NathanHor22/Quipus/output/pcb/Quipus-A1/controller-design.md

# Quipus Rev A — controller, controls, timekeeping, storage and display

Revision A1, 29 September 2026. Engineering review draft, not a fabrication release. The accompanying `controller-circuit.json` is a pin-to-net design specification; it is not an EasyEDA project or a routed PCB. No firmware is changed by this work.

## Decisions

- U1 is **ESP32-S3-WROOM-1-N16R8**, with 16 MB quad flash and 8 MB octal PSRAM. Use this exact ordering code; substitutes need a fresh pin and voltage review.
- Two onboard PDM microphones use I2S0; external PDM input has a separate data line. I2S1 drives the speaker amplifier. Audio front end is defined separately.
- A **Waveshare SKU 15867 1.3inch LCD Module**, 240 × 240 ST7789, is mounted above the controller board and connected through a keyed cable. This is a 45 × 31 mm display-module PCB, not a bare display bonded onto the custom PCB. It is non-touch; LVGL handles the UI in firmware.
- Native 1-bit SDMMC and a Hirose DM3AT-SF-PEJM5 socket provide recording storage. The display uses **SPI2_HOST**; SPI1 is reserved for flash/cache and must not be assigned to the screen.
- Start/Enter connects directly to RTC-capable GPIO7 for standby wake. Stop/Back, Up and Down use a PCA9536 I2C expander. Power, BOOT and RESET remain independent hardware functions.
- RV-3028-C7 keeps calendar time while main system power is off, as long as the protected LiPo remains attached and usable. A separate backup cell is not included.

## Verified ESP32 module pin allocation

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

| Function / net | GPIO | Module pad | Direction / reset consideration |
| --- | ---: | ---: | --- |
| PDM_CLK | 4 | 4 | Clock output; audio sheet owns source damping |
| PDM_DIN0 | 5 | 5 | Two onboard microphones, complementary PDM clock edges |
| PDM_DIN1 | 6 | 6 | External short-wire PDM daughterboard input |
| I2S1_BCLK | 14 | 22 | Speaker bit clock |
| I2S1_WS | 15 | 8 | Speaker frame clock |
| I2S1_DOUT | 16 | 9 | Speaker audio output |
| AMP_ENABLE | 17 | 10 | Audio sheet must hold amplifier disabled at reset |
| LCD_CS_N | 10 | 18 | 10 kΩ pull-up; deselect display during boot |
| LCD_MOSI_MCU | 11 | 19 | Through 33 Ω to LCD_MOSI |
| LCD_SCLK_MCU | 12 | 20 | Through 33 Ω to LCD_SCLK |
| LCD_BL | 13 | 21 | Backlight control only; module has its own transistor |
| LCD_DC | 43 | 37 | Also ROM UART0 TX; safe only because CS is pulled high |
| LCD_RST_N | 44 | 36 | 10 kΩ pull-up; firmware performs reset pulse |
| SD_CLK_MCU | 38 | 31 | Through 22 Ω to card CLK |
| SD_CMD | 39 | 32 | Bidirectional, 10 kΩ pull-up |
| SD_D0 | 40 | 33 | Bidirectional, 10 kΩ pull-up |
| SD_CD_N | 41 | 34 | Detect switch to ground; 100 kΩ pull-up |
| I2C_SDA | 8 | 12 | Fuel gauge, RTC and button expander; pull-ups on power sheet |
| I2C_SCL | 9 | 17 | Start at 100 kHz; validate bus rise time |
| PWR_INT_N | 18 | 11 | LTC2951 shutdown request input |
| POWER_HOLD | 21 | 23 | Open-drain; LOW only after file flush; pull-up on power sheet |
| CHARGING_N | 47 | 24 | Charger open-drain status; pull-up on power sheet |
| USB_PGOOD_N | 48 | 25 | Charger input-valid status; not itself charging current |
| USB_ENUM_500 | 1 | 39 | Active-high authorization after USB enumeration; default low |
| USB_SUSPEND | 2 | 38 | Active-high suspend signal; default low, per power design |
| ESP_USB_DM | 19 | 13 | Native USB D− after isolation and series resistor |
| ESP_USB_DP | 20 | 14 | Native USB D+ after isolation and series resistor |
| BOOT_N | 0 | 27 | 10 kΩ pull-up, service switch to ground |
| ESP_EN | EN | 3 | 10 kΩ / 1 µF RC, service RESET switch to ground |
| BTN_START_N | 7 | 7 | Direct active-low Start/Enter and RTC-domain wake input |
| Spare, unconnected | 42 | 35 | Reserved for prototype changes |

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

Budget: 36 exposed GPIO − 3 PSRAM-reserved − 4 straps − 2 native USB = 27 available general GPIO. This design uses 26 and retains GPIO42. UART0 pads are occupied by the display; use native USB Serial/JTAG for ordinary service. Optional UART probing on LCD_DC is read-only, and the screen must remain deselected. Do not claim a separate unrestricted UART header.

## USB and reset

USB connector D+/D− nets enter a TPD2EUSB30DRTR clamp array immediately beside the connector, then TS3USB221ARSER, then 22 Ω series resistors close to the ESP32. Keep the pair short over continuous ground with differential impedance designed using the fabricator's stackup. DNP shunt-capacitor pads are for measured tuning only.

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

## Display connector: a reversal that matters

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

## SD socket

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

## Offline timekeeping

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

## Buttons and shared I2C

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

The bus addresses are distinct: RTC 0x52, expander 0x41, fuel gauge 0x55. The power sheet owns one pair of 10 kΩ bus pull-ups to 3V3 plus off-state discharge resistors; do not populate a duplicate set here. Begin at 100 kHz and measure SCL/SDA rise time with the actual total capacitance. Do not enable 400 kHz simply because all chips list it as a maximum.

## Outstanding before fabrication

1. Cross-check every symbol and footprint against the exact package drawing, particularly module pad 41, USB switch RSE, microSD detector A/B and display J2 orientation.
2. Complete whole-board electrical rules and power-domain review, including powered-off I2C/USB behavior and discharge timing.
3. Reconcile the display's measured current, real SD write peaks and Wi-Fi current with the regulator's peak and thermal margins.
4. Confirm mechanical button heights, screen connector cable bend, SD ejection path, microphone acoustic openings and ESP antenna keepout.
5. Run a first-article test: native USB boot, all buttons, RTC continuity through power-off, microSD recoverability, full audio capture, Wi-Fi upload, charging and safe shutdown.

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

## Primary references

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
