NathanHor22/Quipus/output/pcb/Quipus-A1-EasyEDA/native-review/pcb-bottom-final.png

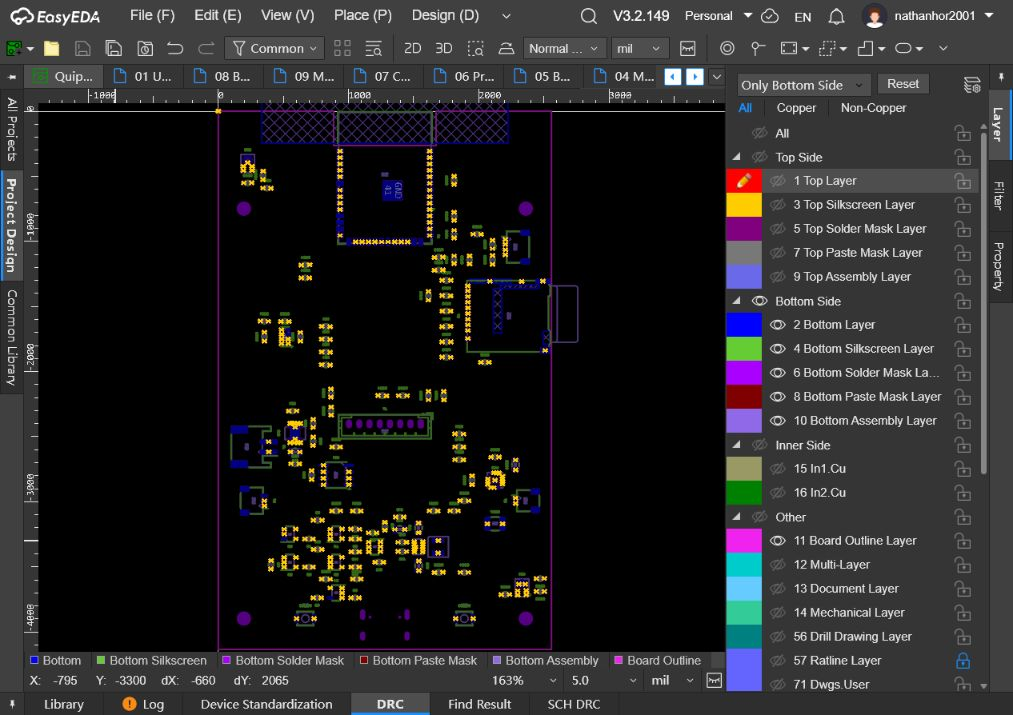
output/pcb/Quipus-A1-EasyEDA/native-review/pcb-bottom-final.png
