NathanHor22/Quipus/output/pcb/Quipus-A1-EasyEDA/placement-preview.png

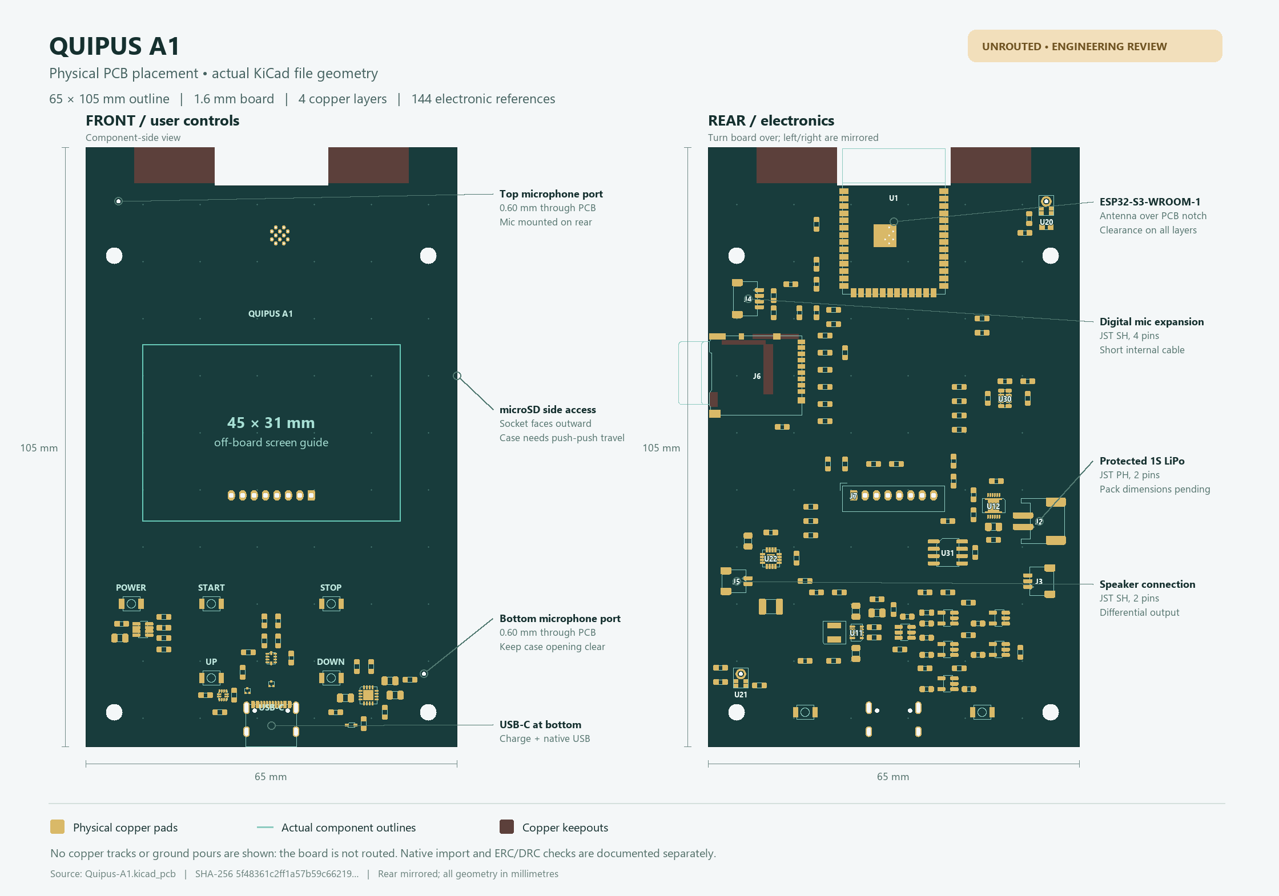
output/pcb/Quipus-A1-EasyEDA/placement-preview.png
