NathanHor22/Quipus/output/pcb/Quipus-A1/contact-sheet.png

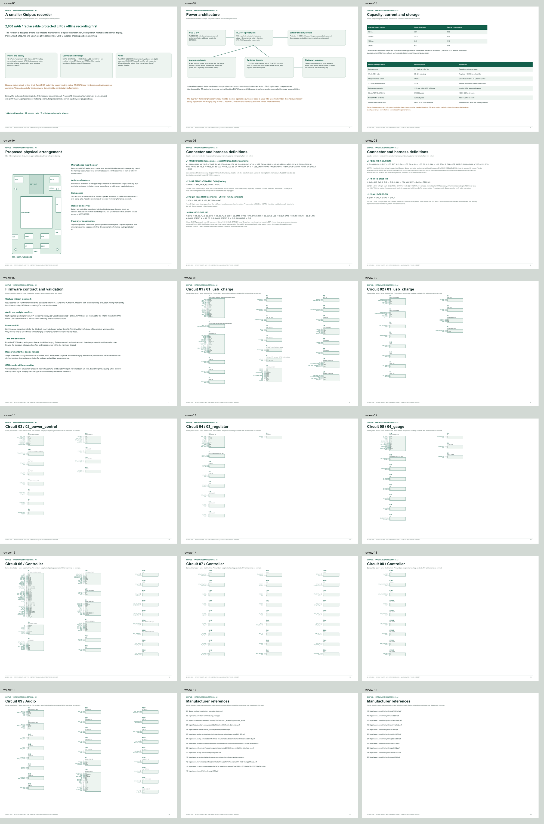
output/pcb/Quipus-A1/contact-sheet.png
