NathanHor22/Quipus/output/pcb/Quipus-A1/review-01.png

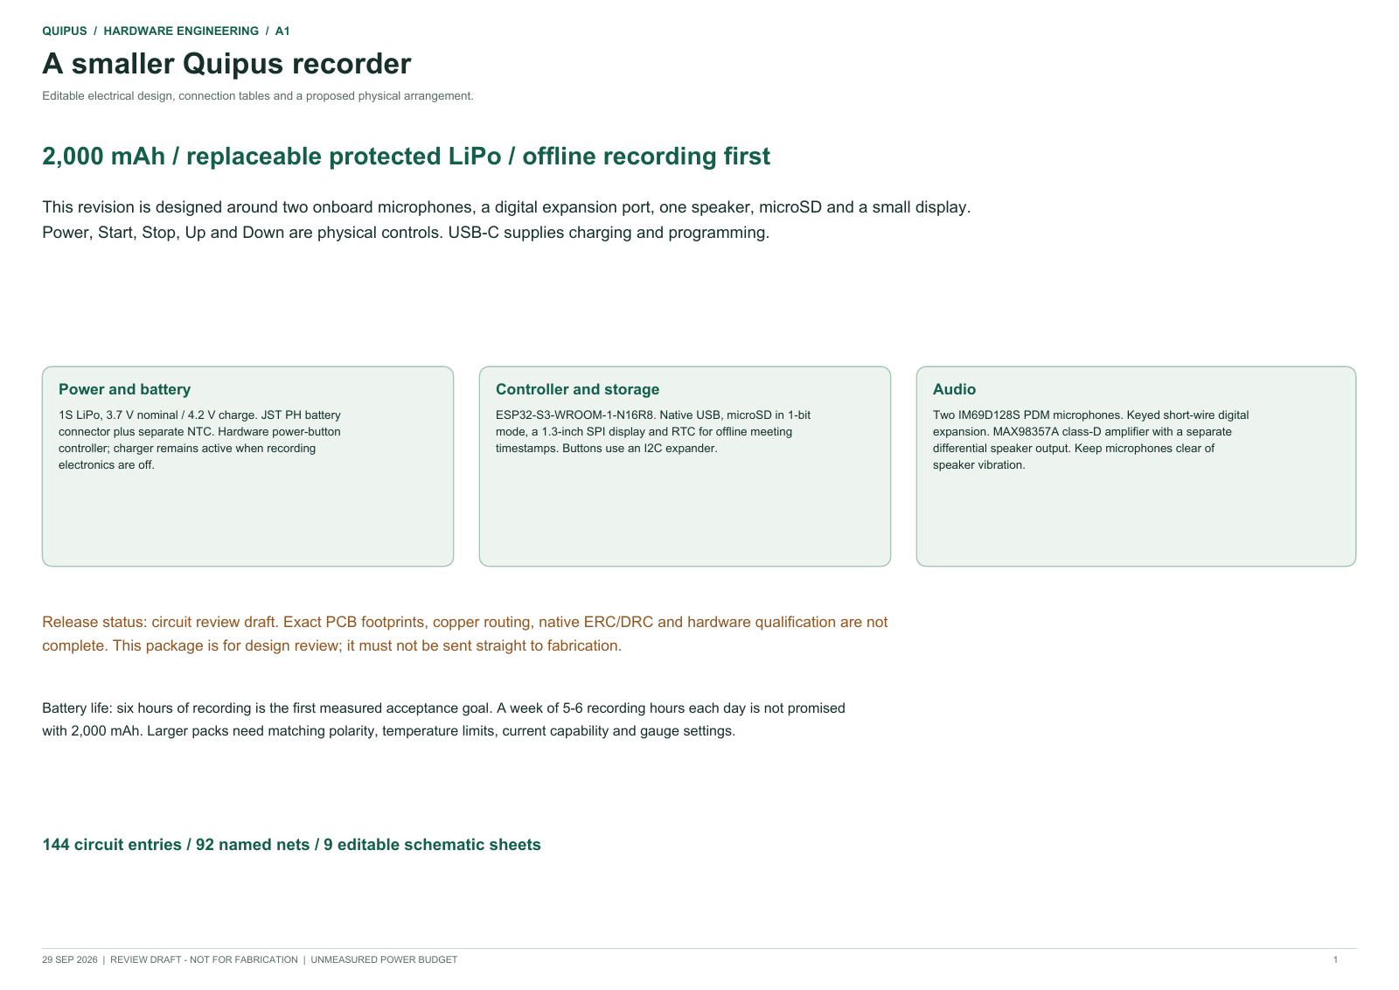
output/pcb/Quipus-A1/review-01.png
