NathanHor22/Quipus/output/pcb/Quipus-A1/review-02.png

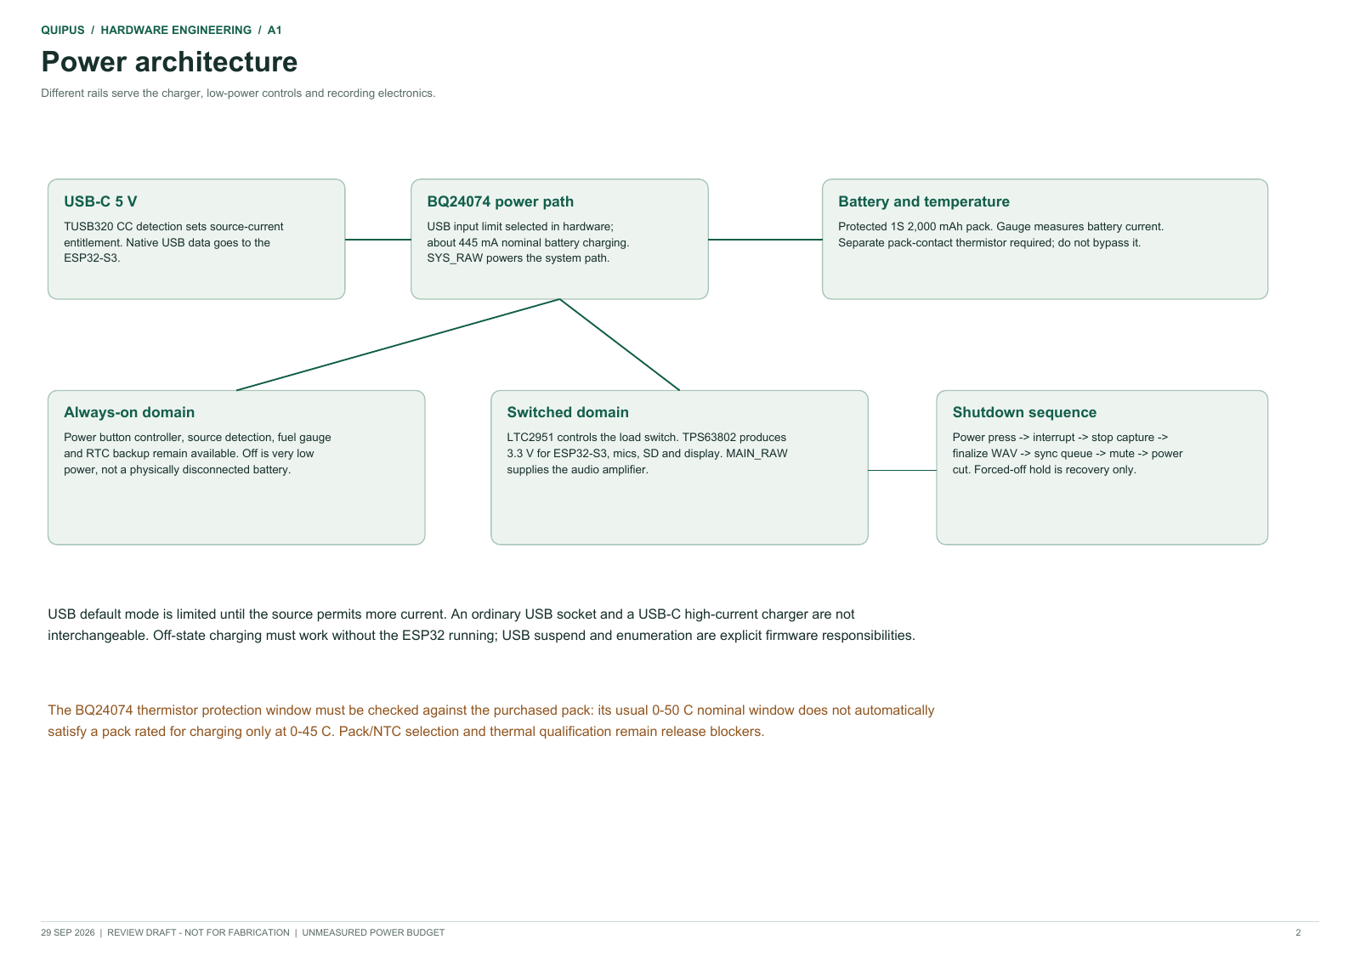
output/pcb/Quipus-A1/review-02.png
