NathanHor22/Quipus/output/pcb/Quipus-A1/review-03.png

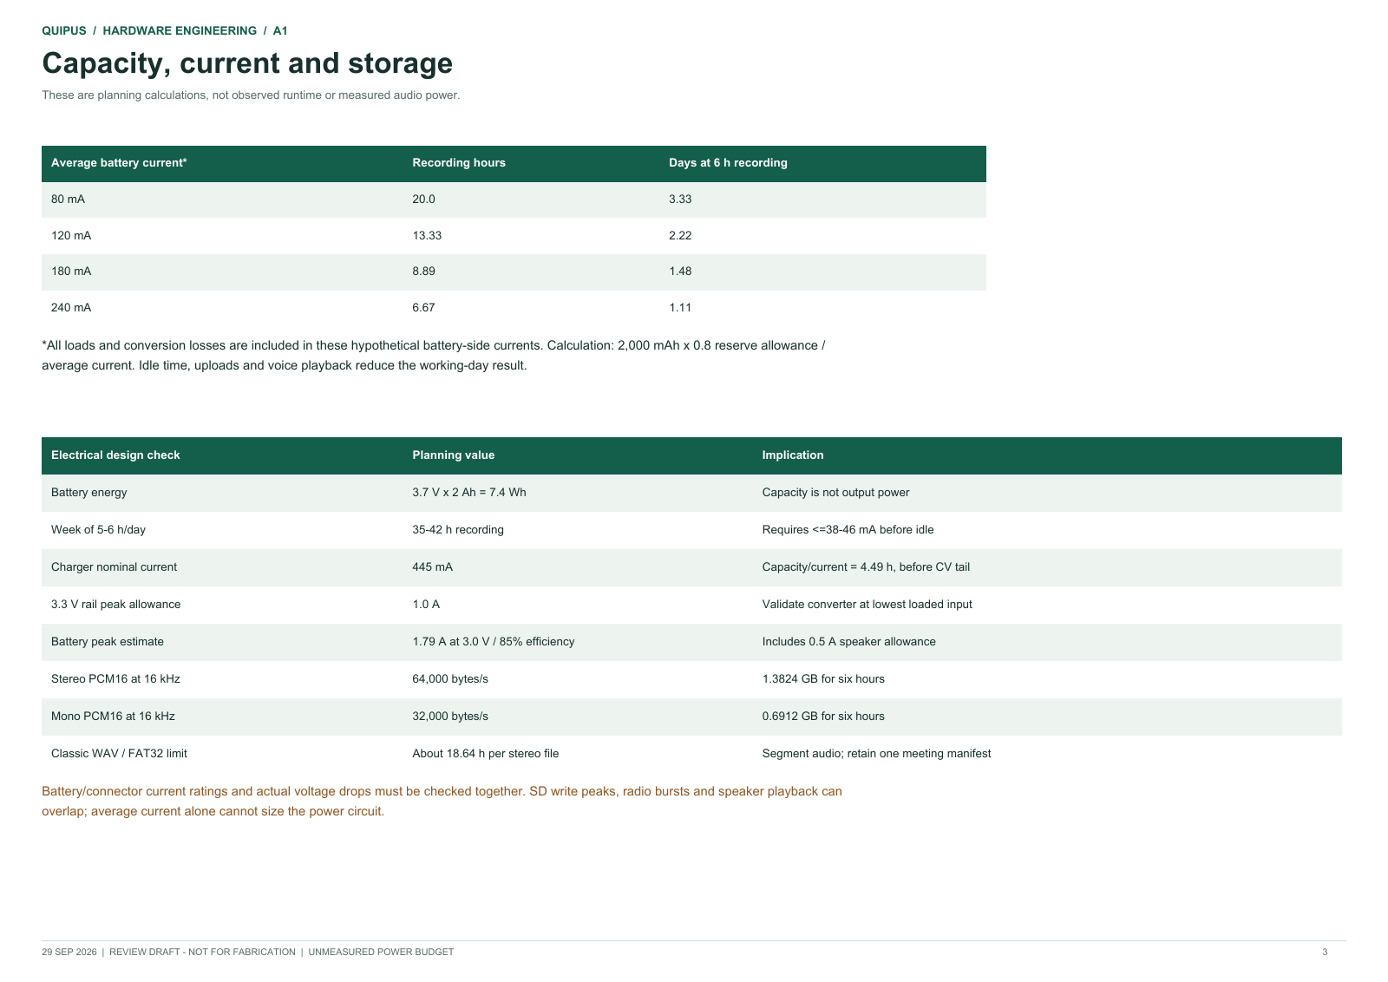
output/pcb/Quipus-A1/review-03.png
