NathanHor22/Quipus/output/pcb/Quipus-A1/review-04.png

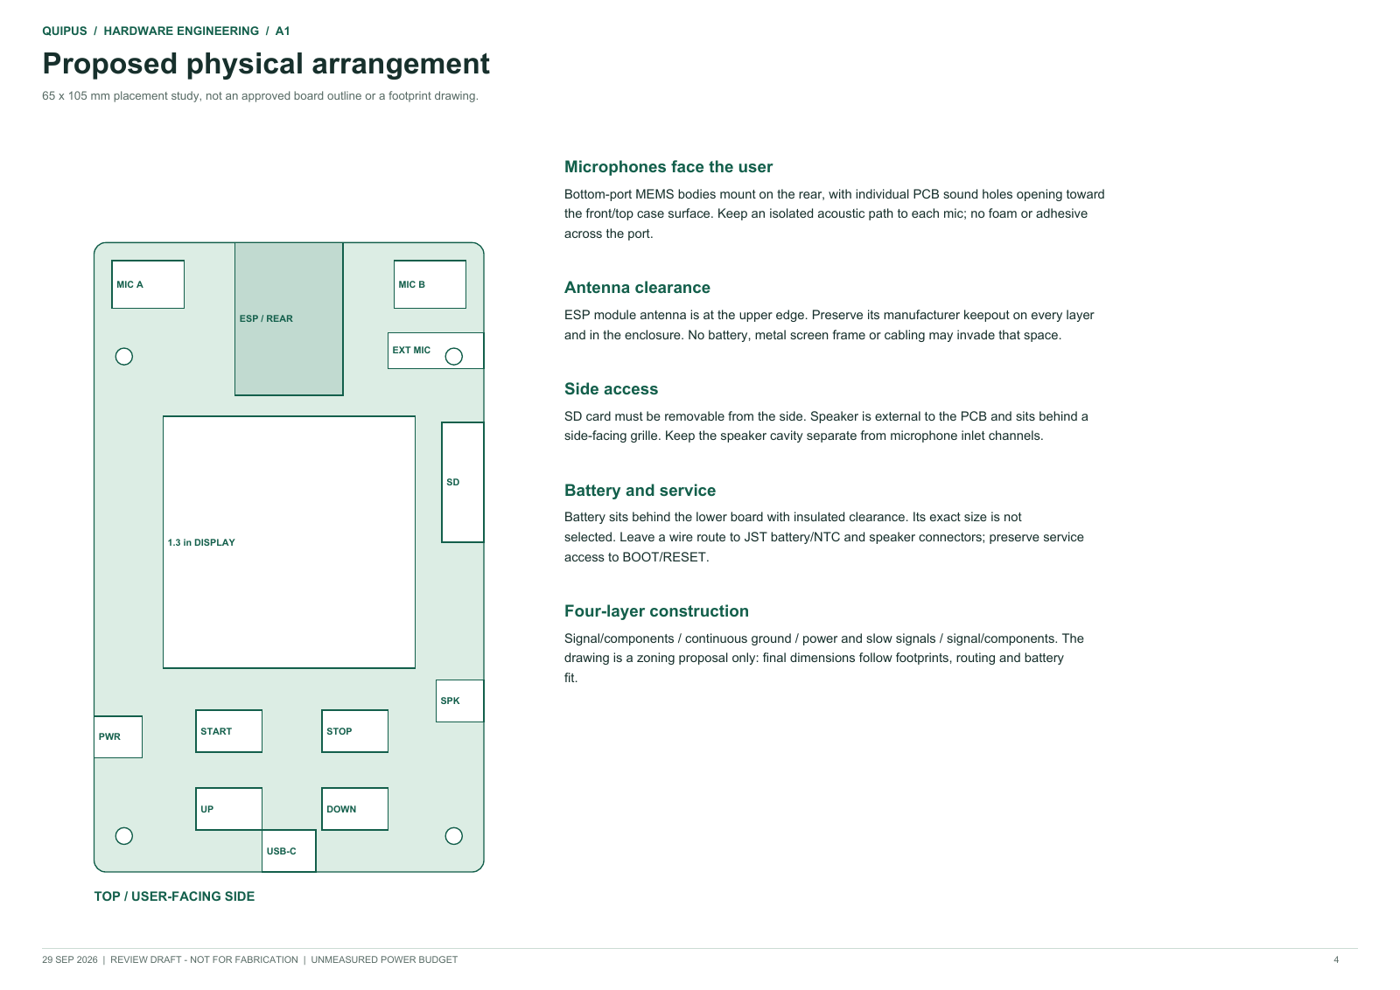
output/pcb/Quipus-A1/review-04.png
