NathanHor22/Quipus/output/pcb/Quipus-A1/review-05.png

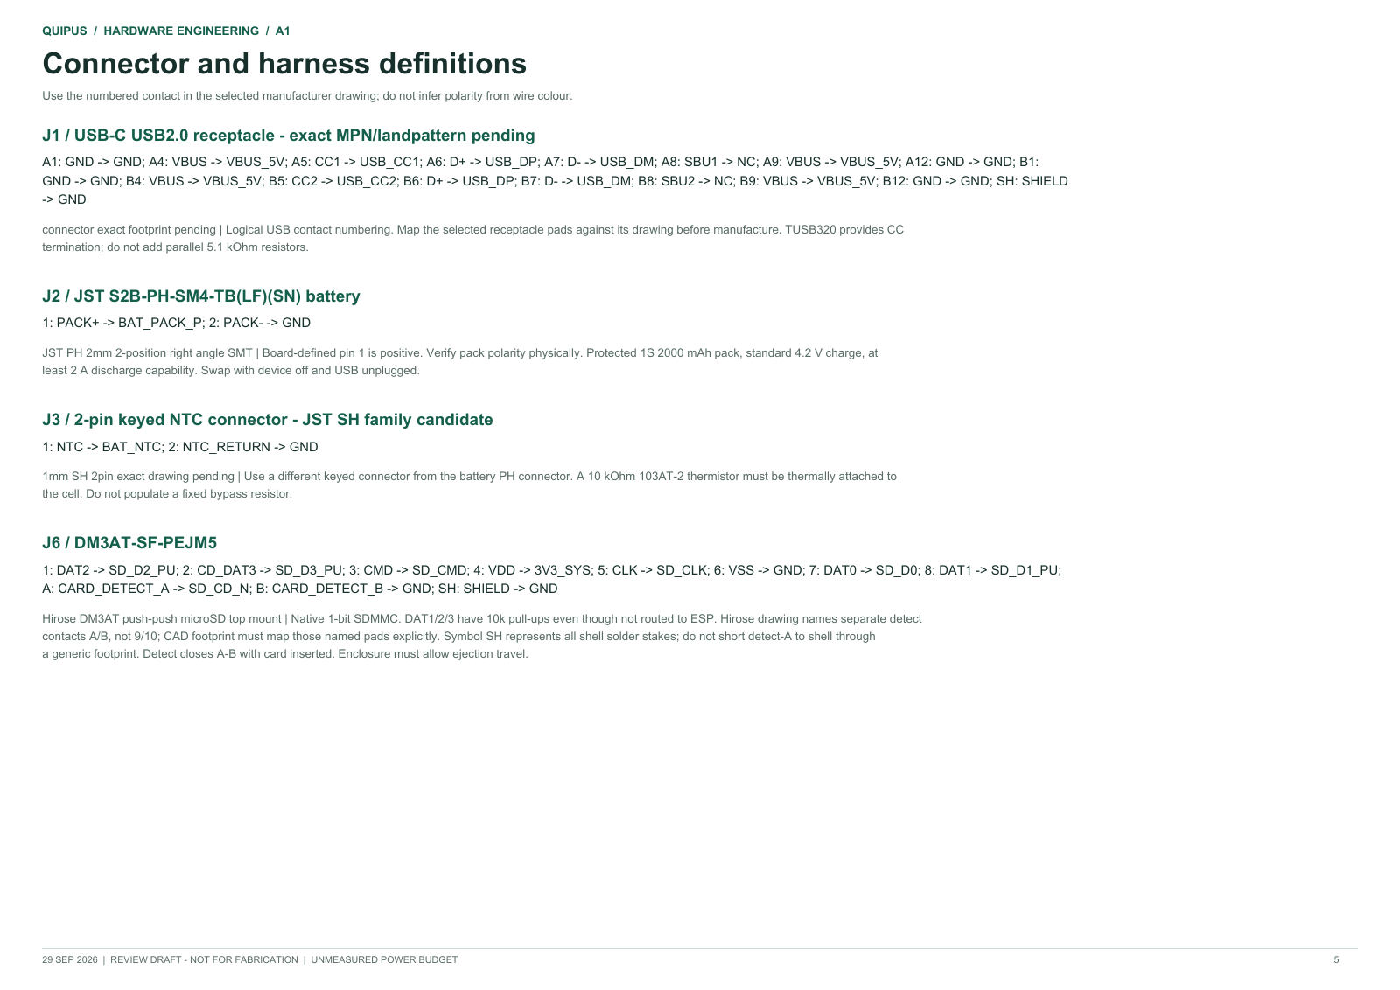
output/pcb/Quipus-A1/review-05.png
