NathanHor22/Quipus/output/pcb/Quipus-A1/review-06.png

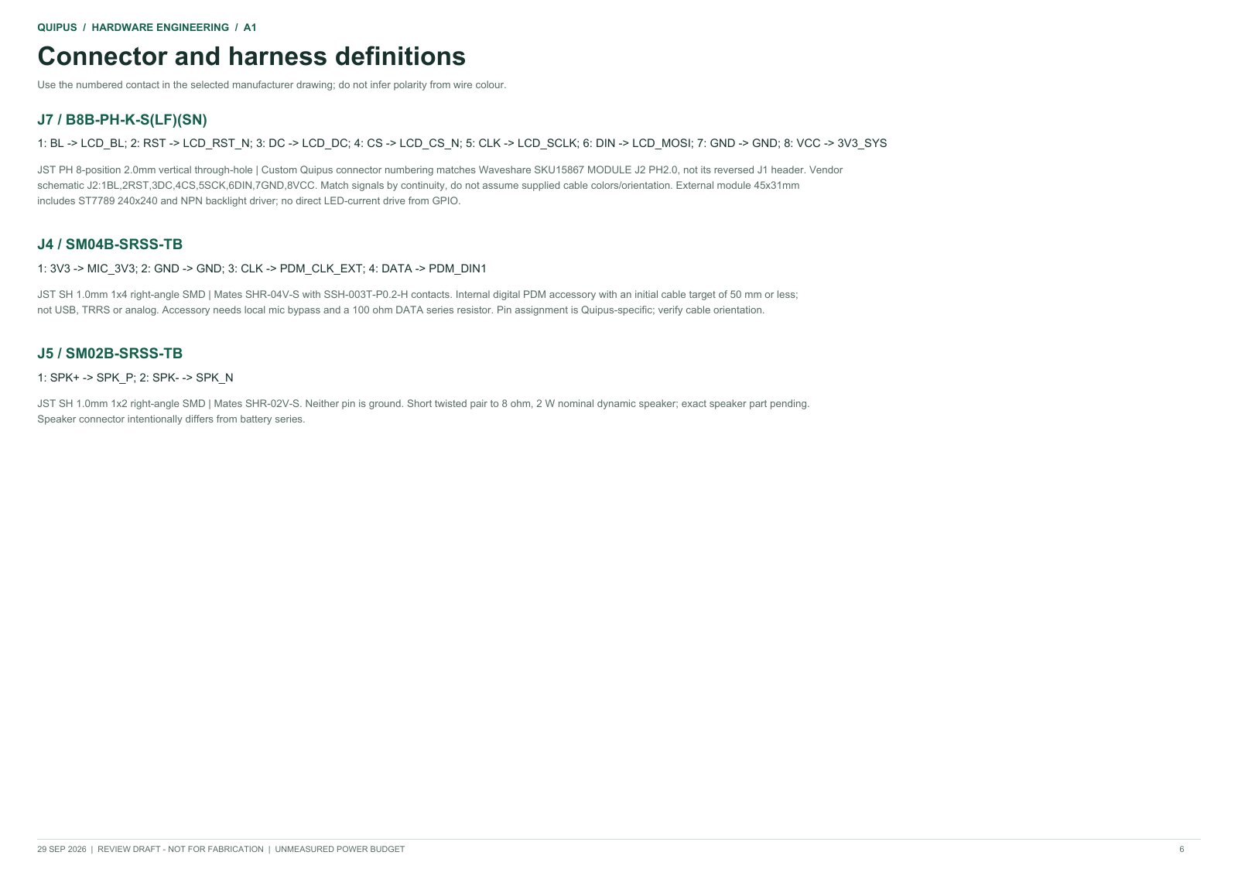
output/pcb/Quipus-A1/review-06.png
