NathanHor22/Quipus/output/pcb/Quipus-A1/review-07.png

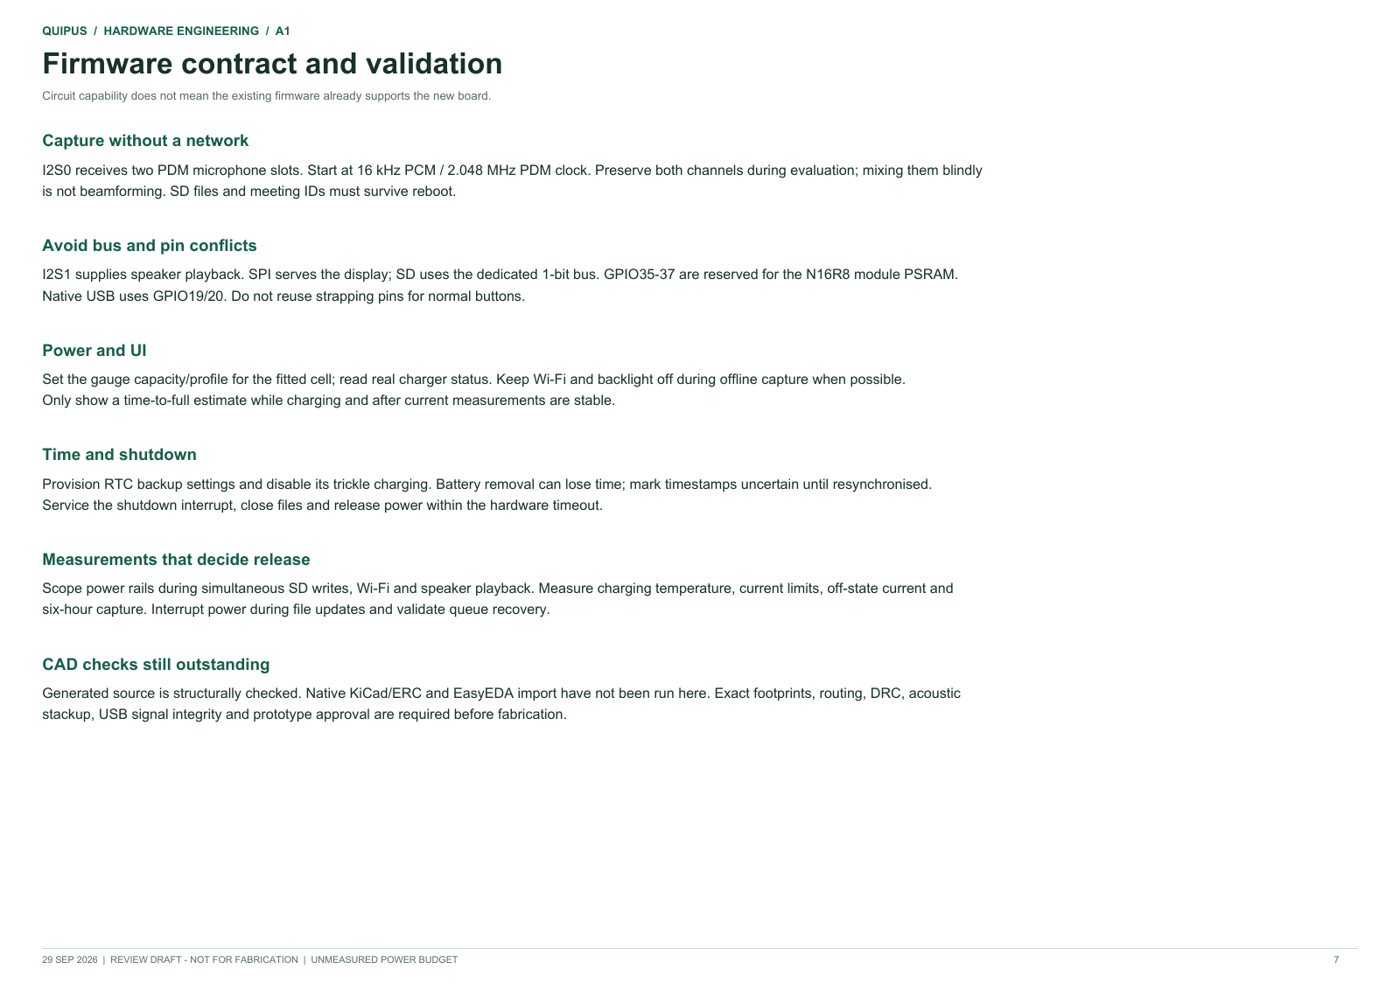
output/pcb/Quipus-A1/review-07.png
