NathanHor22/Quipus/output/pcb/Quipus-A1/review-08.png

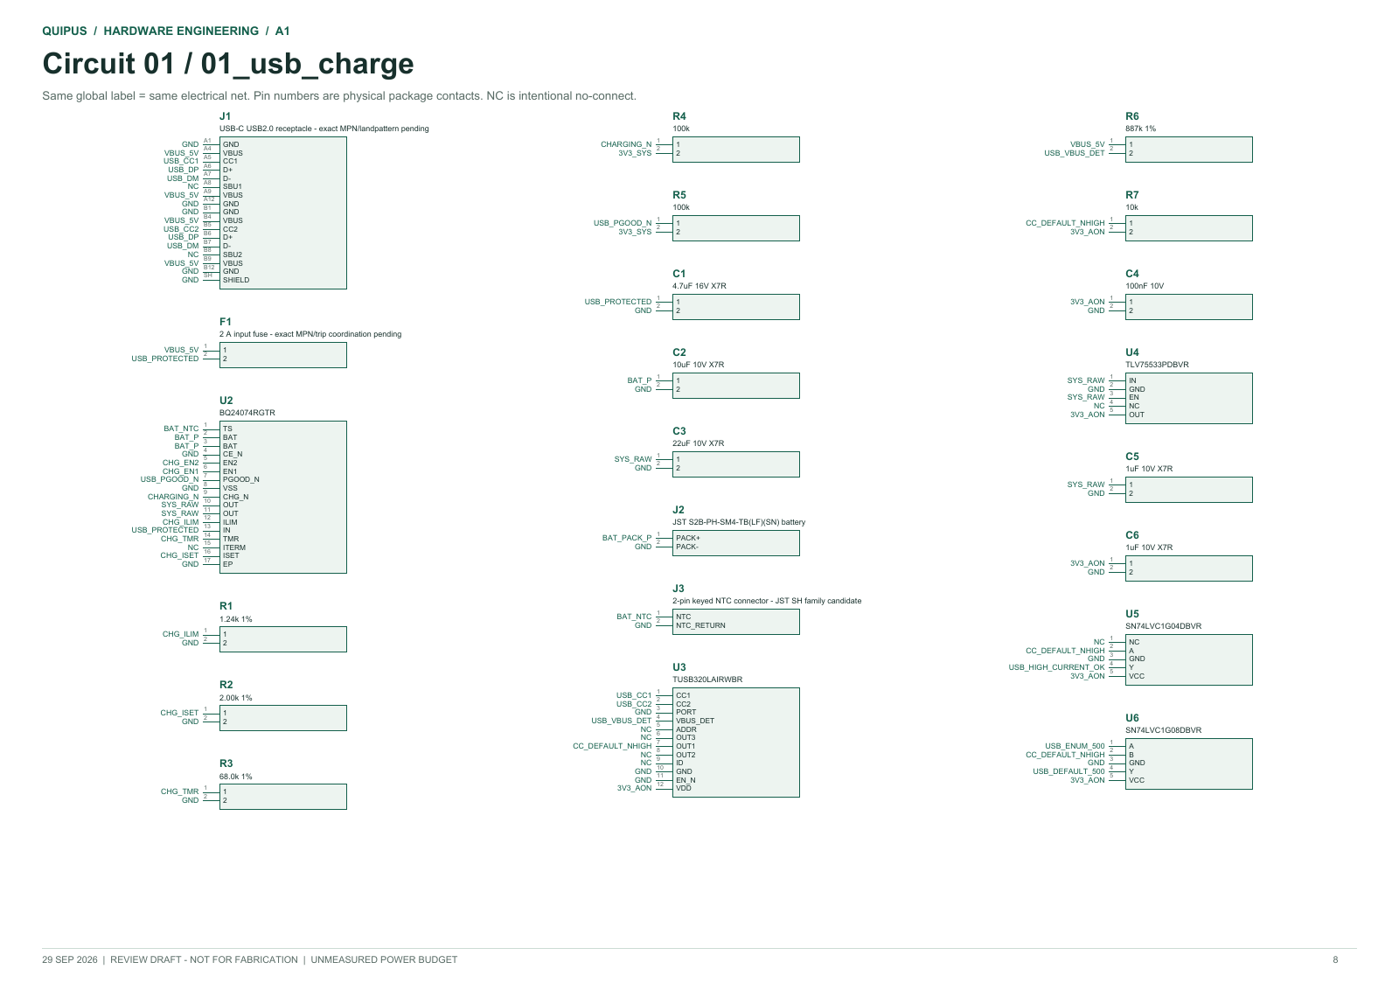
output/pcb/Quipus-A1/review-08.png
