NathanHor22/Quipus/output/pcb/Quipus-A1/review-09.png

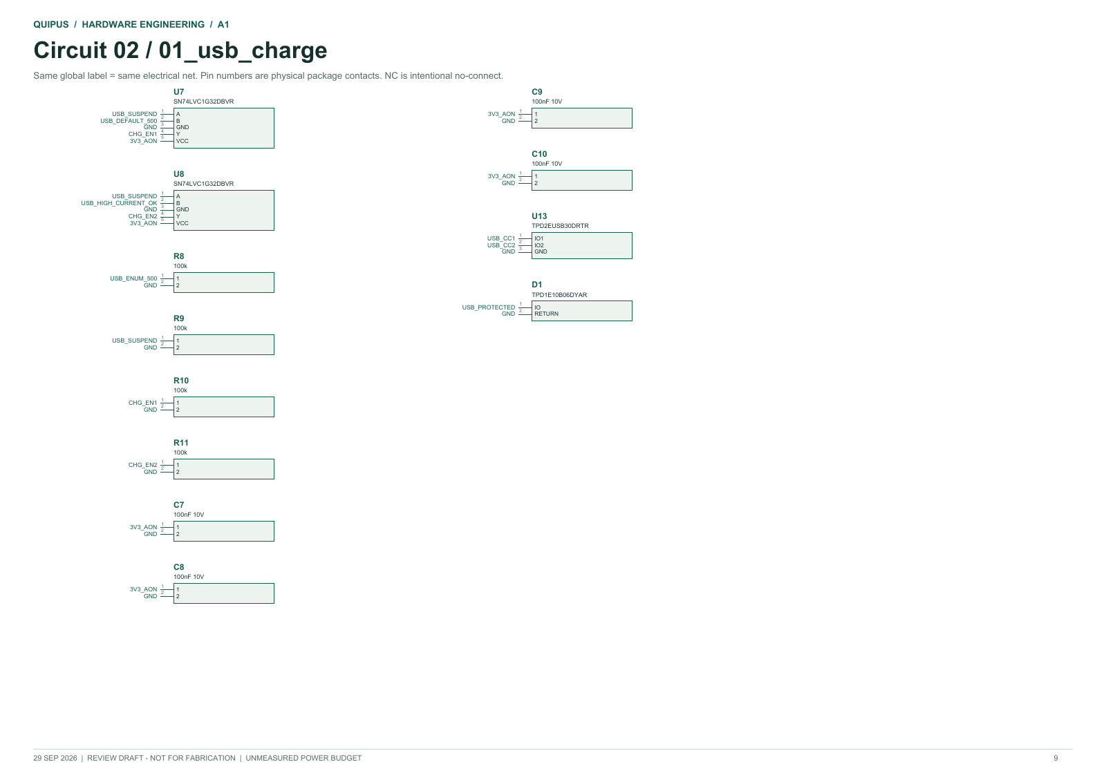
output/pcb/Quipus-A1/review-09.png
