NathanHor22/Quipus/output/pcb/Quipus-A1/review-11.png

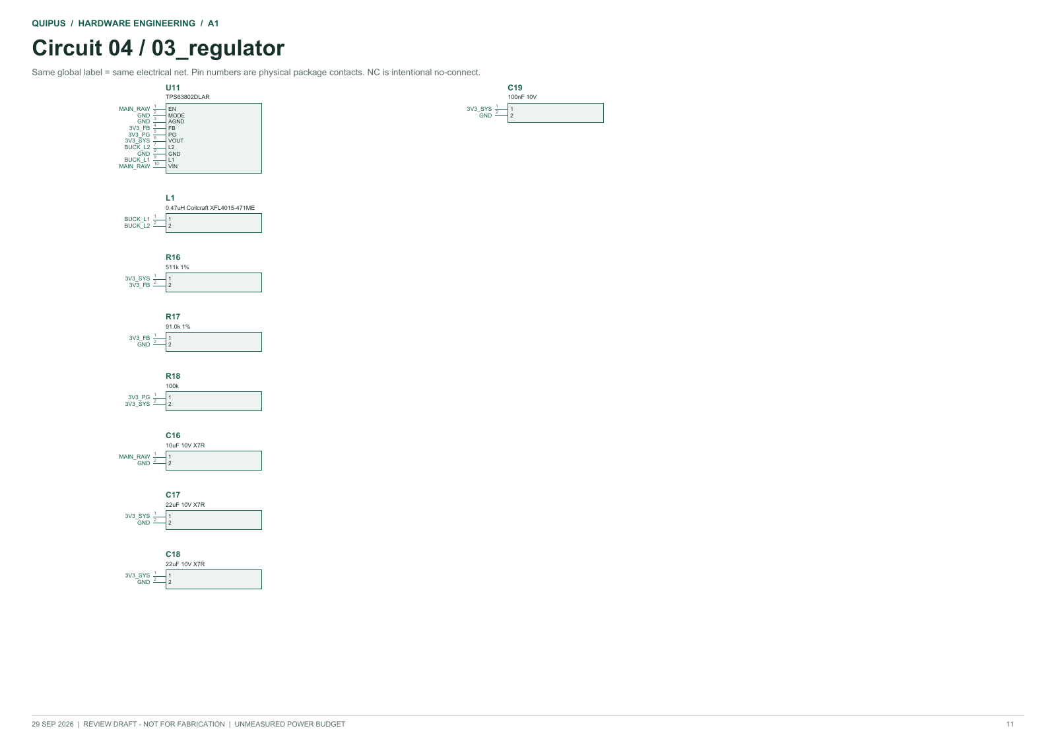
output/pcb/Quipus-A1/review-11.png
