NathanHor22/Quipus/output/pcb/Quipus-A1/review-14.png

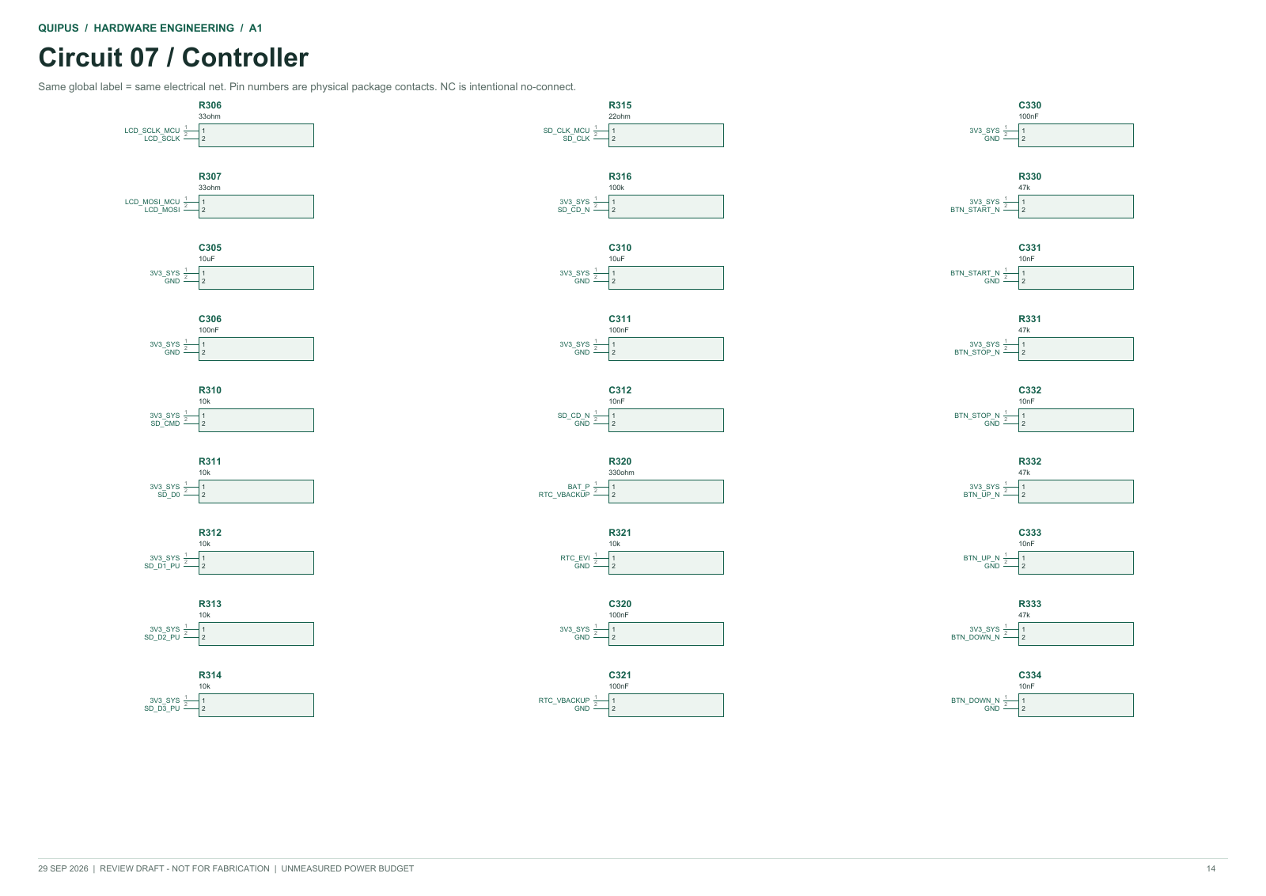
output/pcb/Quipus-A1/review-14.png
