NathanHor22/Quipus/output/pcb/Quipus-A1/review-16.png

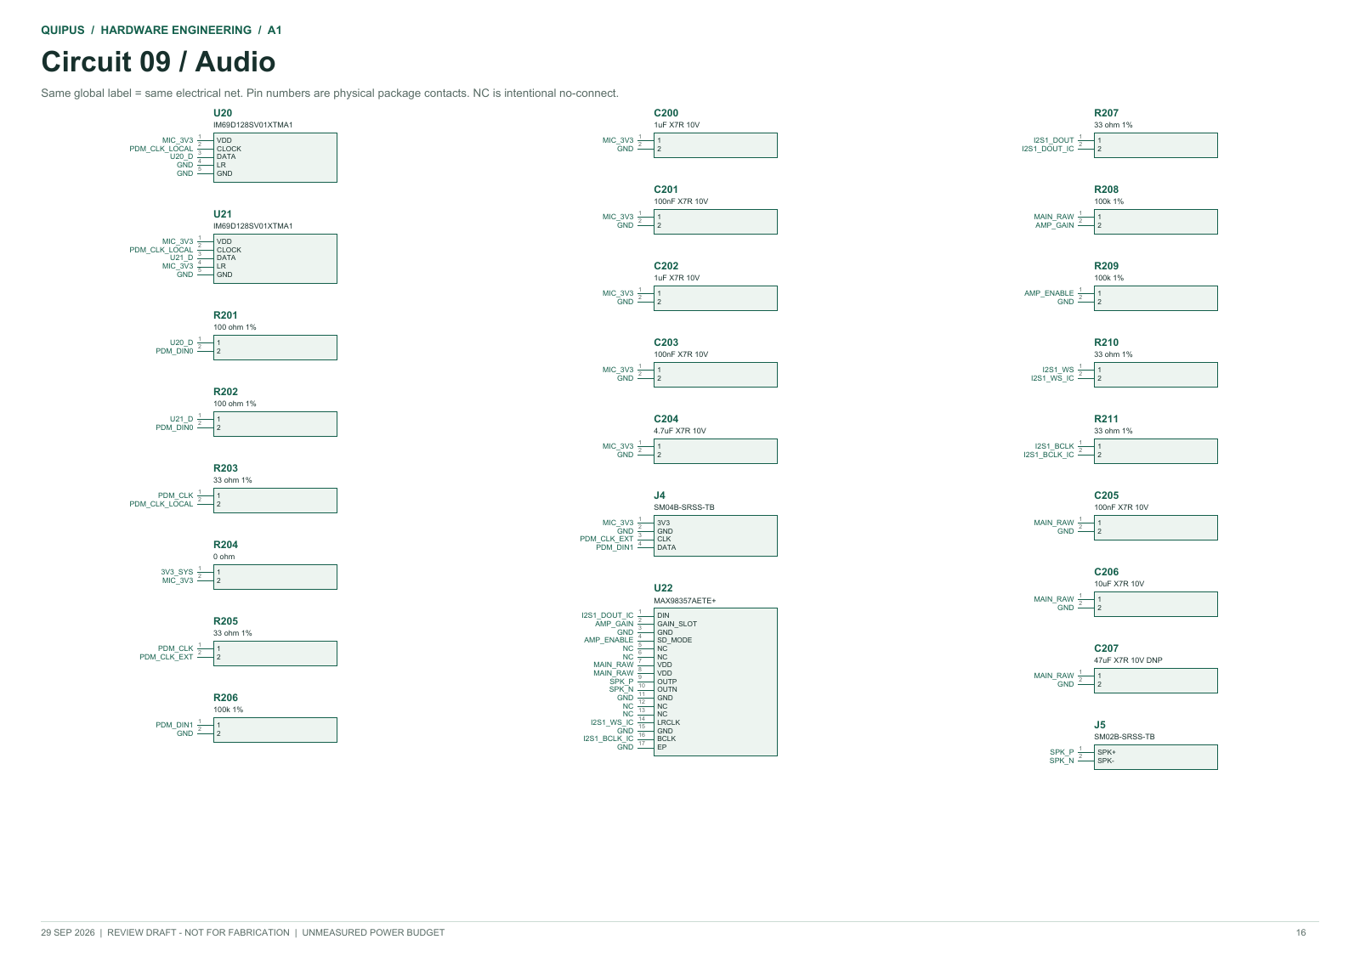
output/pcb/Quipus-A1/review-16.png
