NathanHor22/Quipus/output/pcb/Quipus-A1/review-17.png

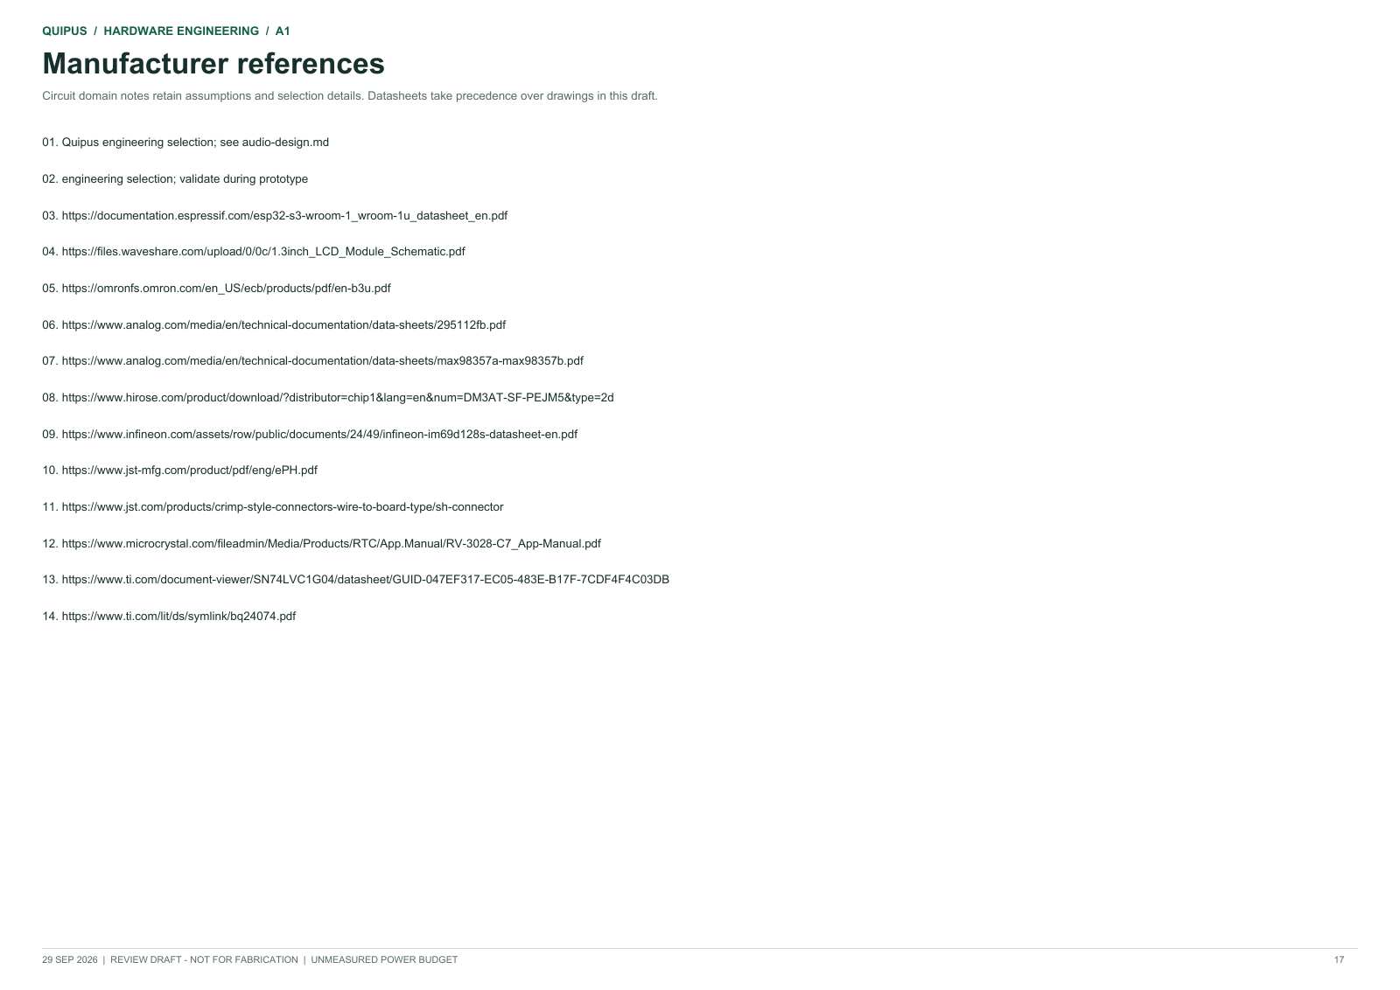
output/pcb/Quipus-A1/review-17.png
