NathanHor22/Quipus/output/pcb/Quipus-A1/review-18.png

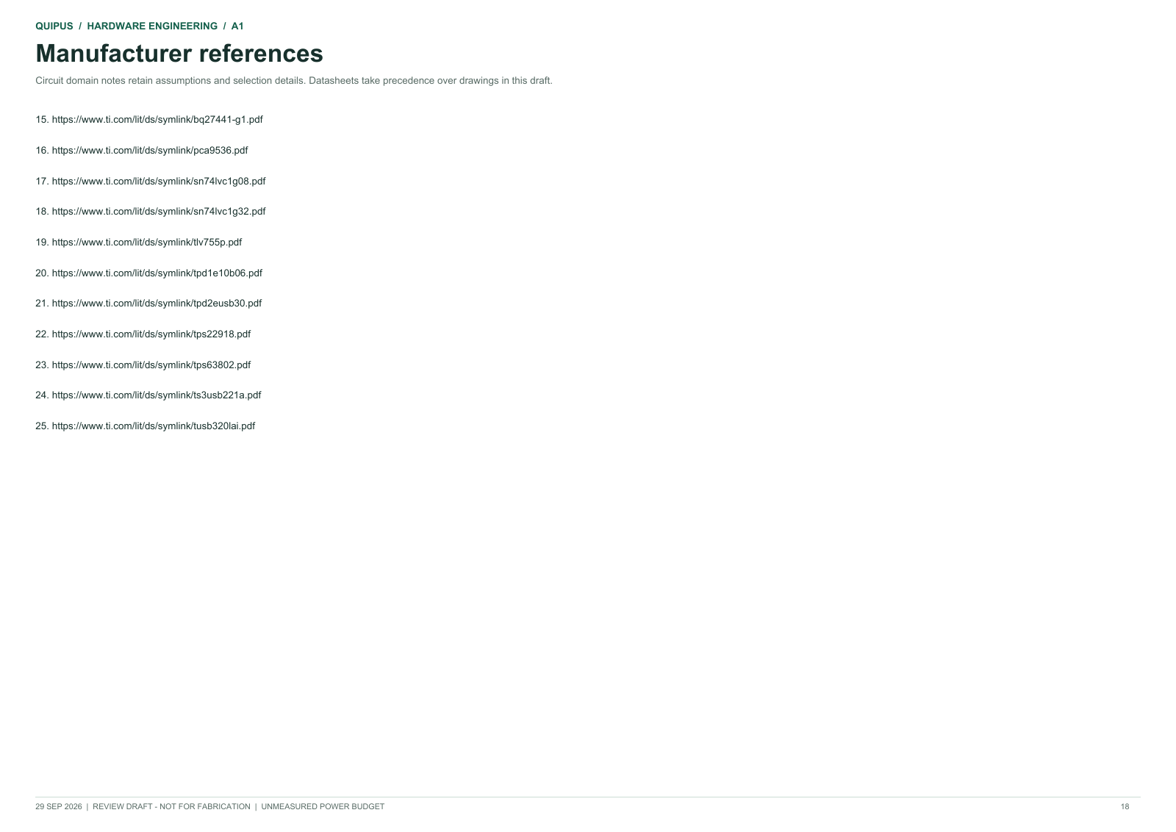
output/pcb/Quipus-A1/review-18.png
