NathanHor22/Quipus/output/pcb/Quipus-B1-EasyEDA/easyeda-board-final.png

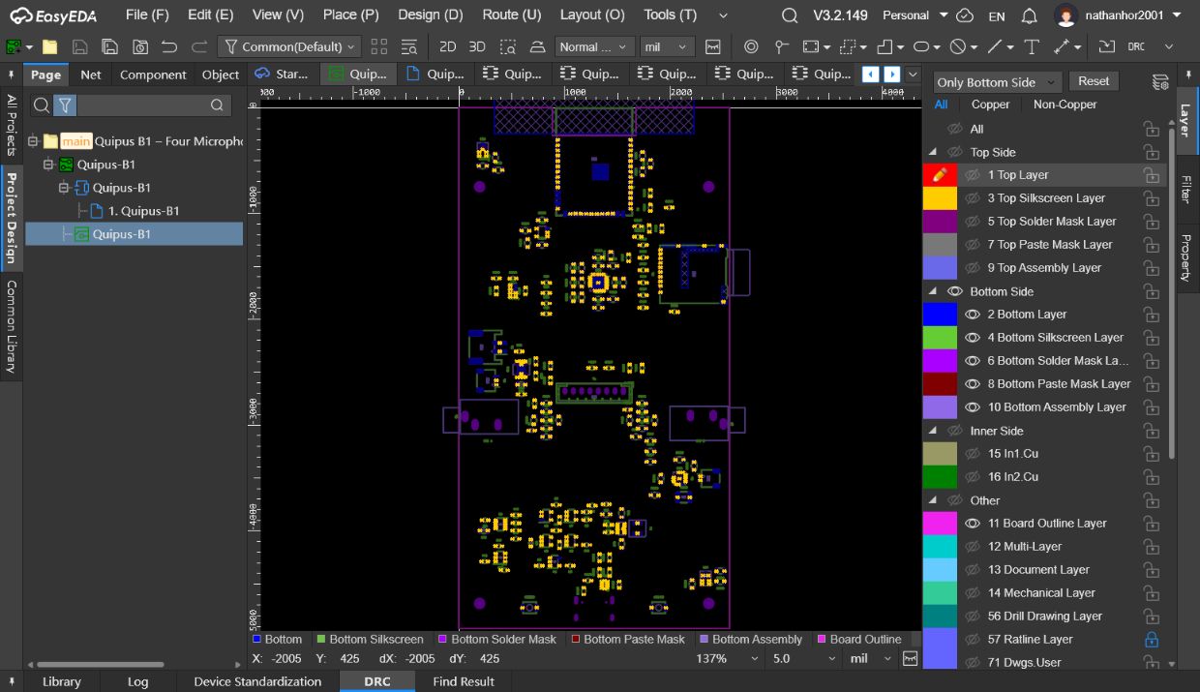
output/pcb/Quipus-B1-EasyEDA/easyeda-board-final.png
