NathanHor22/Quipus/output/ui-review/calendar-desktop.png

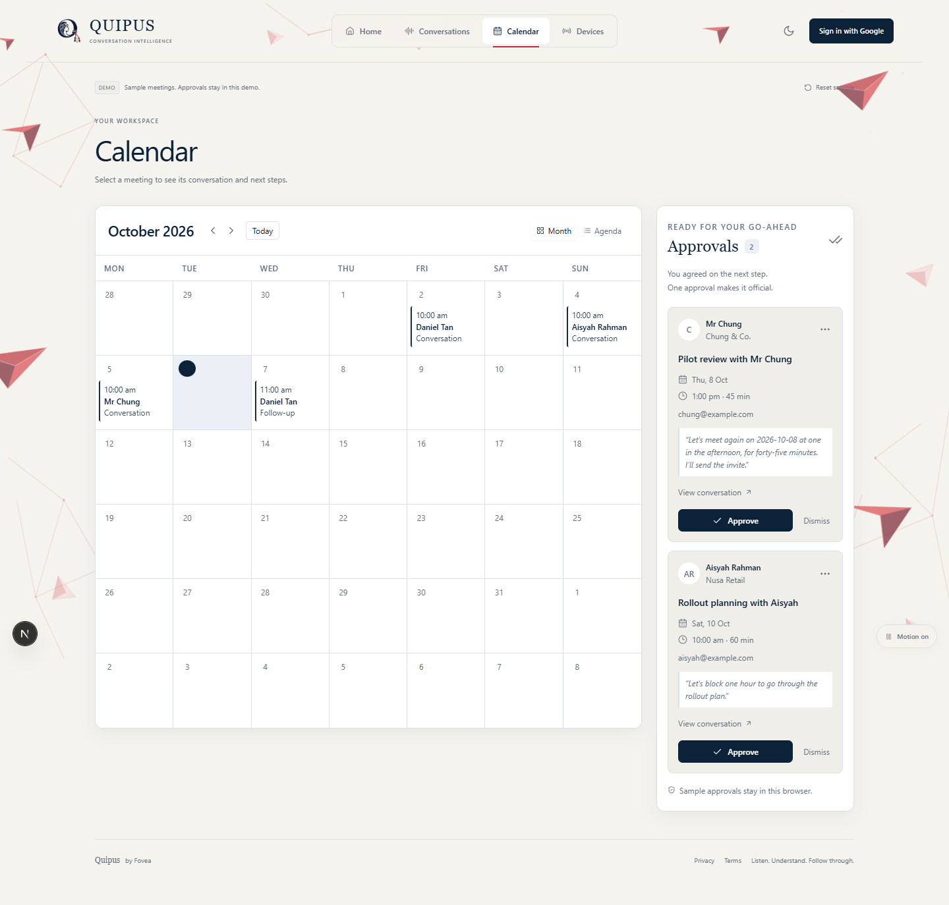
output/ui-review/calendar-desktop.png
