NathanHor22/Quipus/output/ui-review/conversation-desktop.png

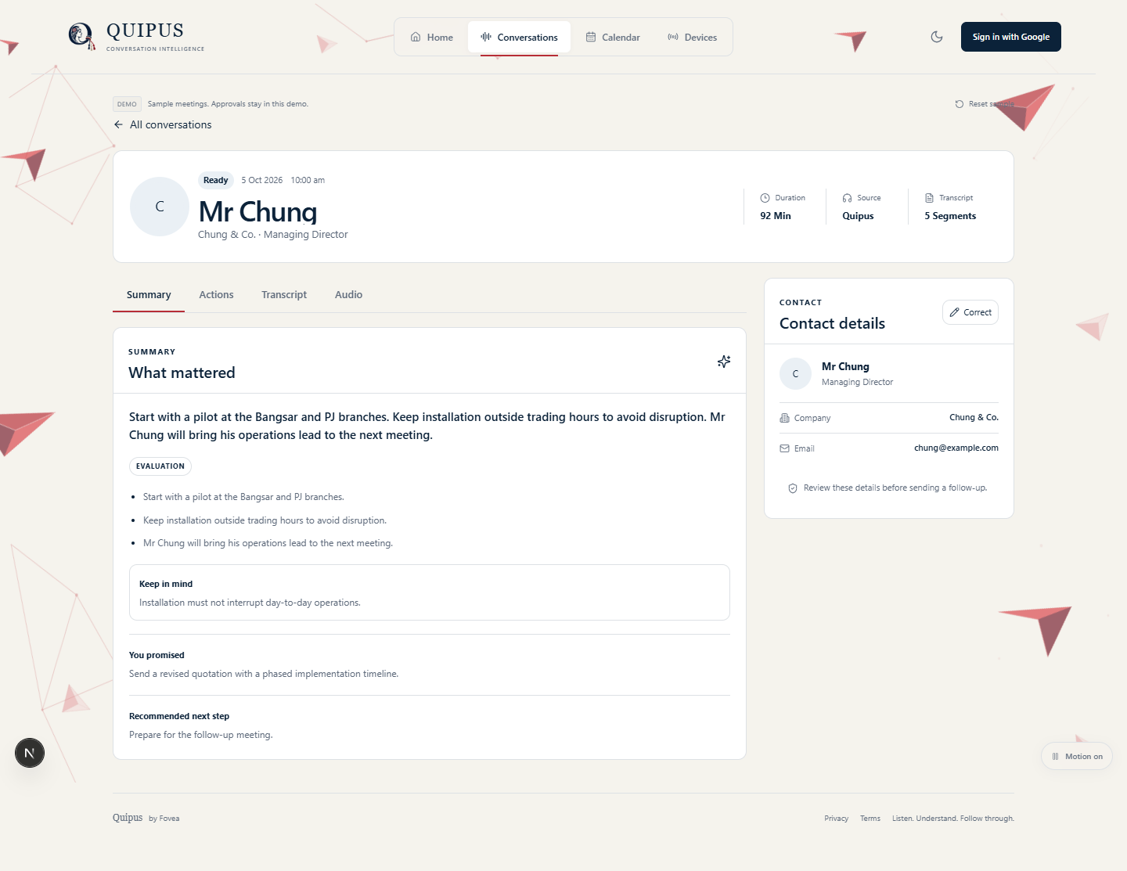
output/ui-review/conversation-desktop.png
