NathanHor22/Quipus/output/ui-review/detail-actions-desktop.png

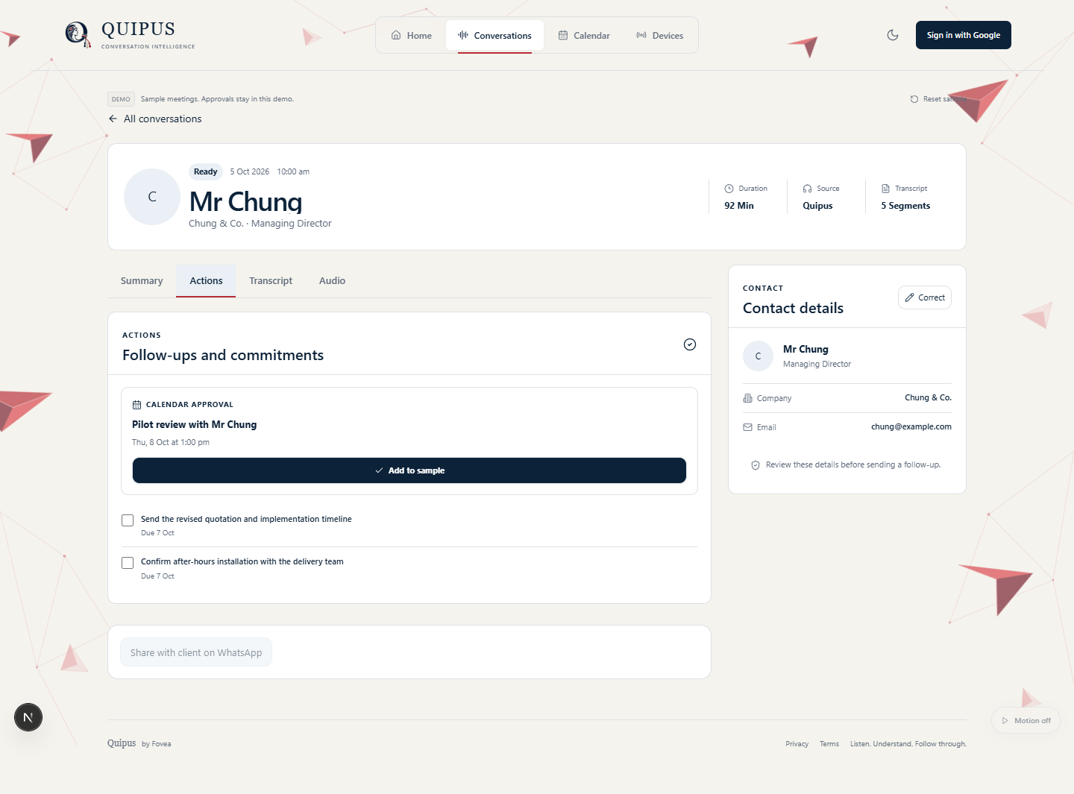
output/ui-review/detail-actions-desktop.png
