NathanHor22/Quipus/output/ui-review/detail-actions-mobile.png

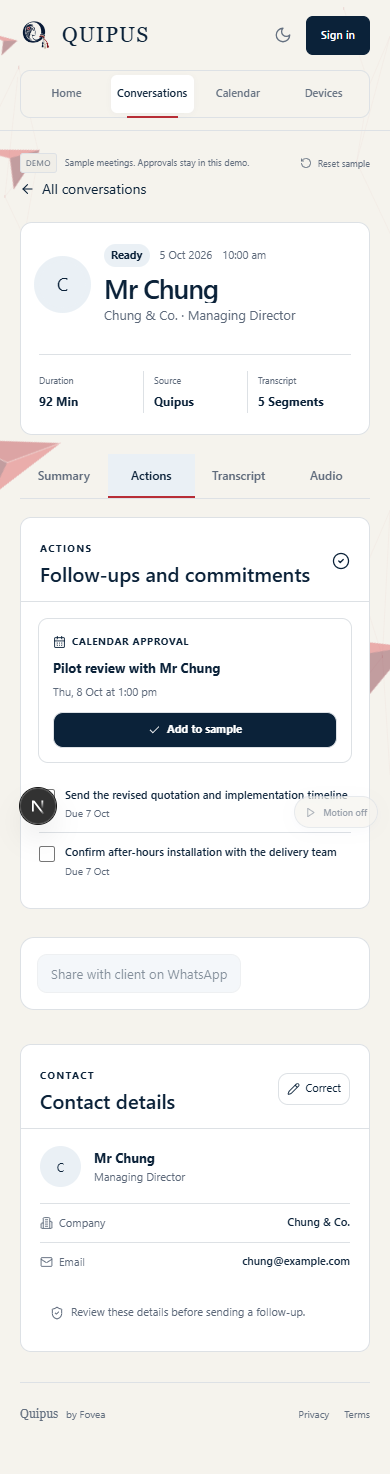
output/ui-review/detail-actions-mobile.png
