NathanHor22/Quipus/output/ui-review/detail-audio-desktop.png

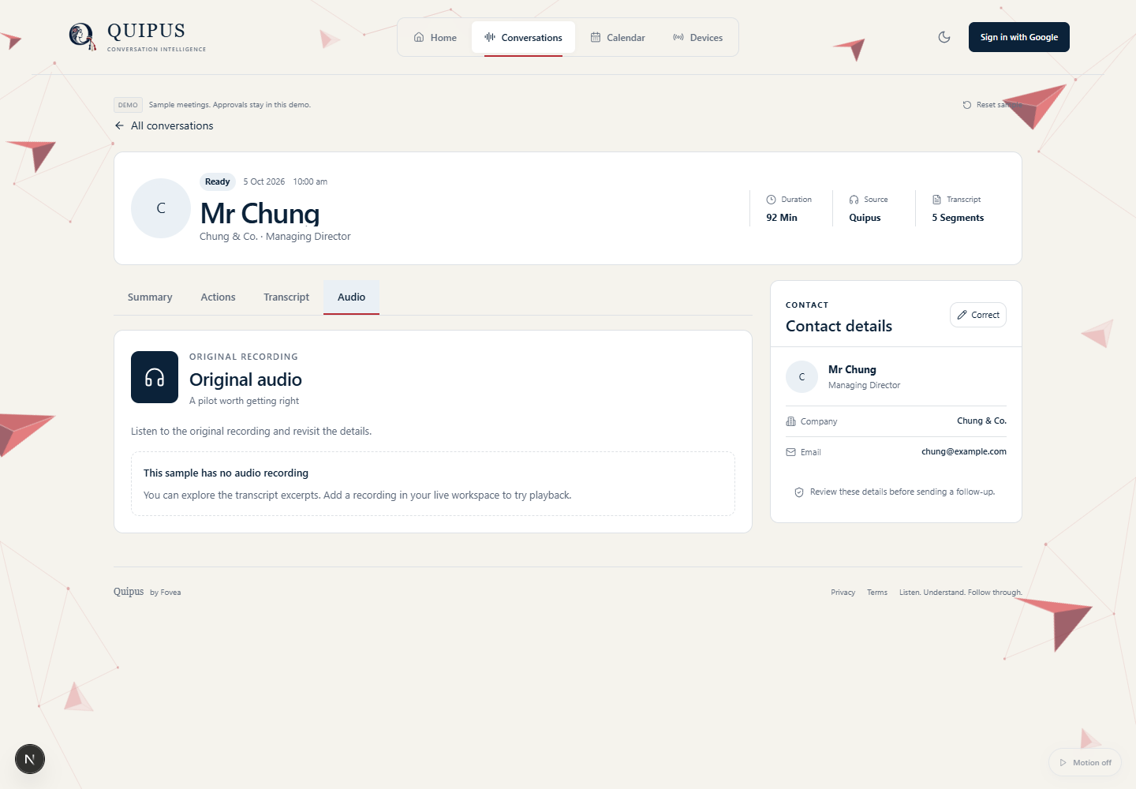
output/ui-review/detail-audio-desktop.png
