NathanHor22/Quipus/output/ui-review/detail-audio-mobile.png

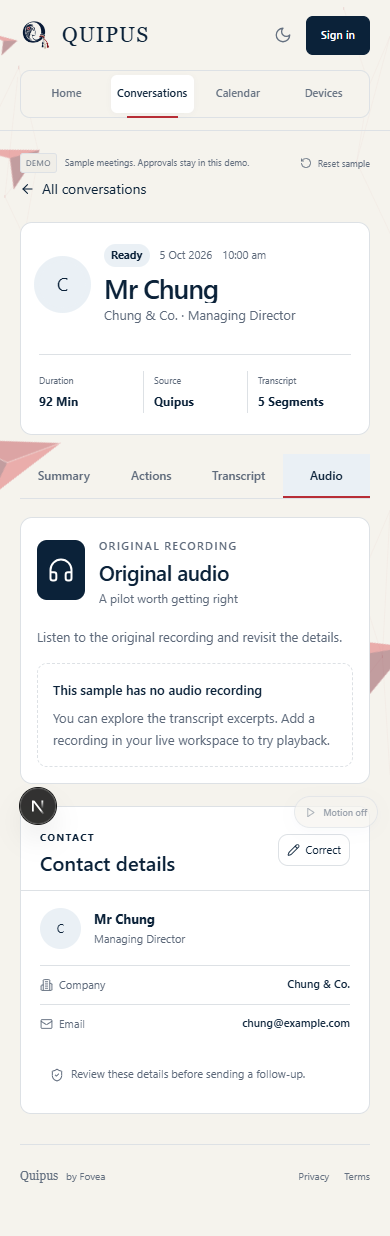
output/ui-review/detail-audio-mobile.png
