NathanHor22/Quipus/output/ui-review/detail-local-fixture-audio.png

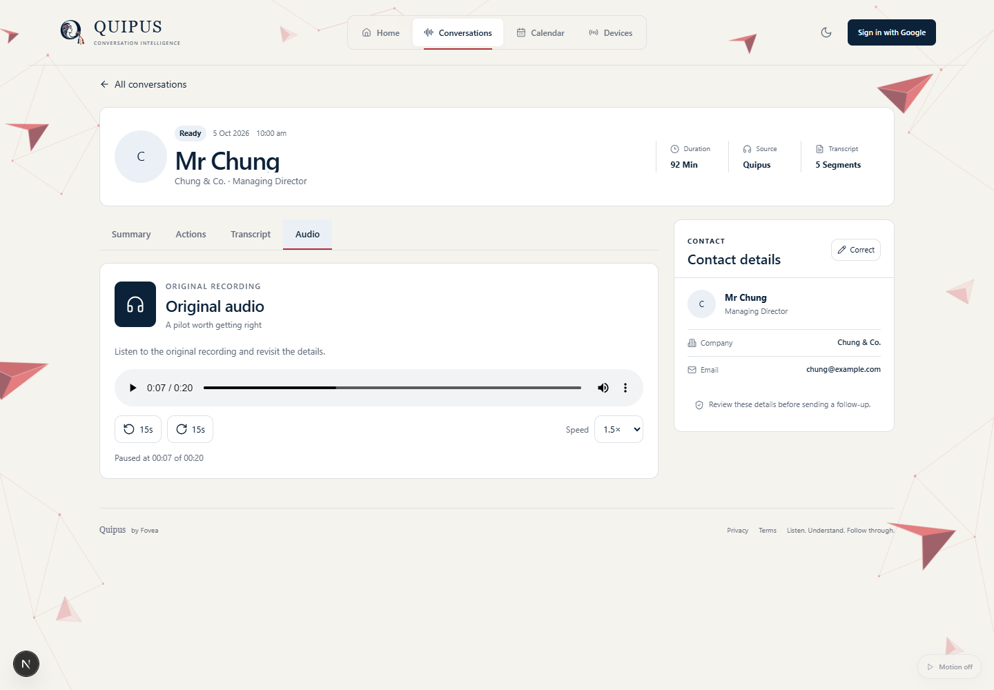
output/ui-review/detail-local-fixture-audio.png
