NathanHor22/Quipus/output/ui-review/detail-local-fixture-transcript.png

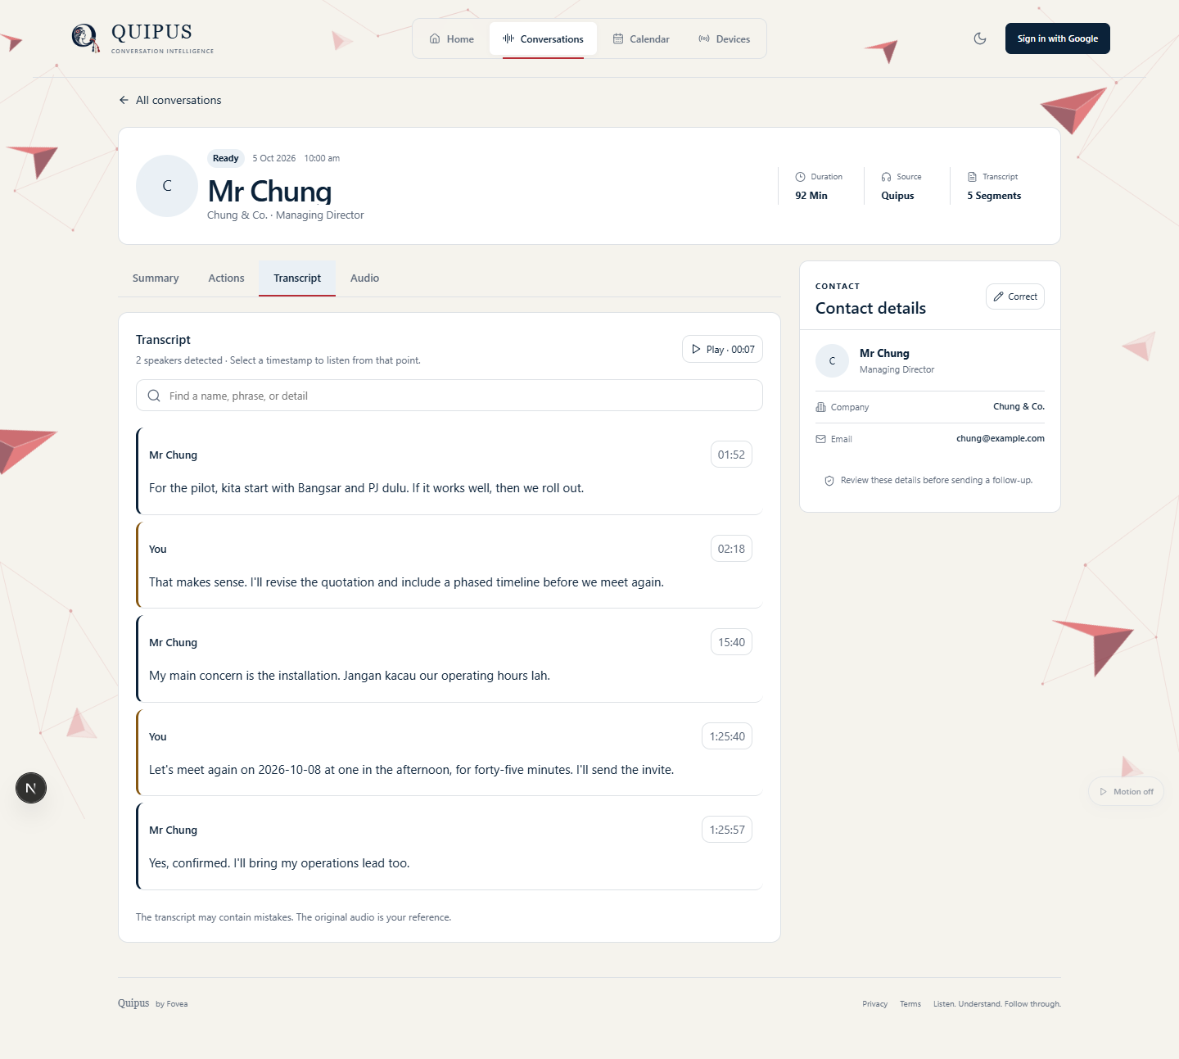
output/ui-review/detail-local-fixture-transcript.png
