NathanHor22/Quipus/output/ui-review/detail-summary-mobile.png

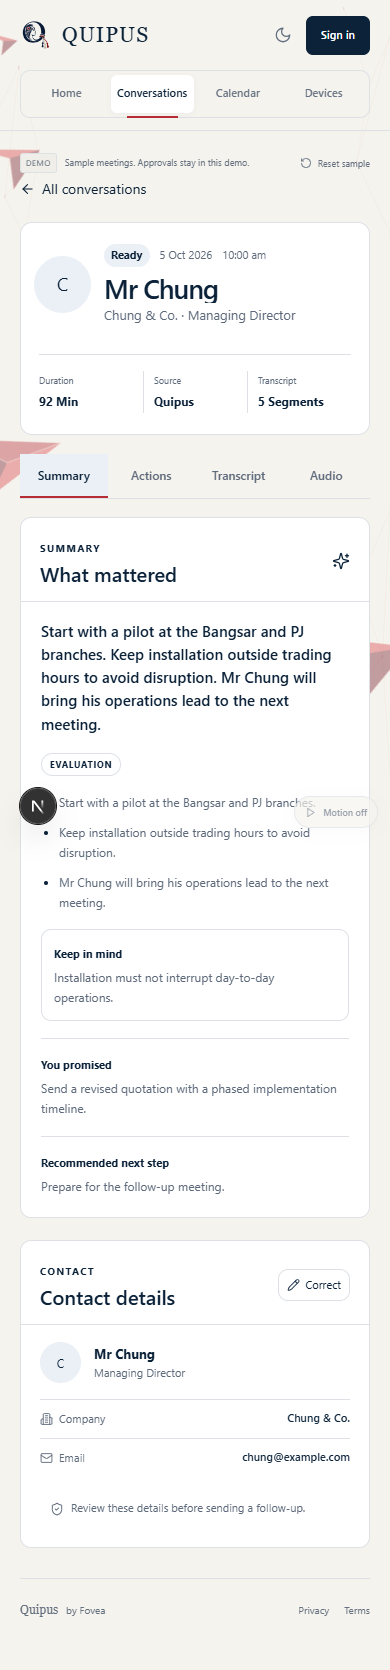
output/ui-review/detail-summary-mobile.png
