NathanHor22/Quipus/output/ui-review/detail-transcript-mobile.png

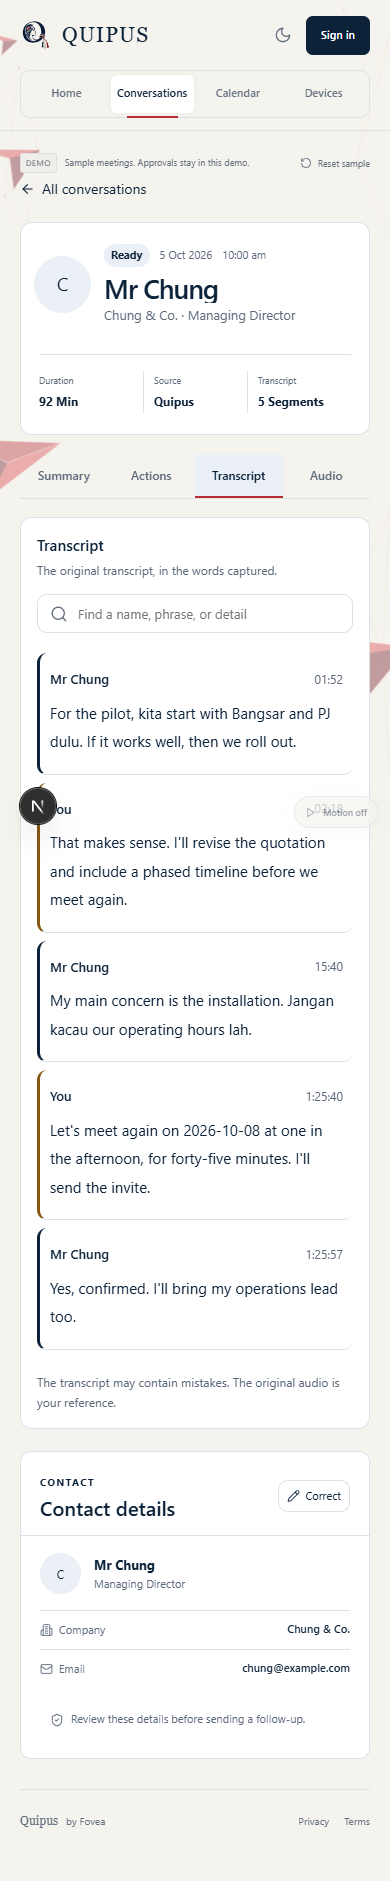
output/ui-review/detail-transcript-mobile.png
