NathanHor22/Quipus/output/ui-review/devices-desktop.png

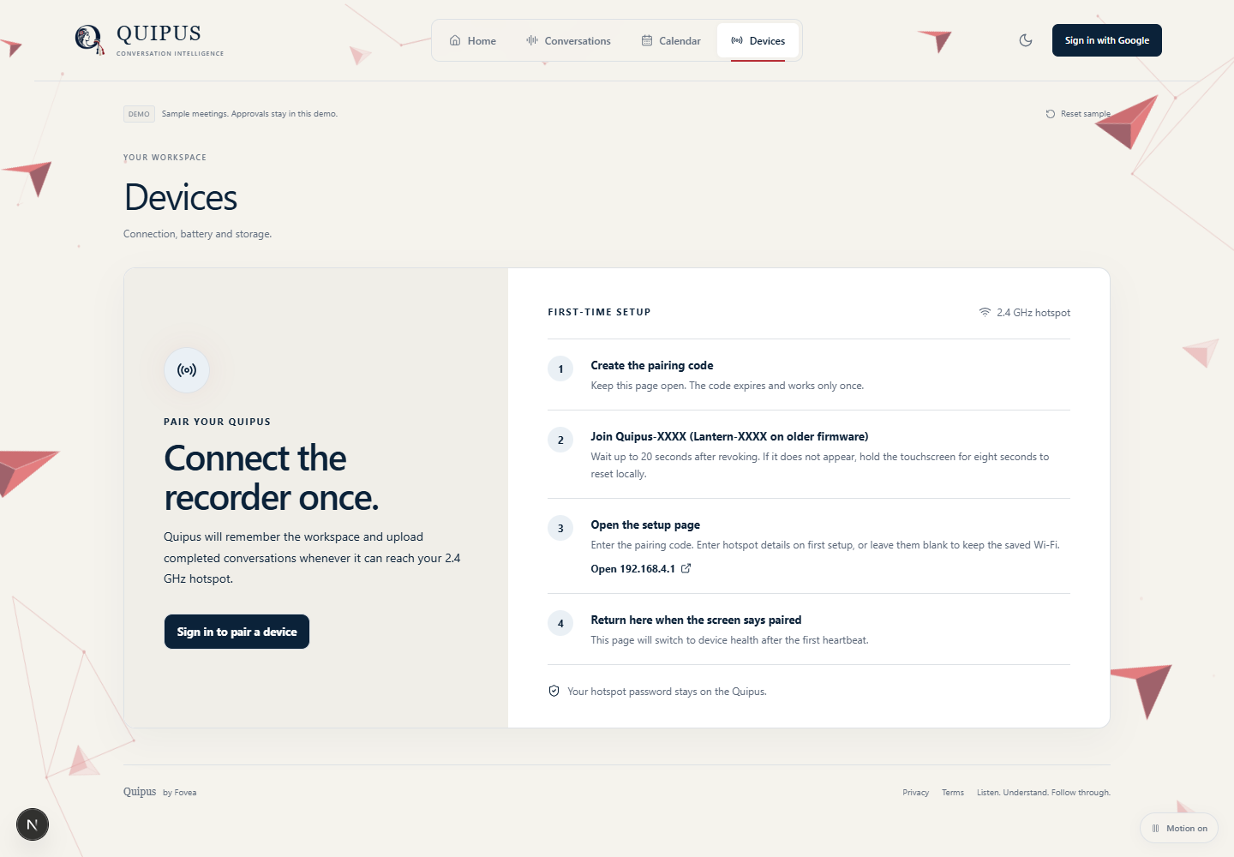
output/ui-review/devices-desktop.png
