NathanHor22/Quipus/output/ui-review/flow/approval-confirmation.png

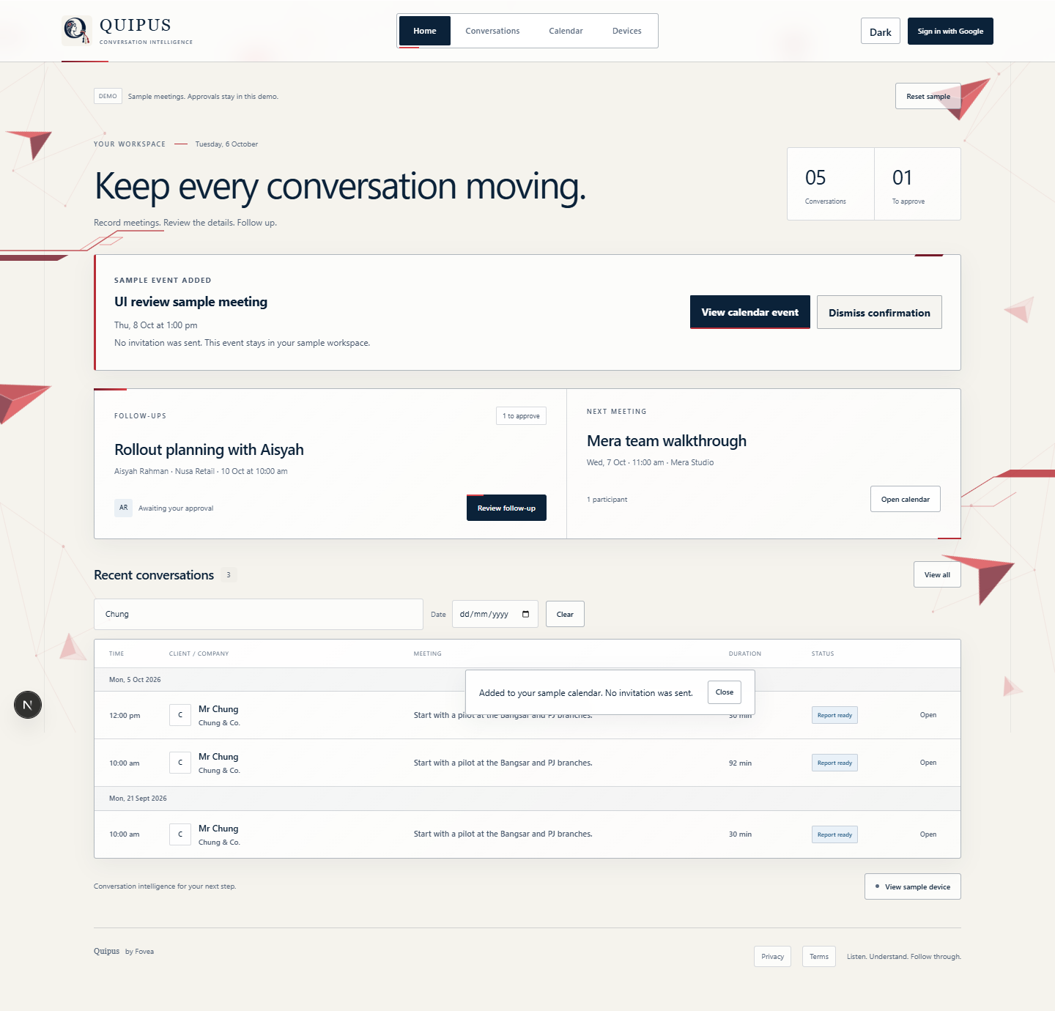
output/ui-review/flow/approval-confirmation.png
