NathanHor22/Quipus/output/ui-review/flow/approved-calendar-event.png

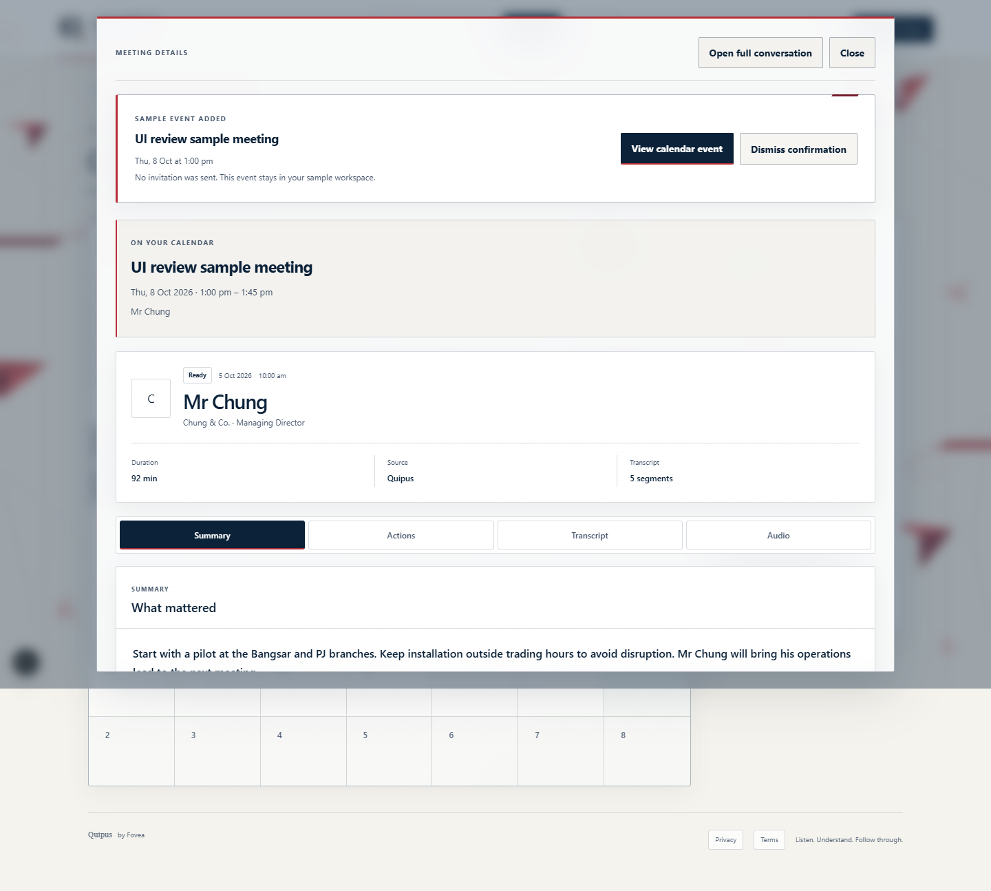
output/ui-review/flow/approved-calendar-event.png
