NathanHor22/Quipus/output/ui-review/flow/audio-available-desktop.png

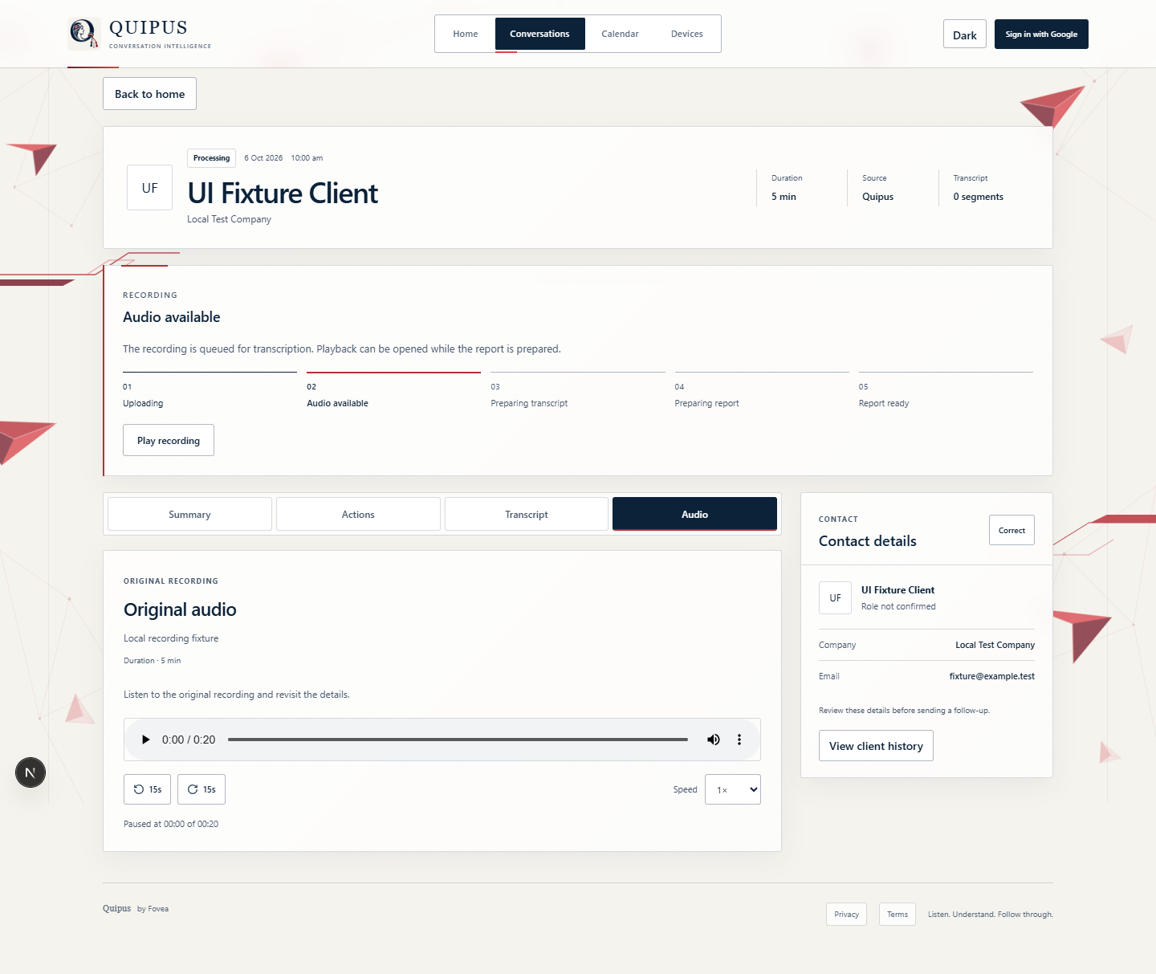
output/ui-review/flow/audio-available-desktop.png
