NathanHor22/Quipus/output/ui-review/flow/calendar-popup-mobile.png

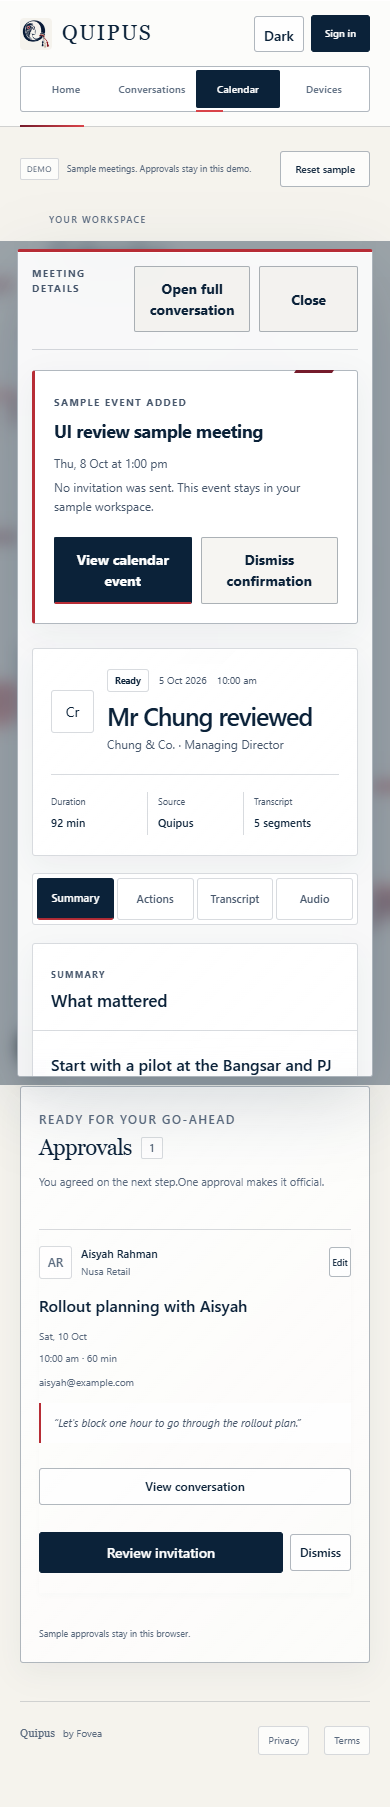
output/ui-review/flow/calendar-popup-mobile.png
