NathanHor22/Quipus/output/ui-review/flow/calendar-popup-review.png

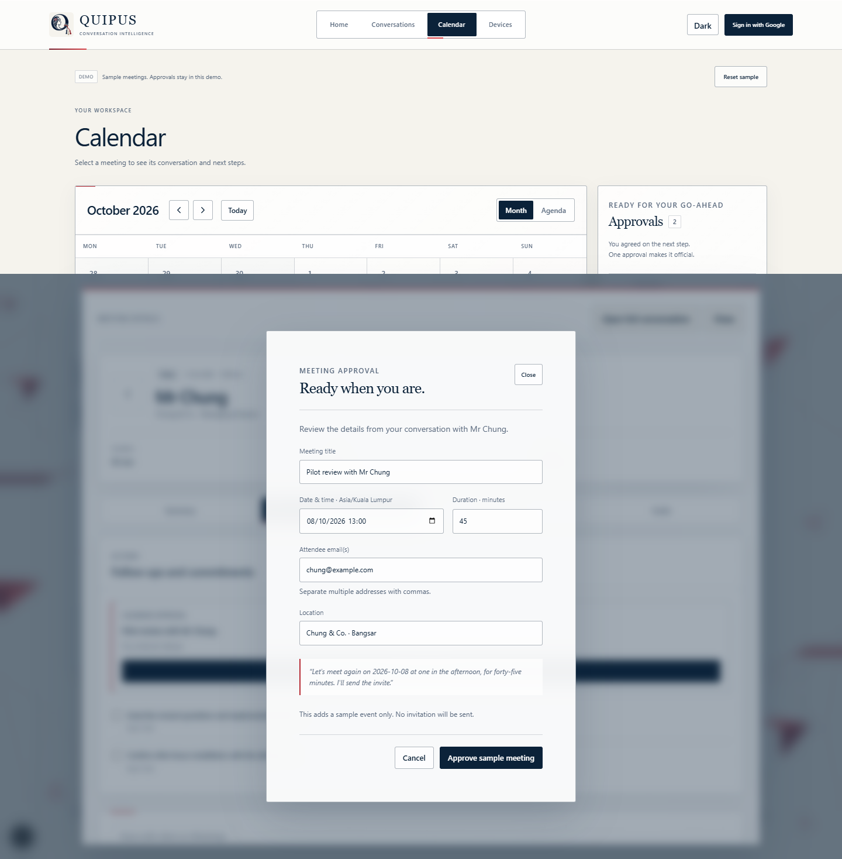
output/ui-review/flow/calendar-popup-review.png
