NathanHor22/Quipus/output/ui-review/flow/calendar-popup-summary.png

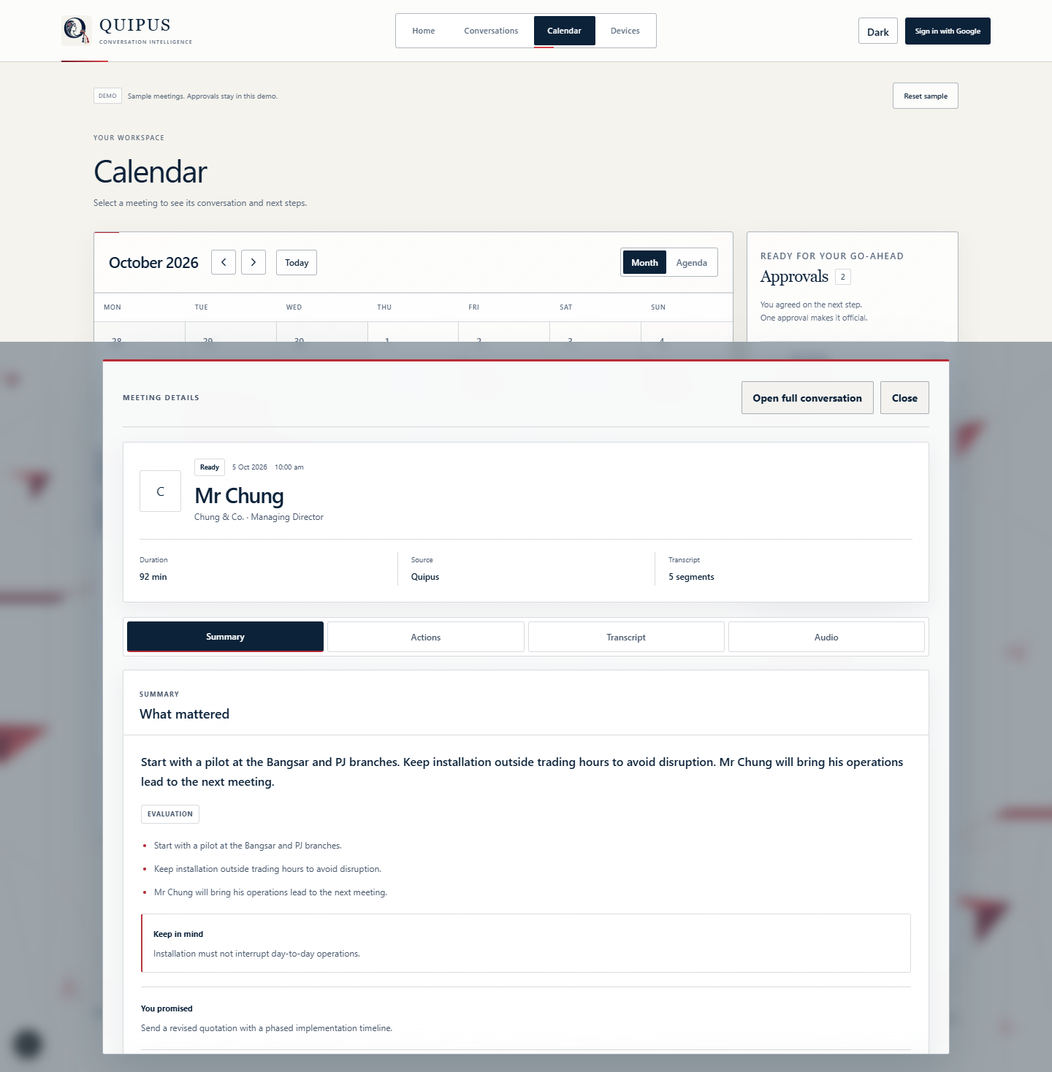
output/ui-review/flow/calendar-popup-summary.png
