NathanHor22/Quipus/output/ui-review/flow/client-correction-saved.png

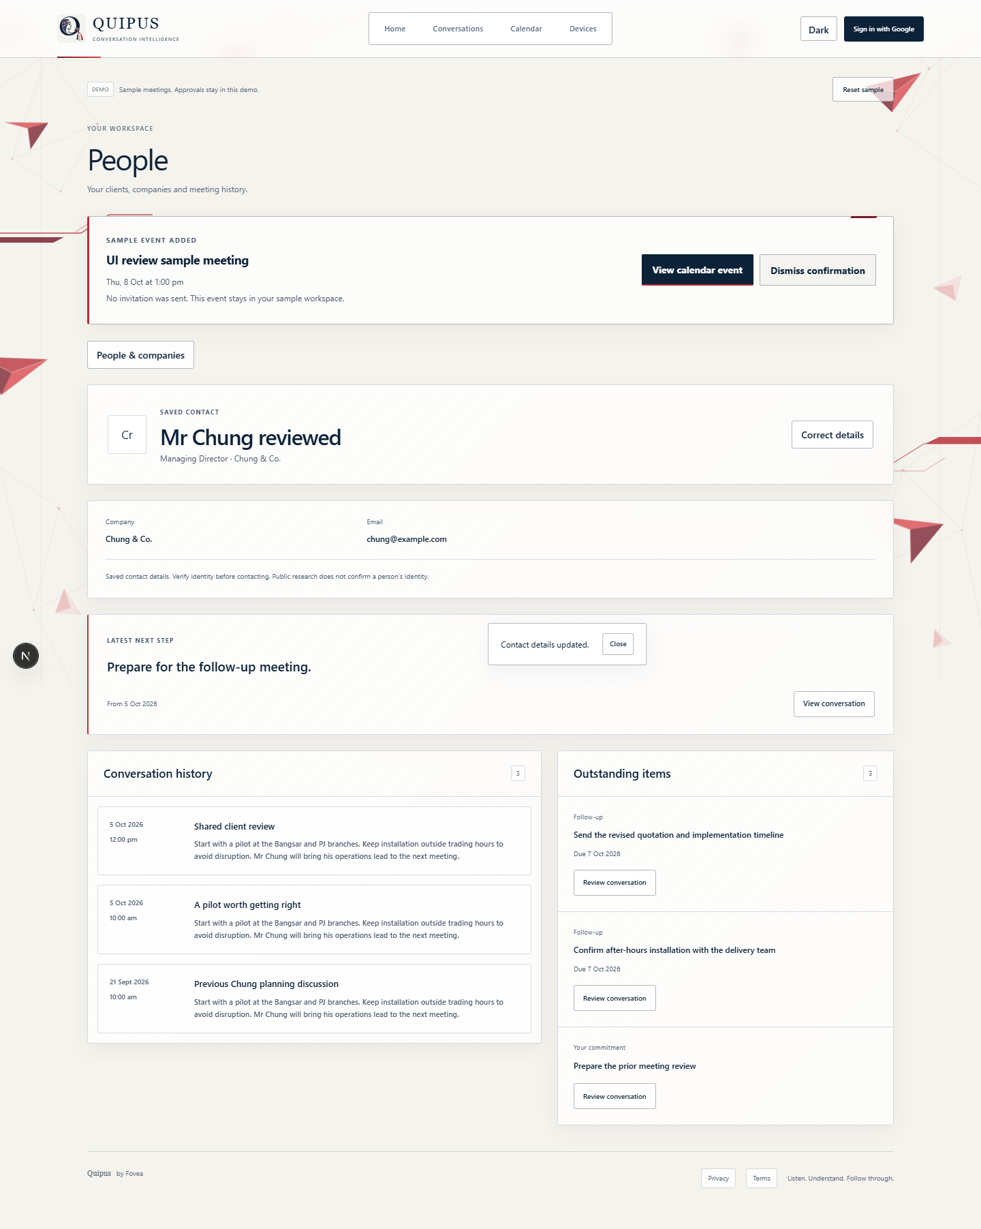
output/ui-review/flow/client-correction-saved.png
