NathanHor22/Quipus/output/ui-review/flow/confirmed-wav-duration-desktop.png

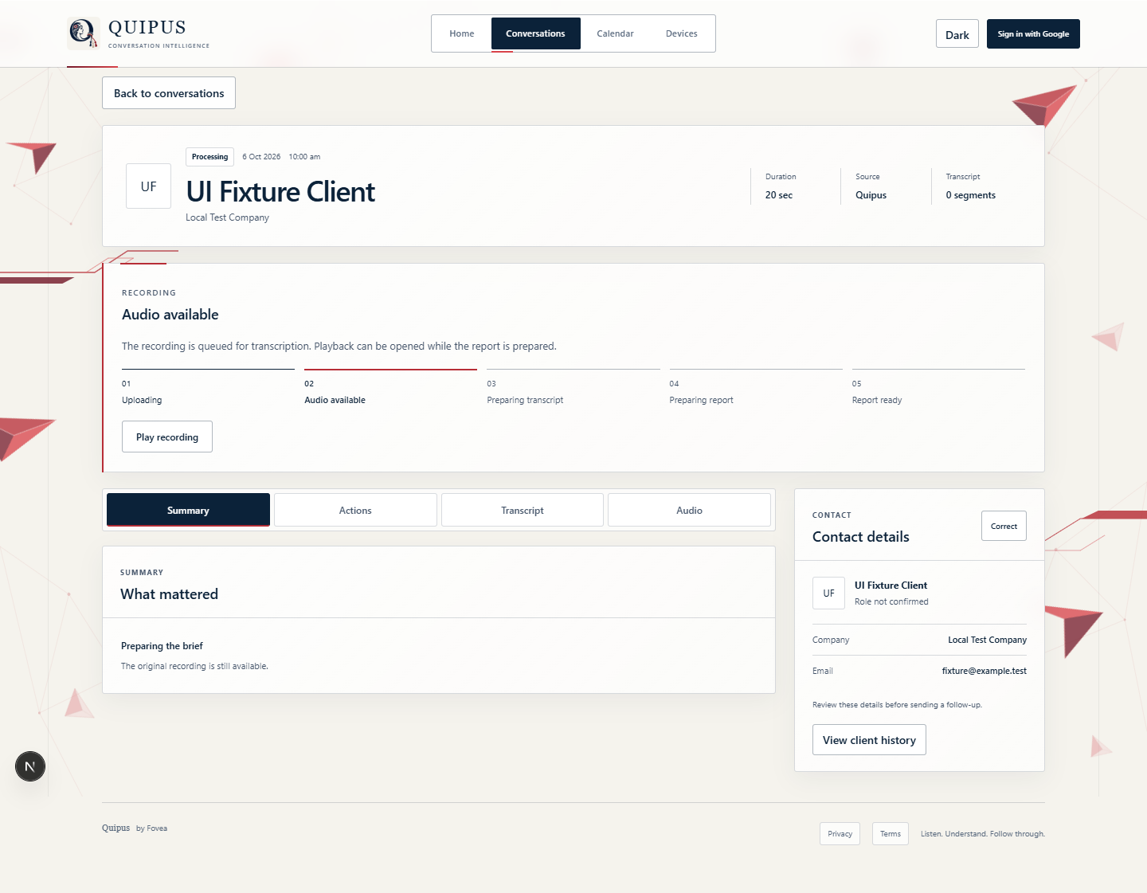
output/ui-review/flow/confirmed-wav-duration-desktop.png
