NathanHor22/Quipus/output/ui-review/flow/failed-audio-desktop.png

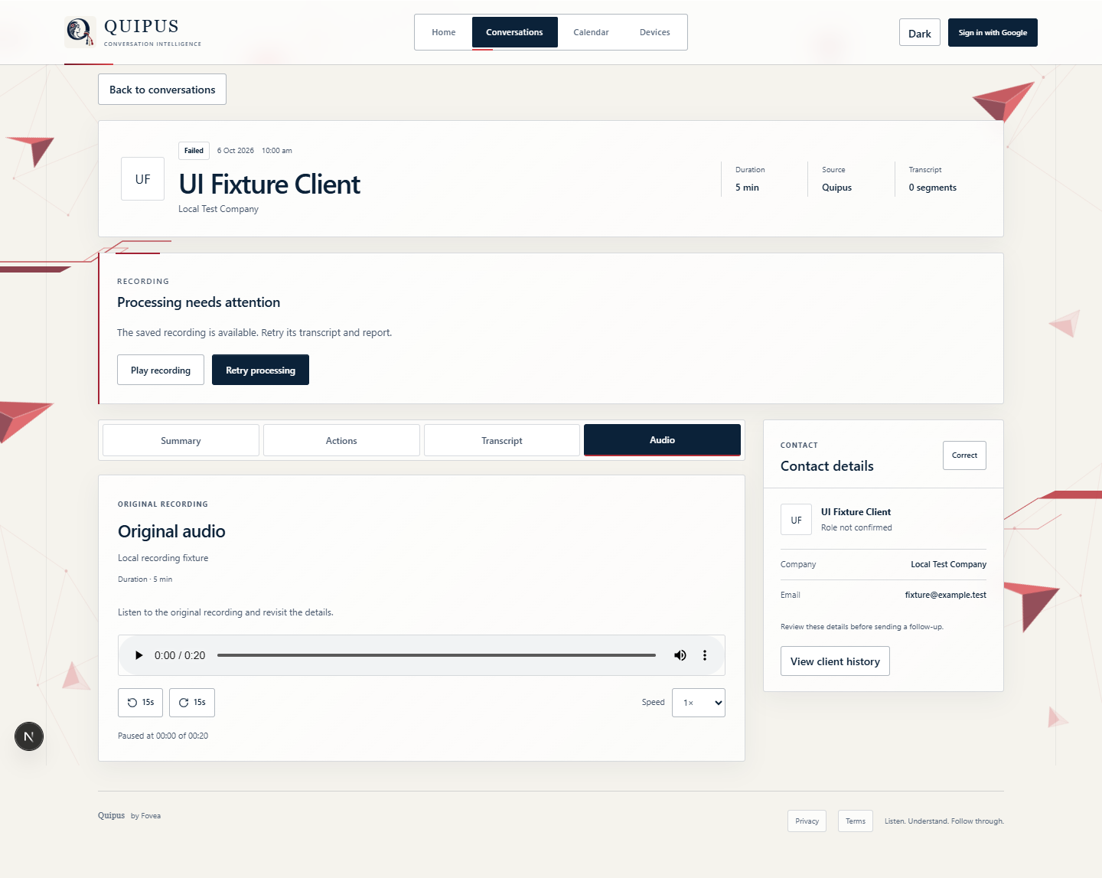
output/ui-review/flow/failed-audio-desktop.png
