NathanHor22/Quipus/output/ui-review/flow/failed-retry-desktop.png

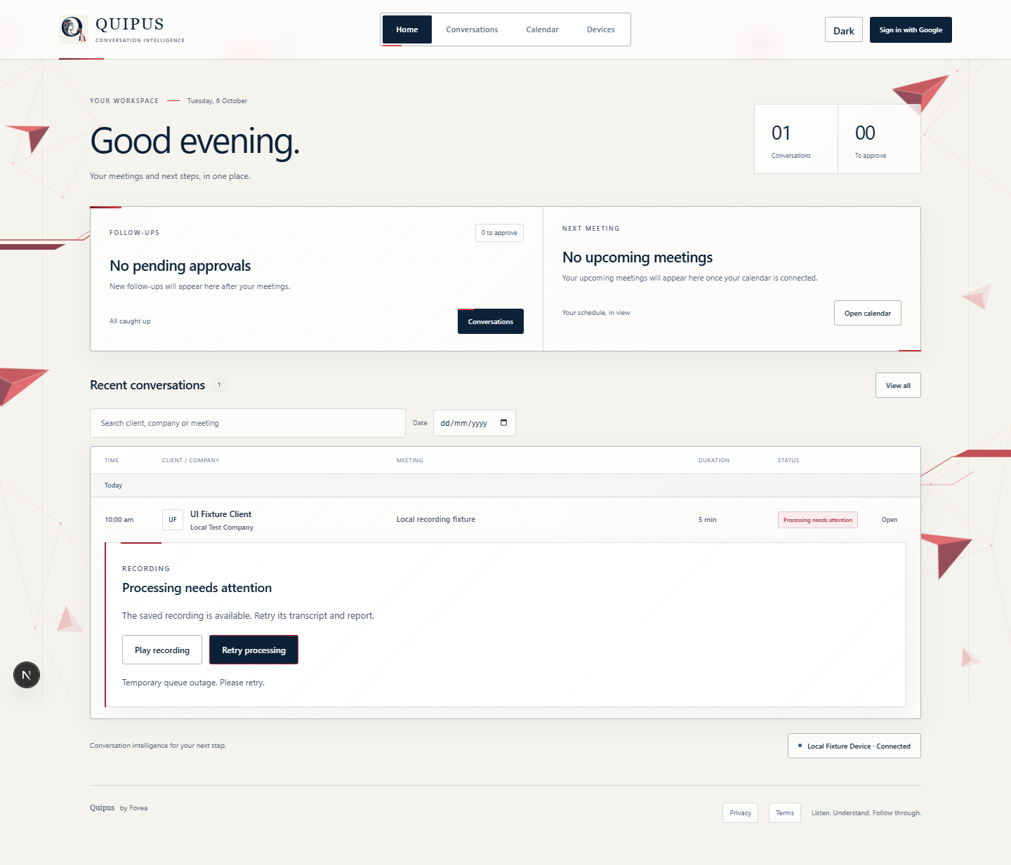
output/ui-review/flow/failed-retry-desktop.png
