NathanHor22/Quipus/output/ui-review/flow/final-glass-revoke-dark-mobile.png

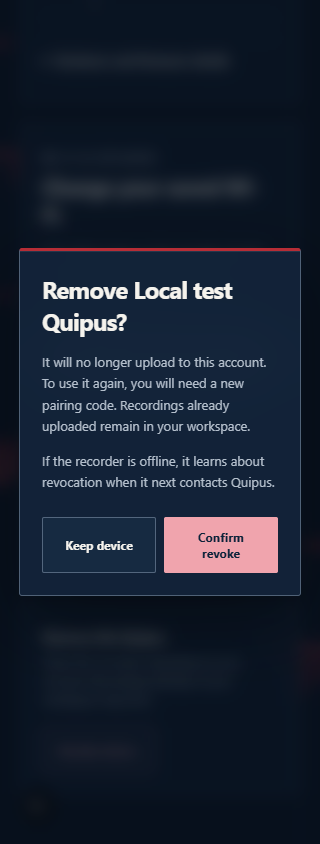
output/ui-review/flow/final-glass-revoke-dark-mobile.png
