NathanHor22/Quipus/output/ui-review/flow/final-glass-revoke-desktop.png

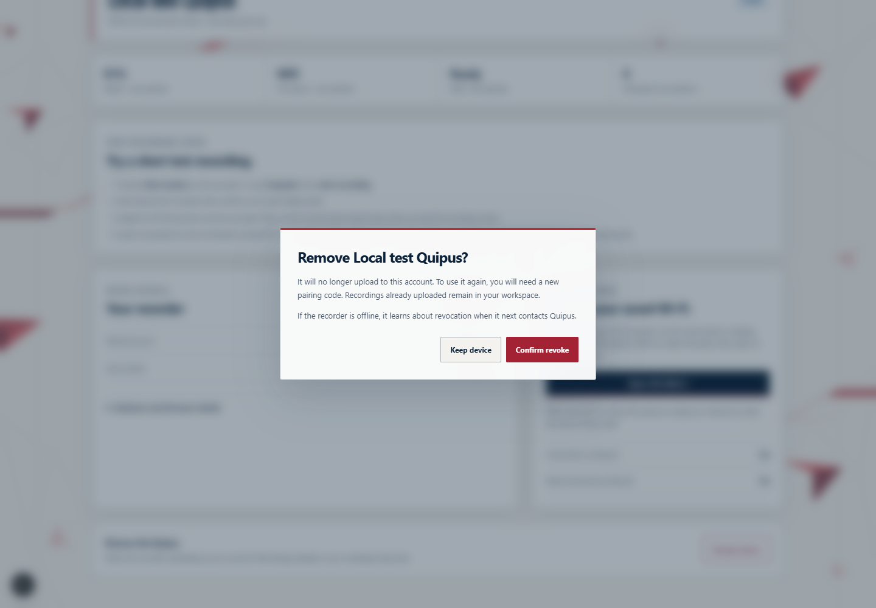
output/ui-review/flow/final-glass-revoke-desktop.png
