NathanHor22/Quipus/output/ui-review/flow/glass-paired-device-desktop.png

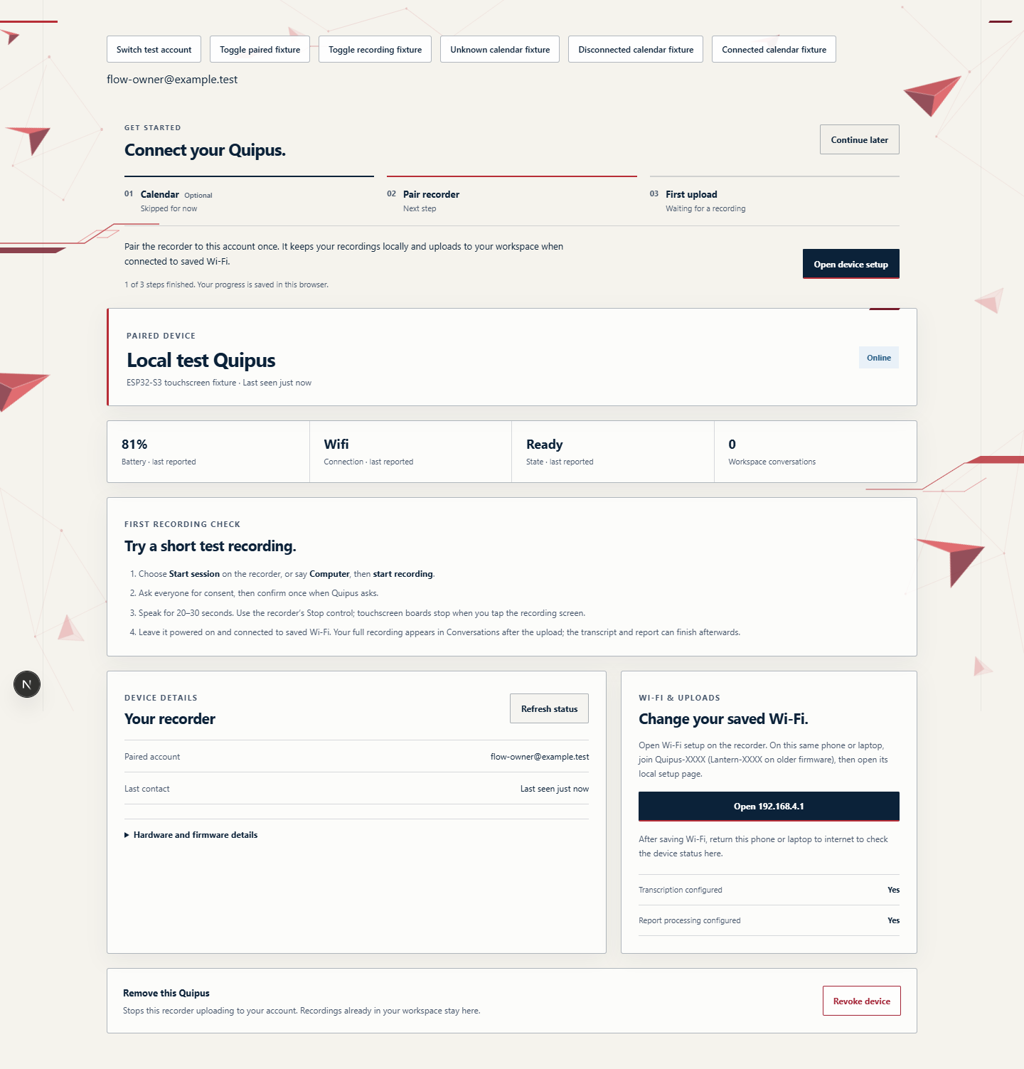
output/ui-review/flow/glass-paired-device-desktop.png
