NathanHor22/Quipus/output/ui-review/flow/glass-paired-device-mobile-320.png

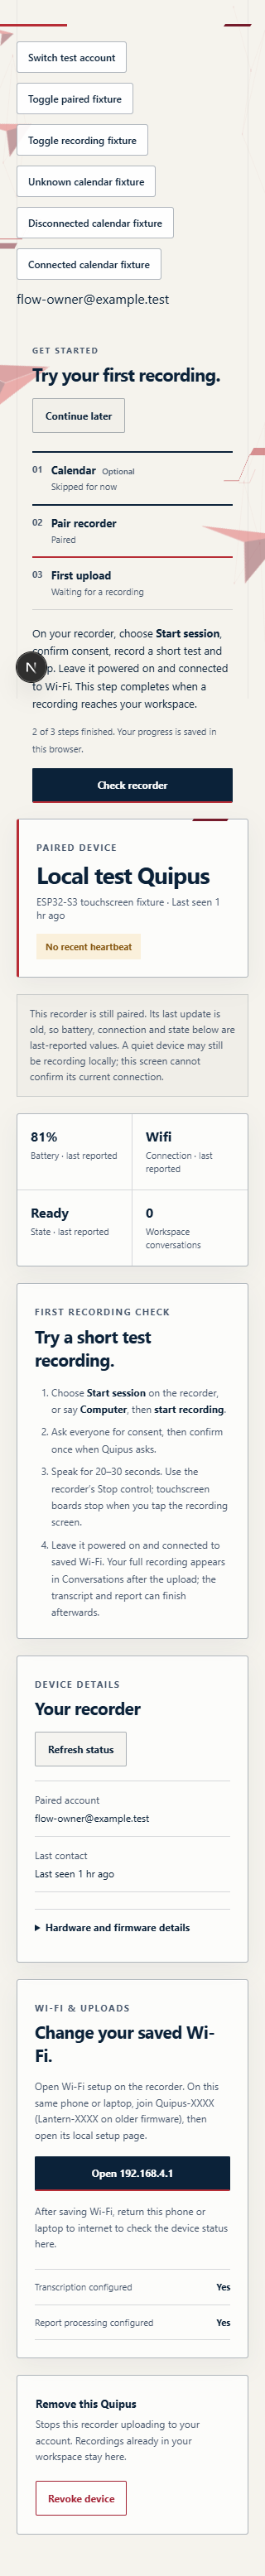
output/ui-review/flow/glass-paired-device-mobile-320.png
