NathanHor22/Quipus/output/ui-review/flow/glass-paired-device-stale.png

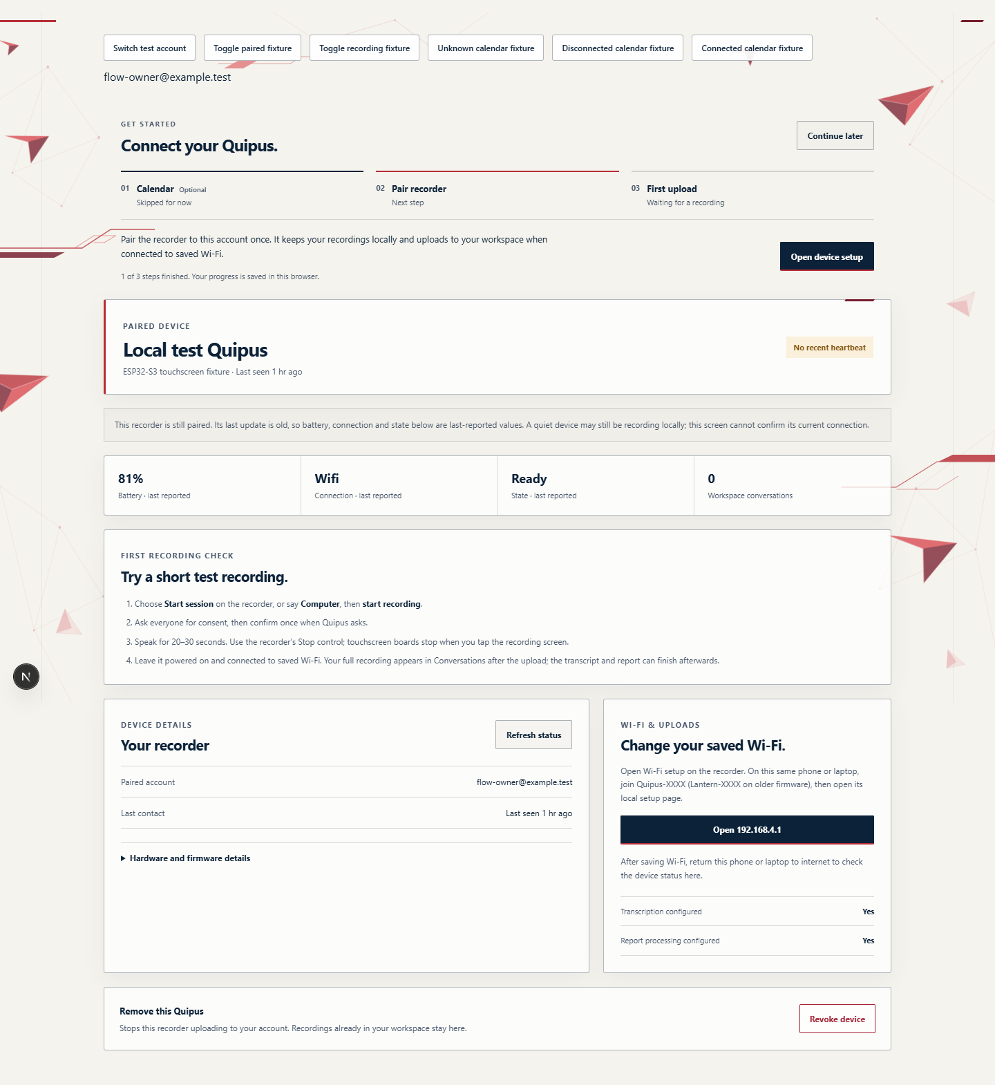
output/ui-review/flow/glass-paired-device-stale.png
