NathanHor22/Quipus/output/ui-review/flow/glass-pairing-expired-desktop.png

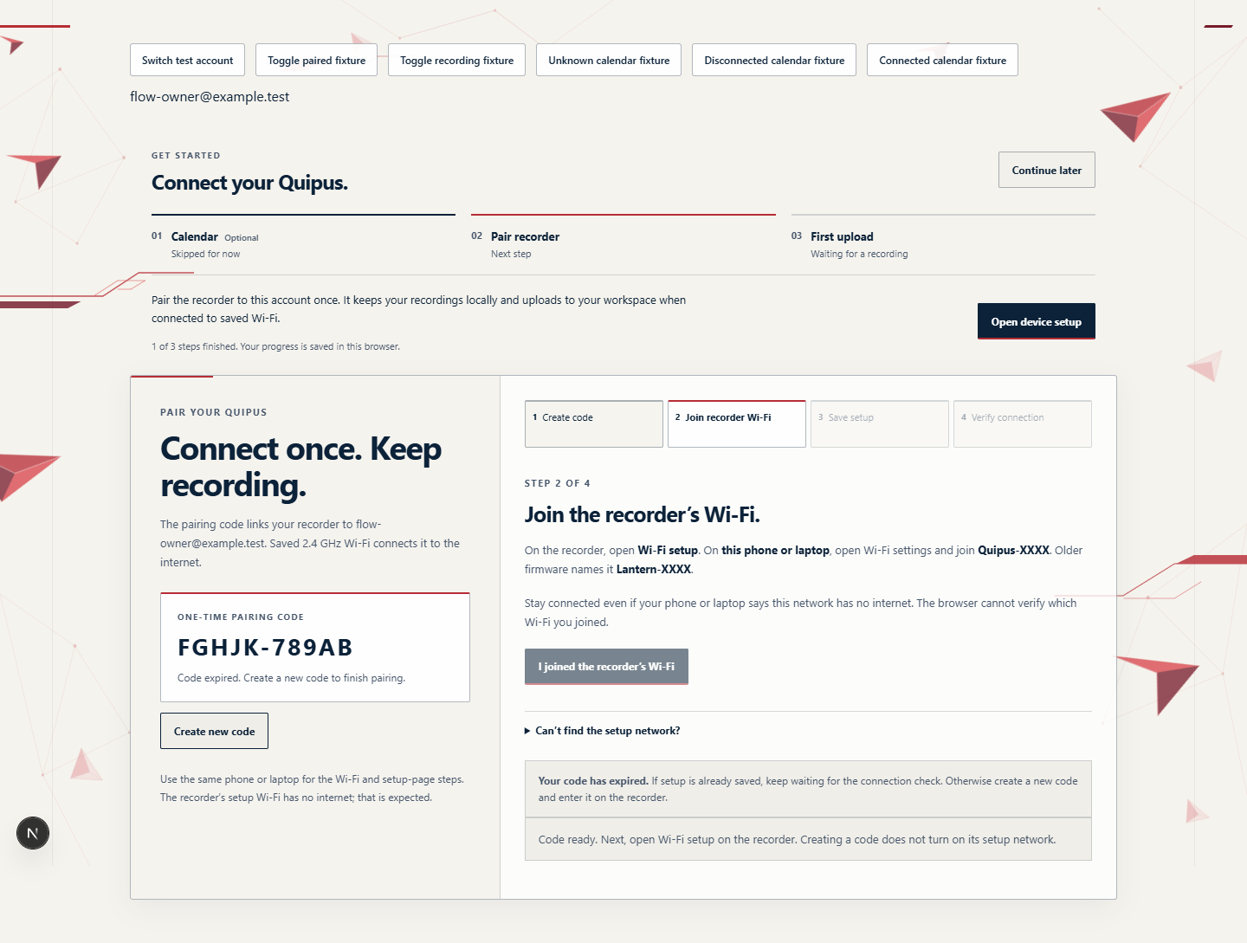
output/ui-review/flow/glass-pairing-expired-desktop.png
