NathanHor22/Quipus/output/ui-review/flow/glass-pairing-mobile-320.png

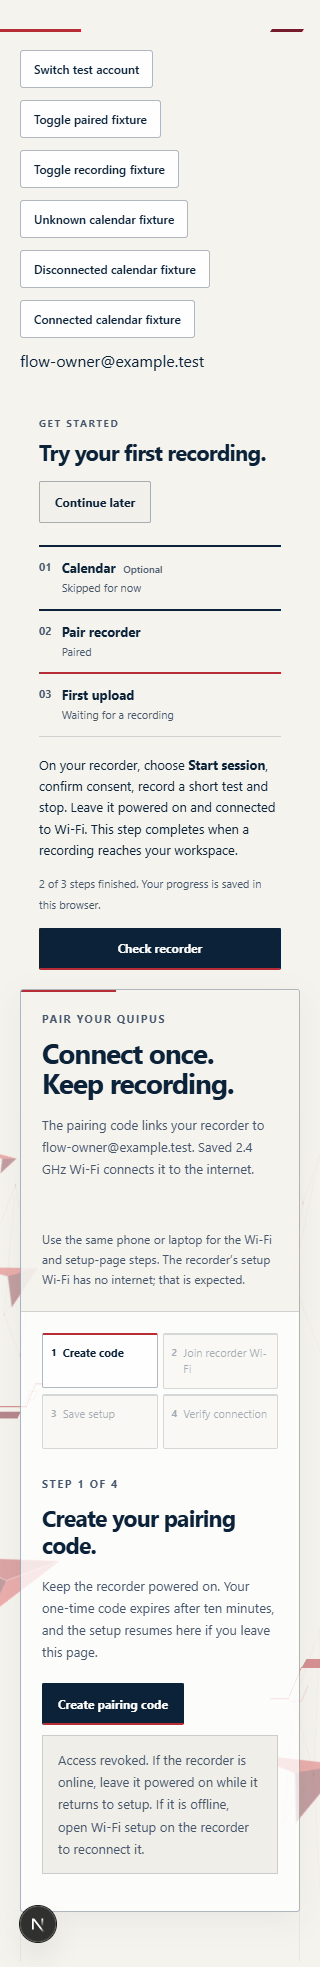
output/ui-review/flow/glass-pairing-mobile-320.png
