NathanHor22/Quipus/output/ui-review/flow/glass-pairing-retry-desktop.png

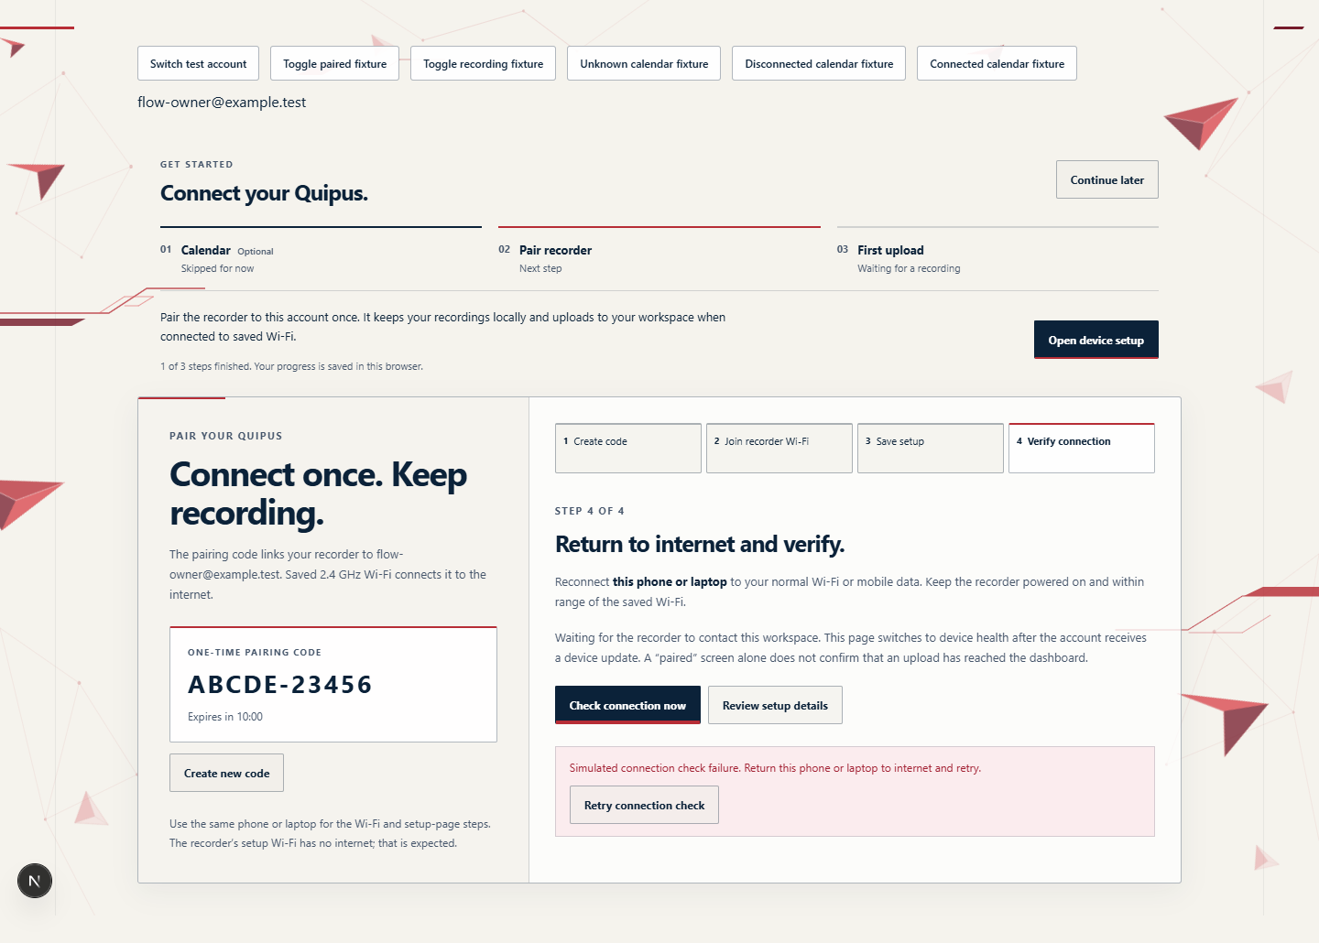
output/ui-review/flow/glass-pairing-retry-desktop.png
