NathanHor22/Quipus/output/ui-review/flow/glass-revoke-confirmation-desktop.png

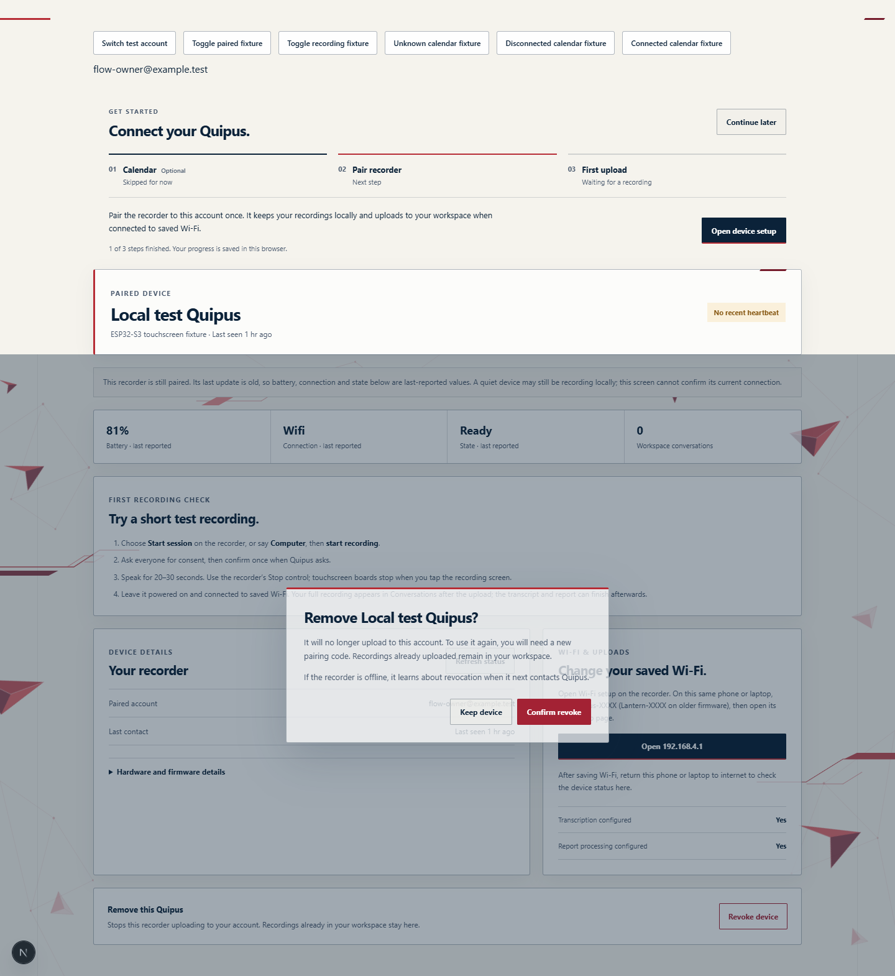
output/ui-review/flow/glass-revoke-confirmation-desktop.png
