NathanHor22/Quipus/output/ui-review/flow/home-review.png

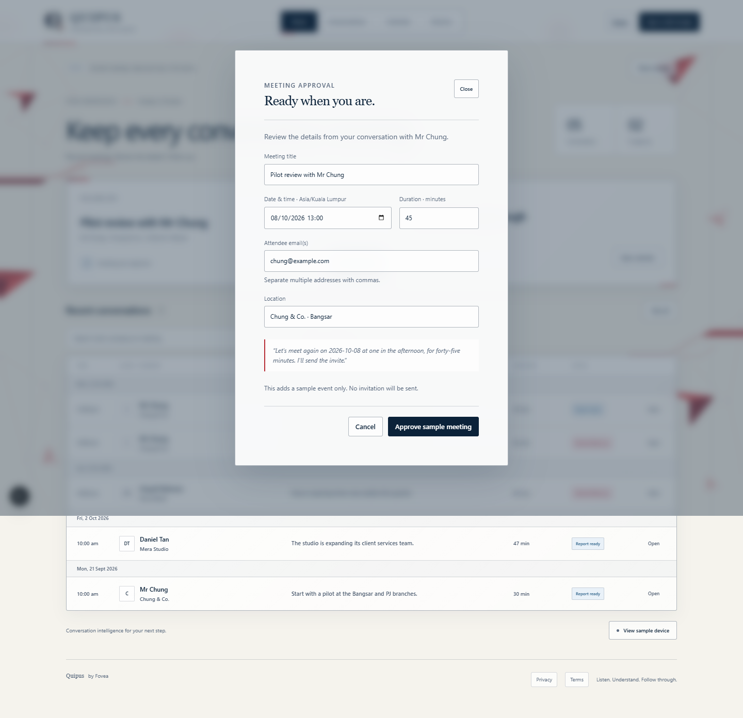
output/ui-review/flow/home-review.png
