NathanHor22/Quipus/output/ui-review/flow/paired-device-desktop.png

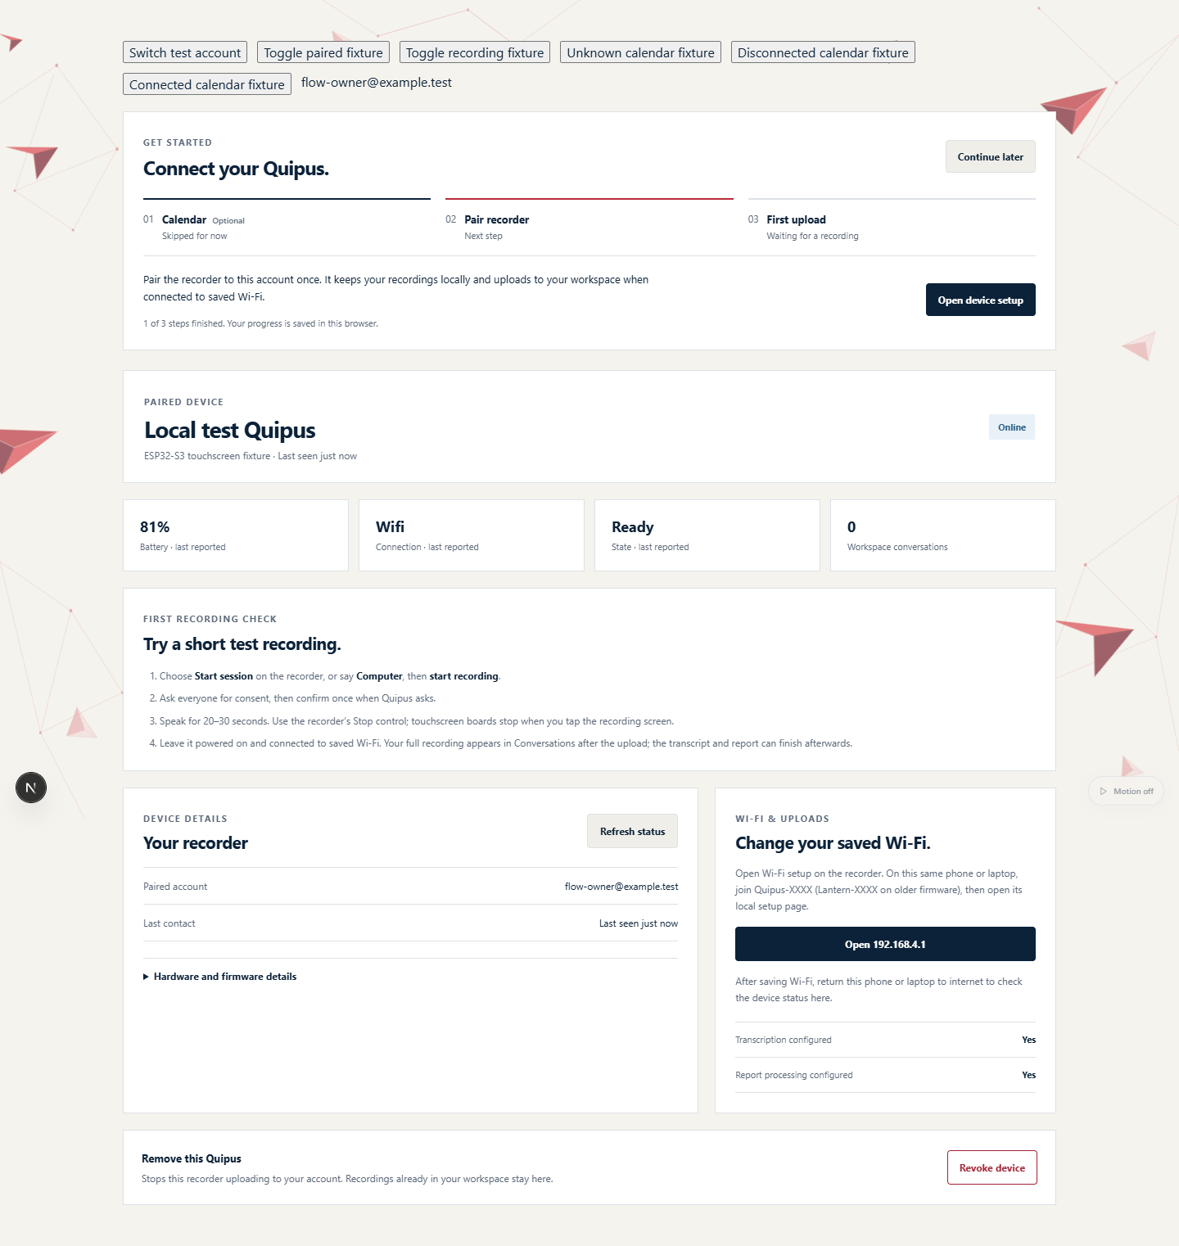
output/ui-review/flow/paired-device-desktop.png
