NathanHor22/Quipus/output/ui-review/flow/paired-device-mobile-390.png

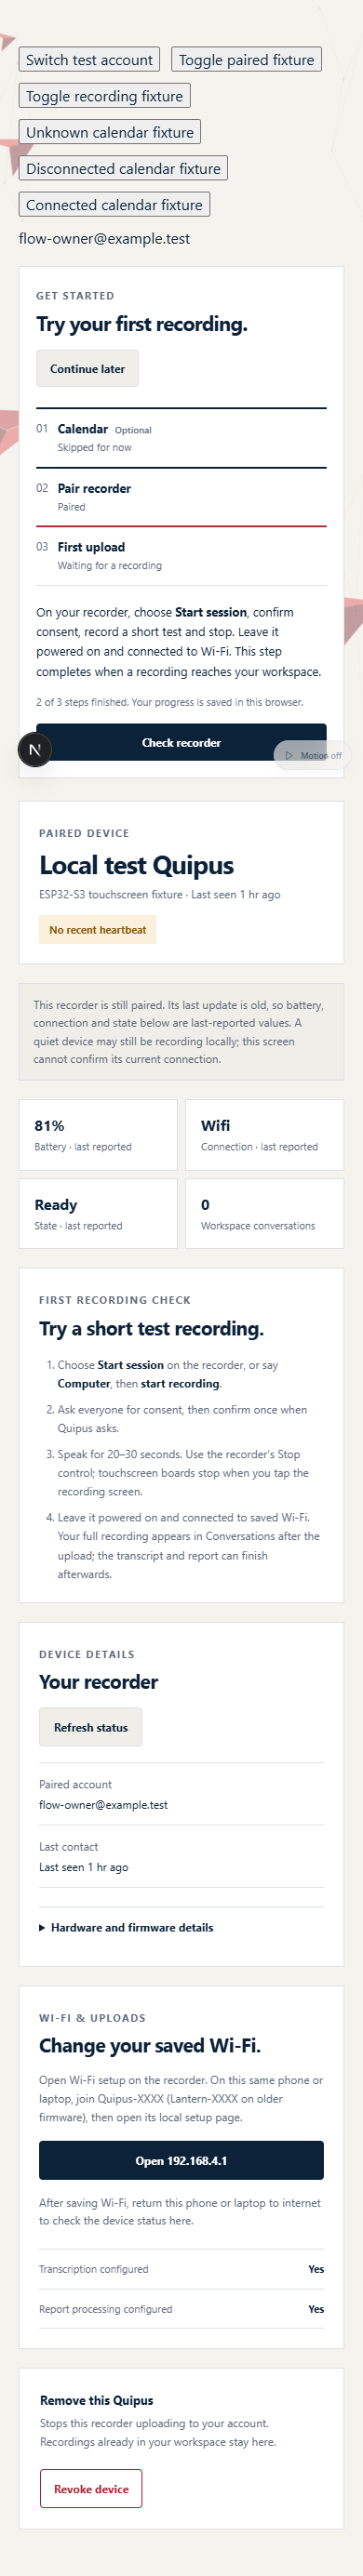
output/ui-review/flow/paired-device-mobile-390.png
