NathanHor22/Quipus/output/ui-review/flow/pairing-expired-desktop.png

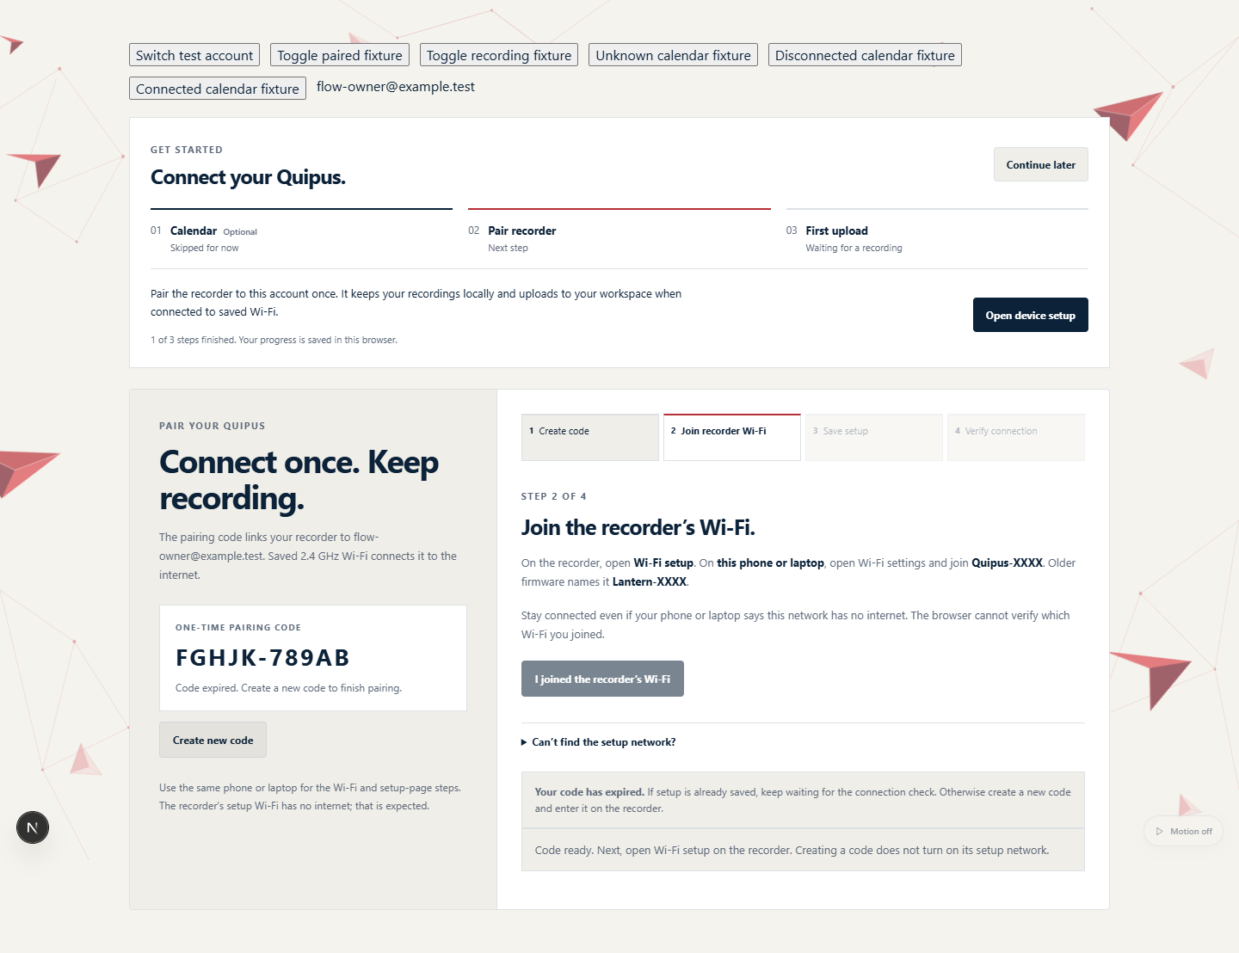
output/ui-review/flow/pairing-expired-desktop.png
