NathanHor22/Quipus/output/ui-review/flow/pairing-mobile-320.png

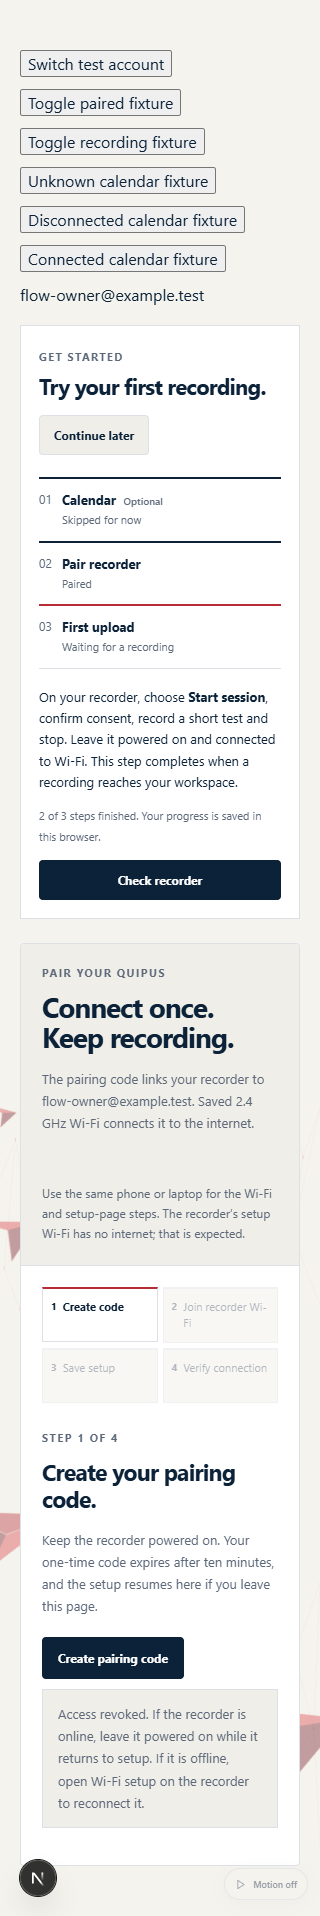
output/ui-review/flow/pairing-mobile-320.png
