NathanHor22/Quipus/output/ui-review/flow/pairing-retry-desktop.png

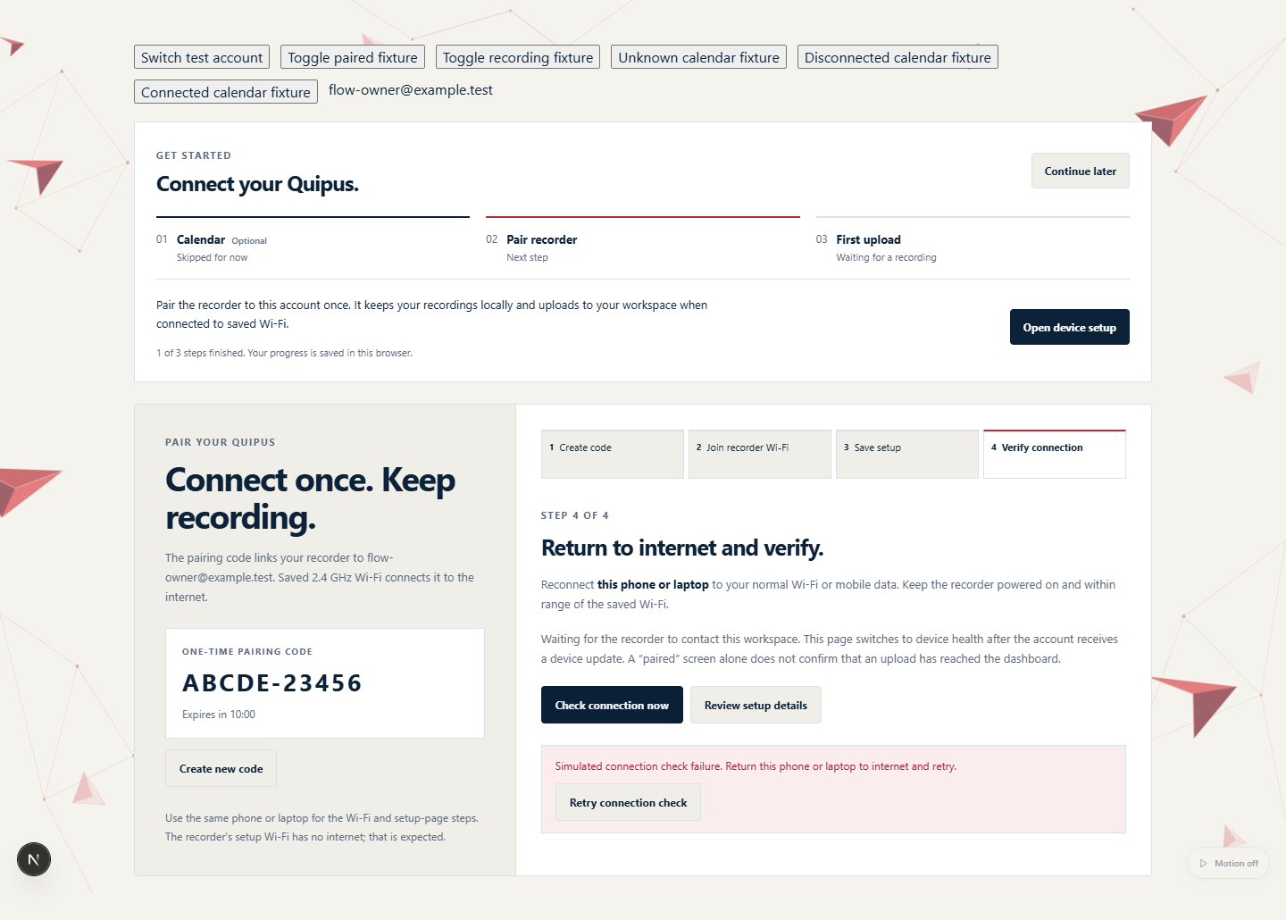
output/ui-review/flow/pairing-retry-desktop.png
