NathanHor22/Quipus/output/ui-review/flow/pairing-save-desktop.png

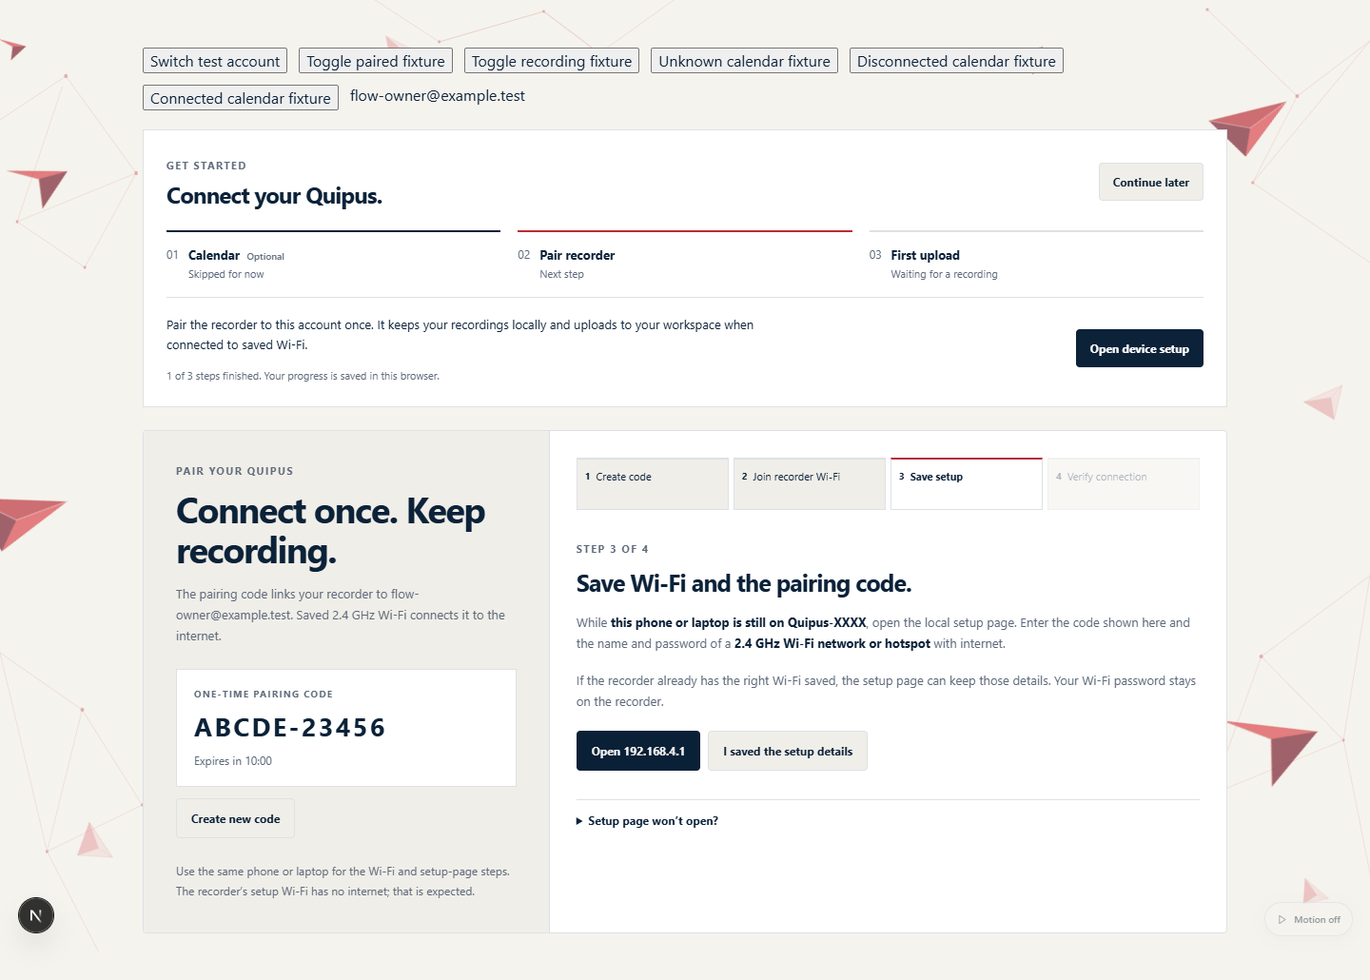
output/ui-review/flow/pairing-save-desktop.png
