NathanHor22/Quipus/output/ui-review/flow/processing-failed-mobile-320.png

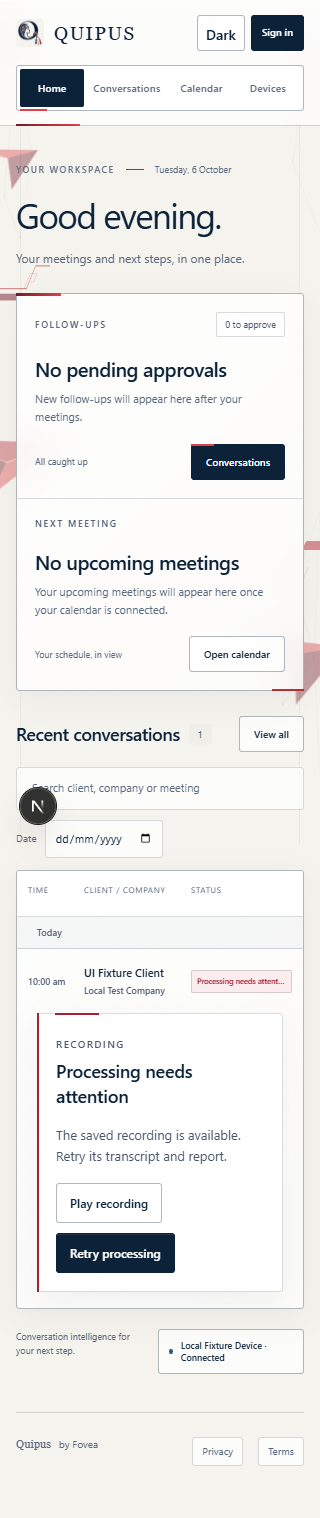
output/ui-review/flow/processing-failed-mobile-320.png
