NathanHor22/Quipus/output/ui-review/flow/processing-transcribing-mobile-320.png

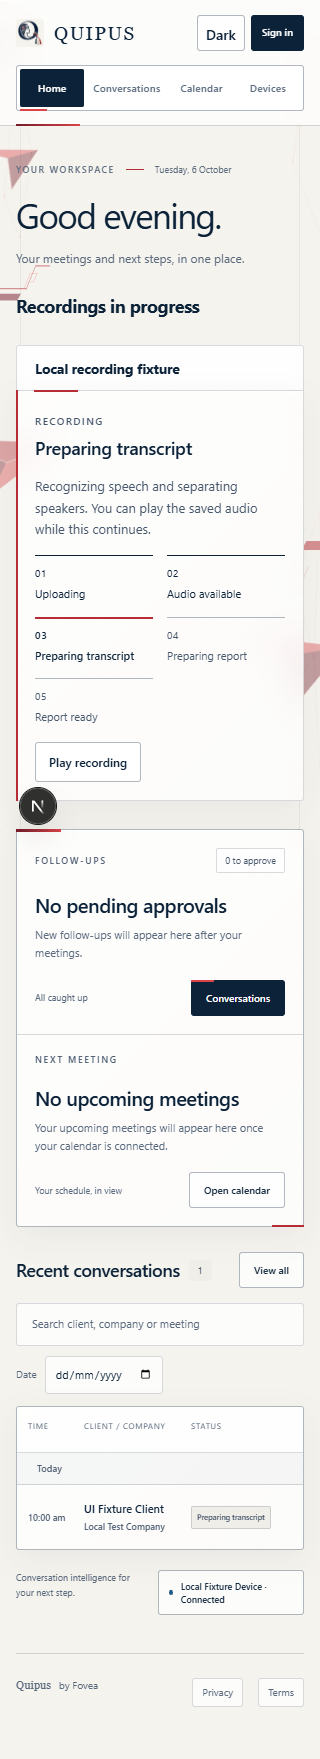
output/ui-review/flow/processing-transcribing-mobile-320.png
