NathanHor22/Quipus/output/ui-review/flow/processing-uploading-mobile-320.png

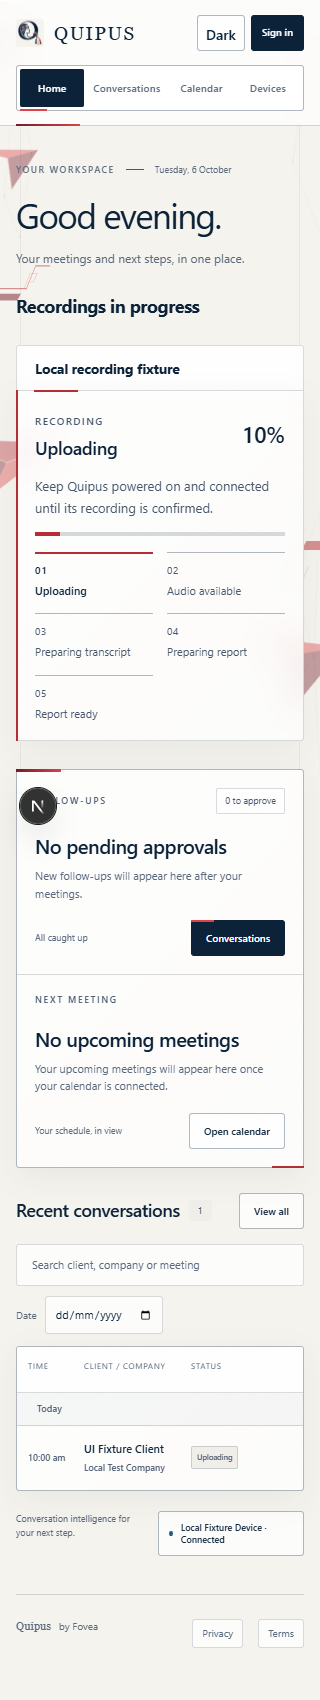
output/ui-review/flow/processing-uploading-mobile-320.png
