NathanHor22/Quipus/output/ui-review/flow/revoke-confirmation-desktop.png

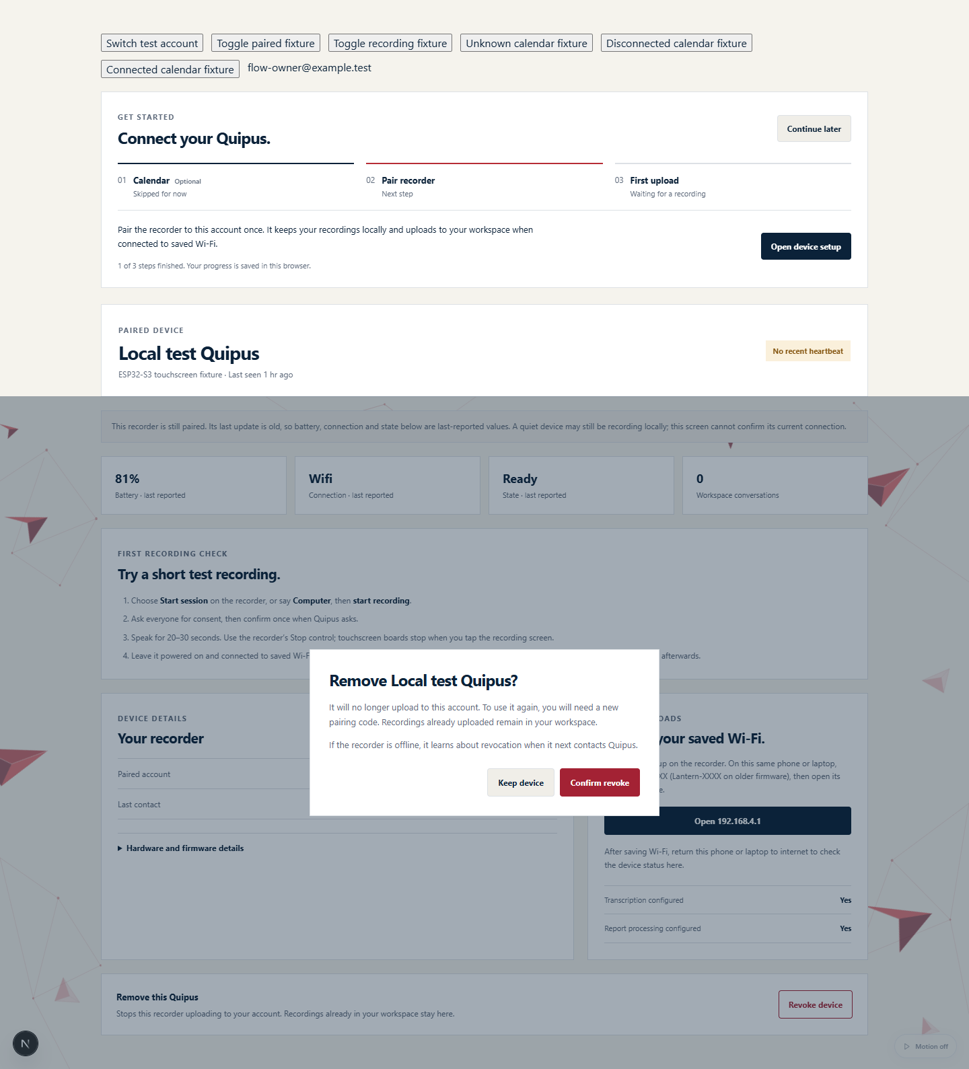
output/ui-review/flow/revoke-confirmation-desktop.png
