NathanHor22/Quipus/output/ui-review/flow/secondary-contact-correction.png

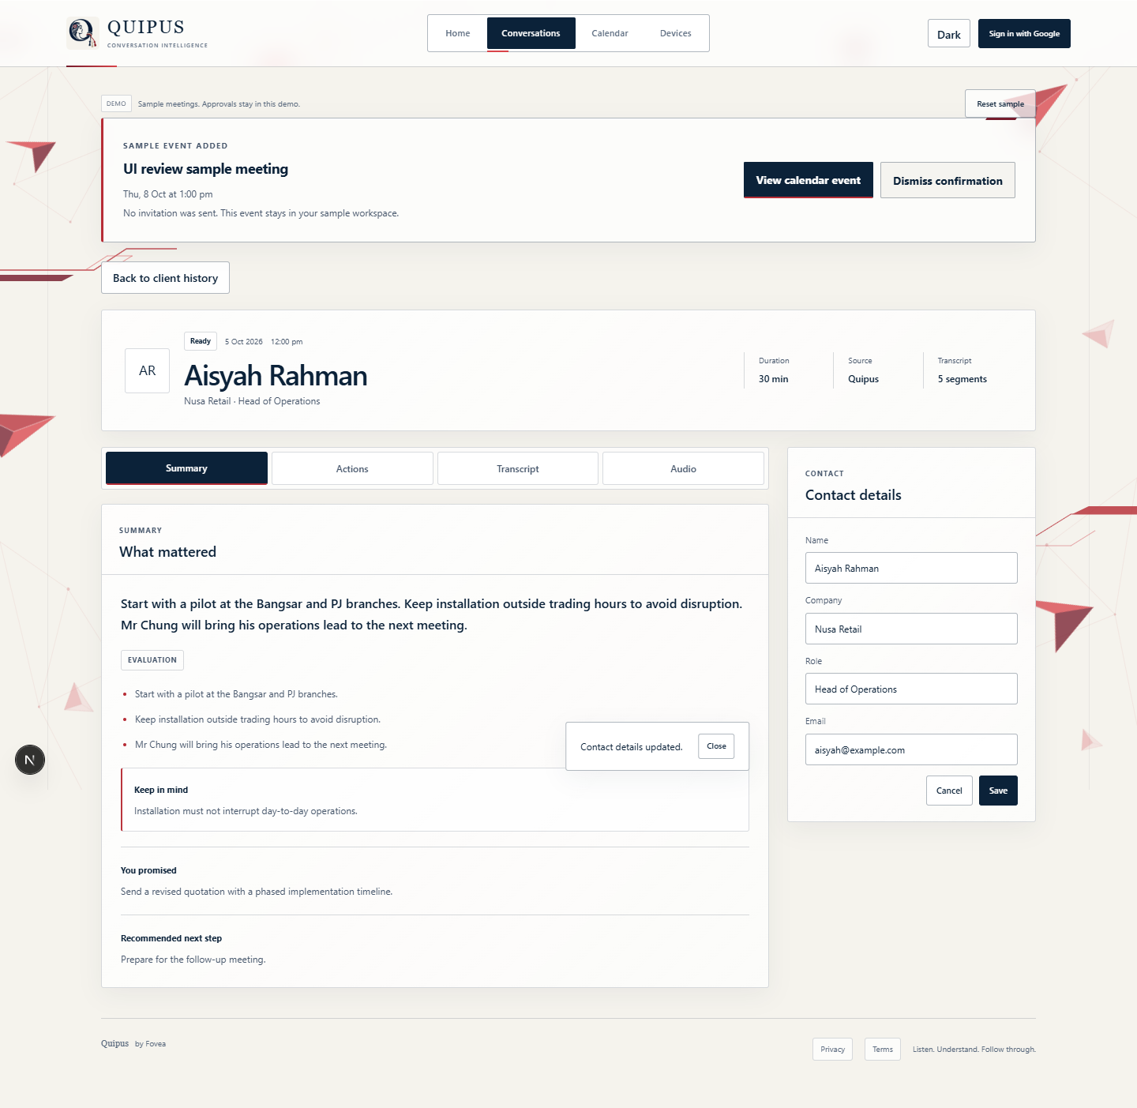
output/ui-review/flow/secondary-contact-correction.png
