NathanHor22/Quipus/output/ui-review/flow/uploading-desktop.png

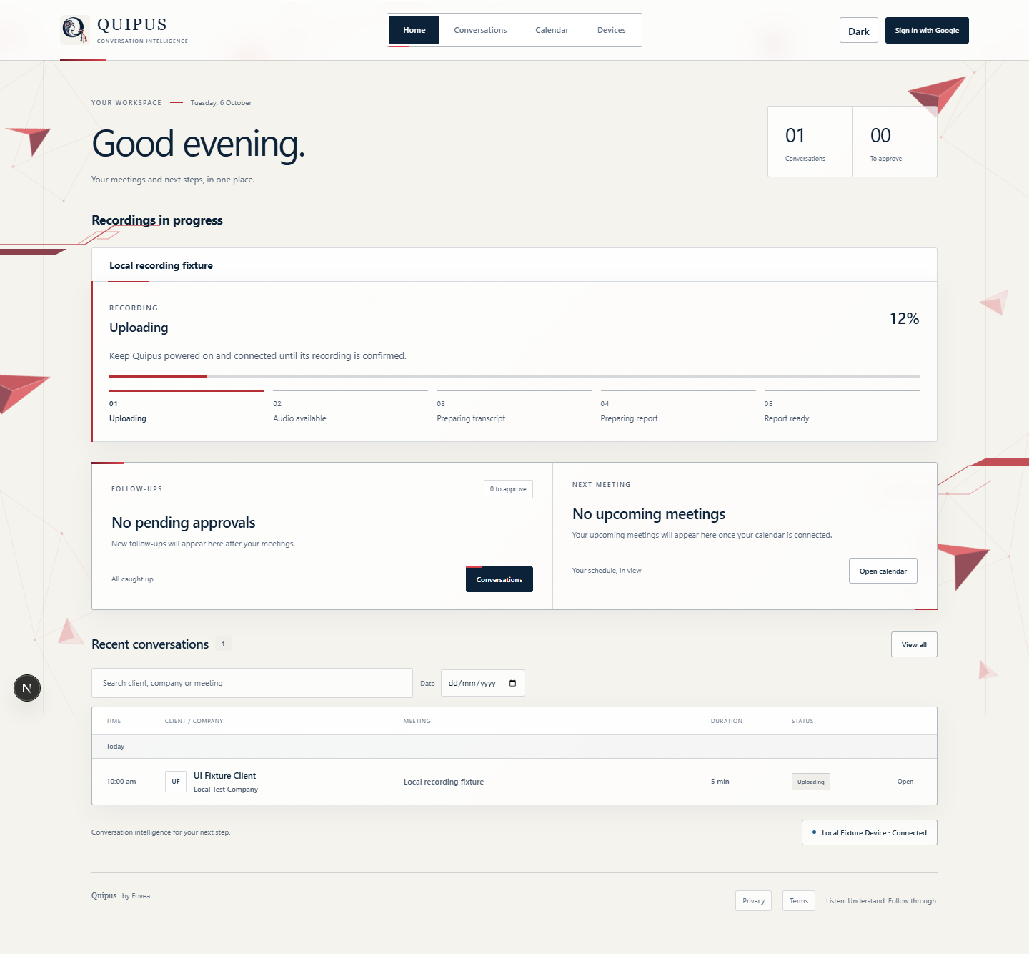
output/ui-review/flow/uploading-desktop.png
