NathanHor22/Quipus/output/ui-review/glass-calendar-320.png

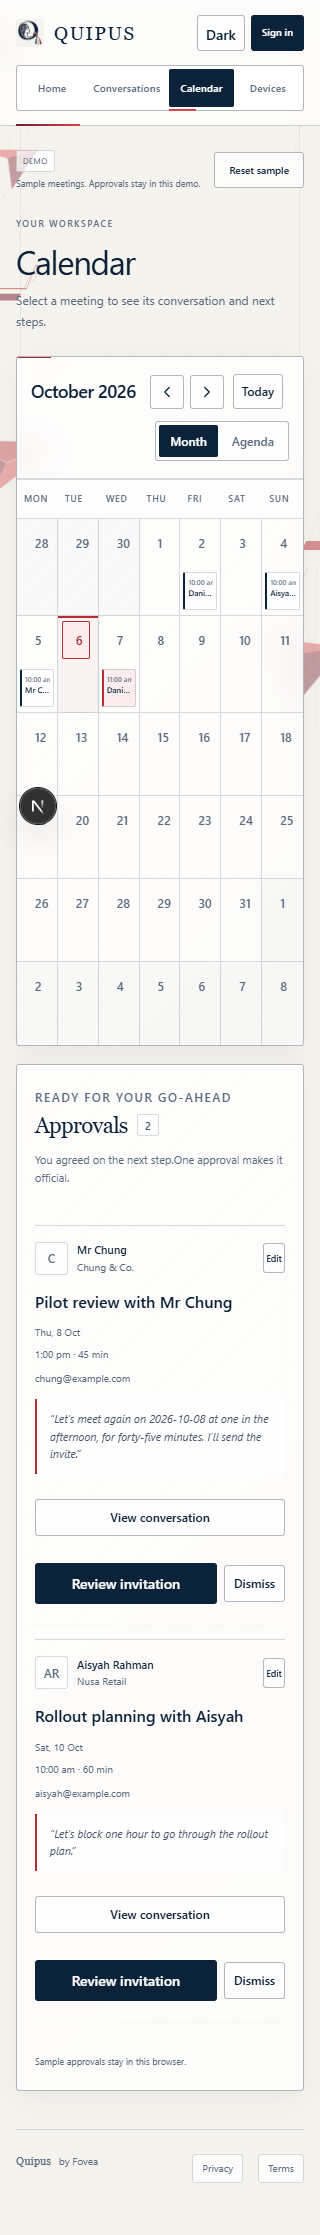
output/ui-review/glass-calendar-320.png
