NathanHor22/Quipus/output/ui-review/glass-calendar-390.png

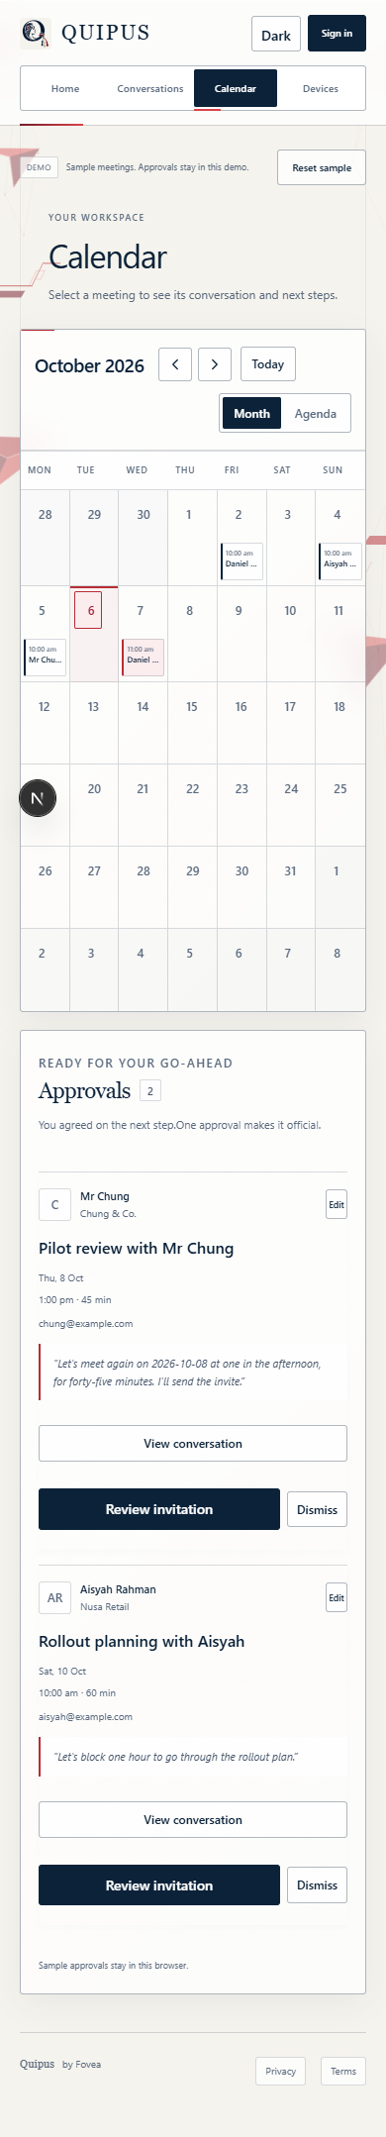
output/ui-review/glass-calendar-390.png
