NathanHor22/Quipus/output/ui-review/glass-calendar-desktop.png

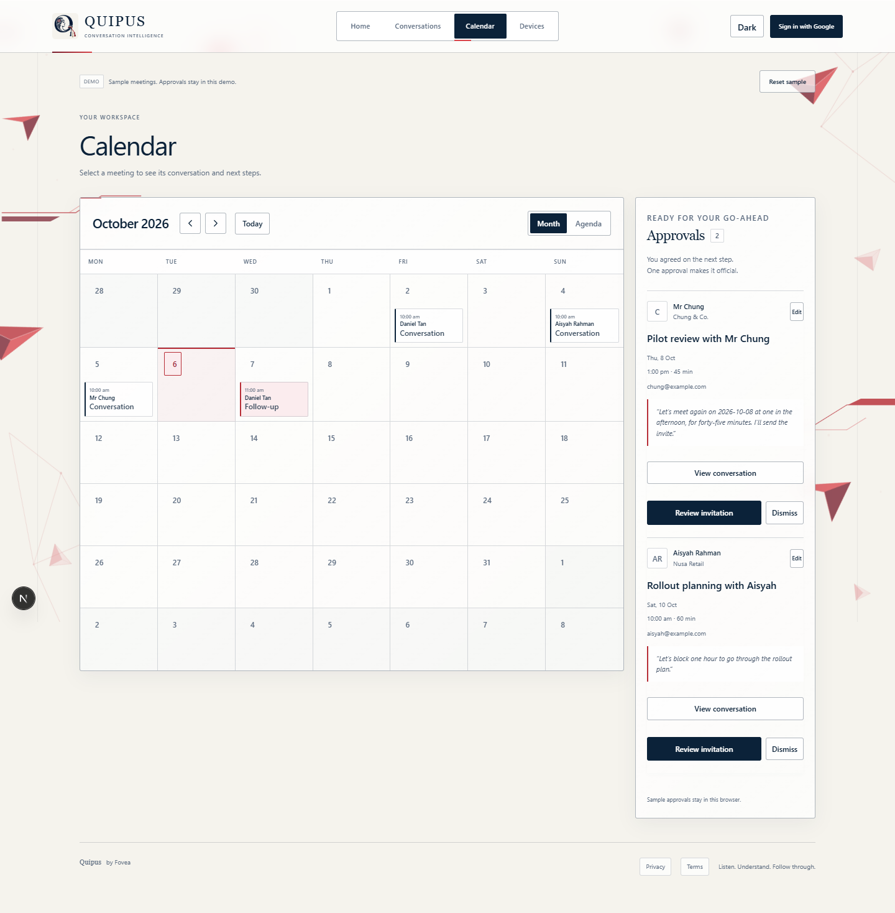
output/ui-review/glass-calendar-desktop.png
