NathanHor22/Quipus/output/ui-review/glass-conversations-320.png

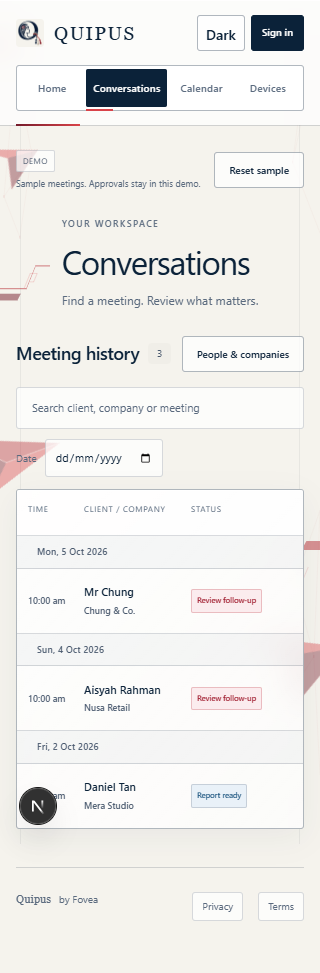
output/ui-review/glass-conversations-320.png
