NathanHor22/Quipus/output/ui-review/glass-conversations-390.png

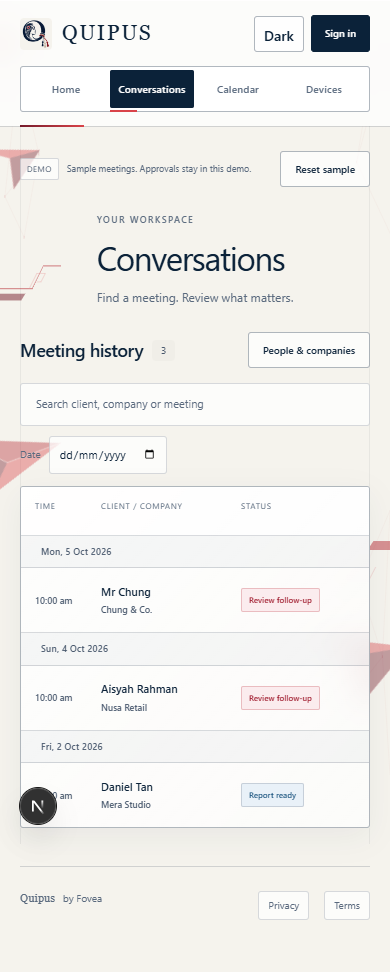
output/ui-review/glass-conversations-390.png
