NathanHor22/Quipus/output/ui-review/glass-detail-actions-320.png

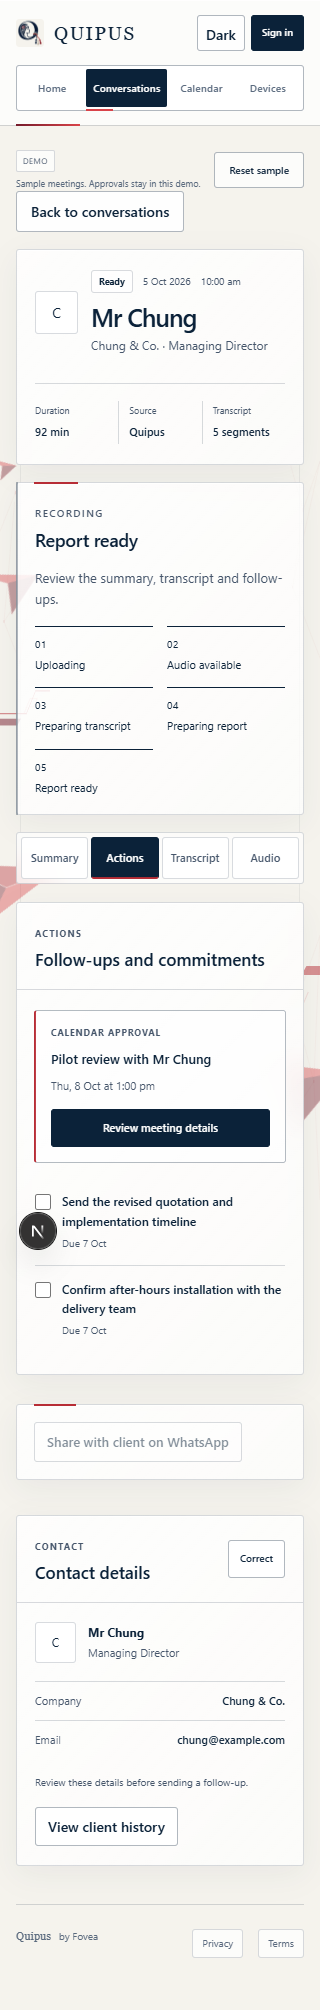
output/ui-review/glass-detail-actions-320.png
