NathanHor22/Quipus/output/ui-review/glass-detail-actions-390.png

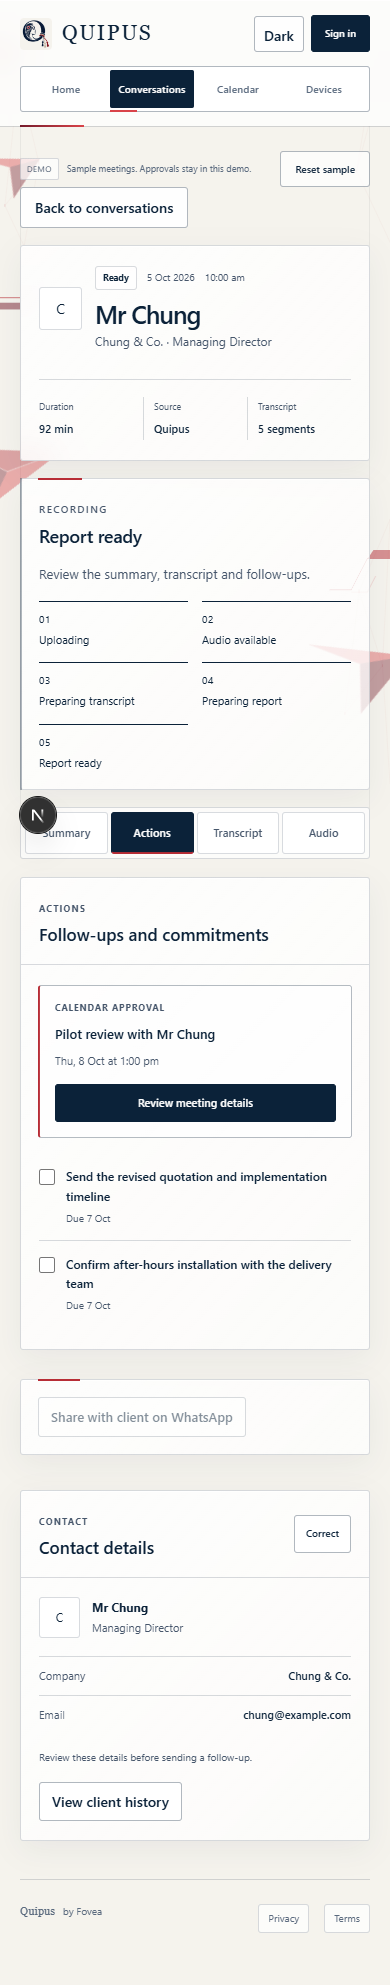
output/ui-review/glass-detail-actions-390.png
