NathanHor22/Quipus/output/ui-review/glass-detail-audio-320.png

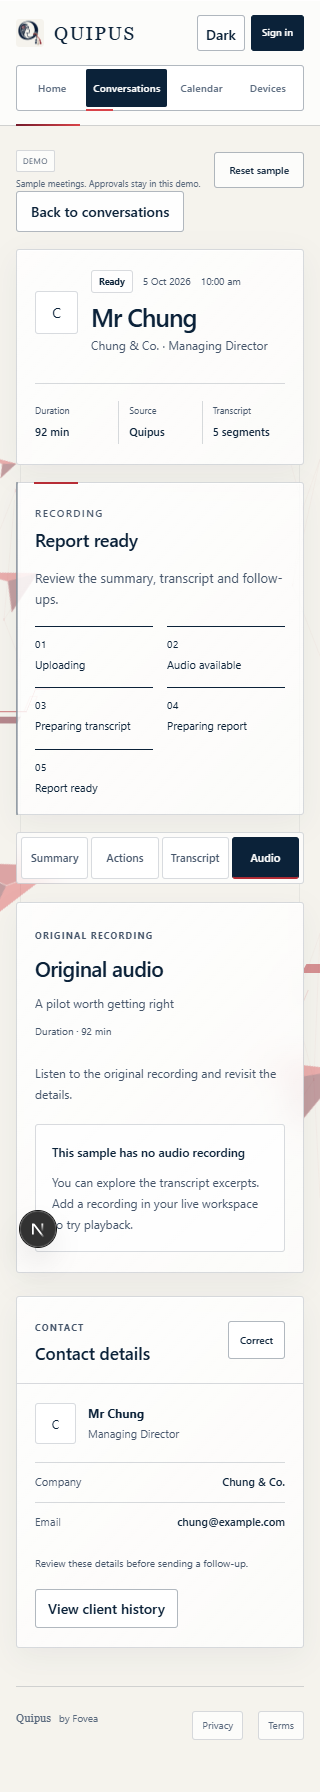
output/ui-review/glass-detail-audio-320.png
