NathanHor22/Quipus/output/ui-review/glass-detail-audio-390.png

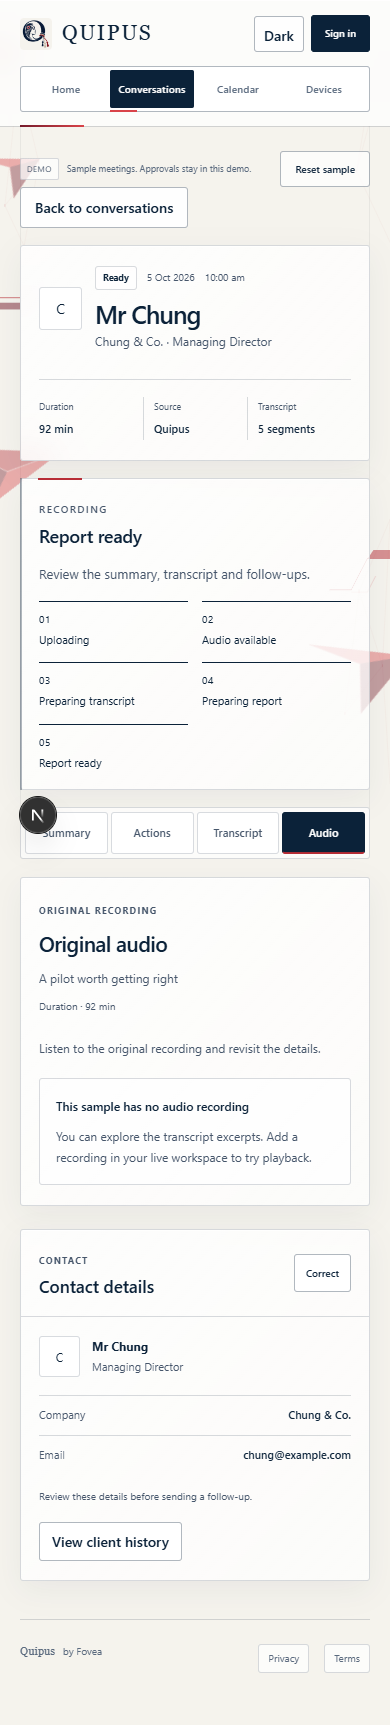
output/ui-review/glass-detail-audio-390.png
