NathanHor22/Quipus/output/ui-review/glass-detail-desktop.png

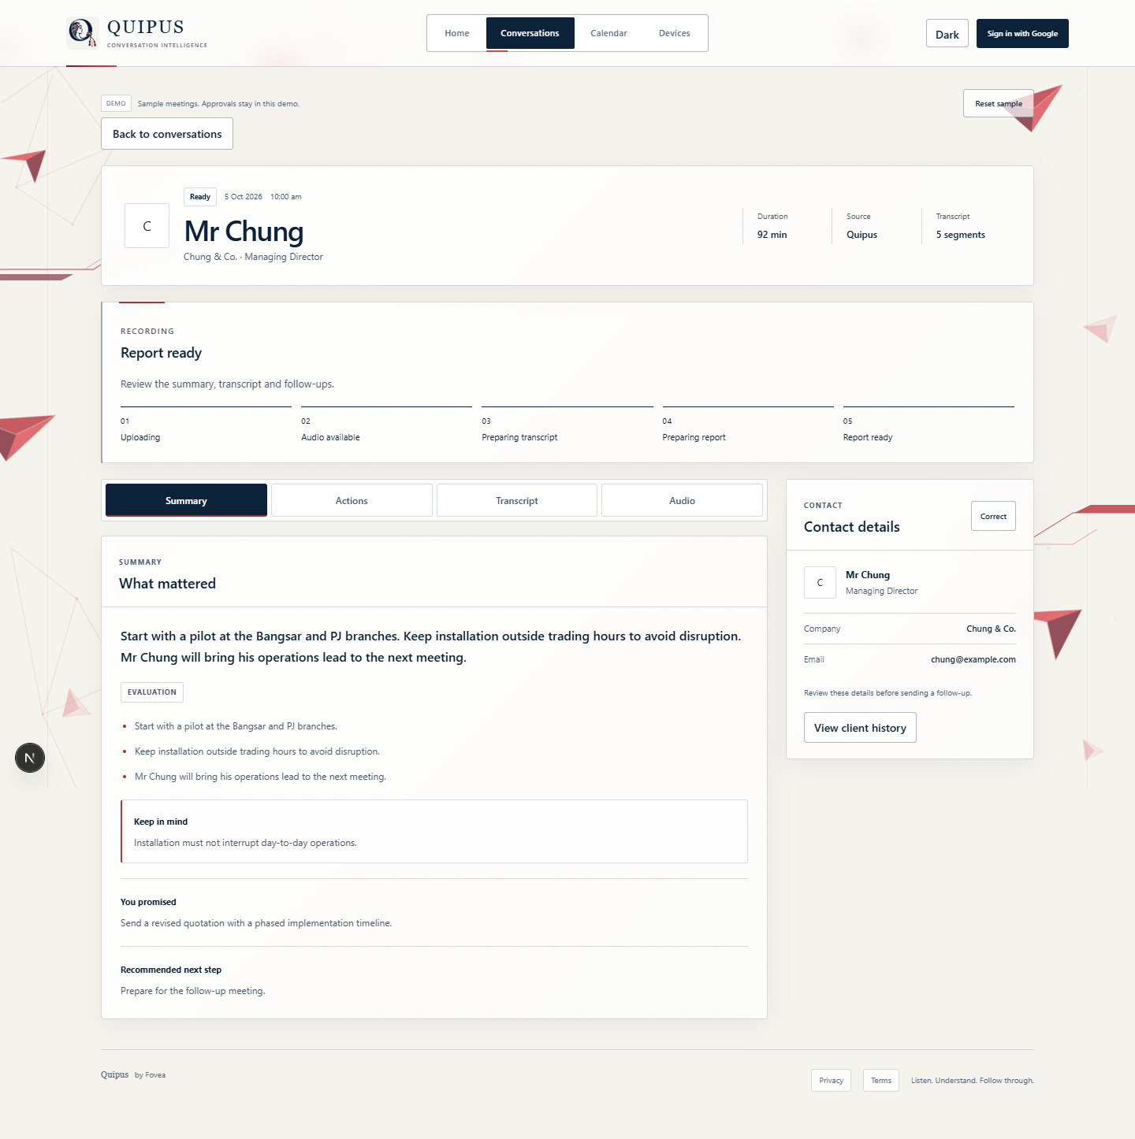
output/ui-review/glass-detail-desktop.png
