NathanHor22/Quipus/output/ui-review/glass-detail-summary-320.png

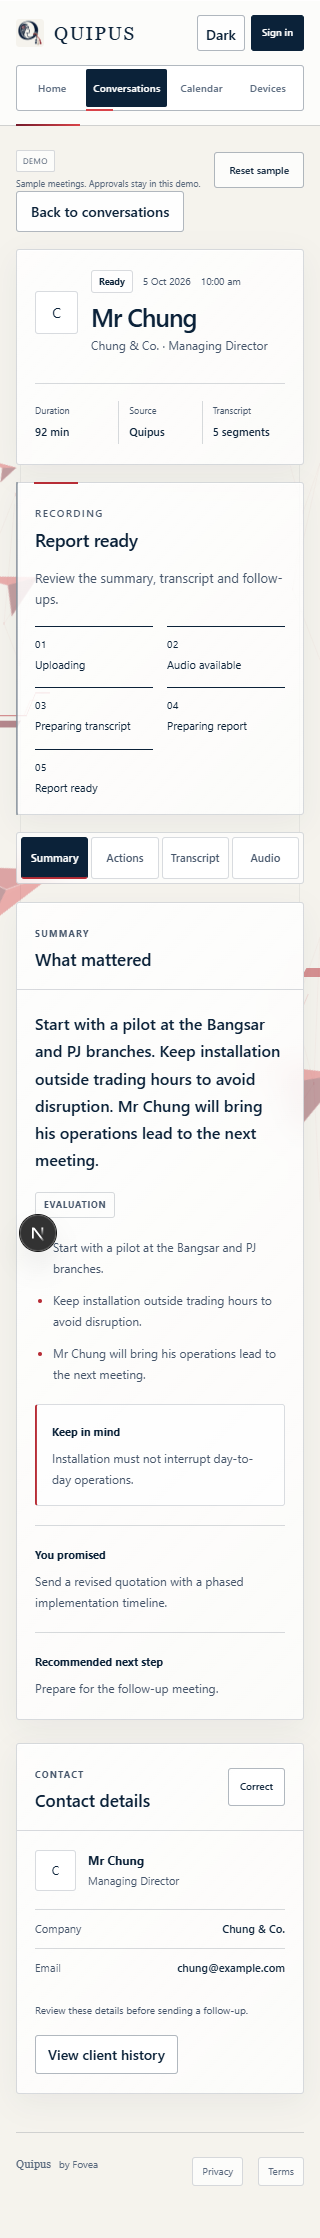
output/ui-review/glass-detail-summary-320.png
