NathanHor22/Quipus/output/ui-review/glass-detail-summary-390.png

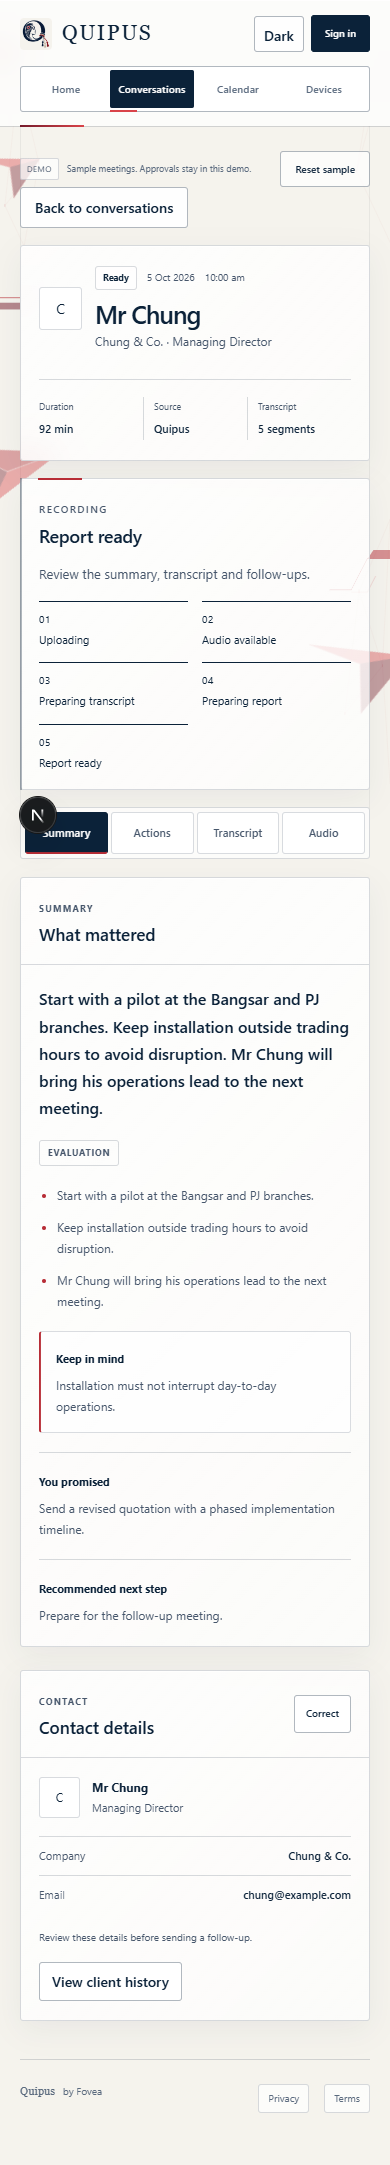
output/ui-review/glass-detail-summary-390.png
