NathanHor22/Quipus/output/ui-review/glass-detail-transcript-320.png

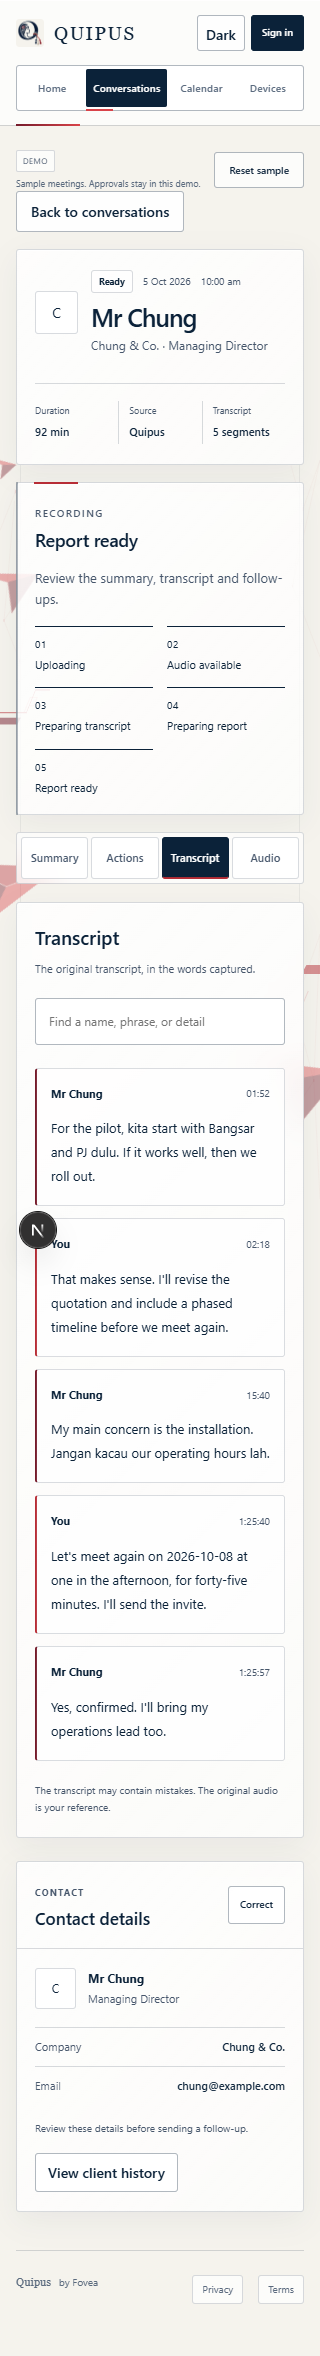
output/ui-review/glass-detail-transcript-320.png
