NathanHor22/Quipus/output/ui-review/glass-detail-transcript-390.png

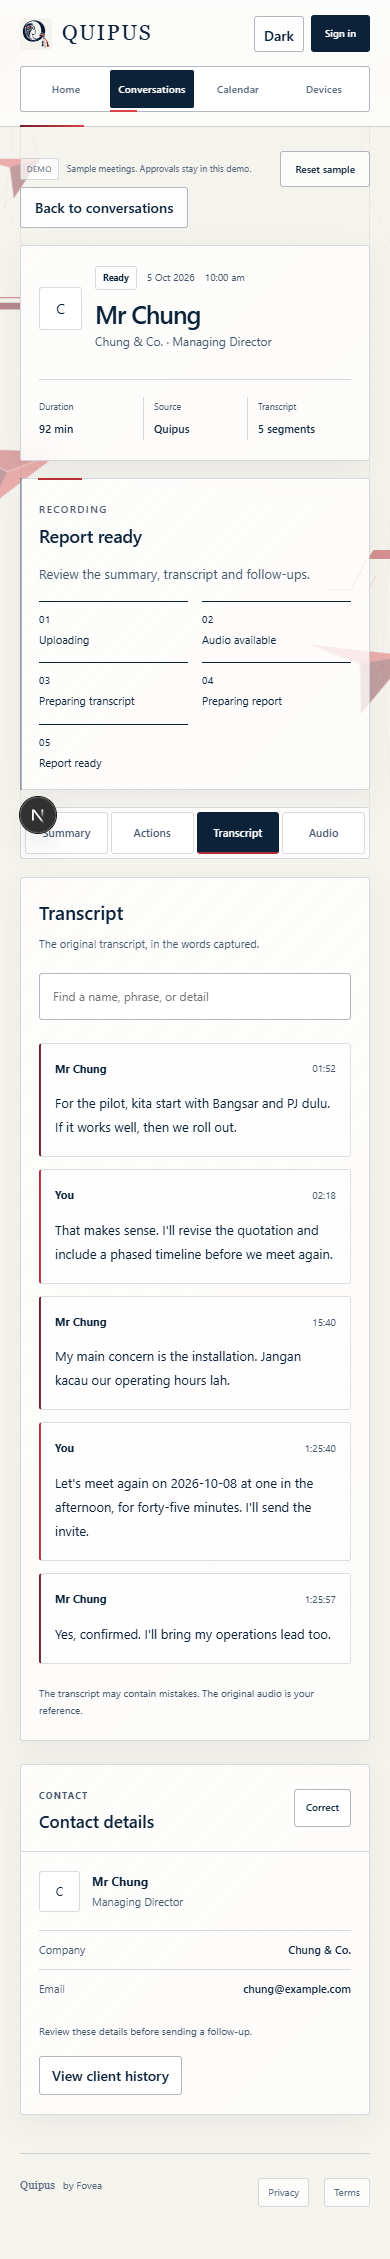
output/ui-review/glass-detail-transcript-390.png
