NathanHor22/Quipus/output/ui-review/glass-devices-320.png

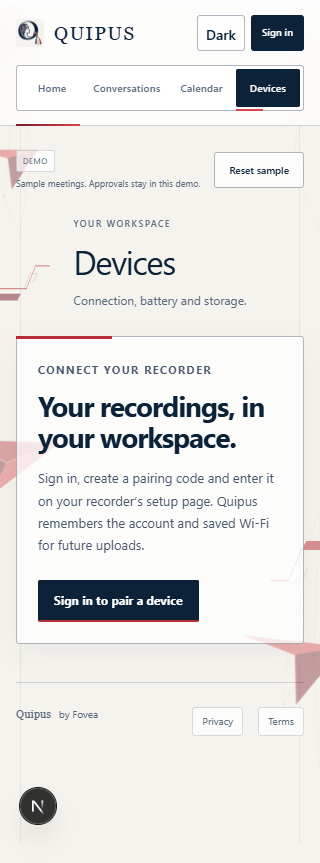
output/ui-review/glass-devices-320.png
