NathanHor22/Quipus/output/ui-review/glass-devices-390.png

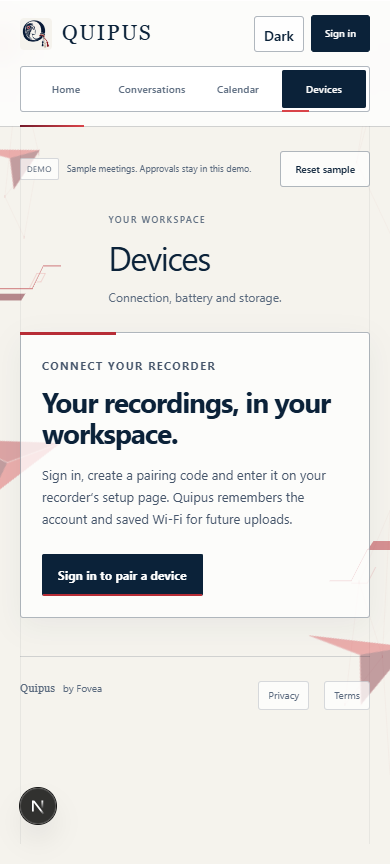
output/ui-review/glass-devices-390.png
