NathanHor22/Quipus/output/ui-review/glass-devices-desktop.png

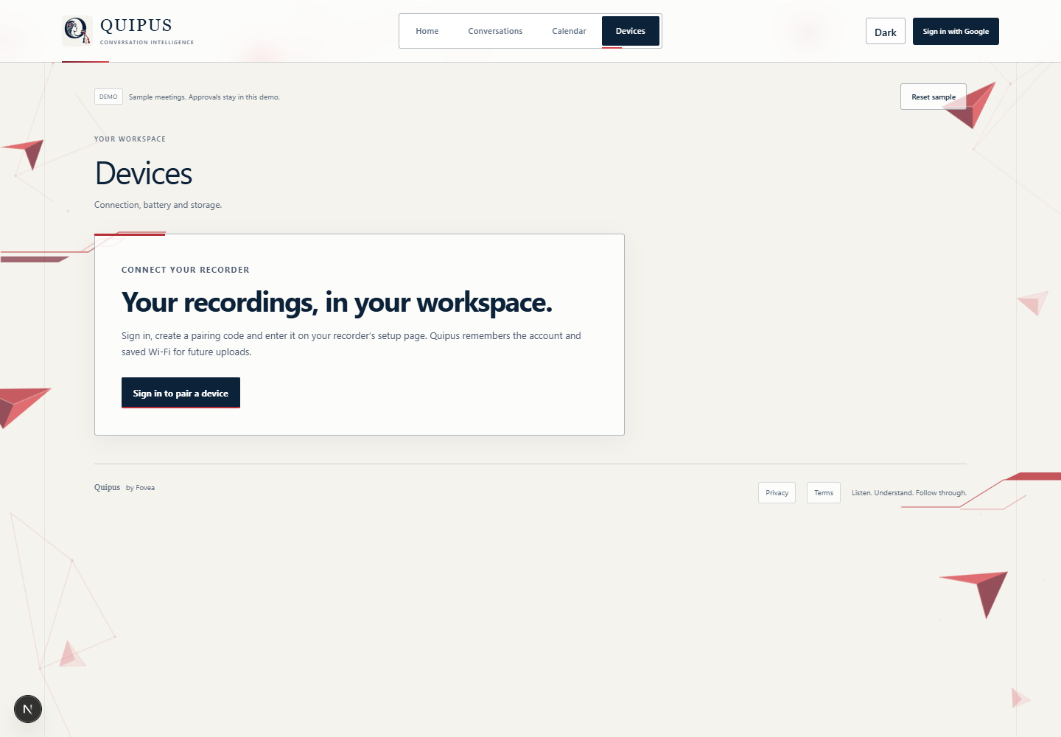
output/ui-review/glass-devices-desktop.png
