NathanHor22/Quipus/output/ui-review/glass-home-320.png

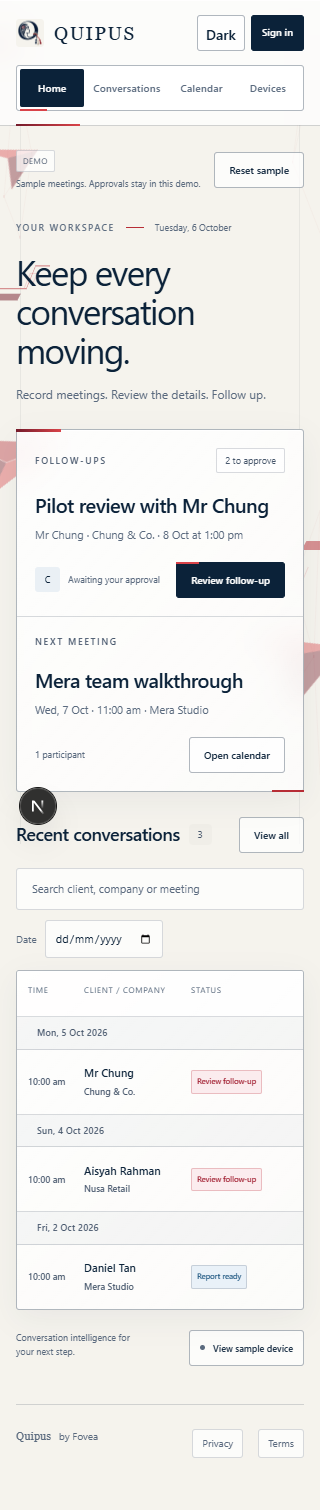
output/ui-review/glass-home-320.png
