NathanHor22/Quipus/output/ui-review/glass-home-390.png

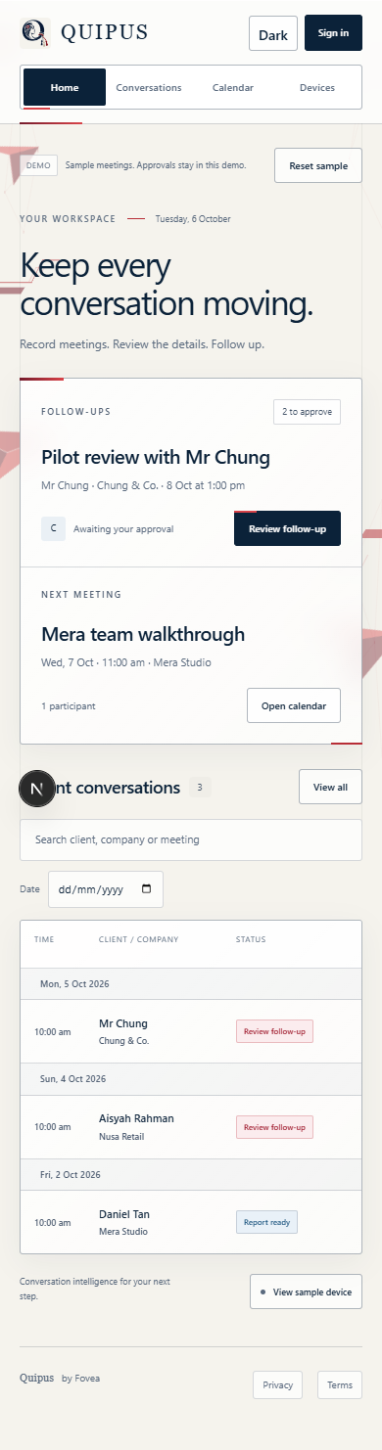
output/ui-review/glass-home-390.png
