NathanHor22/Quipus/output/ui-review/glass-home-dark.png

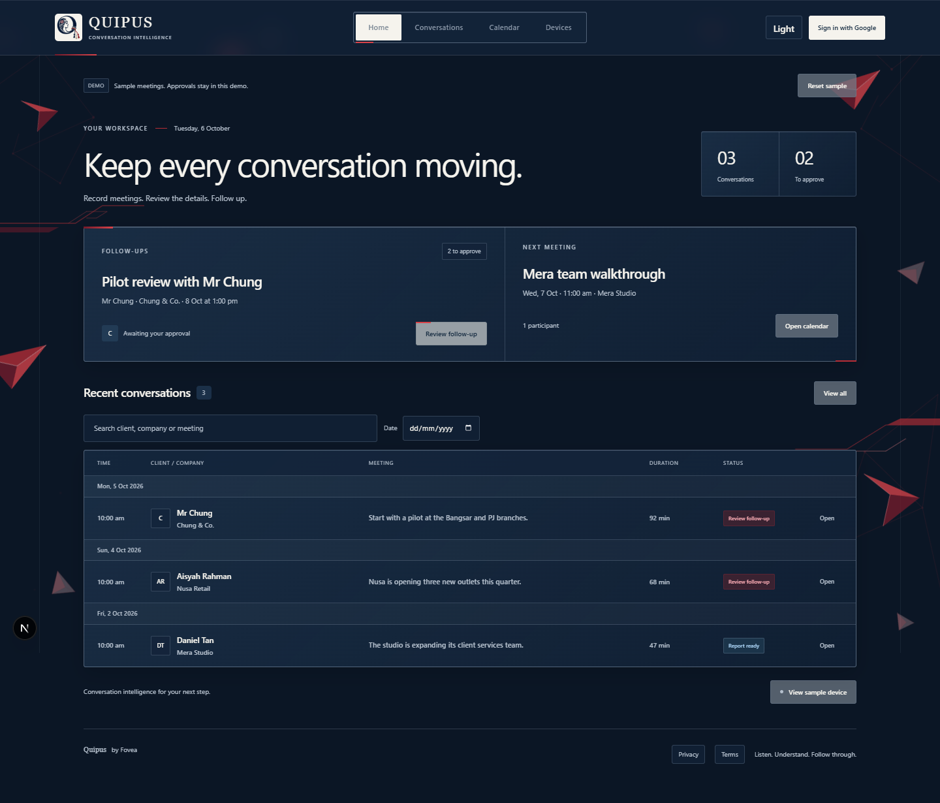
output/ui-review/glass-home-dark.png
