NathanHor22/Quipus/output/ui-review/glass-home-desktop.png

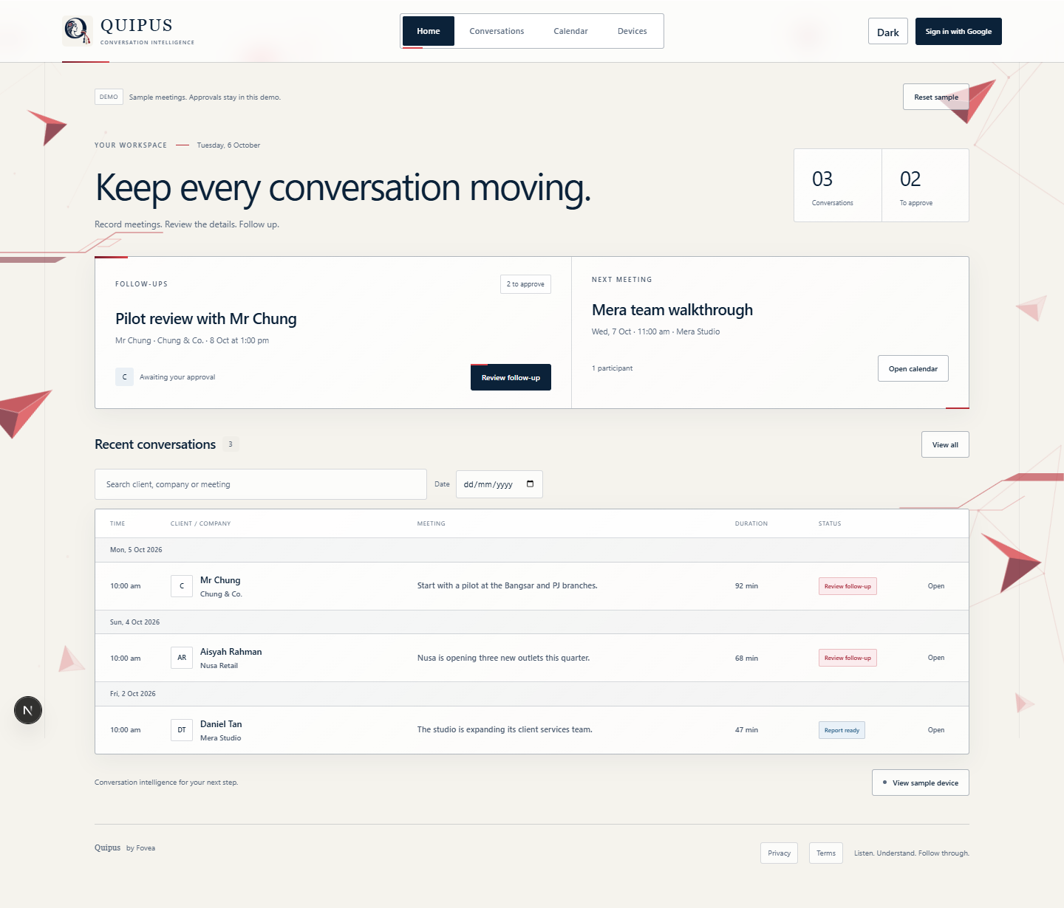
output/ui-review/glass-home-desktop.png
