NathanHor22/Quipus/output/ui-review/glass-login-320.png

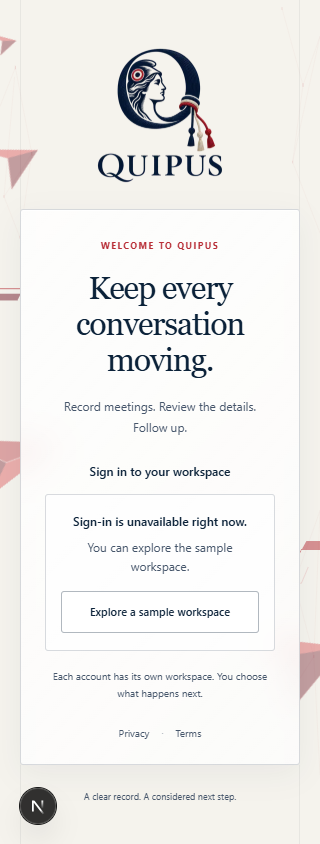
output/ui-review/glass-login-320.png
