NathanHor22/Quipus/output/ui-review/glass-login-390.png

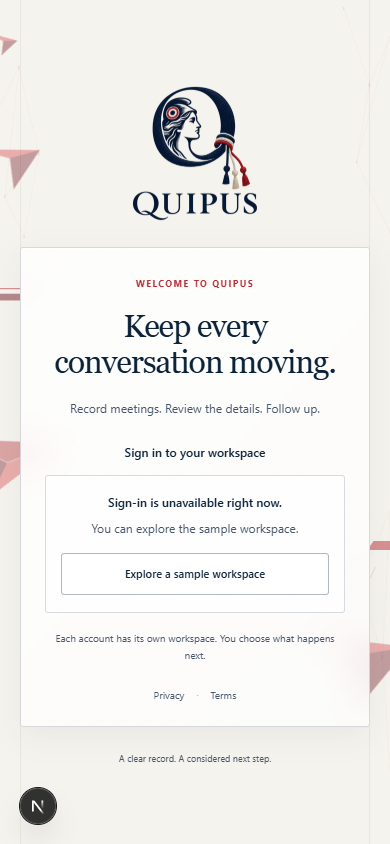
output/ui-review/glass-login-390.png
