NathanHor22/Quipus/output/ui-review/glass-login-desktop.png

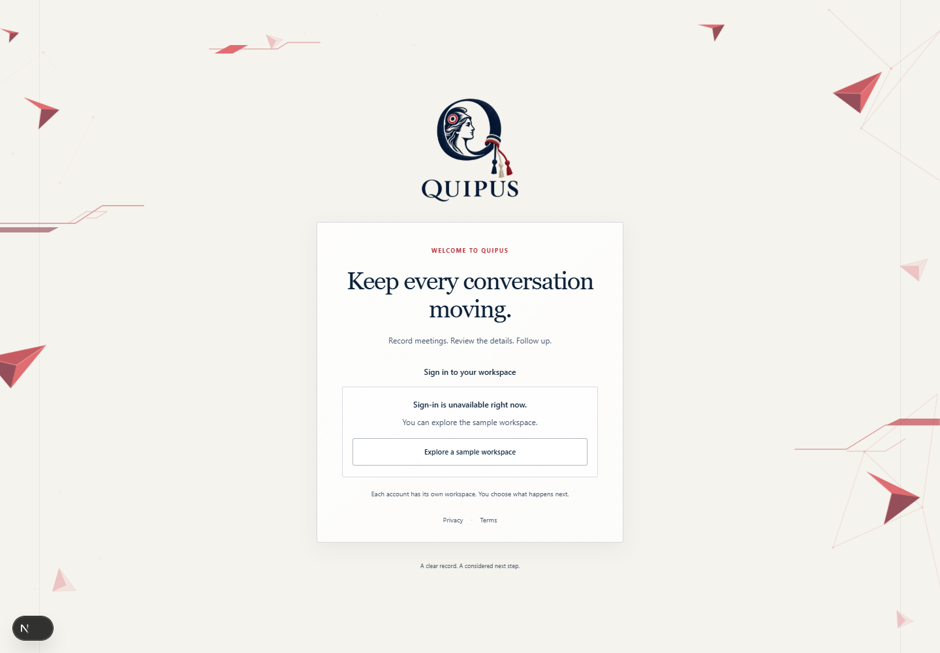
output/ui-review/glass-login-desktop.png
