NathanHor22/Quipus/output/ui-review/glass-popup-actions.png

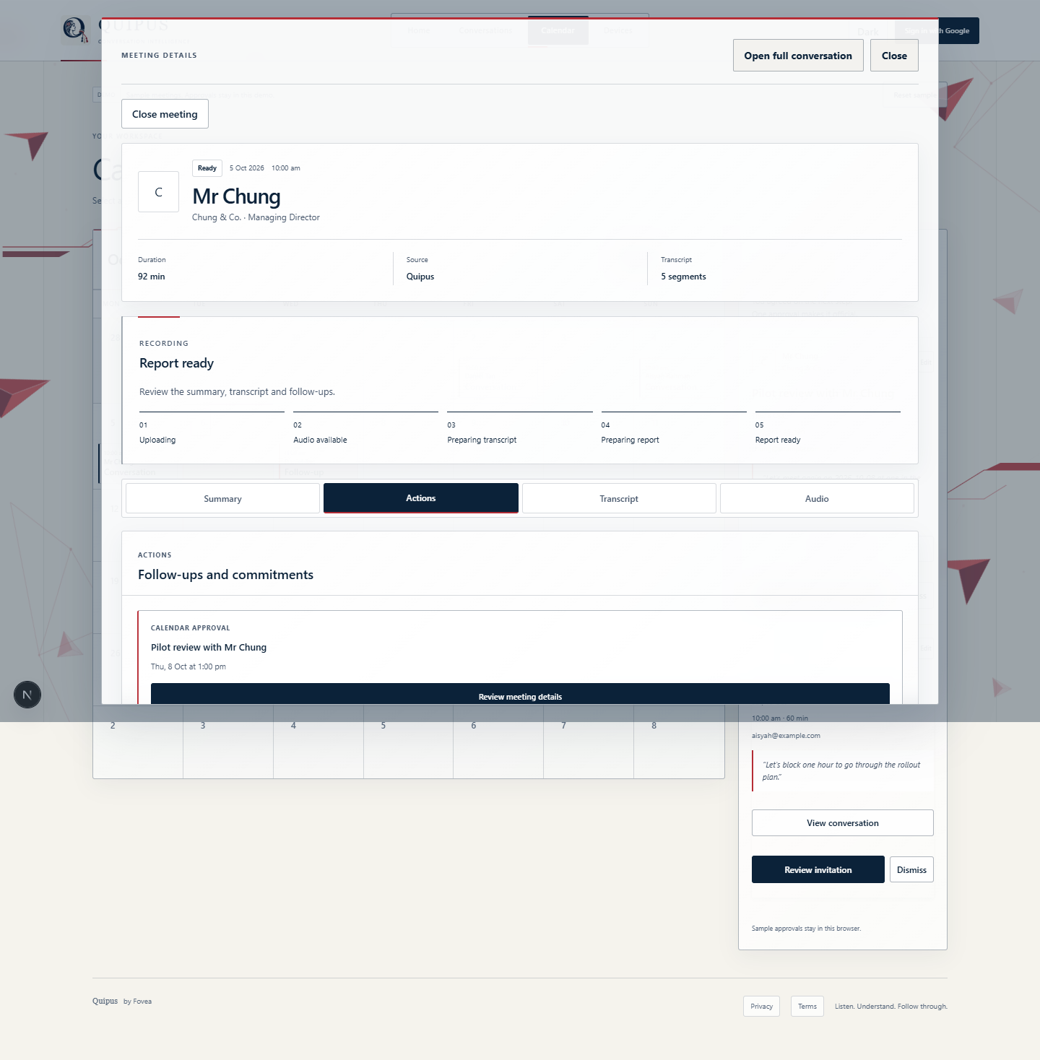
output/ui-review/glass-popup-actions.png
