NathanHor22/Quipus/output/ui-review/glass-popup-audio.png

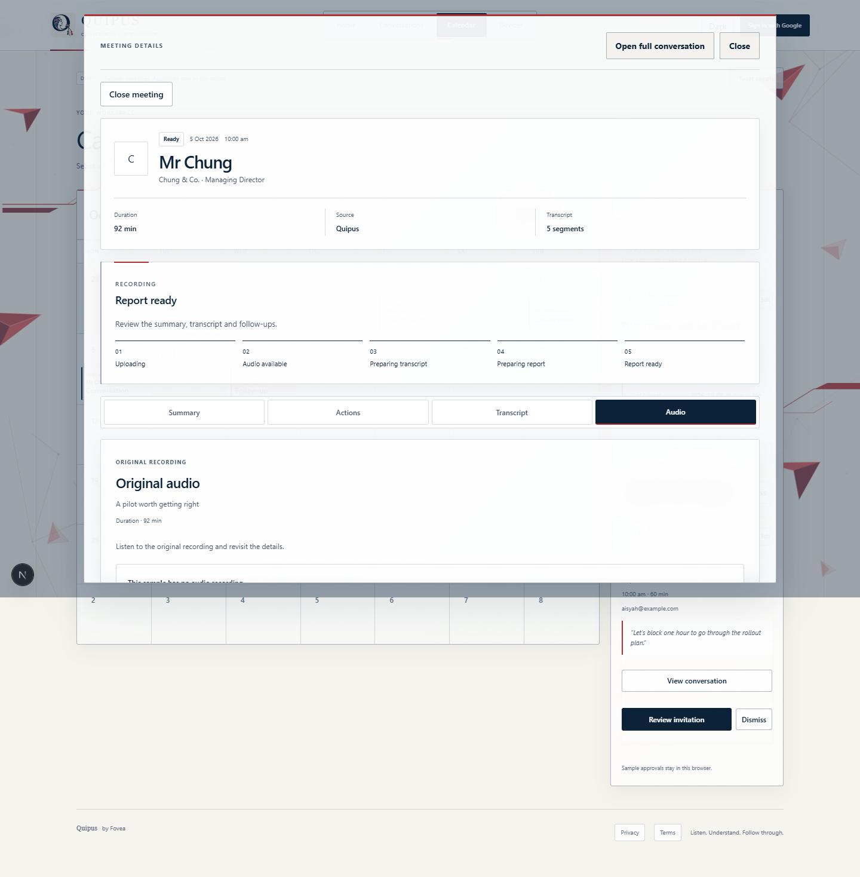
output/ui-review/glass-popup-audio.png
