NathanHor22/Quipus/output/ui-review/glass-popup-summary.png

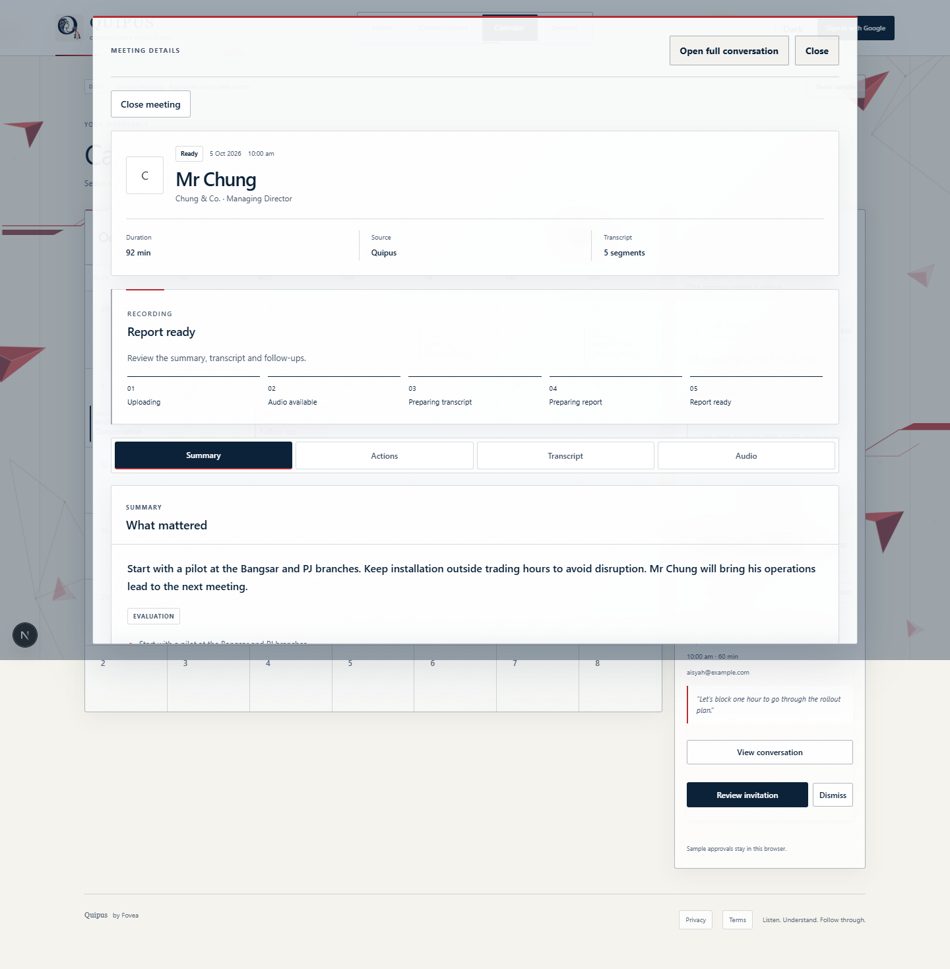
output/ui-review/glass-popup-summary.png
