NathanHor22/Quipus/output/ui-review/glass-reduced-motion.png

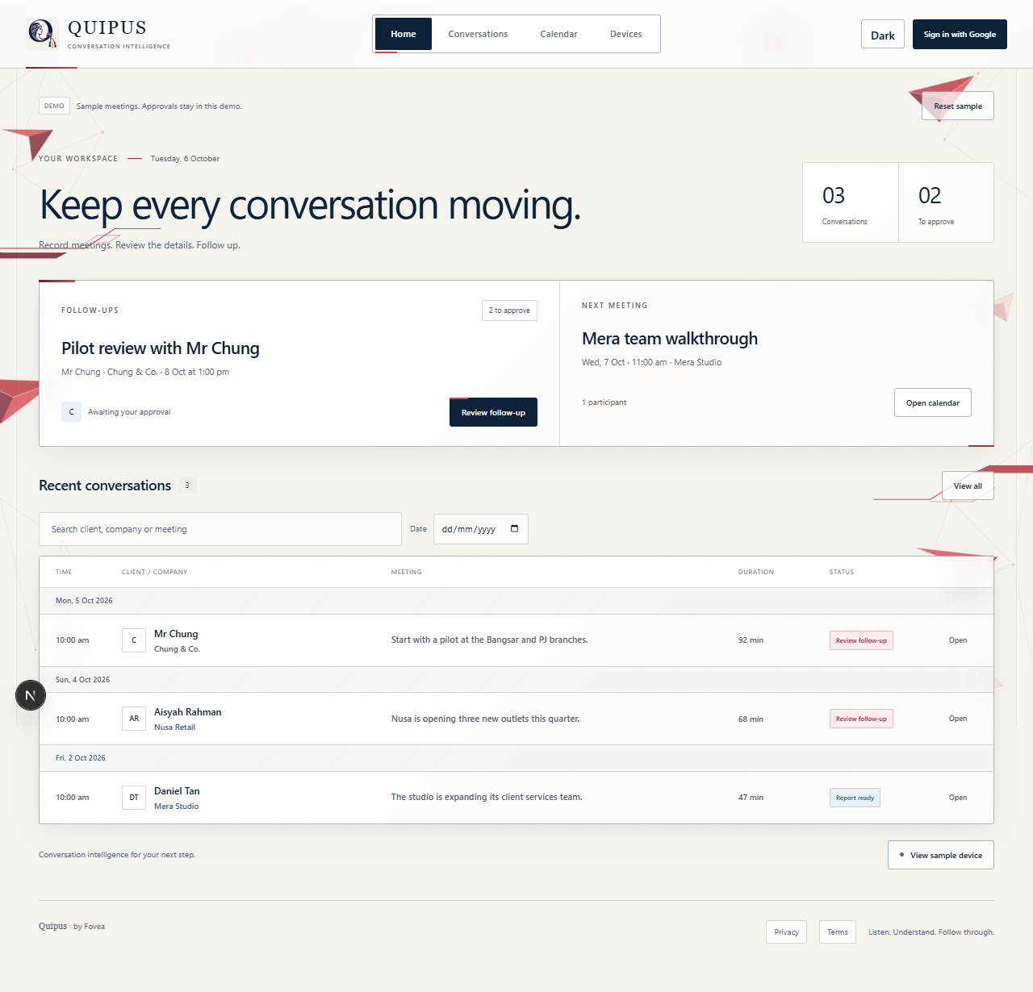
output/ui-review/glass-reduced-motion.png
