NathanHor22/Quipus/output/ui-review/glass-settings-desktop.png

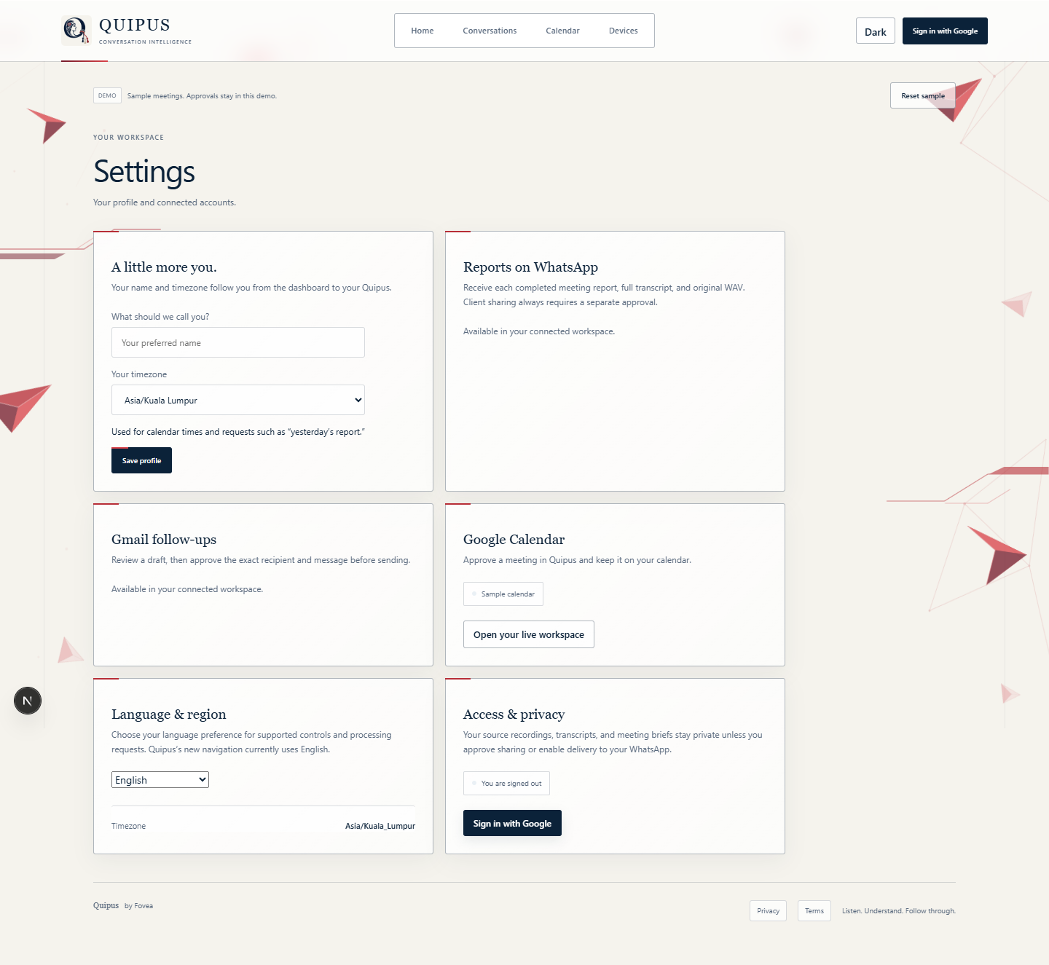
output/ui-review/glass-settings-desktop.png
