NathanHor22/Quipus/output/ui-review/header-review.png

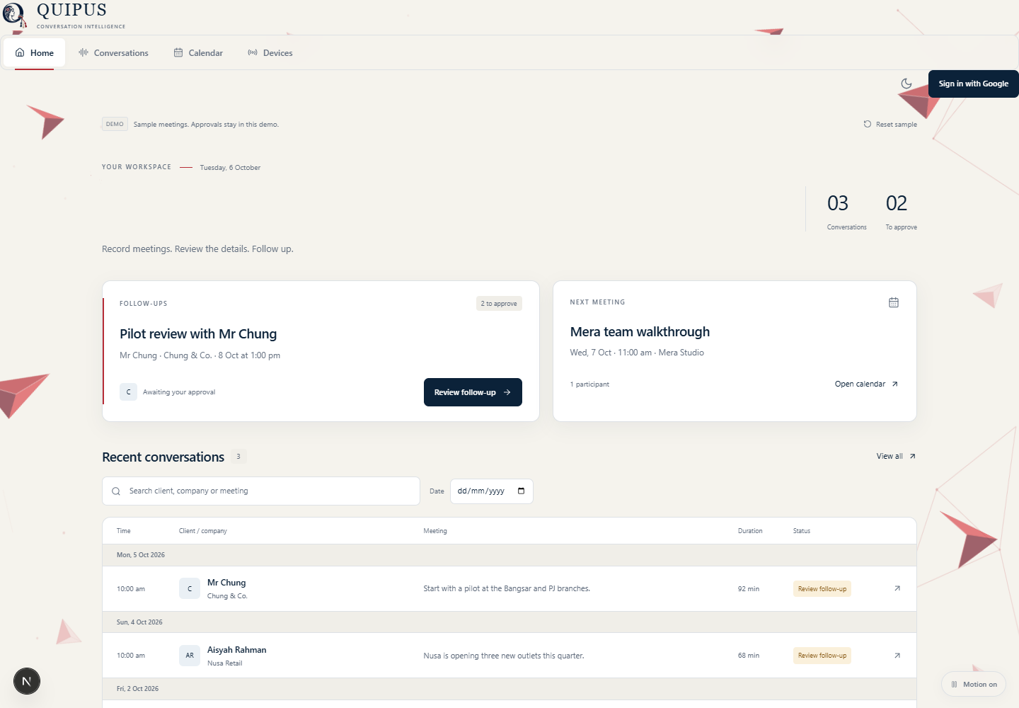
output/ui-review/header-review.png
