NathanHor22/Quipus/output/ui-review/home-dark-desktop.png

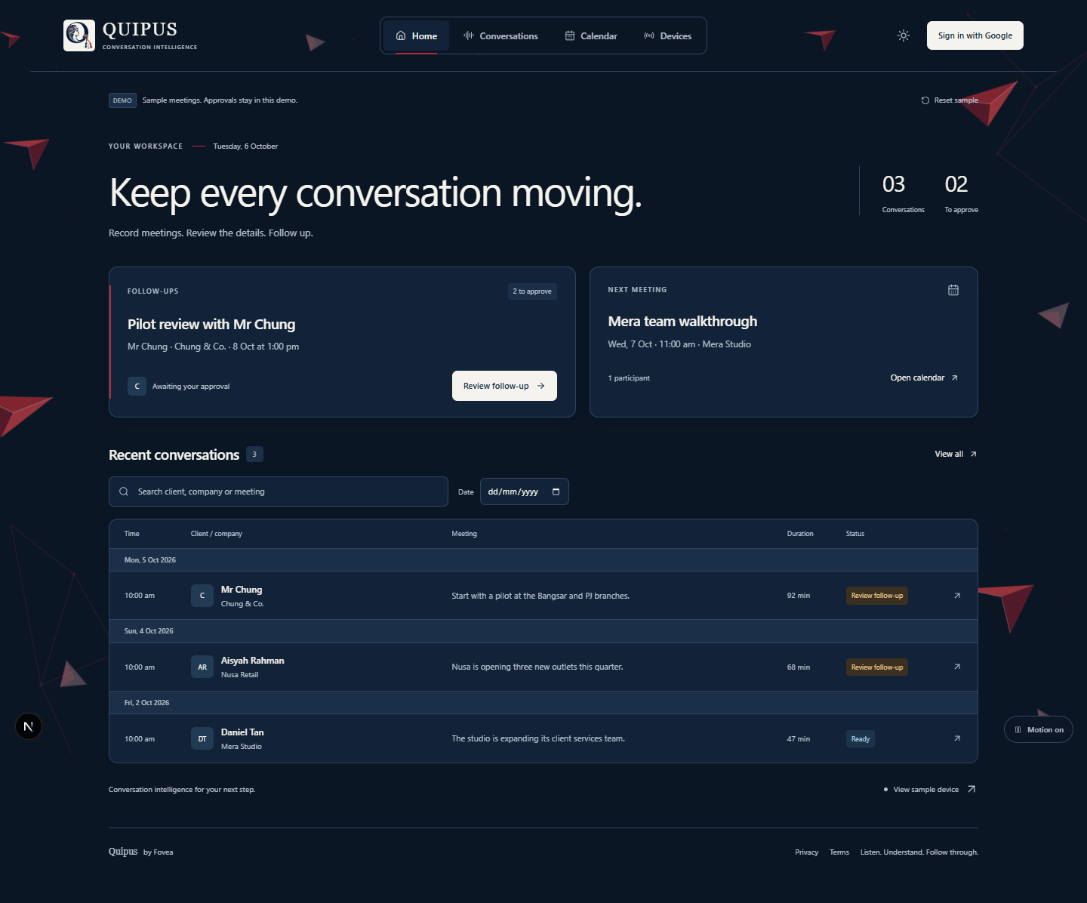
output/ui-review/home-dark-desktop.png
