NathanHor22/Quipus/output/ui-review/home-desktop.png

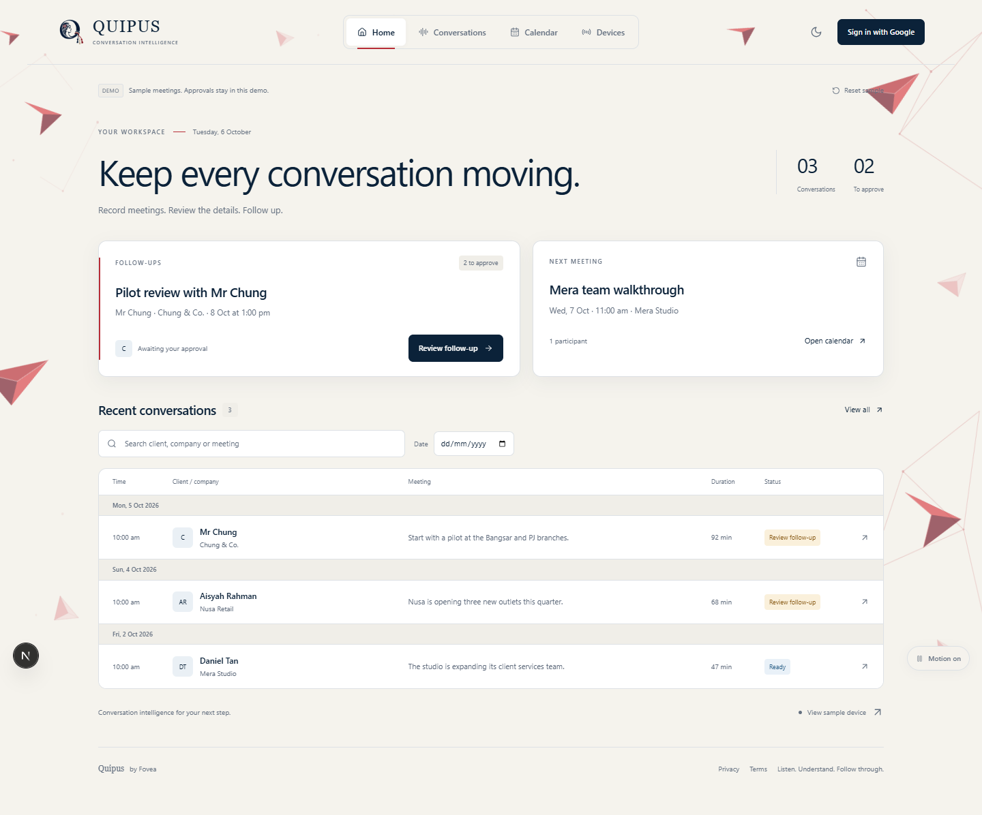
output/ui-review/home-desktop.png
