NathanHor22/Quipus/output/ui-review/home-heading-reveal.png

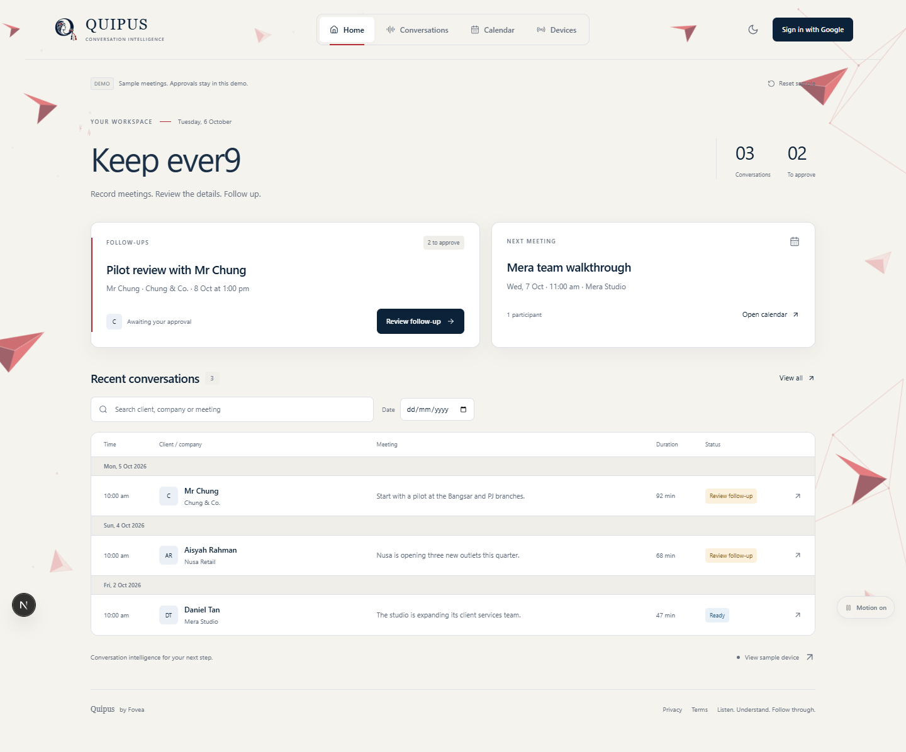
output/ui-review/home-heading-reveal.png
