NathanHor22/Quipus/output/ui-review/home-mobile-320.png

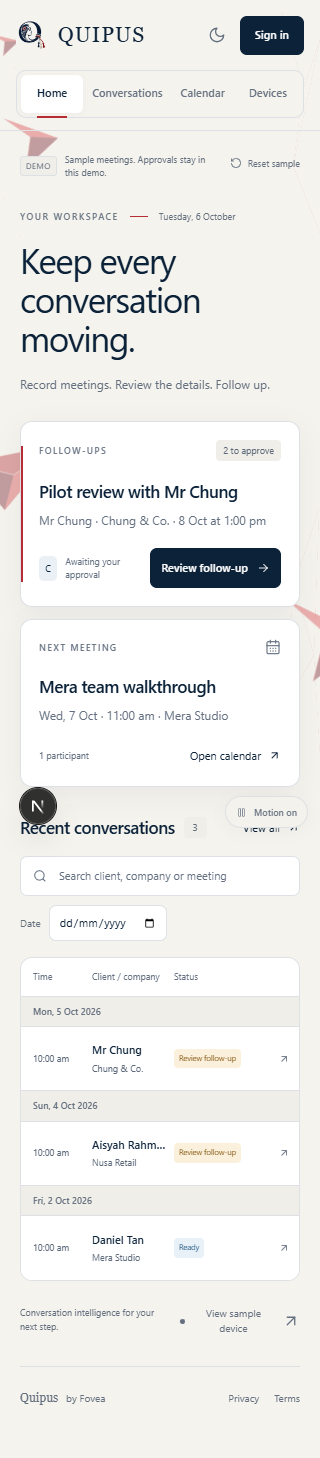
output/ui-review/home-mobile-320.png
