NathanHor22/Quipus/output/ui-review/home-mobile-390.png

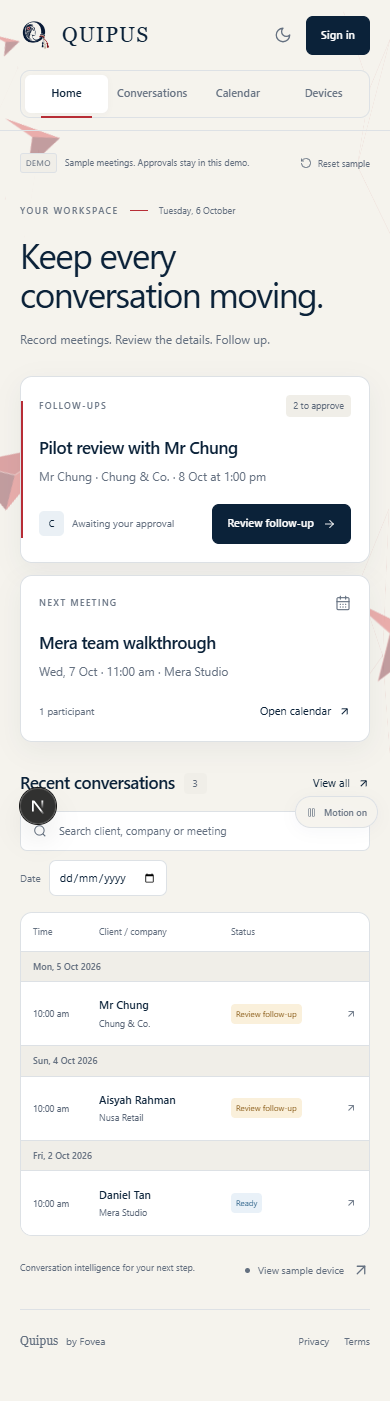
output/ui-review/home-mobile-390.png
