NathanHor22/Quipus/output/ui-review/home-reduced-motion.png

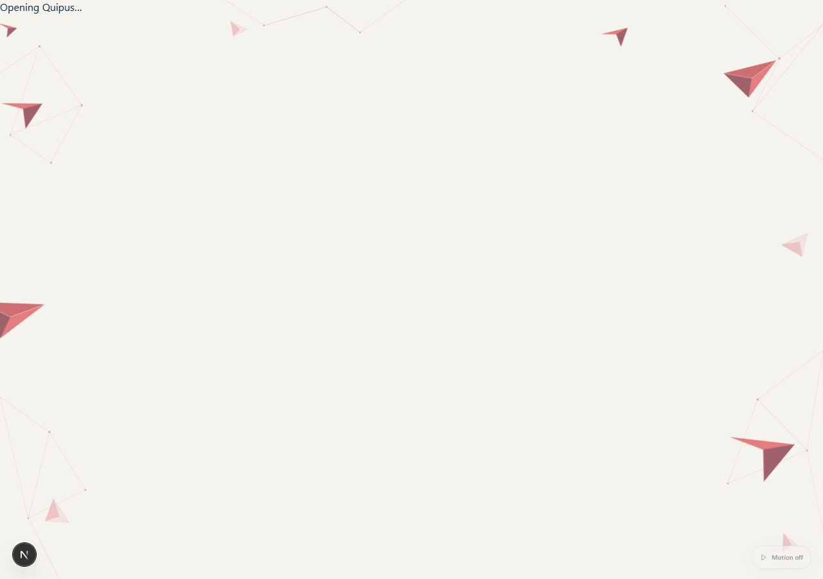
output/ui-review/home-reduced-motion.png
