NathanHor22/Quipus/output/ui-review/login-dark-desktop.png

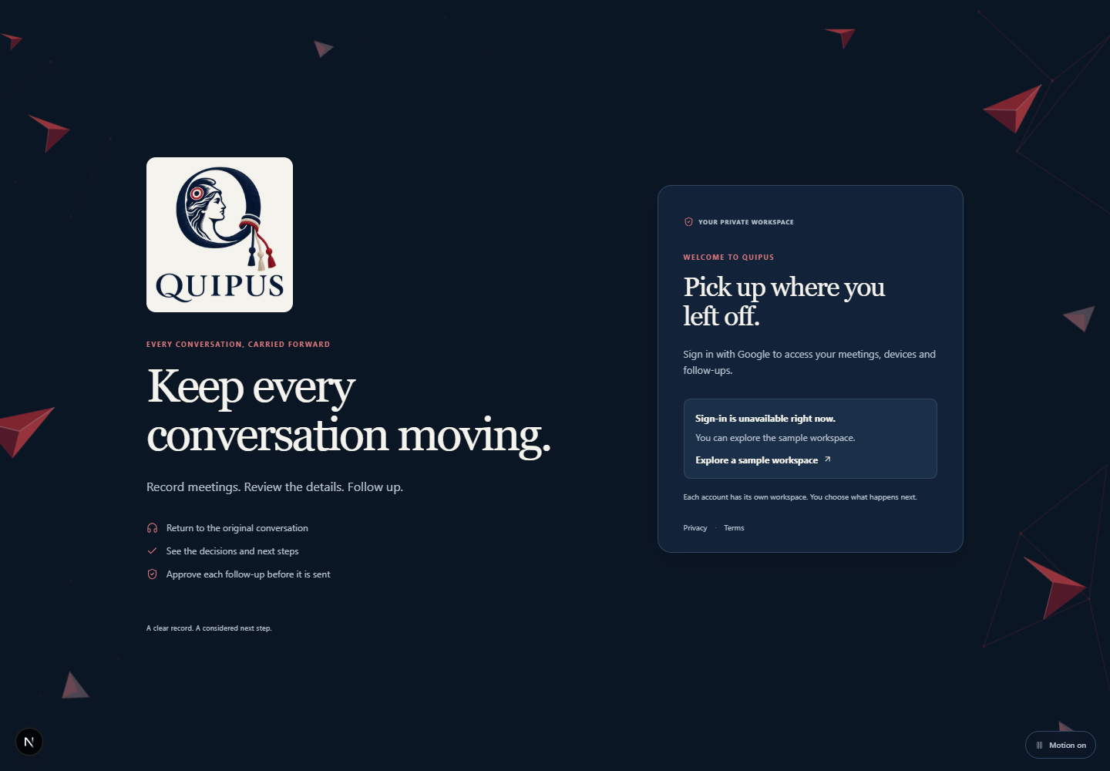
output/ui-review/login-dark-desktop.png
