NathanHor22/Quipus/output/ui-review/login-desktop.png

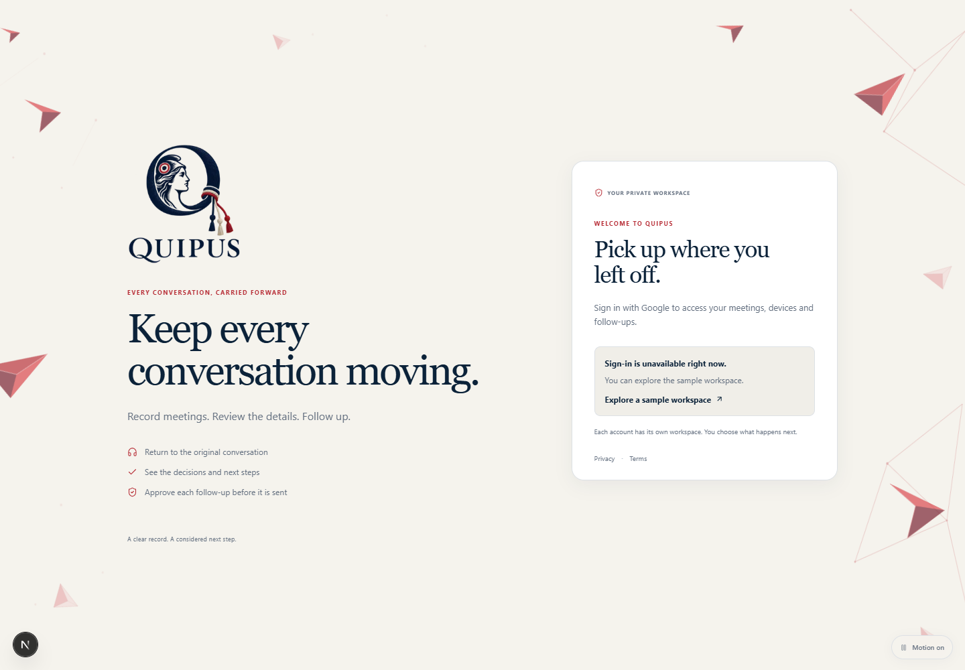
output/ui-review/login-desktop.png
