NathanHor22/Quipus/output/ui-review/login-mobile-320.png

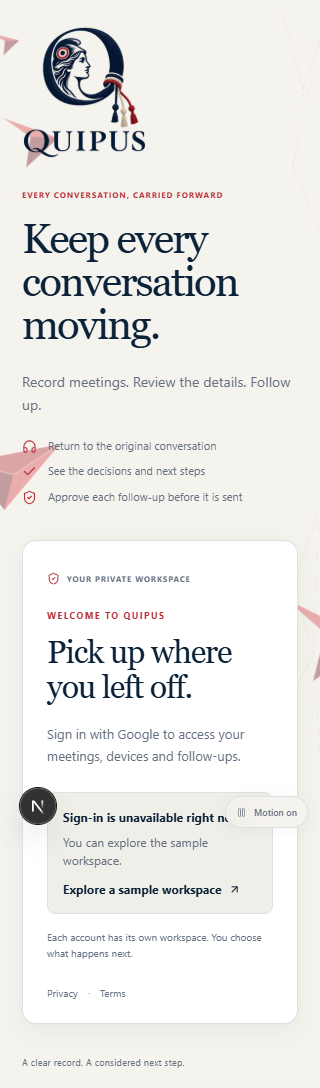
output/ui-review/login-mobile-320.png
