NathanHor22/Quipus/output/ui-review/login-mobile-390.png

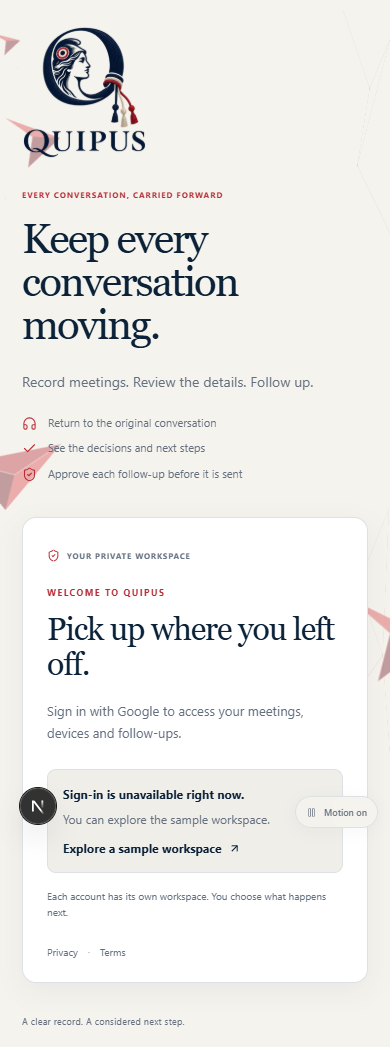
output/ui-review/login-mobile-390.png
