NathanHor22/Quipus/output/ui-review/owned-visual/client-dark-mobile-320.png

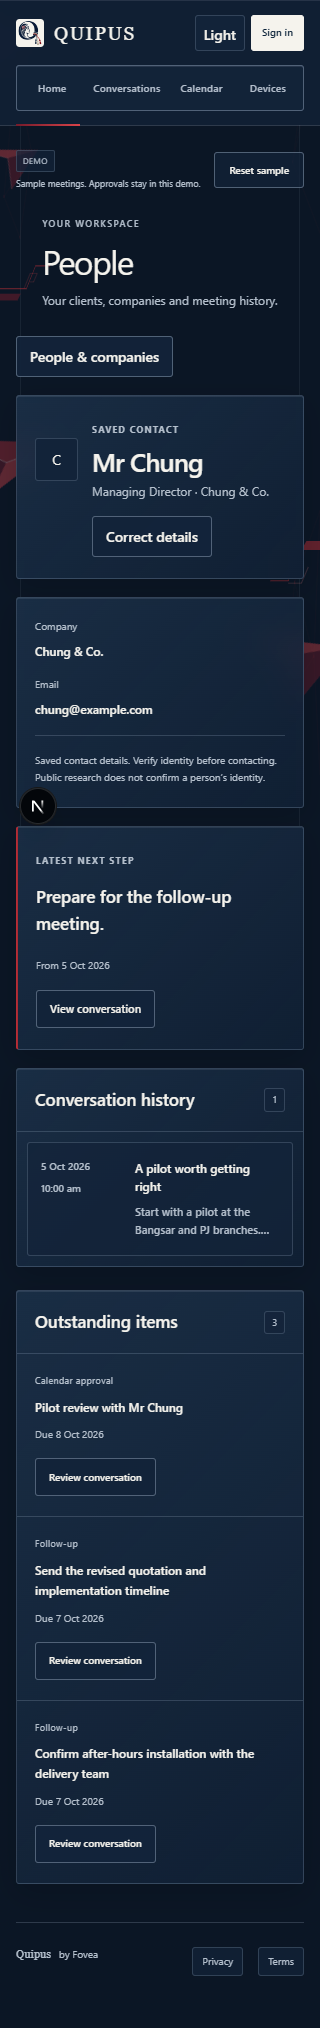
output/ui-review/owned-visual/client-dark-mobile-320.png
