NathanHor22/Quipus/output/ui-review/owned-visual/client-desktop.png

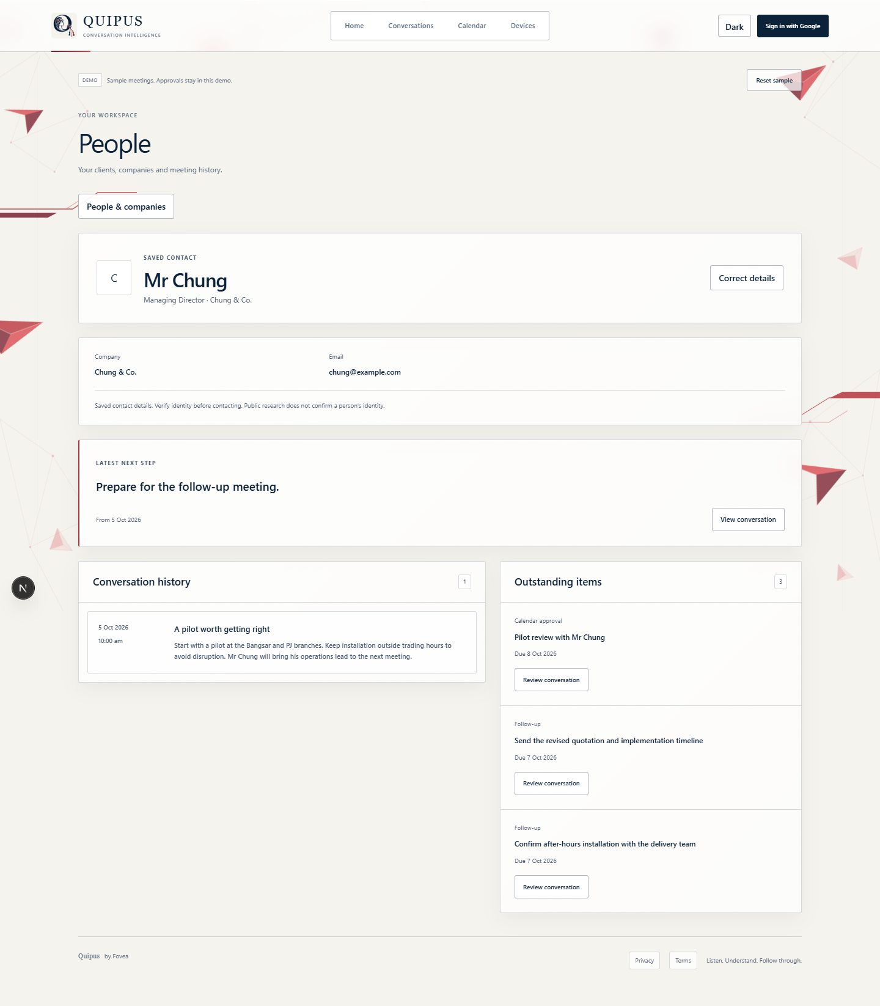
output/ui-review/owned-visual/client-desktop.png
