NathanHor22/Quipus/output/ui-review/owned-visual/client-mobile-320.png

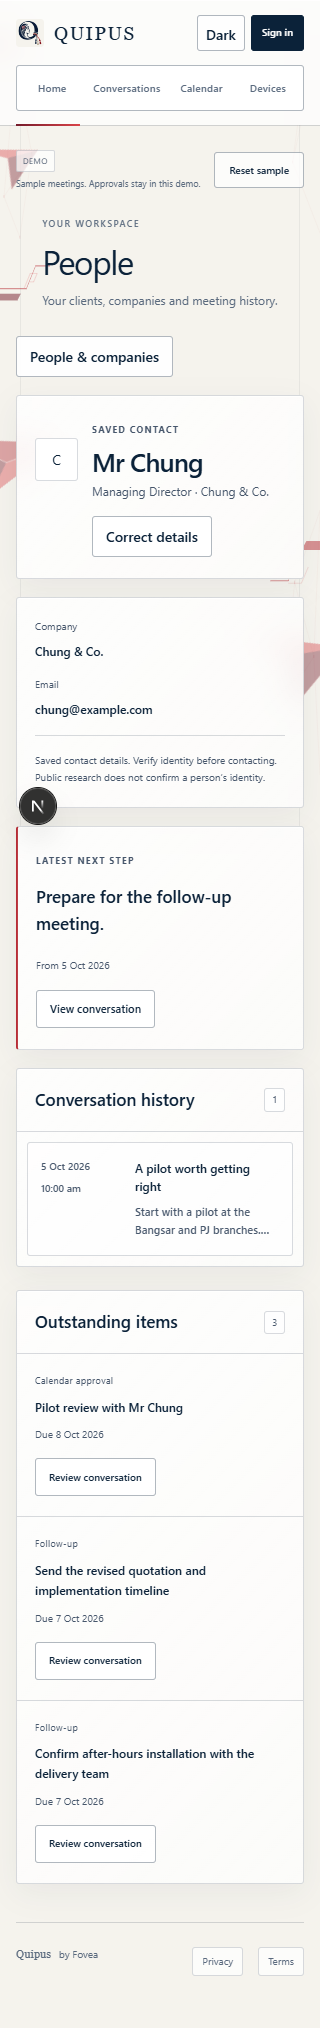
output/ui-review/owned-visual/client-mobile-320.png
