NathanHor22/Quipus/output/ui-review/owned-visual/detail-desktop.png

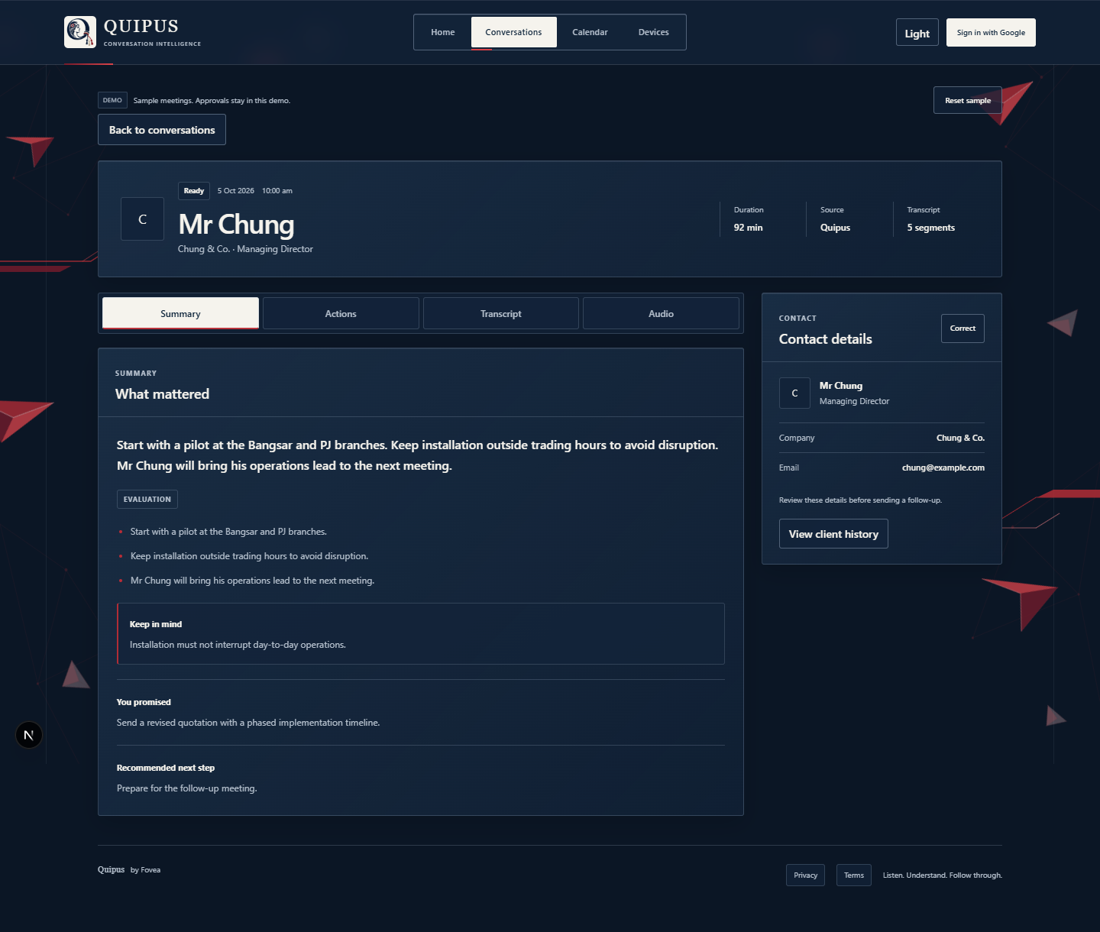
output/ui-review/owned-visual/detail-desktop.png
