NathanHor22/Quipus/output/ui-review/owned-visual/login-dark.png

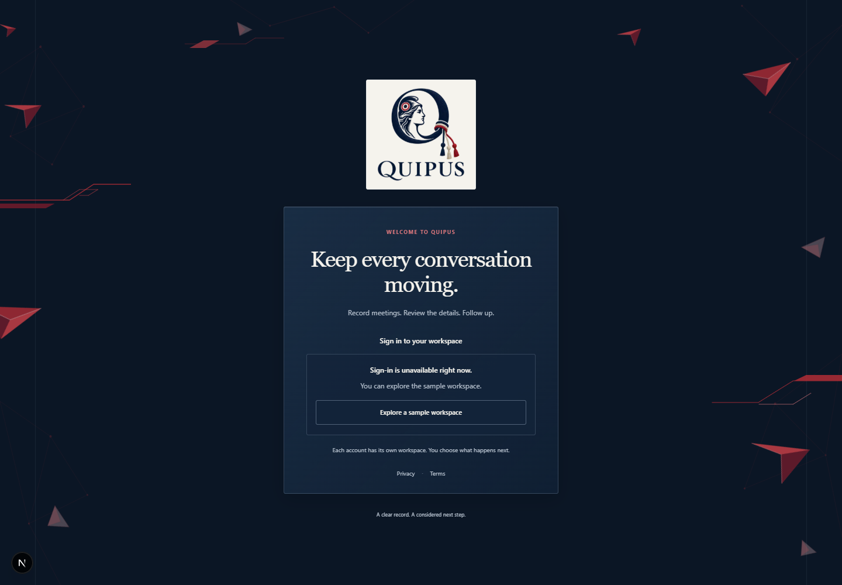
output/ui-review/owned-visual/login-dark.png
