NathanHor22/Quipus/output/ui-review/owned-visual/transcript-dark.png

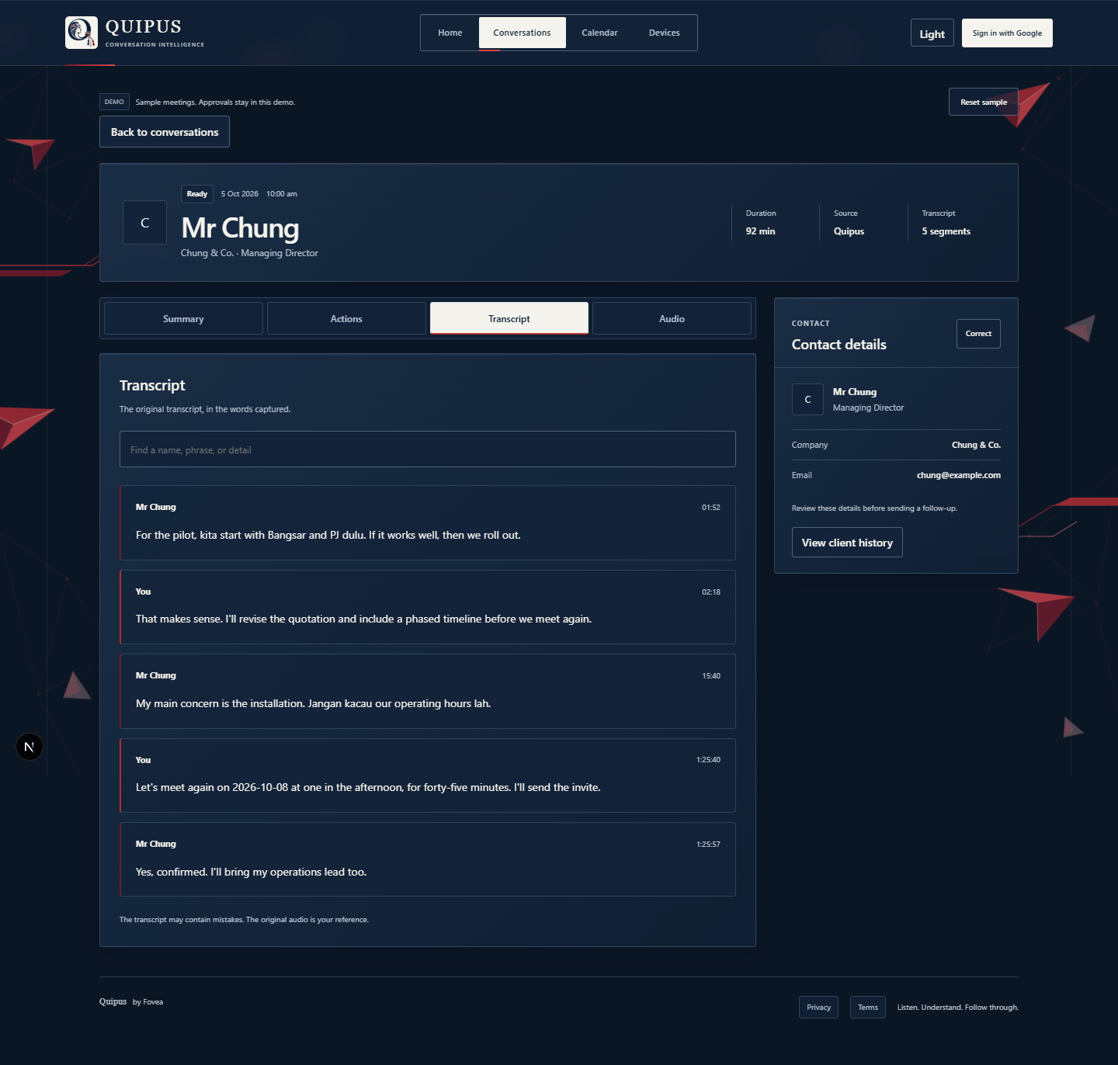
output/ui-review/owned-visual/transcript-dark.png
