NathanHor22/Quipus/output/ui-review/production-detail-summary-desktop.png

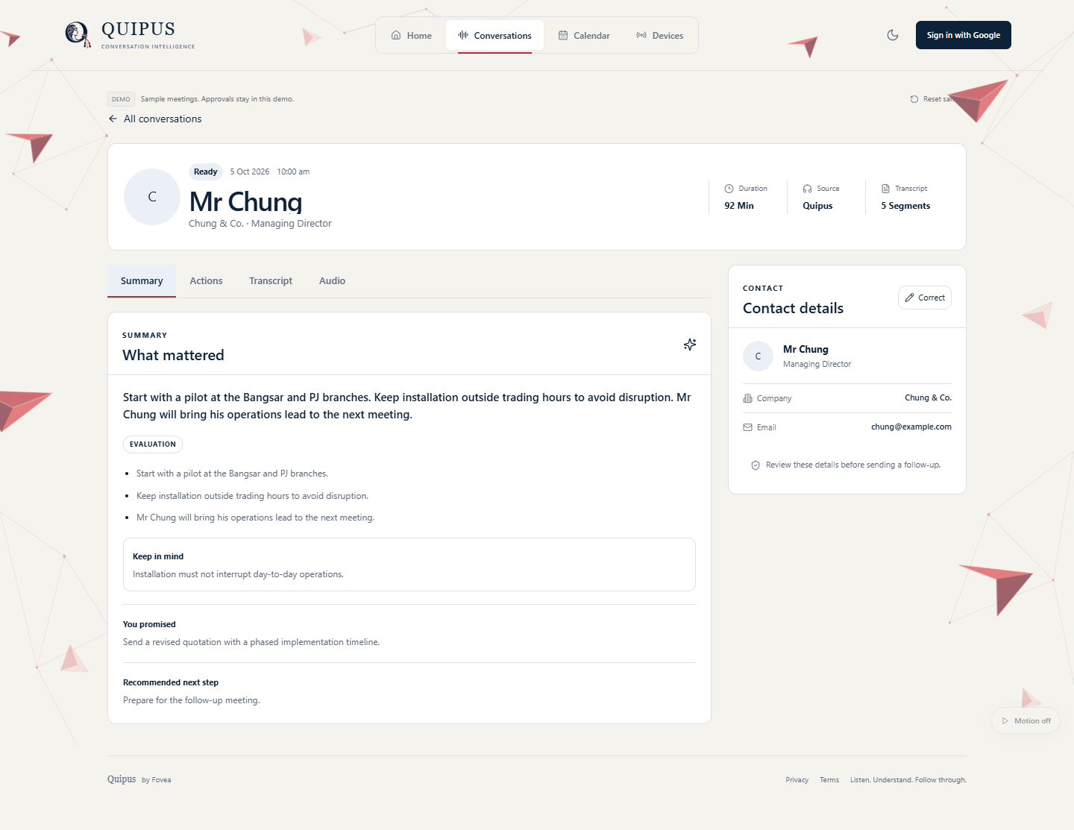
output/ui-review/production-detail-summary-desktop.png
