NathanHor22/Quipus/output/ui-review/production-detail-transcript-desktop.png

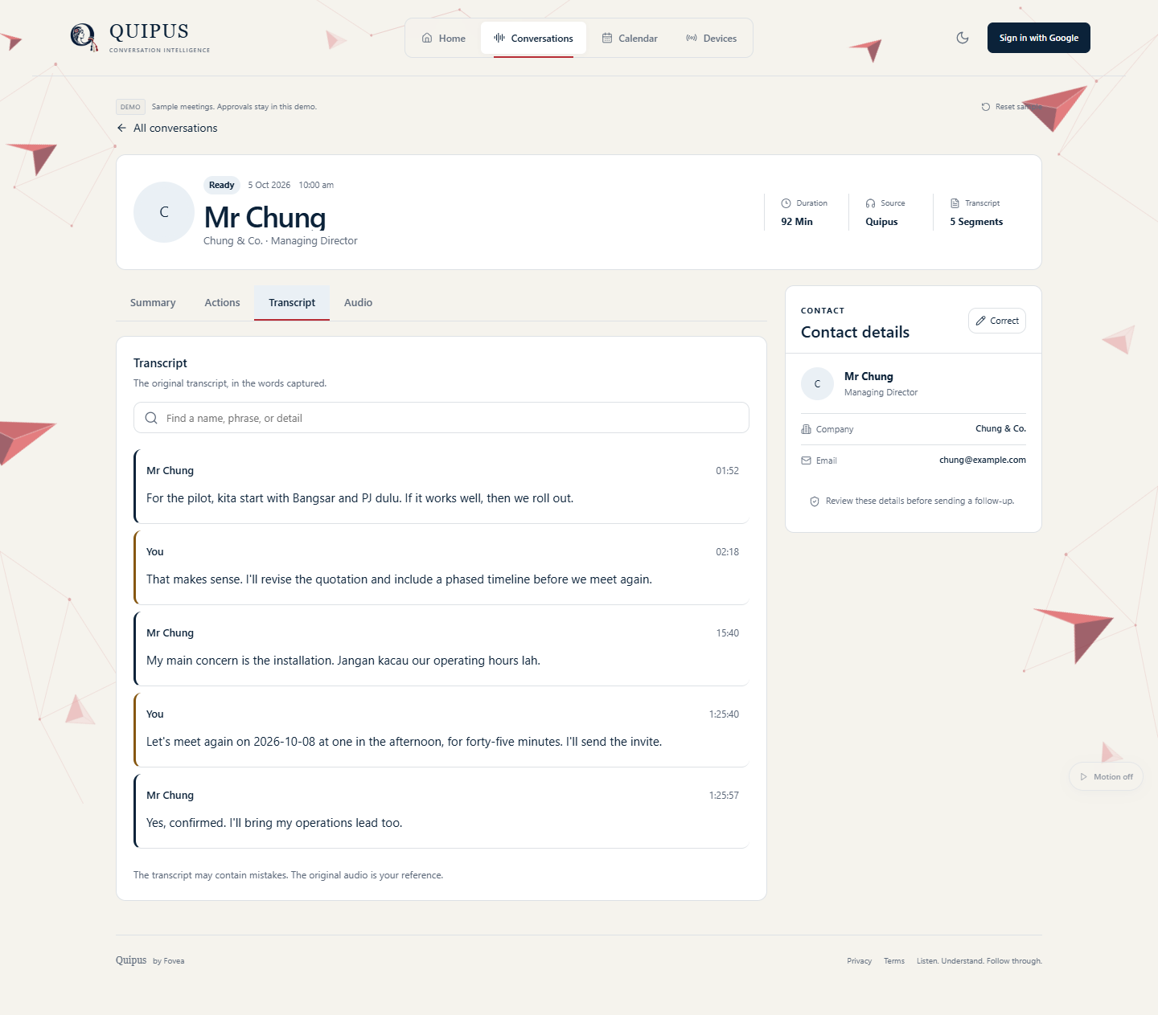
output/ui-review/production-detail-transcript-desktop.png
