NathanHor22/Quipus/output/ui-review/production-glass-calendar-390.png

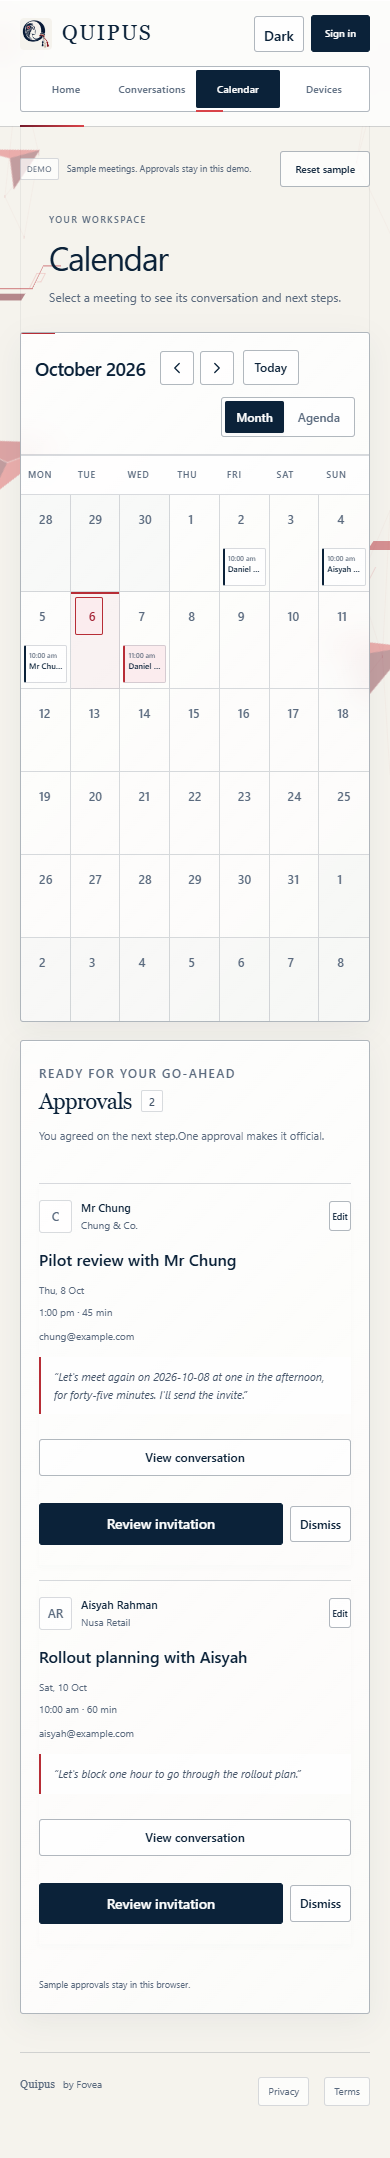
output/ui-review/production-glass-calendar-390.png
