NathanHor22/Quipus/output/ui-review/production-glass-detail-actions-320.png

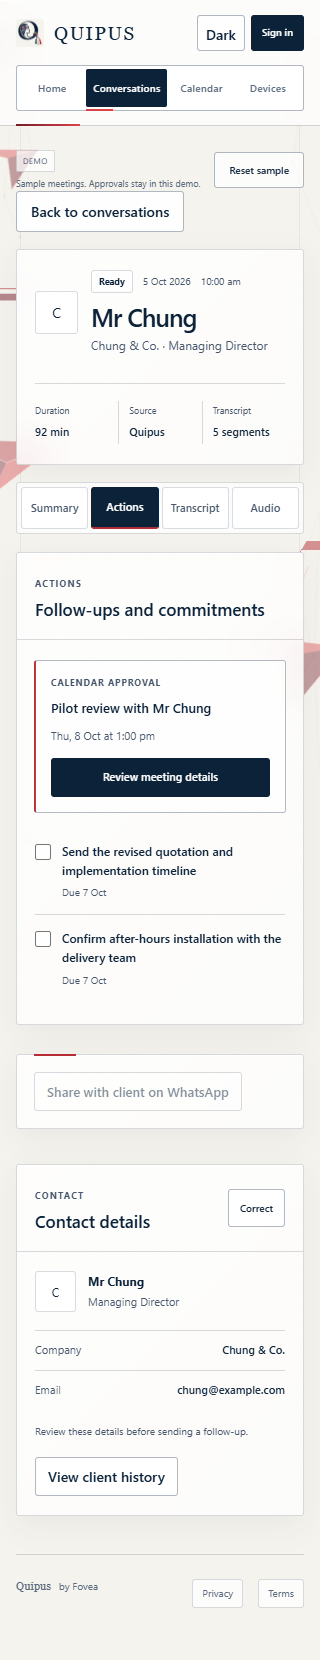
output/ui-review/production-glass-detail-actions-320.png
