NathanHor22/Quipus/output/ui-review/production-glass-detail-actions-390.png

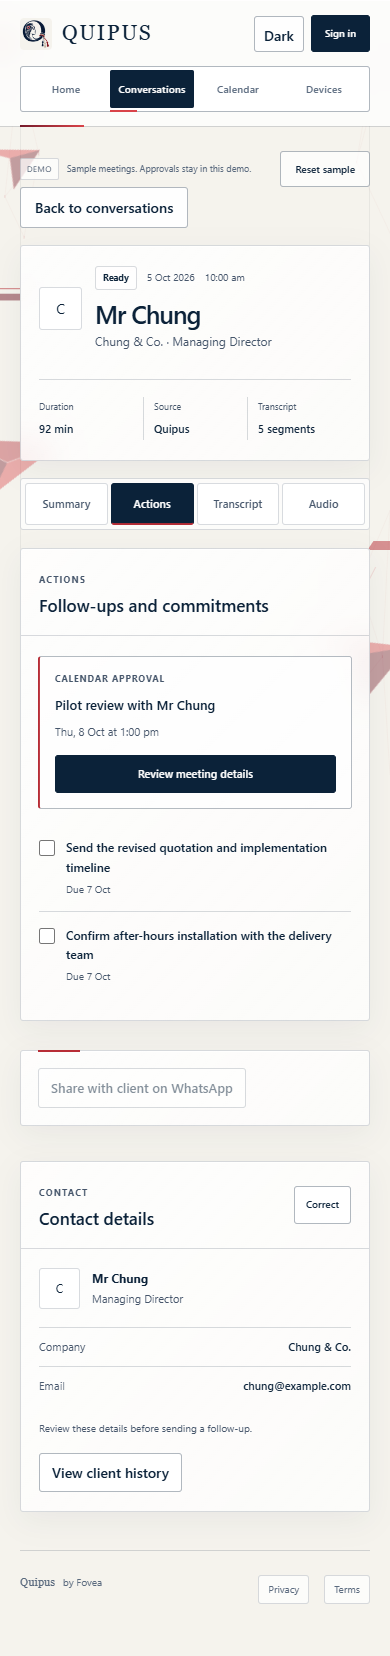
output/ui-review/production-glass-detail-actions-390.png
