NathanHor22/Quipus/output/ui-review/production-glass-detail-audio-320.png

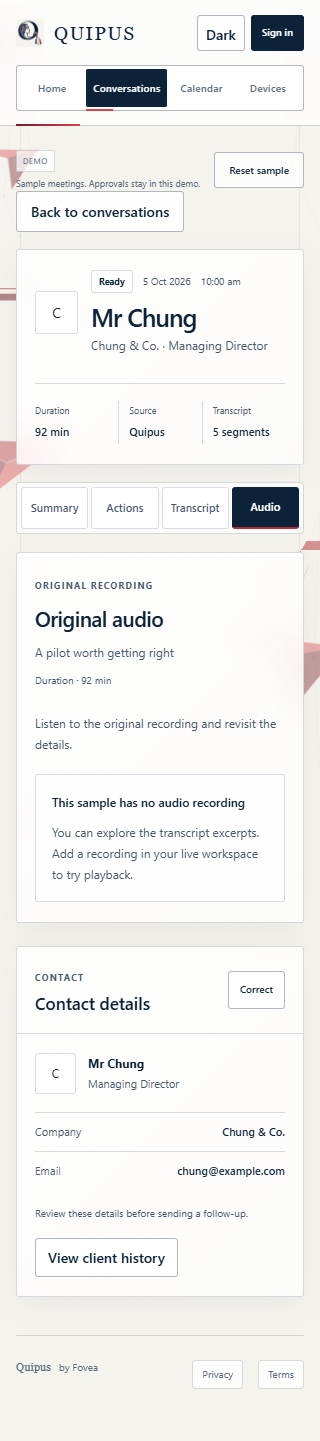
output/ui-review/production-glass-detail-audio-320.png
