NathanHor22/Quipus/output/ui-review/production-glass-detail-audio-390.png

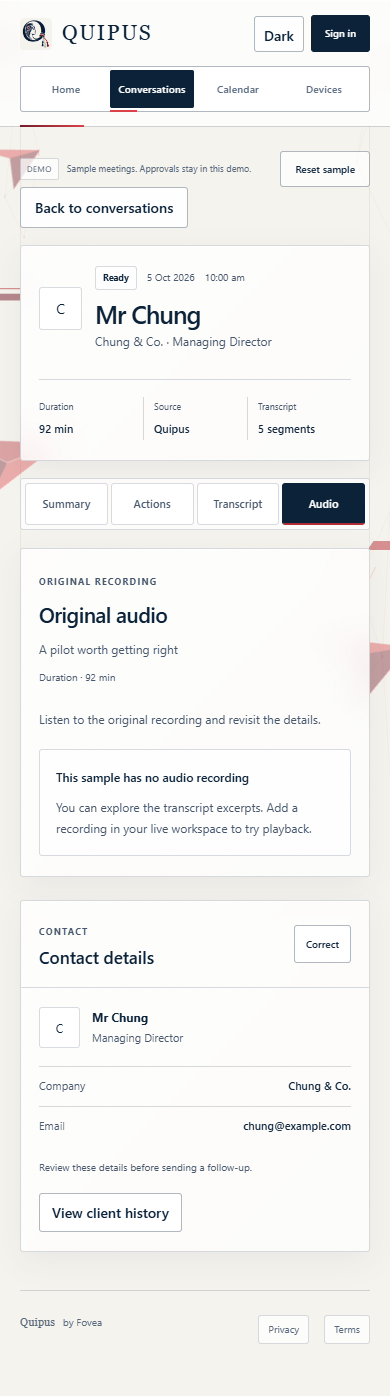
output/ui-review/production-glass-detail-audio-390.png
