NathanHor22/Quipus/output/ui-review/production-glass-detail-desktop.png

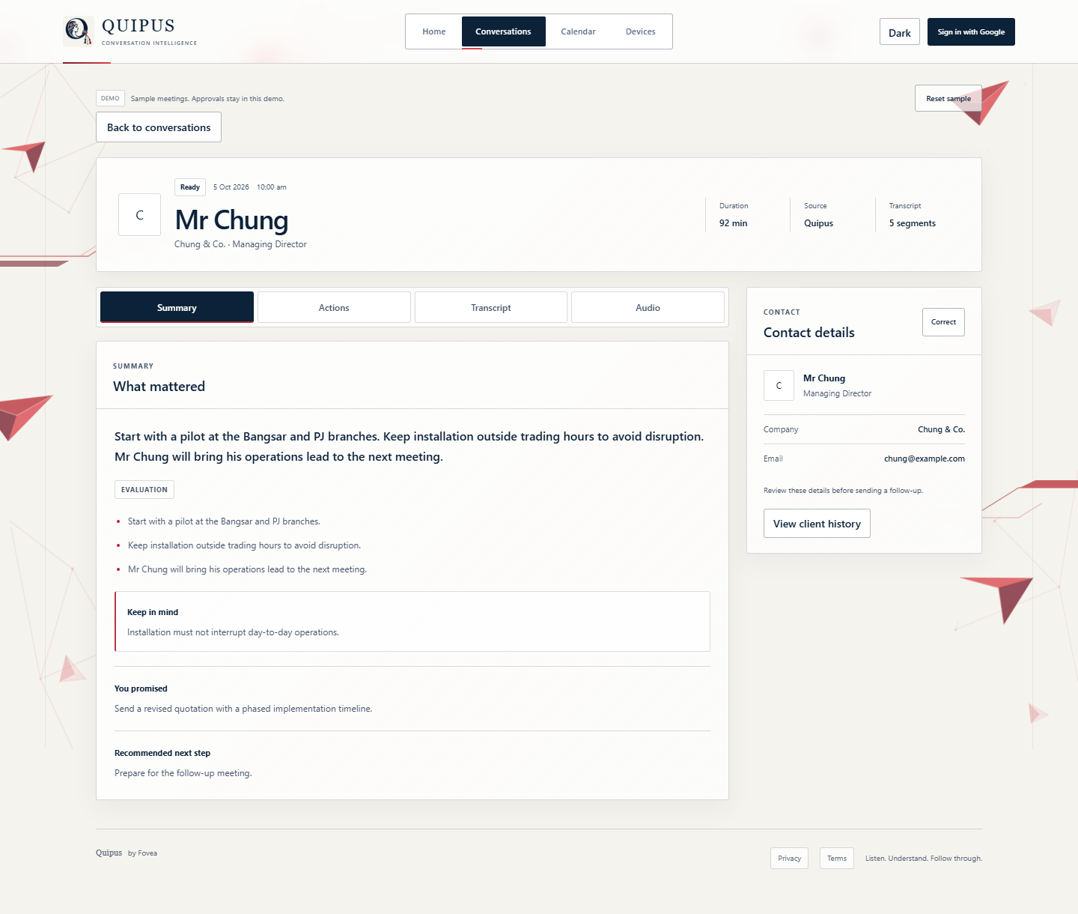
output/ui-review/production-glass-detail-desktop.png
