NathanHor22/Quipus/output/ui-review/production-glass-detail-summary-320.png

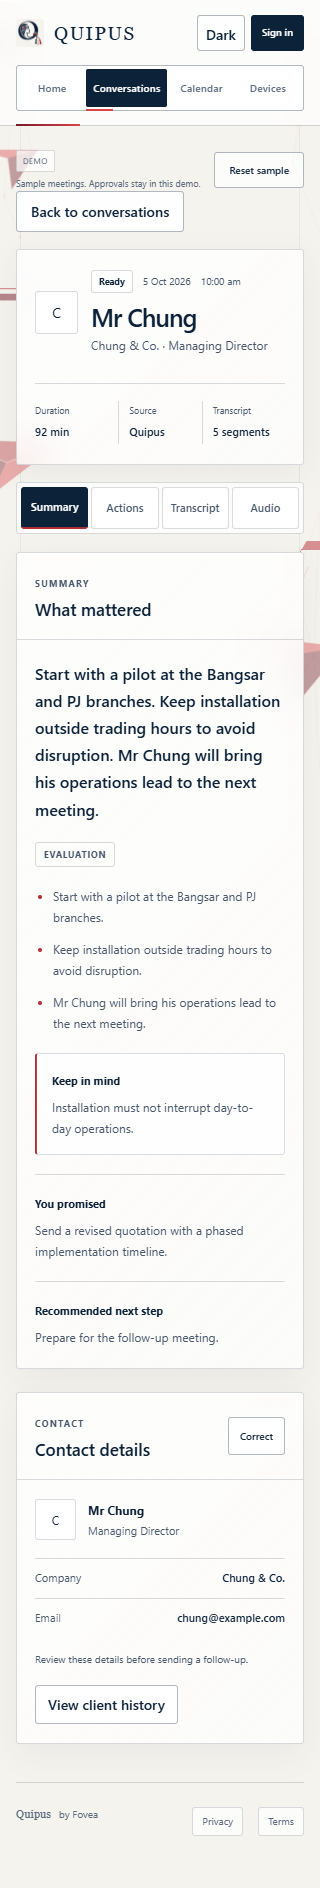
output/ui-review/production-glass-detail-summary-320.png
