NathanHor22/Quipus/output/ui-review/production-glass-detail-summary-390.png

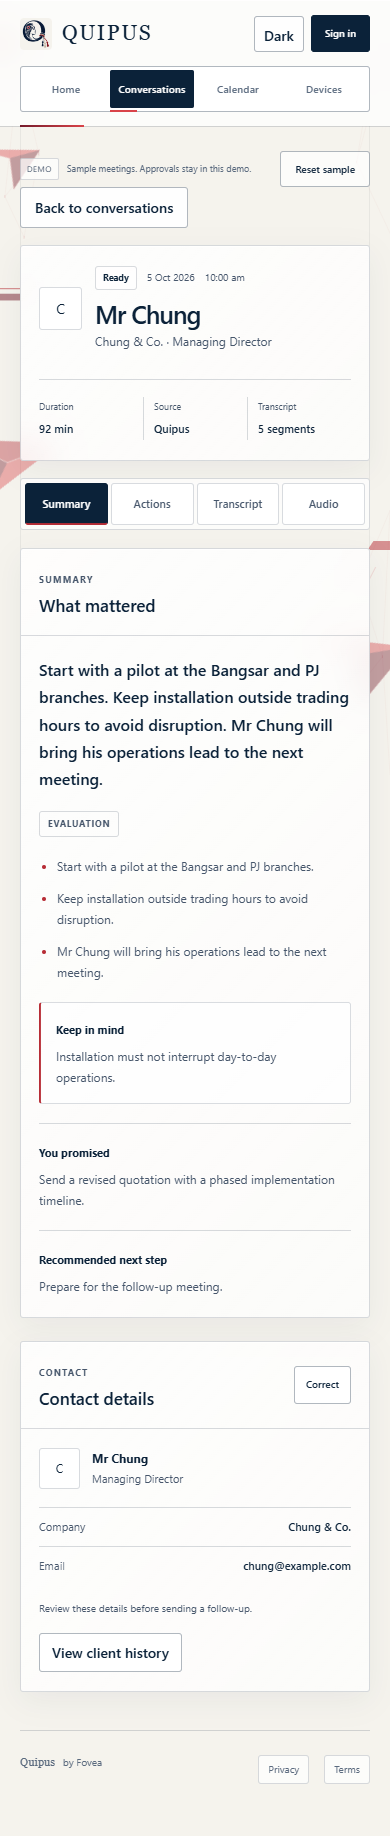
output/ui-review/production-glass-detail-summary-390.png
