NathanHor22/Quipus/output/ui-review/production-glass-detail-transcript-320.png

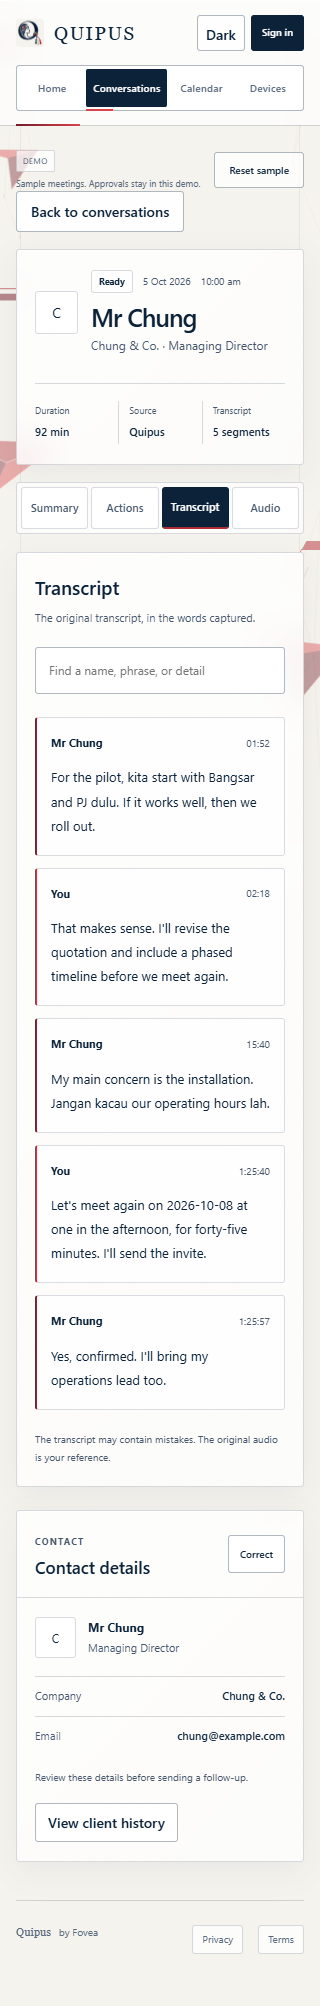
output/ui-review/production-glass-detail-transcript-320.png
