NathanHor22/Quipus/output/ui-review/production-glass-detail-transcript-390.png

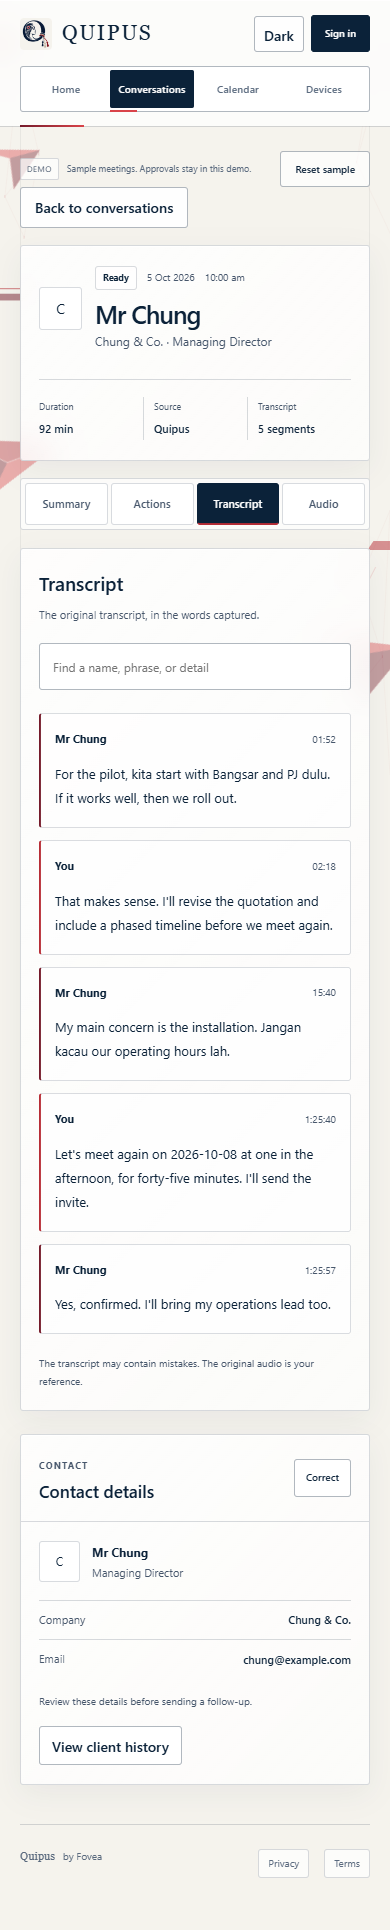
output/ui-review/production-glass-detail-transcript-390.png
