NathanHor22/Quipus/output/ui-review/production-glass-login-320.png

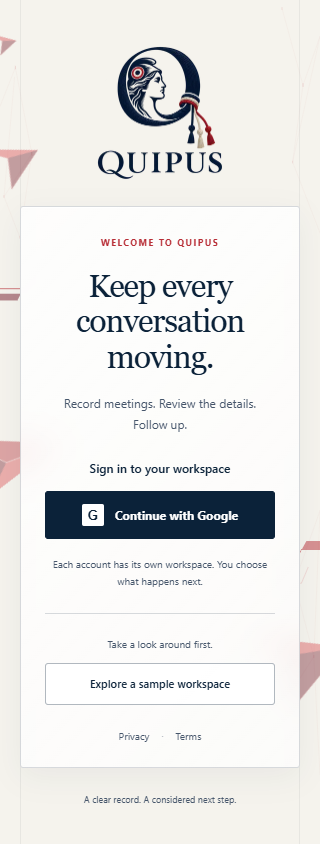
output/ui-review/production-glass-login-320.png
