NathanHor22/Quipus/output/ui-review/production-glass-login-390.png

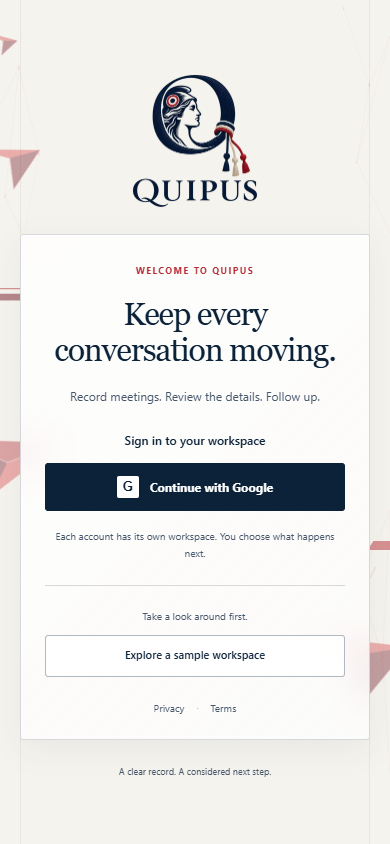
output/ui-review/production-glass-login-390.png
