NathanHor22/Quipus/output/ui-review/production-glass-popup-actions.png

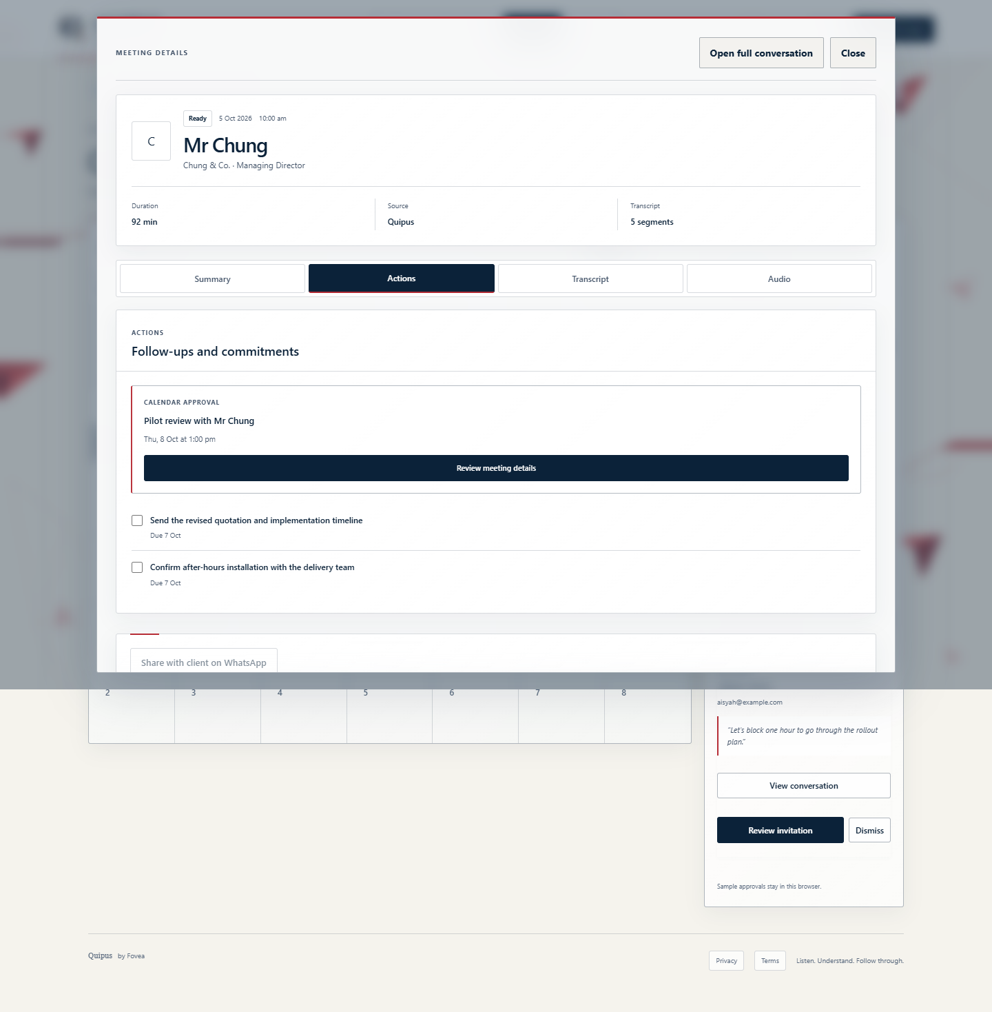
output/ui-review/production-glass-popup-actions.png
