NathanHor22/Quipus/output/ui-review/production-glass-popup-audio.png

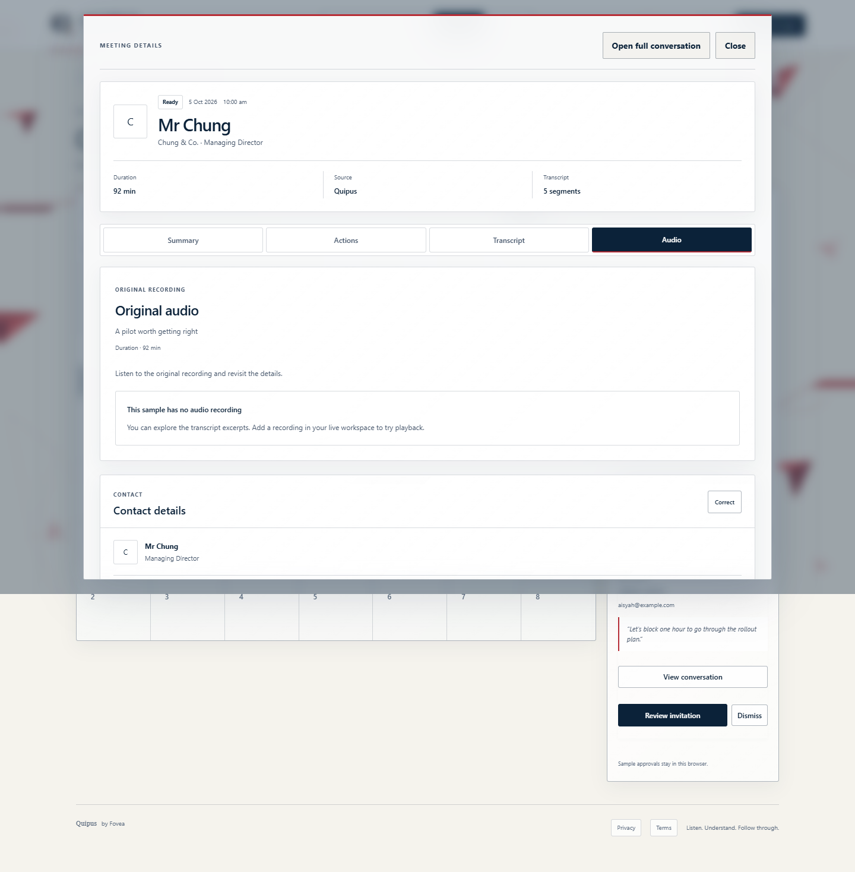
output/ui-review/production-glass-popup-audio.png
