NathanHor22/Quipus/output/ui-review/production-glass-popup-summary.png

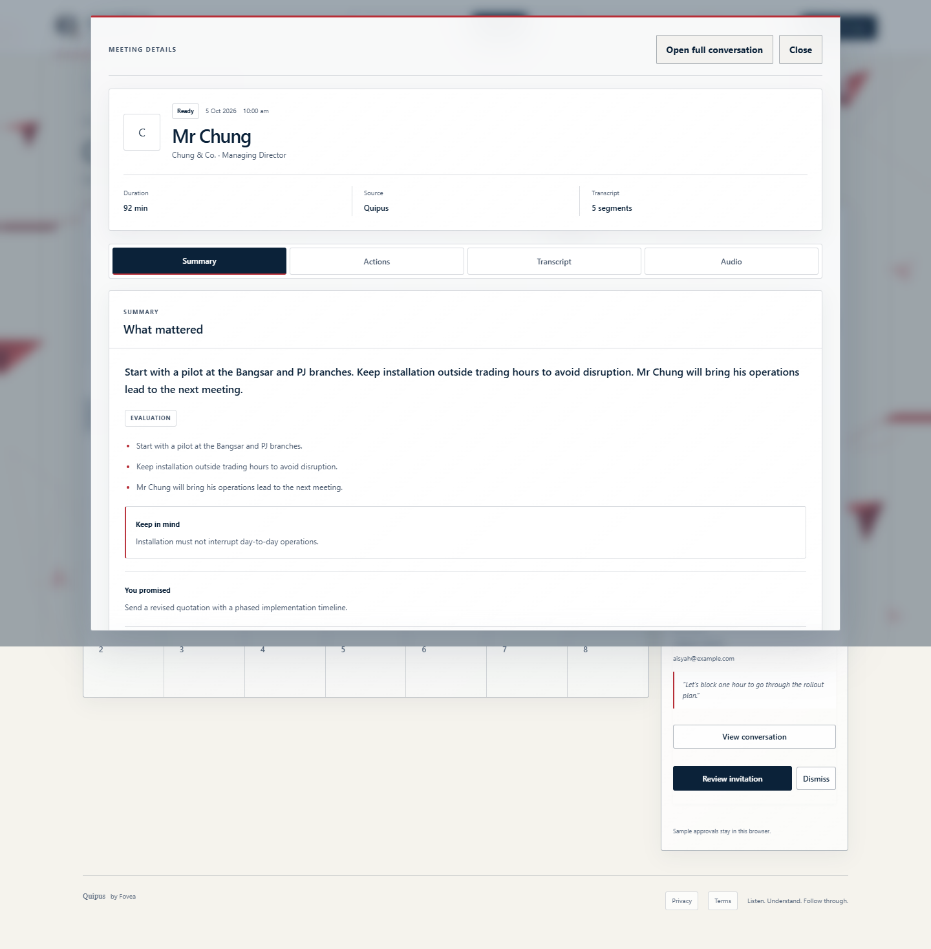
output/ui-review/production-glass-popup-summary.png
