NathanHor22/Quipus/output/ui-review/production-glass-popup-transcript.png

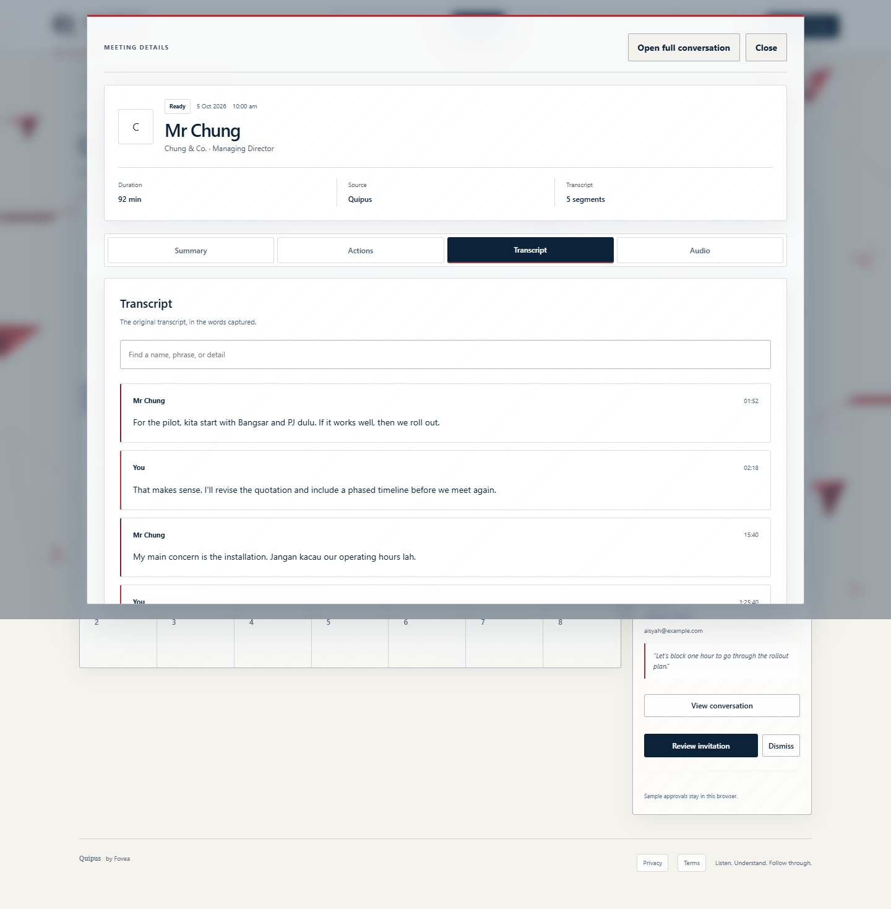
output/ui-review/production-glass-popup-transcript.png
