NathanHor22/Quipus/output/ui-review/production-home-mobile-320.png

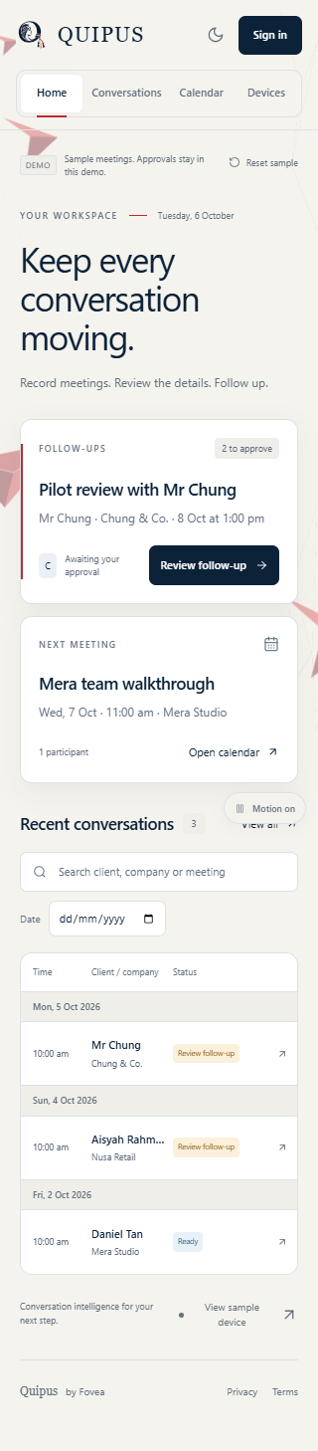
output/ui-review/production-home-mobile-320.png
