NathanHor22/Quipus/output/ui-review/production-home-reduced-motion.png

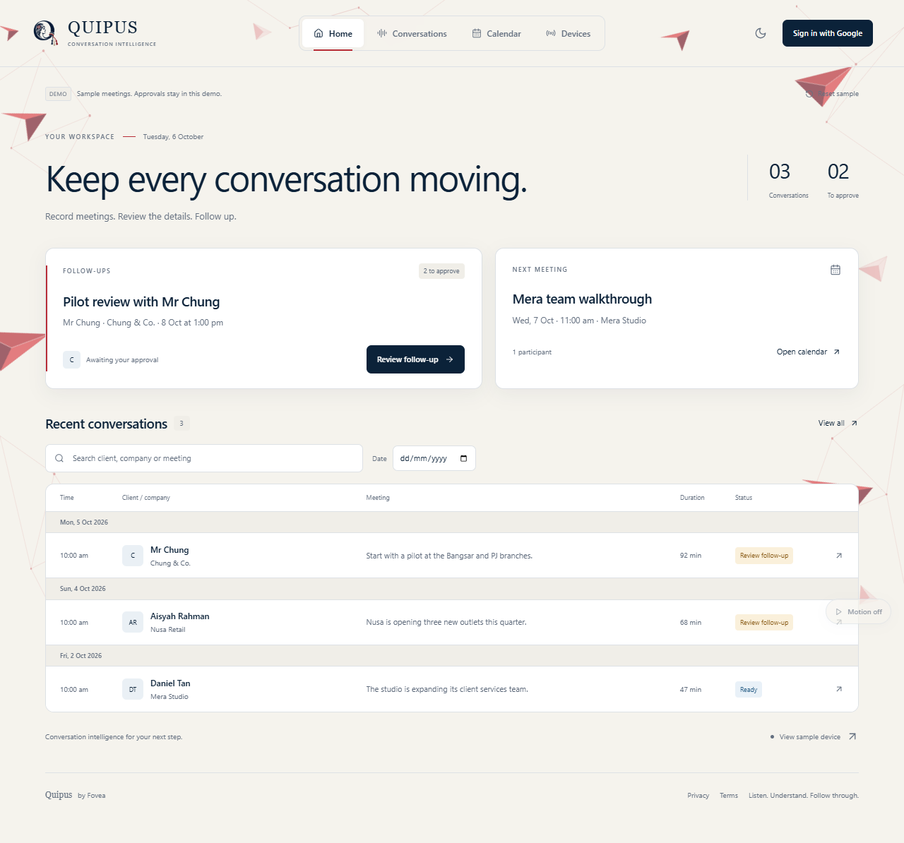
output/ui-review/production-home-reduced-motion.png
