NathanHor22/Quipus/output/ui-review/production-login-desktop.png

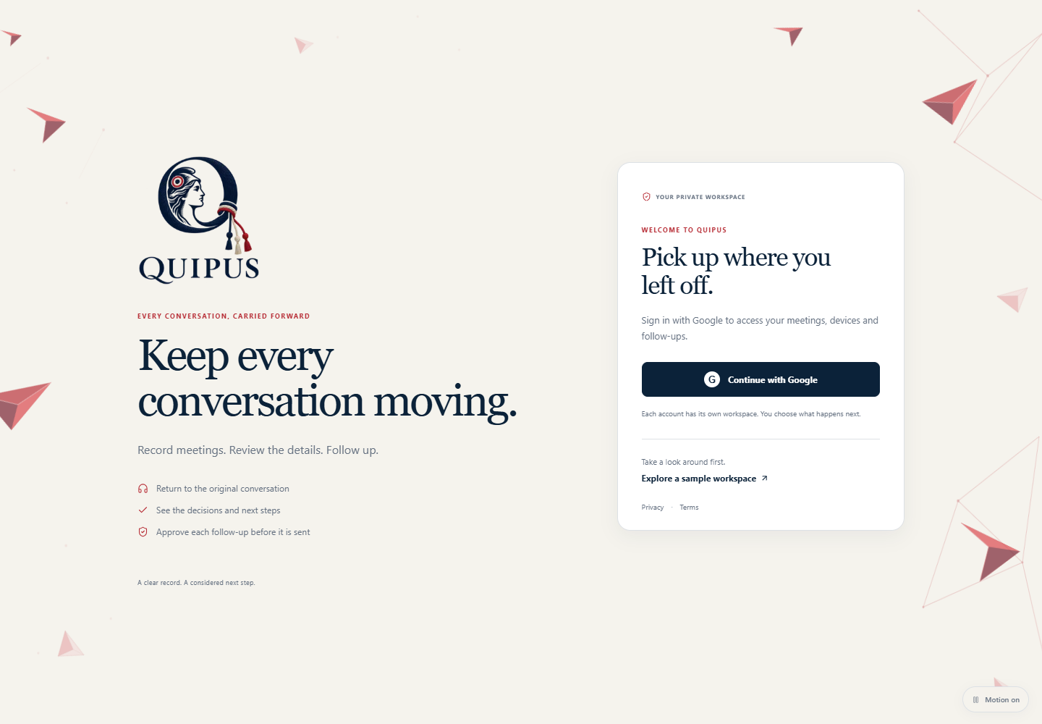
output/ui-review/production-login-desktop.png
