NathanHor22/Quipus/output/ui-review/production-login-mobile-320.png

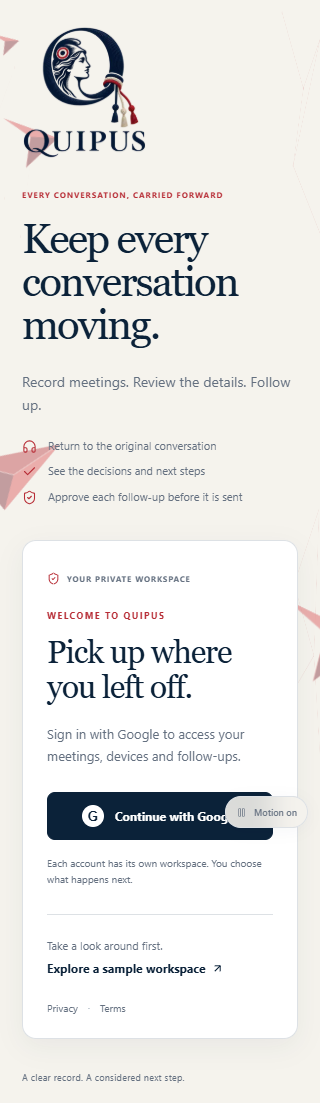
output/ui-review/production-login-mobile-320.png
