NathanHor22/Quipus/output/ui-review/production-login-mobile-390.png

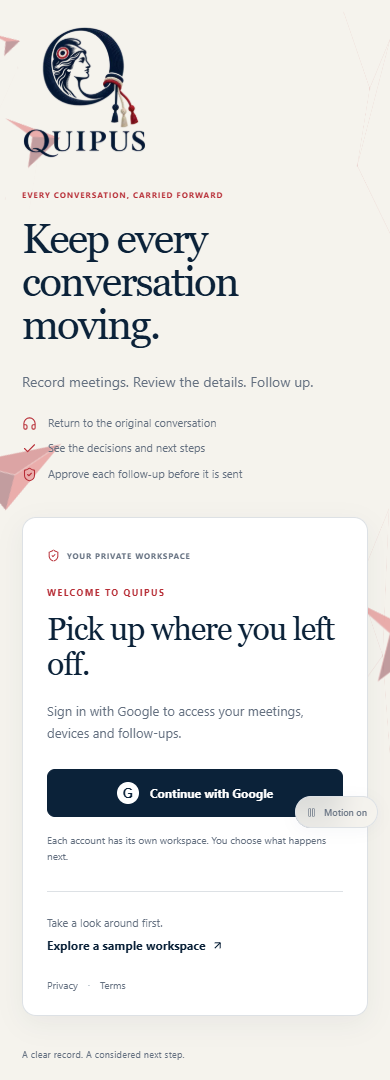
output/ui-review/production-login-mobile-390.png
