NathanHor22/Quipus/output/ui-review/visual-detail-actions-desktop.png

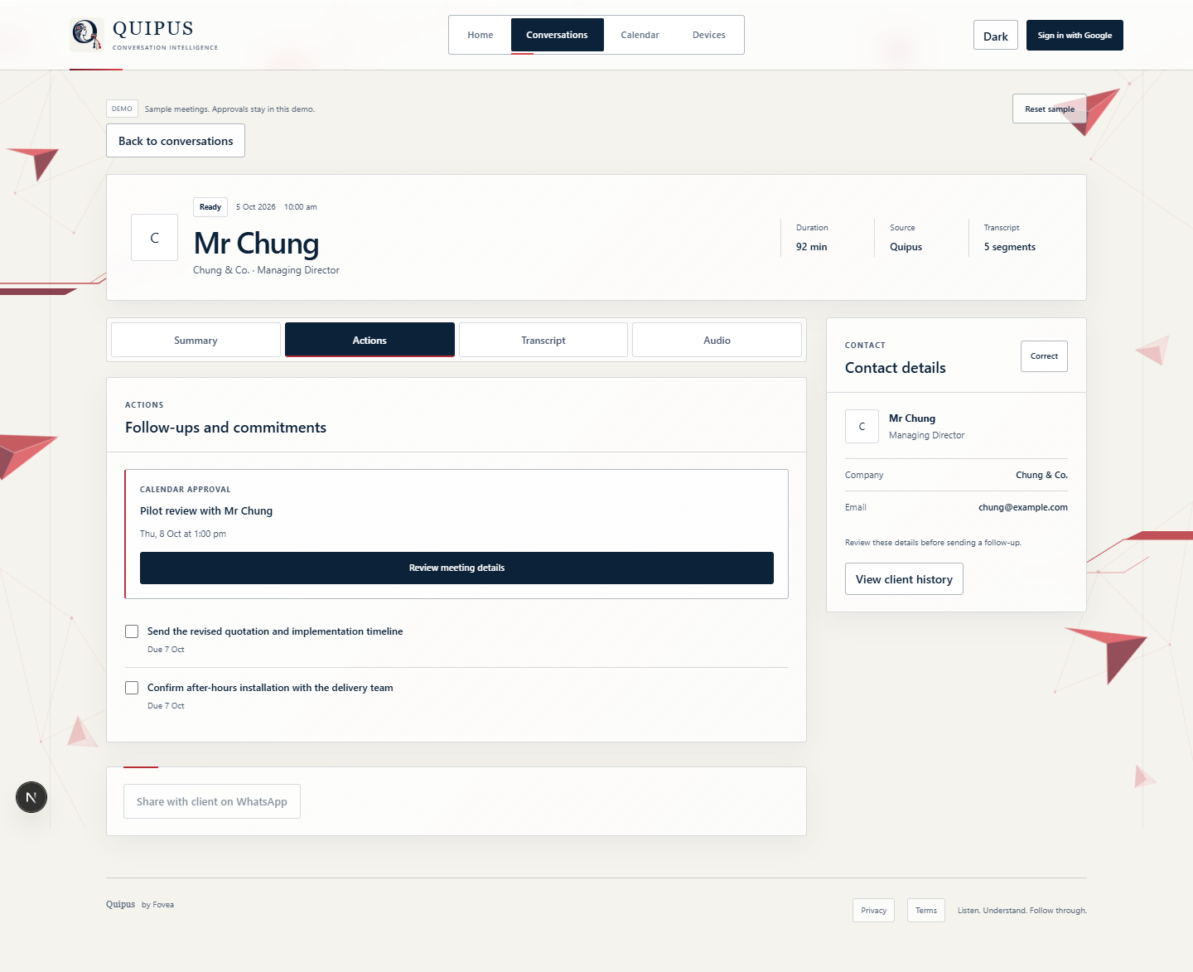
output/ui-review/visual-detail-actions-desktop.png
