NathanHor22/Quipus/output/ui-review/visual-detail-audio-desktop.png

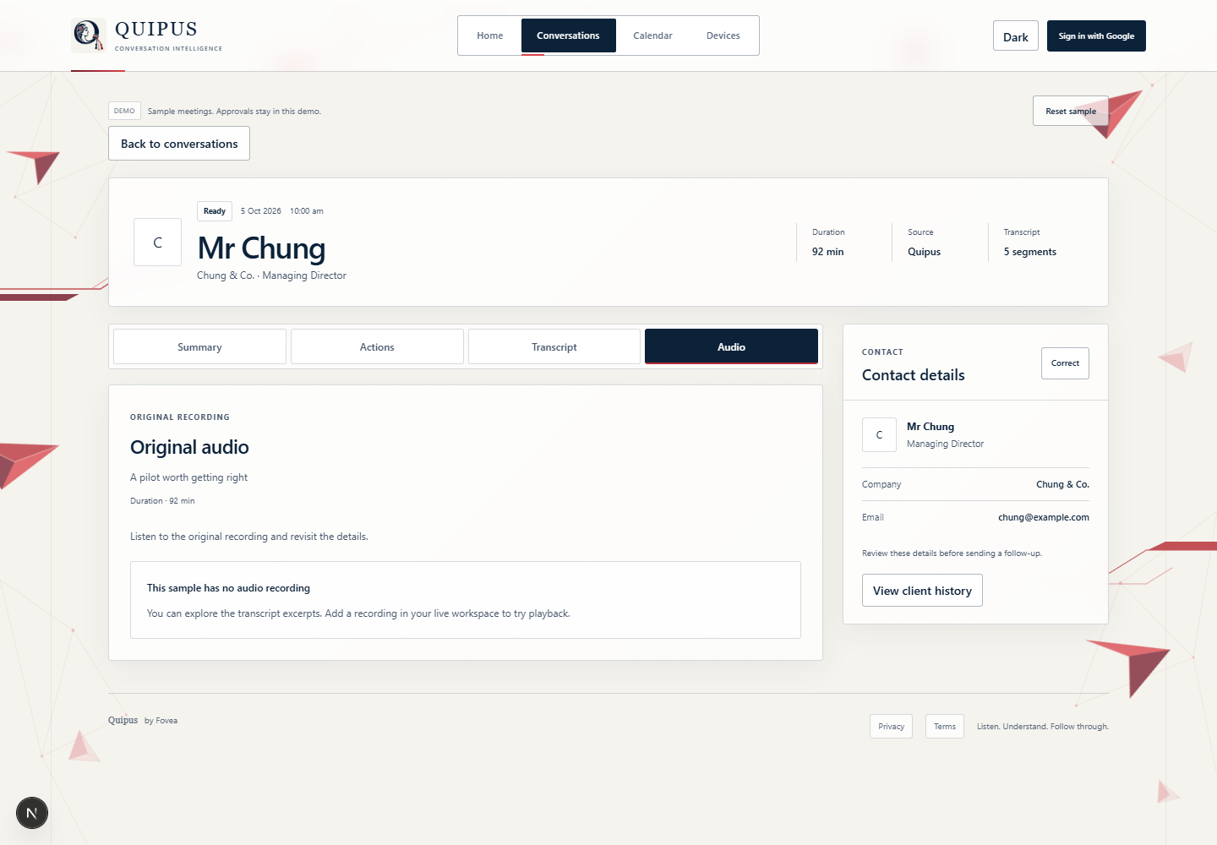
output/ui-review/visual-detail-audio-desktop.png
