NathanHor22/Quipus/output/ui-review/visual-detail-local-fixture-audio.png

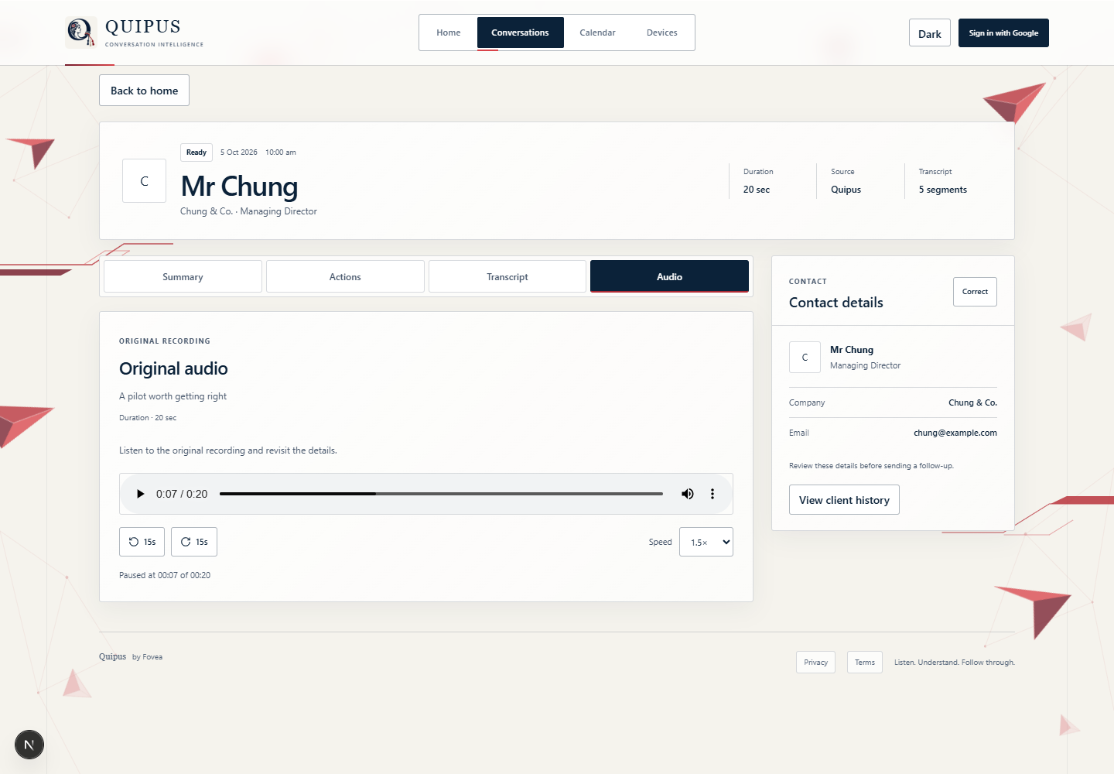
output/ui-review/visual-detail-local-fixture-audio.png
