NathanHor22/Quipus/output/ui-review/visual-detail-local-fixture-transcript.png

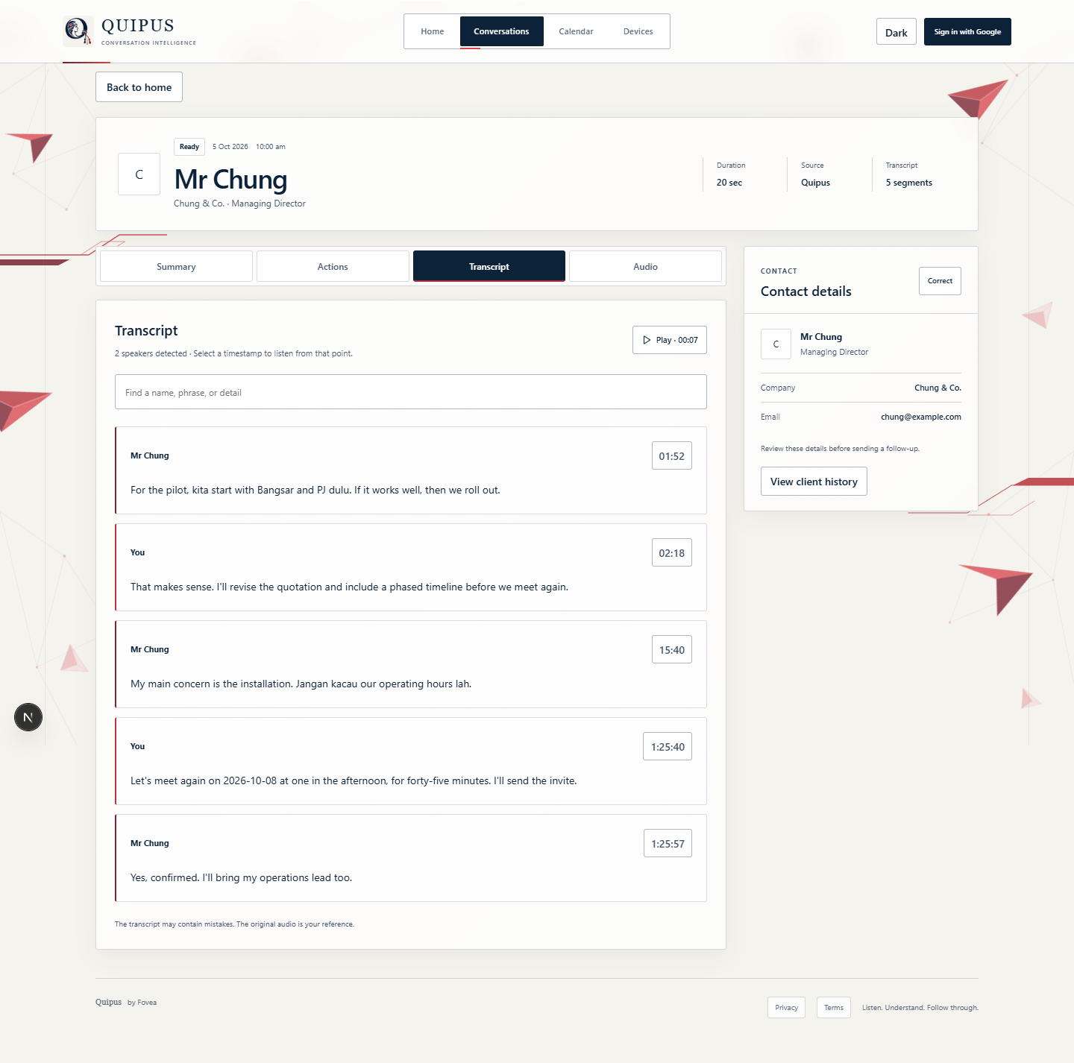
output/ui-review/visual-detail-local-fixture-transcript.png
