NathanHor22/Quipus/output/ui-review/visual-detail-transcript-desktop.png

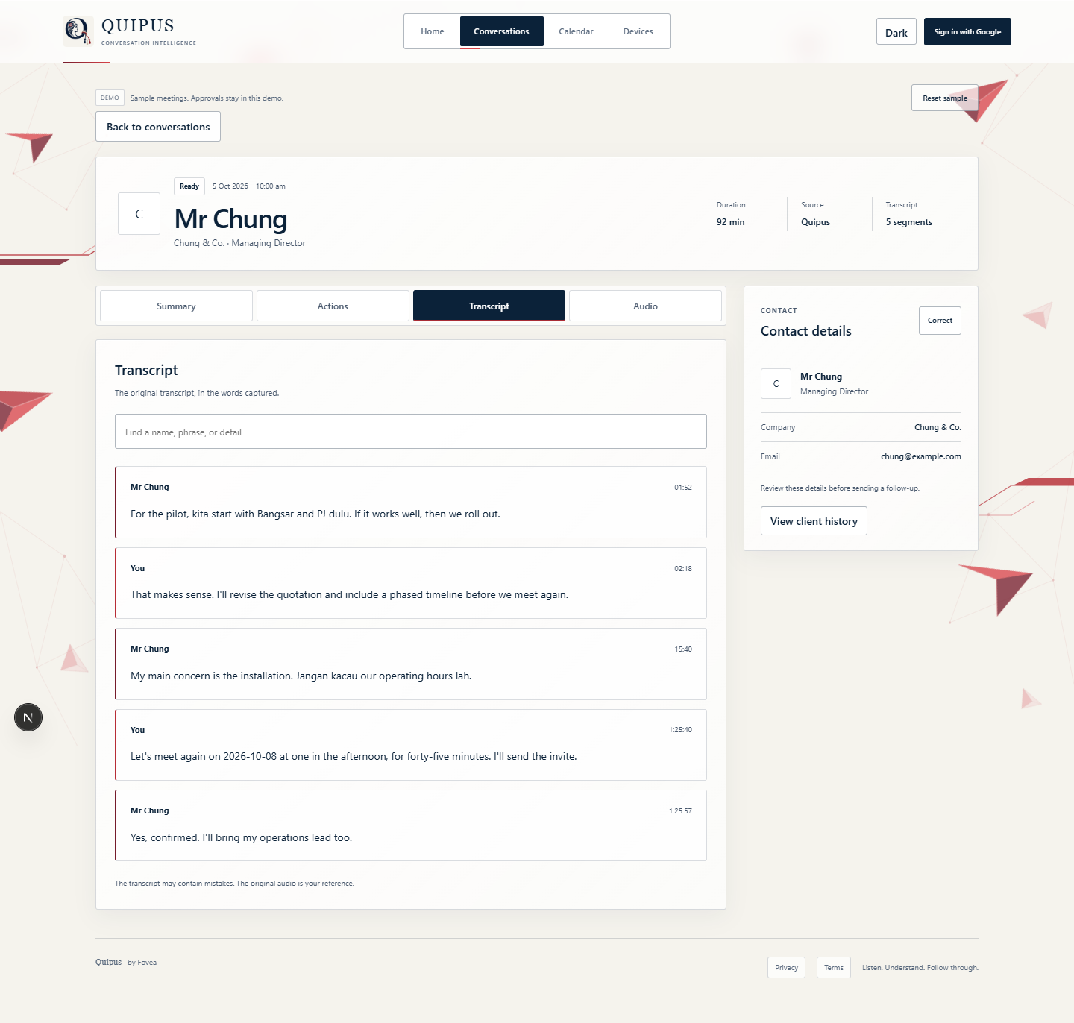
output/ui-review/visual-detail-transcript-desktop.png
