NathanHor22/Quipus/output/ui-review/visual-home-heading-reveal.png

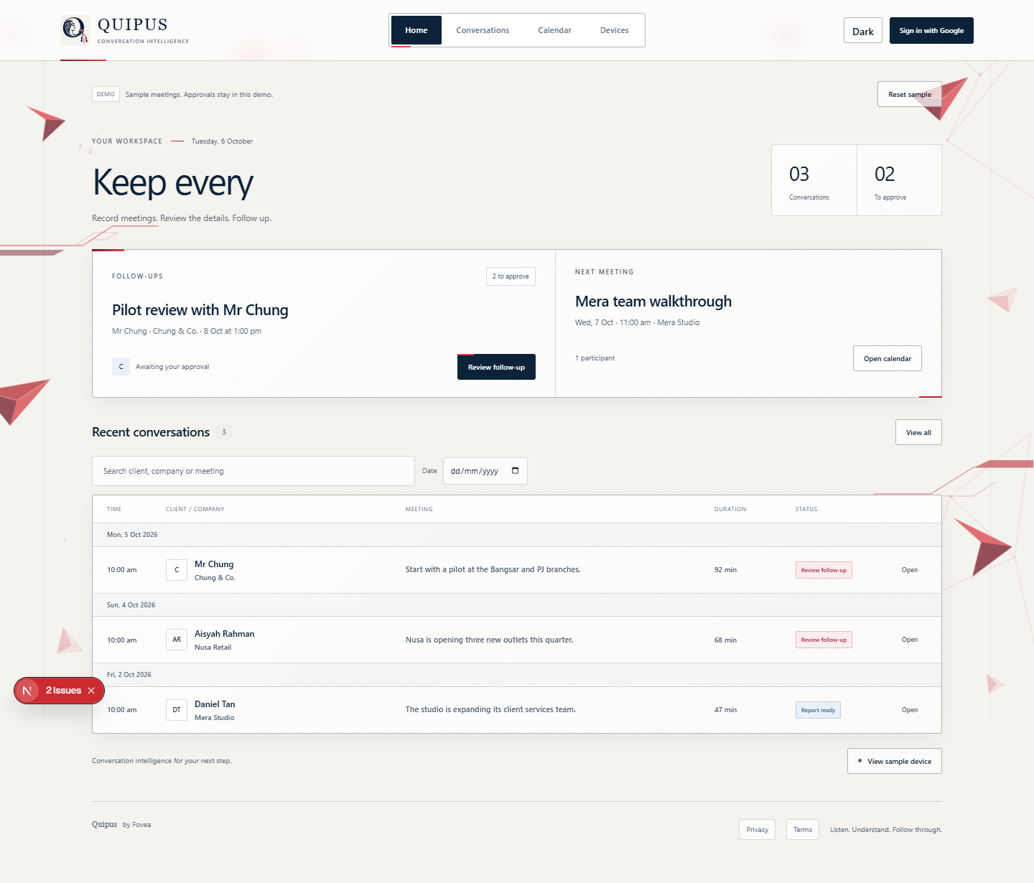
output/ui-review/visual-home-heading-reveal.png
