NathanHor22/Quipus/public/landing/prototype-in-use.webp

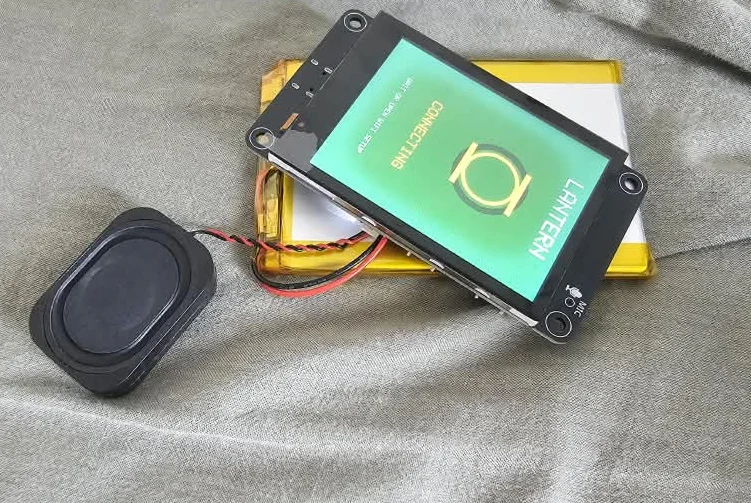
public/landing/prototype-in-use.webp
