NathanHor22/Quipus/public/landing/prototype-rear.webp

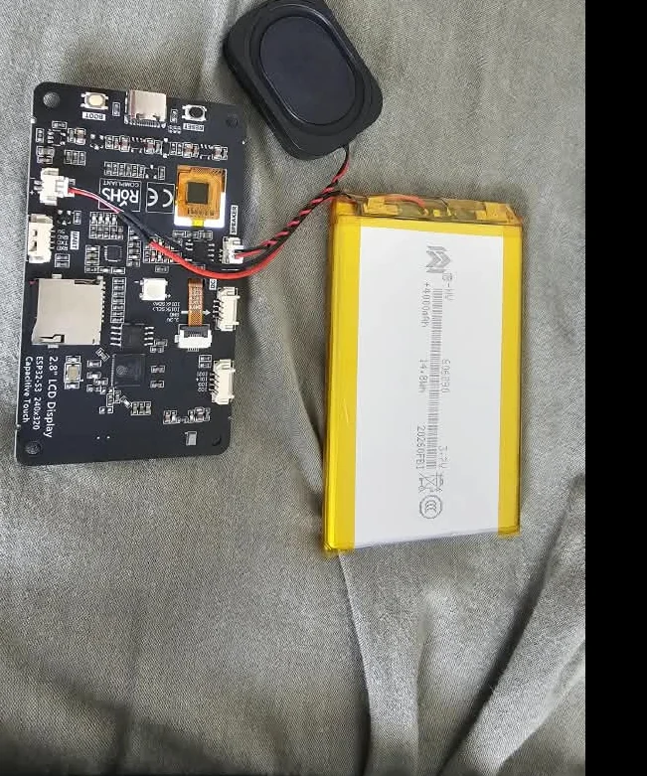
public/landing/prototype-rear.webp
