NathanHor22/Quipus/public/landing/prototype-screen.png

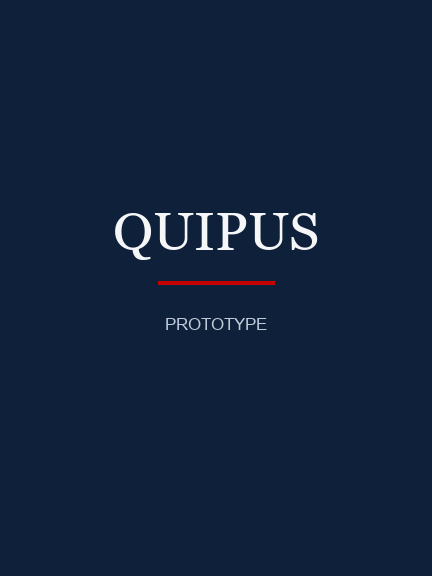
public/landing/prototype-screen.png
