NathanHor22/Quipus/public/landing/quipus-prototype.webp

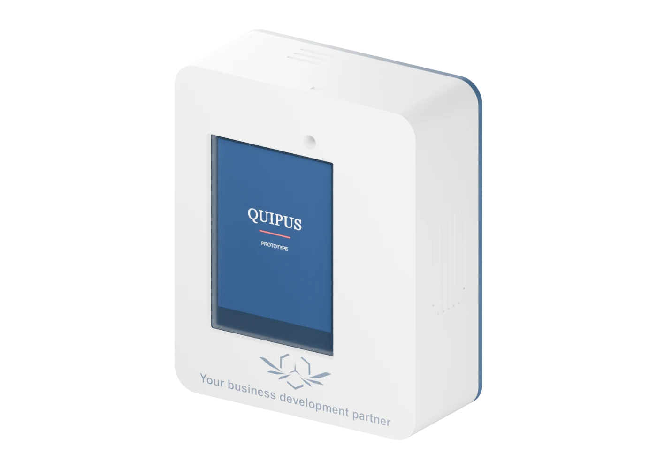
public/landing/quipus-prototype.webp
