NathanHor22/Quipus/public/quipus-emblem.png

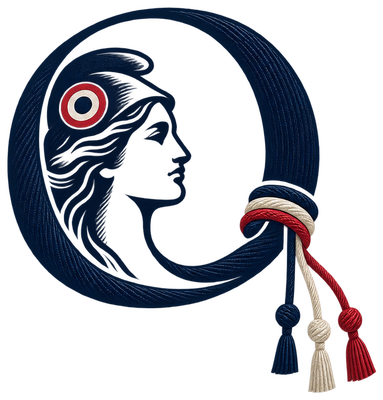
public/quipus-emblem.png
