NathanHor22/Quipus/output/pcb/Quipus-B1-EasyEDA/bill-of-materials.csv

Reference | Qty per device | Part or electrical specification | Manufacturer part candidate | Package | Assembly responsibility | Purchase status | Notes | Primary source
J1 | 1 | GCT USB4105-GF-A | GCT USB4105-GF-A | GCT USB4105 PCB-top-mount USB2 receptacle, 0.95 mm shell stakes | Factory reflow recommended | Selected design candidate; footprint and release review pending | Sixteen mating contacts map to twelve solder tails: A1/B12, A4/B9, B4/A9, B1/A12 share pads. Four shield stakes connect to ground. Pad names below explicitly combine shared contacts; verify the imported CAD footprint uses the same mapping. No external CC Rd resistors. | https://gct.co/files/drawings/usb4105.pdf
F1 | 1 | Littelfuse 0467002.NRHF 2 A | Littelfuse 0467002.NRHF 2 A | 0603 fuse | Factory reflow recommended | Selected design candidate; footprint and release review pending | Candidate fast-acting input fuse; verify current and temperature derating, inrush, and fault coordination on the PCB. The charger, not this fuse, controls USB current entitlement. | https://www.littelfuse.com/assetdocs/fuse-467-datasheet?assetguid=4a59f034-1cca-460e-a5ba-e1e66247c76d
U2 | 1 | BQ24074RGTR | BQ24074RGTR | VQFN16 RGT0016 + exposed pad | Factory reflow recommended | Selected design candidate; footprint and release review pending | Standard 4.2 V Li-ion chemistry. Temperature sensing must match the actual cell. ITERM intentionally unconnected for default termination. | https://www.ti.com/lit/ds/symlink/bq24074.pdf
R1 | 1 | 1.24k 1% | Not yet qualified | 0603 | Factory reflow recommended | HOLD - electrical specification selected; qualify exact MPN
R2 | 1 | 2.00k 1% | Not yet qualified | 0603 | Factory reflow recommended | HOLD - electrical specification selected; qualify exact MPN
R3 | 1 | 68.0k 1% | Not yet qualified | 0603 | Factory reflow recommended | HOLD - electrical specification selected; qualify exact MPN
R4 | 1 | 100k | Not yet qualified | 0603 | Factory reflow recommended | HOLD - electrical specification selected; qualify exact MPN
R5 | 1 | 100k | Not yet qualified | 0603 | Factory reflow recommended | HOLD - electrical specification selected; qualify exact MPN
C1 | 1 | 4.7uF 16V X7R | Not yet qualified | 0805 | Factory reflow recommended | HOLD - electrical specification selected; qualify exact MPN
C2 | 1 | 10uF 10V X7R | Not yet qualified | 0805 | Factory reflow recommended | HOLD - electrical specification selected; qualify exact MPN
C3 | 1 | 22uF 10V X7R | Not yet qualified | 0805 | Factory reflow recommended | HOLD - electrical specification selected; qualify exact MPN
J2 | 1 | JST S2B-PH-SM4-TB(LF)(SN) battery | JST S2B-PH-SM4-TB(LF)(SN) battery | JST PH 2mm 2-position right angle SMT | Factory reflow recommended | Selected design candidate; footprint and release review pending | Board-defined pin 1 is positive. Verify pack polarity physically. Protected 1S 2000 mAh pack, standard 4.2 V charge, at least 2 A discharge capability. Swap with device off and USB unplugged. | https://www.jst-mfg.com/product/pdf/eng/ePH.pdf
J3 | 1 | 3-pin keyed NTC connector - JST SH family candidate | SM03B-SRSS-TB(LF)(SN) | JST SH 3-pin 1.0 mm side-entry SMD | Factory reflow recommended | Footprint selected; mating harness/NTC sample verification pending | Three positions prevent swapping with the two-position speaker connector. A 10 kOhm 103AT-2 thermistor must be thermally attached to the cell. Do not populate a fixed bypass resistor. | https://www.jst-mfg.com/product/pdf/eng/eSH.pdf
U3 | 1 | TUSB320LAIRWBR | TUSB320LAIRWBR | X2QFN12 RWB 1.6x1.6mm | Factory reflow recommended | Selected design candidate; footprint and release review pending | Sink only; ADDR floating selects GPIO mode. OUT1 high means default current; low means 1.5 A or 3 A advertised. No external CC pull-down resistors. | https://www.ti.com/lit/ds/symlink/tusb320lai.pdf
R6 | 1 | 887k 1% | Not yet qualified | 0603 | Factory reflow recommended | HOLD - electrical specification selected; qualify exact MPN
R7 | 1 | 10k | Not yet qualified | 0603 | Factory reflow recommended | HOLD - electrical specification selected; qualify exact MPN
C4 | 1 | 100nF 10V | Not yet qualified | 0603 | Factory reflow recommended | HOLD - electrical specification selected; qualify exact MPN
U4 | 1 | TLV75533PDBVR | TLV75533PDBVR | SOT23-5 DBV | Factory reflow recommended | Selected design candidate; footprint and release review pending | Always-on control LDO, nominal 3.3 V on USB. At low battery it follows SYS_RAW minus dropout. Device off does not mean zero battery current. | https://www.ti.com/lit/ds/symlink/tlv755p.pdf
C5 | 1 | 1uF 10V X7R | Not yet qualified | 0603 | Factory reflow recommended | HOLD - electrical specification selected; qualify exact MPN
C6 | 1 | 1uF 10V X7R | Not yet qualified | 0603 | Factory reflow recommended | HOLD - electrical specification selected; qualify exact MPN
U5 | 1 | SN74LVC1G04DBVR | SN74LVC1G04DBVR | SOT23-5 DBV | Factory reflow recommended | Selected design candidate; footprint and release review pending | Y=!OUT1 | https://www.ti.com/document-viewer/SN74LVC1G04/datasheet/GUID-047EF317-EC05-483E-B17F-7CDF4F4C03DB
U6 | 1 | SN74LVC1G08DBVR | SN74LVC1G08DBVR | SOT23-5 DBV | Factory reflow recommended | Selected design candidate; footprint and release review pending | Y=USB_ENUM_500 AND OUT1 | https://www.ti.com/lit/ds/symlink/sn74lvc1g08.pdf
U7 | 1 | SN74LVC1G32DBVR | SN74LVC1G32DBVR | SOT23-5 DBV | Factory reflow recommended | Selected design candidate; footprint and release review pending | EN1=SUSPEND OR (ENUM500 AND OUT1) | https://www.ti.com/lit/ds/symlink/sn74lvc1g32.pdf
U8 | 1 | SN74LVC1G32DBVR | SN74LVC1G32DBVR | SOT23-5 DBV | Factory reflow recommended | Selected design candidate; footprint and release review pending | EN2=SUSPEND OR NOT OUT1 | https://www.ti.com/lit/ds/symlink/sn74lvc1g32.pdf
R8 | 1 | 100k | Not yet qualified | 0603 | Factory reflow recommended | HOLD - electrical specification selected; qualify exact MPN
R9 | 1 | 100k | Not yet qualified | 0603 | Factory reflow recommended | HOLD - electrical specification selected; qualify exact MPN
R10 | 1 | 100k | Not yet qualified | 0603 | Factory reflow recommended | HOLD - electrical specification selected; qualify exact MPN
R11 | 1 | 100k | Not yet qualified | 0603 | Factory reflow recommended | HOLD - electrical specification selected; qualify exact MPN
C7 | 1 | 100nF 10V | Not yet qualified | 0603 | Factory reflow recommended | HOLD - electrical specification selected; qualify exact MPN
C8 | 1 | 100nF 10V | Not yet qualified | 0603 | Factory reflow recommended | HOLD - electrical specification selected; qualify exact MPN
C9 | 1 | 100nF 10V | Not yet qualified | 0603 | Factory reflow recommended | HOLD - electrical specification selected; qualify exact MPN
C10 | 1 | 100nF 10V | Not yet qualified | 0603 | Factory reflow recommended | HOLD - electrical specification selected; qualify exact MPN
U9 | 1 | LTC2951ITS8-1#TRPBF | LTC2951ITS8-1#TRPBF | TSOT23-8 TS8 | Factory reflow recommended | Selected design candidate; footprint and release review pending | Use the -1 variant with active-high enable. Pull KILL up to switched 3V3 so startup does not depend on firmware responding within 512 ms. | https://www.analog.com/media/en/technical-documentation/data-sheets/295112fb.pdf
SW1 | 1 | POWER momentary normally-open | B3U-1000P | Omron B3U-1000P 3.0 x 2.5 mm SMD; custom manufacturer land | Factory reflow recommended | Footprint selected; case actuator/sample verification pending | On press: at least 128 ms. Off request: nominal 674 ms hold. Forced off approximately 6.54 s after the shutdown interrupt. | https://omronfs.omron.com/en_US/ecb/products/pdf/en-b3u.pdf
C11 | 1 | 100nF 10V | Not yet qualified | 0603 | Factory reflow recommended | HOLD - electrical specification selected; qualify exact MPN
C12 | 1 | 100nF 10V | Not yet qualified | 0603 | Factory reflow recommended | HOLD - electrical specification selected; qualify exact MPN | Nominal total off-button debounce approximately 674 ms.
C13 | 1 | 1uF 10V lowleakage X7R | Not yet qualified | 0805 | Factory reflow recommended | HOLD - electrical specification selected; qualify exact MPN | Nominal 6.54 s shutdown grace period after interrupt; verify capacitance tolerance and timing on the bench.
R12 | 1 | 100k | Not yet qualified | 0603 | Factory reflow recommended | HOLD - electrical specification selected; qualify exact MPN
R13 | 1 | 10k | Not yet qualified | 0603 | Factory reflow recommended | HOLD - electrical specification selected; qualify exact MPN
R14 | 1 | 100k | Not yet qualified | 0603 | Factory reflow recommended | HOLD - electrical specification selected; qualify exact MPN
U10 | 1 | TPS22918DBVR | TPS22918DBVR | SOT23-6 DBV | Factory reflow recommended | Selected design candidate; footprint and release review pending | Rated 2 A main load switch. Target normal system peak below 1.5 A at this node. Both amplifier and buck-boost supply are downstream. Do not inject external power into SYS_SW. | https://www.ti.com/lit/ds/symlink/tps22918.pdf
C14 | 1 | 1uF 10V X7R | Not yet qualified | 0603 | Factory reflow recommended | HOLD - electrical specification selected; qualify exact MPN
C15 | 1 | 10nF 25V X7R | Not yet qualified | 0603 | Factory reflow recommended | HOLD - electrical specification selected; qualify exact MPN | Slew approximately 5.53 ms/V; rise approximately 24 ms at 4.4 V. Verify loaded startup.
R15 | 1 | 100ohm | Not yet qualified | 0603 | Factory reflow recommended | HOLD - electrical specification selected; qualify exact MPN | Limits output discharge current. QOD must not connect to an independently powered rail.
U11 | 1 | TPS63802DLAR | TPS63802DLAR | VSON-HR/HotRod DLA0010A 10-pin 2x3mm | Factory reflow recommended | Selected design candidate; footprint and release review pending | MODE low selects power saving. The board cannot draw 2 A from 3V3 plus speaker power simultaneously through a 2 A battery connector. | https://www.ti.com/lit/ds/symlink/tps63802.pdf
L1 | 1 | 0.47uH Coilcraft XFL4015-471ME | 0.47uH Coilcraft XFL4015-471ME | Coilcraft XFL4015 | Factory reflow recommended | Selected design candidate; footprint and release review pending | Datasheet candidate: 5.4 A saturation current and 7.6 mOhm DCR. Verify exact supplier land pattern and available revision.
R16 | 1 | 511k 1% | Not yet qualified | 0603 | Factory reflow recommended | HOLD - electrical specification selected; qualify exact MPN
R17 | 1 | 91.0k 1% | Not yet qualified | 0603 | Factory reflow recommended | HOLD - electrical specification selected; qualify exact MPN
R18 | 1 | 100k | Not yet qualified | 0603 | Factory reflow recommended | HOLD - electrical specification selected; qualify exact MPN
C16 | 1 | 10uF 10V X7R | Not yet qualified | 0805 | Factory reflow recommended | HOLD - electrical specification selected; qualify exact MPN
C17 | 1 | 22uF 10V X7R | Not yet qualified | 0805 | Factory reflow recommended | HOLD - electrical specification selected; qualify exact MPN
C18 | 1 | 22uF 10V X7R | Not yet qualified | 0805 | Factory reflow recommended | HOLD - electrical specification selected; qualify exact MPN
C19 | 1 | 100nF 10V | Not yet qualified | 0603 | Factory reflow recommended | HOLD - electrical specification selected; qualify exact MPN
U12 | 1 | BQ27441DRZR-G1A | BQ27441DRZR-G1A | VSON12 DRZ0012A 2.5x4 mm + exposed pad | Factory reflow recommended | Selected design candidate; footprint and release review pending | I2C address 0x55. This gauge does not replace cell protection. All charger and external battery loads connect downstream of R19. VDD must not supply other circuits. | https://www.ti.com/lit/ds/symlink/bq27441-g1.pdf
R19 | 1 | 0.010ohm 1% lowTCR 0.25W | Not yet qualified | 0805 sense resistor | Factory reflow recommended | HOLD - electrical specification selected; qualify exact MPN | Kelvin sense from both resistor pads. At 2 A: 20 mV drop and 40 mW dissipation.
R20 | 1 | 10k | Not yet qualified | 0603 | Factory reflow recommended | HOLD - electrical specification selected; qualify exact MPN | Defined for cold battery replacement; not automatic hot-swap insertion detection.
R21 | 1 | 10k | Not yet qualified | 0603 | Factory reflow recommended | HOLD - electrical specification selected; qualify exact MPN
R22 | 1 | 10k | Not yet qualified | 0603 | Factory reflow recommended | HOLD - electrical specification selected; qualify exact MPN
R23 | 1 | 1M | Not yet qualified | 0603 | Factory reflow recommended | HOLD - electrical specification selected; qualify exact MPN
R24 | 1 | 1M | Not yet qualified | 0603 | Factory reflow recommended | HOLD - electrical specification selected; qualify exact MPN
R25 | 1 | 10k | Not yet qualified | 0603 | Factory reflow recommended | HOLD - electrical specification selected; qualify exact MPN
R26 | 1 | 1M | Not yet qualified | 0603 | Factory reflow recommended | HOLD - electrical specification selected; qualify exact MPN | Prevents a floating input with main power off. Local test net unless an MCU GPIO is assigned.
C20 | 1 | 1uF 10V X7R | Not yet qualified | 0603 | Factory reflow recommended | HOLD - electrical specification selected; qualify exact MPN
C21 | 1 | 470nF 6.3V X7R | Not yet qualified | 0603 | Factory reflow recommended | HOLD - electrical specification selected; qualify exact MPN
U13 | 1 | TPD2EUSB30DRTR | TPD2EUSB30DRTR | SOT-9X3 DRT 3-pin 1x0.8mm body | Factory reflow recommended | Selected design candidate; footprint and release review pending | CC1/CC2 protection, close to USB connector. Verify transient clamping with layout. | https://www.ti.com/lit/ds/symlink/tpd2eusb30.pdf
D1 | 1 | TPD1E10B06DYAR | TPD1E10B06DYAR | DYA SOD-523 | Factory reflow recommended | Selected design candidate; footprint and release review pending | VBUS ESD clamp. Does not provide sustained overvoltage protection. Verify chosen package and protection coordination. | https://www.ti.com/lit/ds/symlink/tpd1e10b06.pdf
U1 | 1 | ESP32-S3-WROOM-1-N16R8 | ESP32-S3-WROOM-1-N16R8 | Espressif WROOM-1 18.0x25.5mm module, 40 castellated pads plus GND pad 41 | Factory reflow recommended | Selected design candidate; footprint and release review pending | Exact N16R8 ordering code only. GPIO35-37 are reserved for internal Octal PSRAM; leave disconnected. GPIO3/45/46 left unused. GPIO4/5 are I2S0 master TDM clocks, GPIO6 captures ADC output and GPIO42 controls ADC shutdown; GPIO7 is Start/Enter and RTC-domain wake input. GPIO43 is UART0 TX at ROM boot: LCD_CS_N external pull-up prevents interpreting ROM transitions. Native USB is the service interface; LCD uses SPI2_HOST, not the flash SPI1 bus. GPIO47/48 are valid 3.3V for N16R8; do not silently substitute N16R16VA. | https://documentation.espressif.com/esp32-s3-wroom-1_wroom-1u_datasheet_en.pdf
U30 | 1 | RV-3028-C7-TA-QC | RV-3028-C7-TA-QC | Micro Crystal C7 3.2x1.5x0.8mm | Factory reflow recommended | Selected design candidate; footprint and release review pending | I2C address 0x52. Factory-program EEPROM backup BSM=11 (LSM), TCE=0 and disable CLKOUT. Backup switchover is disabled on new parts; unconfigured part does not preserve time after main rail off. Backup uses protected BAT_P; no time guarantee if LiPo removed or protection trips. I2C pull-ups reside on switched 3V3 power sheet. | https://www.microcrystal.com/fileadmin/Media/Products/RTC/App.Manual/RV-3028-C7_App-Manual.pdf
U31 | 1 | PCA9536DR | PCA9536DR | TI D SOIC-8 4.9x3.91mm, 1.27mm pitch | Factory reflow recommended | Selected design candidate; footprint and release review pending | I2C address 0x41. Stop/Back, Up and Down only; Start/Enter connects directly to RTC GPIO7. P0 is unused and held high by the expander internal weak pull-up; configure as input and mask out its reading. Configure 0x03=0x0F explicitly; input register 0x00; active-low switches. Poll approximately 10ms while UI is active, 20ms debounce; stop polling in deep sleep and use direct Start button to wake. Powered off with ESP. Hardware power/BOOT/RESET bypass expander. | https://www.ti.com/lit/ds/symlink/pca9536.pdf
U34 | 1 | TS3USB221ARSER | TS3USB221ARSER | TI RSE UQFN-10 2.0x1.5mm | Factory reflow recommended | Selected design candidate; footprint and release review pending | Power-off-protected USB data switch. S=0/OE_N=0 selects port1 only while powered. Main-off VCC=0 has specified Ioff <=2uA per I/O (not zero). D+/D- remain isolated from unpowered ESP when USB charging remains active. Fit unused-port 49.9ohm terminations per manufacturer recommendation. Validate full-speed eye/edge waveform after adding switch plus series damping. | https://www.ti.com/lit/ds/symlink/ts3usb221a.pdf
U35 | 1 | TPD2EUSB30DRTR | TPD2EUSB30DRTR | TI DRT SOT-3 1.0x0.8mm, 0.50mm maximum height | Factory reflow recommended | Selected design candidate; footprint and release review pending | USB ESD array placed immediately beside USB-C connector, before isolation switch. No supply pin and no diode injection into switched 3V3 rail. Power sheet owns VBUS and CC protection. Ground return short to ground plane. | https://www.ti.com/lit/ds/symlink/tpd2eusb30.pdf
J6 | 1 | DM3AT-SF-PEJM5 | DM3AT-SF-PEJM5 | Hirose DM3AT push-push microSD top mount | Factory reflow recommended | Selected design candidate; footprint and release review pending | Native 1-bit SDMMC. DAT1/2/3 have 10k pull-ups even though not routed to ESP. Hirose drawing names separate detect contacts A/B, not 9/10; CAD footprint must map those named pads explicitly. Symbol SH represents all shell solder stakes; do not short detect-A to shell through a generic footprint. Detect closes A-B with card inserted. Enclosure must allow ejection travel. | https://www.hirose.com/product/download/?distributor=chip1&lang=en&num=DM3AT-SF-PEJM5&type=2d
J7 | 1 | B8B-PH-K-S(LF)(SN) | B8B-PH-K-S(LF)(SN) | JST PH 8-position 2.0mm vertical through-hole | Through-hole hand option after practice; factory also possible | Selected design candidate; footprint and release review pending | Custom Quipus connector numbering matches Waveshare SKU15867 MODULE J2 PH2.0, not its reversed J1 header. Vendor schematic J2:1BL,2RST,3DC,4CS,5SCK,6DIN,7GND,8VCC. Match signals by continuity, do not assume supplied cable colors/orientation. External module 45x31mm includes ST7789 240x240 and NPN backlight driver; no direct LED-current drive from GPIO. | https://files.waveshare.com/upload/0/0c/1.3inch_LCD_Module_Schematic.pdf
R300 | 1 | 10k | Not yet qualified | 0603 metric1608, 1%, 0.1W | Factory reflow recommended | HOLD - electrical specification selected; qualify exact MPN | Power-up RC pull-up; short EN trace. | engineering selection; validate during prototype
C300 | 1 | 1uF | Not yet qualified | 0603 metric1608 X7R (except marked C0G), 10V minimum | Factory reflow recommended | HOLD - electrical specification selected; qualify exact MPN | 10ms nominal RC; verify regulator startup and brownout recovery. | engineering selection; validate during prototype
C301 | 1 | 10uF | Not yet qualified | 0603 metric1608 X7R (except marked C0G), 10V minimum | Factory reflow recommended | HOLD - electrical specification selected; qualify exact MPN | ESP module local bulk; effective capacitance under DC bias matters. | engineering selection; validate during prototype
C302 | 1 | 100nF | Not yet qualified | 0603 metric1608 X7R (except marked C0G), 10V minimum | Factory reflow recommended | HOLD - electrical specification selected; qualify exact MPN | ESP module pin2 local bypass. | engineering selection; validate during prototype
R301 | 1 | 10k | Not yet qualified | 0603 metric1608, 1%, 0.1W | Factory reflow recommended | HOLD - electrical specification selected; qualify exact MPN | External boot strap pull-up. No capacitor on BOOT_N. | engineering selection; validate during prototype
R302 | 1 | 22ohm | Not yet qualified | 0603 metric1608, 1%, 0.1W | Factory reflow recommended | HOLD - electrical specification selected; qualify exact MPN | Near module; initial damping value. Tune from waveform. | engineering selection; validate during prototype
R303 | 1 | 22ohm | Not yet qualified | 0603 metric1608, 1%, 0.1W | Factory reflow recommended | HOLD - electrical specification selected; qualify exact MPN | Near module; match R302. | engineering selection; validate during prototype
C303 | 0 | DNP / C0G tuning footprint | Not yet qualified | 0603 metric1608 X7R (except marked C0G), 10V minimum | Do not populate | DNP - decision pending; do not buy for normal assembly | Leave unpopulated; no guessed capacitance. | engineering selection; validate during prototype
C304 | 0 | DNP / C0G tuning footprint | Not yet qualified | 0603 metric1608 X7R (except marked C0G), 10V minimum | Do not populate | DNP - decision pending; do not buy for normal assembly | Leave unpopulated; no guessed capacitance. | engineering selection; validate during prototype
R304 | 1 | 10k | Not yet qualified | 0603 metric1608, 1%, 0.1W | Factory reflow recommended | HOLD - electrical specification selected; qualify exact MPN | Holds display unselected during ROM serial TX on GPIO43. | engineering selection; validate during prototype
R305 | 1 | 10k | Not yet qualified | 0603 metric1608, 1%, 0.1W | Factory reflow recommended | HOLD - electrical specification selected; qualify exact MPN | Deasserted default; firmware drives low reset pulse before initialization. | engineering selection; validate during prototype
R306 | 1 | 33ohm | Not yet qualified | 0603 metric1608, 1%, 0.1W | Factory reflow recommended | HOLD - electrical specification selected; qualify exact MPN | Source damping; initialize SPI2 at conservative clock for cable. | engineering selection; validate during prototype
R307 | 1 | 33ohm | Not yet qualified | 0603 metric1608, 1%, 0.1W | Factory reflow recommended | HOLD - electrical specification selected; qualify exact MPN | Source damping. | engineering selection; validate during prototype
C305 | 1 | 10uF | Not yet qualified | 0603 metric1608 X7R (except marked C0G), 10V minimum | Factory reflow recommended | HOLD - electrical specification selected; qualify exact MPN | At J7 display connector. | engineering selection; validate during prototype
C306 | 1 | 100nF | Not yet qualified | 0603 metric1608 X7R (except marked C0G), 10V minimum | Factory reflow recommended | HOLD - electrical specification selected; qualify exact MPN | At J7. | engineering selection; validate during prototype
R310 | 1 | 10k | Not yet qualified | 0603 metric1608, 1%, 0.1W | Factory reflow recommended | HOLD - electrical specification selected; qualify exact MPN | SD external pull-up, including unused data contacts. | engineering selection; validate during prototype
R311 | 1 | 10k | Not yet qualified | 0603 metric1608, 1%, 0.1W | Factory reflow recommended | HOLD - electrical specification selected; qualify exact MPN | SD external pull-up, including unused data contacts. | engineering selection; validate during prototype
R312 | 1 | 10k | Not yet qualified | 0603 metric1608, 1%, 0.1W | Factory reflow recommended | HOLD - electrical specification selected; qualify exact MPN | SD external pull-up, including unused data contacts. | engineering selection; validate during prototype
R313 | 1 | 10k | Not yet qualified | 0603 metric1608, 1%, 0.1W | Factory reflow recommended | HOLD - electrical specification selected; qualify exact MPN | SD external pull-up, including unused data contacts. | engineering selection; validate during prototype
R314 | 1 | 10k | Not yet qualified | 0603 metric1608, 1%, 0.1W | Factory reflow recommended | HOLD - electrical specification selected; qualify exact MPN | SD external pull-up, including unused data contacts. | engineering selection; validate during prototype
R315 | 1 | 22ohm | Not yet qualified | 0603 metric1608, 1%, 0.1W | Factory reflow recommended | HOLD - electrical specification selected; qualify exact MPN | At ESP source; SDMMC initialize400kHz, validate20MHz1bit before40MHz. | engineering selection; validate during prototype
R316 | 1 | 100k | Not yet qualified | 0603 metric1608, 1%, 0.1W | Factory reflow recommended | HOLD - electrical specification selected; qualify exact MPN | Card detector only; card inserted closes switch to GND. | engineering selection; validate during prototype
C310 | 1 | 10uF | Not yet qualified | 0603 metric1608 X7R (except marked C0G), 10V minimum | Factory reflow recommended | HOLD - electrical specification selected; qualify exact MPN | At SD socket power contacts. | engineering selection; validate during prototype
C311 | 1 | 100nF | Not yet qualified | 0603 metric1608 X7R (except marked C0G), 10V minimum | Factory reflow recommended | HOLD - electrical specification selected; qualify exact MPN | At SD socket. | engineering selection; validate during prototype
C312 | 1 | 10nF | Not yet qualified | 0603 metric1608 X7R (except marked C0G), 10V minimum | Factory reflow recommended | HOLD - electrical specification selected; qualify exact MPN | 1ms nominal CD RC; debounce and unmount in firmware. | engineering selection; validate during prototype
R320 | 1 | 330ohm | Not yet qualified | 0603 metric1608, 1%, 0.1W | Factory reflow recommended | HOLD - electrical specification selected; qualify exact MPN | Protect RTC backup supply; NOT raw unprotected cell; RTC trickle disabled. | engineering selection; validate during prototype
R321 | 1 | 10k | Not yet qualified | 0603 metric1608, 1%, 0.1W | Factory reflow recommended | HOLD - electrical specification selected; qualify exact MPN | Never float EVI. External-event feature disabled. | engineering selection; validate during prototype
C320 | 1 | 100nF | Not yet qualified | 0603 metric1608 X7R (except marked C0G), 10V minimum | Factory reflow recommended | HOLD - electrical specification selected; qualify exact MPN | At RV3028 VDD. | engineering selection; validate during prototype
C321 | 1 | 100nF | Not yet qualified | 0603 metric1608 X7R (except marked C0G), 10V minimum | Factory reflow recommended | HOLD - electrical specification selected; qualify exact MPN | At RV3028 backup pin. | engineering selection; validate during prototype
C330 | 1 | 100nF | Not yet qualified | 0603 metric1608 X7R (except marked C0G), 10V minimum | Factory reflow recommended | HOLD - electrical specification selected; qualify exact MPN | At PCA9536 VCC. | engineering selection; validate during prototype
R330 | 1 | 47k | Not yet qualified | 0603 metric1608, 1%, 0.1W | Factory reflow recommended | HOLD - electrical specification selected; qualify exact MPN | External pull-up for direct GPIO7 Start/Enter wake input; remains defined during deep sleep. | engineering selection; validate during prototype
C331 | 1 | 10nF | Not yet qualified | 0603 metric1608 X7R (except marked C0G), 10V minimum | Factory reflow recommended | HOLD - electrical specification selected; qualify exact MPN | Noise filter; software debounce remains required. | engineering selection; validate during prototype
R331 | 1 | 47k | Not yet qualified | 0603 metric1608, 1%, 0.1W | Factory reflow recommended | HOLD - electrical specification selected; qualify exact MPN | External pull-up supplements expander weak pull-up. | engineering selection; validate during prototype
C332 | 1 | 10nF | Not yet qualified | 0603 metric1608 X7R (except marked C0G), 10V minimum | Factory reflow recommended | HOLD - electrical specification selected; qualify exact MPN | Noise filter; software debounce remains required. | engineering selection; validate during prototype
R332 | 1 | 47k | Not yet qualified | 0603 metric1608, 1%, 0.1W | Factory reflow recommended | HOLD - electrical specification selected; qualify exact MPN | External pull-up supplements expander weak pull-up. | engineering selection; validate during prototype
C333 | 1 | 10nF | Not yet qualified | 0603 metric1608 X7R (except marked C0G), 10V minimum | Factory reflow recommended | HOLD - electrical specification selected; qualify exact MPN | Noise filter; software debounce remains required. | engineering selection; validate during prototype
R333 | 1 | 47k | Not yet qualified | 0603 metric1608, 1%, 0.1W | Factory reflow recommended | HOLD - electrical specification selected; qualify exact MPN | External pull-up supplements expander weak pull-up. | engineering selection; validate during prototype
C334 | 1 | 10nF | Not yet qualified | 0603 metric1608 X7R (except marked C0G), 10V minimum | Factory reflow recommended | HOLD - electrical specification selected; qualify exact MPN | Noise filter; software debounce remains required. | engineering selection; validate during prototype
C340 | 1 | 100nF | Not yet qualified | 0603 metric1608 X7R (except marked C0G), 10V minimum | Factory reflow recommended | HOLD - electrical specification selected; qualify exact MPN | At TS3USB221A VCC. | engineering selection; validate during prototype
R341 | 1 | 49.9ohm | Not yet qualified | 0603 metric1608, 1%, 0.1W | Factory reflow recommended | HOLD - electrical specification selected; qualify exact MPN | Unused USB switch port termination per TI guidance. | engineering selection; validate during prototype
R342 | 1 | 49.9ohm | Not yet qualified | 0603 metric1608, 1%, 0.1W | Factory reflow recommended | HOLD - electrical specification selected; qualify exact MPN | Unused USB switch port termination per TI guidance. | engineering selection; validate during prototype
SW300 | 1 | B3U-1000P | B3U-1000P | Omron B3U 3.0x2.5mm, top-actuated 2-terminal SMD, no ground terminal or boss | Factory reflow recommended | Selected design candidate; footprint and release review pending | BOOT; normally-open momentary. Verified two-terminal SPST from manufacturer terminal drawing. Mechanical case button height not frozen. | https://omronfs.omron.com/en_US/ecb/products/pdf/en-b3u.pdf
SW301 | 1 | B3U-1000P | B3U-1000P | Omron B3U 3.0x2.5mm, top-actuated 2-terminal SMD, no ground terminal or boss | Factory reflow recommended | Selected design candidate; footprint and release review pending | START_ENTER; normally-open momentary. Verified two-terminal SPST from manufacturer terminal drawing. Mechanical case button height not frozen. | https://omronfs.omron.com/en_US/ecb/products/pdf/en-b3u.pdf
SW302 | 1 | B3U-1000P | B3U-1000P | Omron B3U 3.0x2.5mm, top-actuated 2-terminal SMD, no ground terminal or boss | Factory reflow recommended | Selected design candidate; footprint and release review pending | STOP_BACK; normally-open momentary. Verified two-terminal SPST from manufacturer terminal drawing. Mechanical case button height not frozen. | https://omronfs.omron.com/en_US/ecb/products/pdf/en-b3u.pdf
SW303 | 1 | B3U-1000P | B3U-1000P | Omron B3U 3.0x2.5mm, top-actuated 2-terminal SMD, no ground terminal or boss | Factory reflow recommended | Selected design candidate; footprint and release review pending | UP; normally-open momentary. Verified two-terminal SPST from manufacturer terminal drawing. Mechanical case button height not frozen. | https://omronfs.omron.com/en_US/ecb/products/pdf/en-b3u.pdf
SW304 | 1 | B3U-1000P | B3U-1000P | Omron B3U 3.0x2.5mm, top-actuated 2-terminal SMD, no ground terminal or boss | Factory reflow recommended | Selected design candidate; footprint and release review pending | DOWN; normally-open momentary. Verified two-terminal SPST from manufacturer terminal drawing. Mechanical case button height not frozen. | https://omronfs.omron.com/en_US/ecb/products/pdf/en-b3u.pdf
SW305 | 1 | B3U-1000P | B3U-1000P | Omron B3U 3.0x2.5mm, top-actuated 2-terminal SMD, no ground terminal or boss | Factory reflow recommended | Selected design candidate; footprint and release review pending | RESET; normally-open momentary. Verified two-terminal SPST from manufacturer terminal drawing. Mechanical case button height not frozen. | https://omronfs.omron.com/en_US/ecb/products/pdf/en-b3u.pdf
U20 | 1 | IM69D128SV01XTMA1 | IM69D128SV01XTMA1 | Infineon PG-TLGA-5-2, 3.50x2.65mm, bottom acoustic port | Factory reflow recommended | Selected design candidate; footprint and release review pending | Exact IM69D128SV01 manufacturer land pattern; 0.6 mm nonplated PCB acoustic hole. Two opposite-edge outputs share PDM_DIN_PAIR to U23 pin 10. Raised case cap is a protected acoustic opening, not an exposed sensor. | https://www.infineon.com/assets/row/public/documents/24/49/infineon-im69d128s-datasheet-en.pdf
U21 | 1 | IM69D128SV01XTMA1 | IM69D128SV01XTMA1 | Infineon PG-TLGA-5-2, 3.50x2.65mm, bottom acoustic port | Factory reflow recommended | Selected design candidate; footprint and release review pending | Exact IM69D128SV01 manufacturer land pattern; 0.6 mm nonplated PCB acoustic hole. Two opposite-edge outputs share PDM_DIN_PAIR to U23 pin 10. Raised case cap is a protected acoustic opening, not an exposed sensor. | https://www.infineon.com/assets/row/public/documents/24/49/infineon-im69d128s-datasheet-en.pdf
R201 | 1 | 100 ohm 1% | Not yet qualified | 0805 | Factory reflow recommended | HOLD - electrical specification selected; qualify exact MPN | 100 ohm at microphone DATA pin; the two LR-selected tri-state microphone outputs share one PDM data net. | Quipus engineering selection; see audio-design.md
R202 | 1 | 100 ohm 1% | Not yet qualified | 0805 | Factory reflow recommended | HOLD - electrical specification selected; qualify exact MPN | 100 ohm at microphone DATA pin; the two LR-selected tri-state microphone outputs share one PDM data net. | Quipus engineering selection; see audio-design.md
R203 | 1 | 33 ohm 1% | Not yet qualified | 0805 | Factory reflow recommended | HOLD - electrical specification selected; qualify exact MPN | 33 ohm source termination immediately at U24 output; tune only following oscilloscope measurements. | Quipus engineering selection; see audio-design.md
R204 | 1 | 0 ohm | Not yet qualified | 0805 | Factory reflow recommended | HOLD - electrical specification selected; qualify exact MPN | Microphone-rail measurement link. Not a load switch. | Quipus engineering selection; see audio-design.md
C200 | 1 | 1uF X7R 10V | Not yet qualified | 0805 | Factory reflow recommended | HOLD - electrical specification selected; qualify exact MPN | Place at U20 VDD. | Quipus engineering selection; see audio-design.md
C201 | 1 | 100nF X7R 10V | Not yet qualified | 0805 | Factory reflow recommended | HOLD - electrical specification selected; qualify exact MPN | Place at U20 VDD. | Quipus engineering selection; see audio-design.md
C202 | 1 | 1uF X7R 10V | Not yet qualified | 0805 | Factory reflow recommended | HOLD - electrical specification selected; qualify exact MPN | Place at U21 VDD. | Quipus engineering selection; see audio-design.md
C203 | 1 | 100nF X7R 10V | Not yet qualified | 0805 | Factory reflow recommended | HOLD - electrical specification selected; qualify exact MPN | Place at U21 VDD. | Quipus engineering selection; see audio-design.md
C204 | 1 | 4.7uF X7R 10V | Not yet qualified | 0805 | Factory reflow recommended | HOLD - electrical specification selected; qualify exact MPN | Local mic-rail reservoir. | Quipus engineering selection; see audio-design.md
U22 | 1 | MAX98357AETE+ | MAX98357AETE+ | TQFN16 3x3mm exposed-pad T1633+4; 21-0136/90-0031 | Factory reflow recommended | Selected design candidate; footprint and release review pending | Exposed pad is modelled as 17: cross-check CAD package convention. A version uses I2S; B version is not a substitute. SD_MODE high selects left channel; low shuts down. Supply 2.5â€“5.5 V; 3.3 V GPIO compatible. Speaker outputs are differential; neither is GND. | https://www.analog.com/media/en/technical-documentation/data-sheets/max98357a-max98357b.pdf
R207 | 1 | 33 ohm 1% | Not yet qualified | 0805 | Factory reflow recommended | HOLD - electrical specification selected; qualify exact MPN | At ESP32 I2S1 DATA source. | Quipus engineering selection; see audio-design.md
R208 | 1 | 100k 1% | Not yet qualified | 0805 | Factory reflow recommended | HOLD - electrical specification selected; qualify exact MPN | Selects 3 dB gain. Connect to SYS_SW, the amplifier supply, rather than 3V3. | Quipus engineering selection; see audio-design.md
R209 | 1 | 100k 1% | Not yet qualified | 0805 | Factory reflow recommended | HOLD - electrical specification selected; qualify exact MPN | Keep amplifier shut down during reset. | Quipus engineering selection; see audio-design.md
R210 | 1 | 33 ohm 1% | Not yet qualified | 0805 | Factory reflow recommended | HOLD - electrical specification selected; qualify exact MPN | At ESP32 I2S1 WS source. | Quipus engineering selection; see audio-design.md
R211 | 1 | 33 ohm 1% | Not yet qualified | 0805 | Factory reflow recommended | HOLD - electrical specification selected; qualify exact MPN | At ESP32 I2S1 BCLK source. | Quipus engineering selection; see audio-design.md
C205 | 1 | 100nF X7R 10V | Not yet qualified | 0805 | Factory reflow recommended | HOLD - electrical specification selected; qualify exact MPN | At U22 pins 7 and 8, with short ground return. | Quipus engineering selection; see audio-design.md
C206 | 1 | 10uF X7R 10V | Not yet qualified | 0805 | Factory reflow recommended | HOLD - electrical specification selected; qualify exact MPN | At U22 pins 7 and 8; verify effective capacitance at 4.4 V. | Quipus engineering selection; see audio-design.md
C207 | 0 | 47uF X7R 10V DNP | Not yet qualified | 1210 | Do not populate | DNP - decision pending; do not buy for normal assembly | Optional reservoir. Initially not populated; populate following supply transient test. | Quipus engineering selection; see audio-design.md
J5 | 1 | SM02B-SRSS-TB | SM02B-SRSS-TB | JST SH 1.0mm 1x2 right-angle SMD | Factory reflow recommended | Selected design candidate; footprint and release review pending | Mates SHR-02V-S. Neither pin is ground. Short twisted pair to 8 ohm, 2 W nominal dynamic speaker; exact speaker part pending. Speaker connector intentionally differs from battery series. | https://www.jst.com/products/crimp-style-connectors-wire-to-board-type/sh-connector
U23 | 1 | TLV320ADC5140IRTWR | TLV320ADC5140IRTWR | TI RTW0024A WQFN24 4x4mm 0.5mm pitch, exposed ground pad 25 | Factory reflow recommended | Selected design candidate; footprint and release review pending | ADC slave; ESP32 generates BCLK/FSYNC. Internal PLL derives clocks from BCLK. CH1/2 analog; CH3/4 digital PDMDIN2 on GPI3. Disable unused GPIO1/GPI4/GPO4 in firmware. Use I2C address 0x4C. EP25 is CAD convention requiring footprint verification. AREG/DREG are regulator outputs and must never be wired to 3.3 V. SHDNZ remains low until supplies settle. | https://www.ti.com/lit/ds/symlink/tlv320adc5140.pdf
U24 | 1 | SN74LVC1G17DBVR | SN74LVC1G17DBVR | TI DBV0005A SOT-23-5 | Factory reflow recommended | Selected design candidate; footprint and release review pending | Noninverting Schmitt clock buffer. Datasheet pin numbers verified for DBV. Candidate restores clock edge to meet microphone 13 ns maximum; loaded edge and overall setup/hold MUST be measured. Does not justify long PDM cables. | https://www.ti.com/lit/gpn/sn74lvc1g17
FB220 | 1 | BLM21PG221SN1D | BLM21PG221SN1D | 0805 | Factory reflow recommended | Selected design candidate; footprint and release review pending | 220 ohm at 100 MHz; 2 A rated; 0.045 ohm maximum DCR. AVDD filtering candidate; measure noise and stability with actual regulator/PCB. | https://www.murata.com/en-eu/api/pdfdownloadapi?cate=cgsubChipFerriBead&partno=BLM21PG221SN1D
R220 | 1 | 100k ohm 1% 0.125W | Not yet qualified | 0805 | Factory reflow recommended | HOLD - electrical specification selected; qualify exact MPN | ADC stays shut down during processor reset. | Quipus engineering selection; see audio-design.md
R221 | 1 | 33 ohm 1% 0.125W | Not yet qualified | 0805 | Factory reflow recommended | HOLD - electrical specification selected; qualify exact MPN | Source termination at ESP32 BCLK output. | Quipus engineering selection; see audio-design.md
R222 | 1 | 33 ohm 1% 0.125W | Not yet qualified | 0805 | Factory reflow recommended | HOLD - electrical specification selected; qualify exact MPN | Source termination at ESP32 FSYNC output. | Quipus engineering selection; see audio-design.md
R223 | 1 | 33 ohm 1% 0.125W | Not yet qualified | 0805 | Factory reflow recommended | HOLD - electrical specification selected; qualify exact MPN | Source termination at ADC output. | Quipus engineering selection; see audio-design.md
R224 | 1 | 100k ohm 1% 0.125W | Not yet qualified | 0805 | Factory reflow recommended | HOLD - electrical specification selected; qualify exact MPN | Defines buffer input low when ADC GPO3 is disabled, stopping microphone clock. | Quipus engineering selection; see audio-design.md
C220 | 1 | 1uF X7R 25V | Not yet qualified | 0805 | Factory reflow recommended | HOLD - electrical specification selected; qualify exact MPN | AVDD bulk bypass at pin1 | Quipus engineering selection; see audio-design.md
C221 | 1 | 100nF X7R 25V | Not yet qualified | 0805 | Factory reflow recommended | HOLD - electrical specification selected; qualify exact MPN | AVDD high-frequency bypass at pin1 | Quipus engineering selection; see audio-design.md
C222 | 1 | 10uF X7R 16V | Not yet qualified | 0805 | Factory reflow recommended | HOLD - electrical specification selected; qualify exact MPN | Internal 1.8 V analog regulator bypass; at pin2; no external load | Quipus engineering selection; see audio-design.md
C223 | 1 | 100nF X7R 25V | Not yet qualified | 0805 | Factory reflow recommended | HOLD - electrical specification selected; qualify exact MPN | Internal regulator high-frequency bypass at pin2 | Quipus engineering selection; see audio-design.md
C224 | 1 | 10uF X7R 16V | Not yet qualified | 0805 | Factory reflow recommended | HOLD - electrical specification selected; qualify exact MPN | Internal 1.5 V digital regulator bypass at pin24; no external load | Quipus engineering selection; see audio-design.md
C225 | 1 | 100nF X7R 25V | Not yet qualified | 0805 | Factory reflow recommended | HOLD - electrical specification selected; qualify exact MPN | Internal regulator high-frequency bypass at pin24 | Quipus engineering selection; see audio-design.md
C226 | 1 | 2.2uF X7R 16V | Not yet qualified | 0805 | Factory reflow recommended | HOLD - electrical specification selected; qualify exact MPN | Must retain >=1uF effective at2.75V. Set VREF quick charge to10ms, measure settling. | Quipus engineering selection; see audio-design.md
C227 | 1 | 100nF X7R 25V | Not yet qualified | 0805 | Factory reflow recommended | HOLD - electrical specification selected; qualify exact MPN | Reference bypass at pin3; direct short return to AVSS | Quipus engineering selection; see audio-design.md
C228 | 1 | 2.2uF X7R 16V | Not yet qualified | 0805 | Factory reflow recommended | HOLD - electrical specification selected; qualify exact MPN | Quiet microphone bias reservoir at pin5; validate effective capacitance and startup. | Quipus engineering selection; see audio-design.md
C229 | 1 | 100nF X7R 25V | Not yet qualified | 0805 | Factory reflow recommended | HOLD - electrical specification selected; qualify exact MPN | Bias high-frequency bypass at pin5; direct return to AVSS | Quipus engineering selection; see audio-design.md
C230 | 1 | 100nF X7R 25V | Not yet qualified | 0805 | Factory reflow recommended | HOLD - electrical specification selected; qualify exact MPN | At U24 pin5 | Quipus engineering selection; see audio-design.md
C231 | 1 | 10uF X7R 16V | Not yet qualified | 0805 | Factory reflow recommended | HOLD - electrical specification selected; qualify exact MPN | IOVDD bulk bypass at pin19 | Quipus engineering selection; see audio-design.md
C232 | 1 | 100nF X7R 25V | Not yet qualified | 0805 | Factory reflow recommended | HOLD - electrical specification selected; qualify exact MPN | IOVDD high-frequency bypass at pin19 | Quipus engineering selection; see audio-design.md
J8 | 1 | SJ1-3533NG | SJ1-3533NG | Same Sky SJ1-3533NG, right-angle 3-pin through-hole TRS | Through-hole hand option after practice; factory also possible | Selected design candidate; footprint and release review pending | Manufacturer sheet2 pinmap verified:1 sleeve,2 tip,3 ring. Ring intentionally NC for own mono accessory. No insertion-detect switch. Create/verify exact footprint and1:1 paper fit before fabrication. This is MIC IN, not headphone output. | https://www.sameskydevices.com/product/resource/sj1-353xng.pdf
R230 | 1 | 2.2k ohm 1% 0.125W | Not yet qualified | 0805 | Factory reflow recommended | HOLD - electrical specification selected; qualify exact MPN | Separate bias resistor for this capsule, located on main board. No extra bias resistor in puck. | Quipus engineering selection; see audio-design.md
R231 | 1 | 100 ohm 1% 0.125W | Not yet qualified | 0805 | Factory reflow recommended | HOLD - electrical specification selected; qualify exact MPN | Series transient/RF limiting before AC coupling; ESD validation still required. | Quipus engineering selection; see audio-design.md
R232 | 1 | 100 ohm 1% 0.125W | Not yet qualified | 0805 | Factory reflow recommended | HOLD - electrical specification selected; qualify exact MPN | Matched resistance for AC-coupled negative input branch. | Quipus engineering selection; see audio-design.md
C233 | 1 | 1uF X7R 25V | Not yet qualified | 0805 | Factory reflow recommended | HOLD - electrical specification selected; qualify exact MPN | AC coupling; verify low voltage coefficient at common-mode bias. Film alternative needs new footprint. | Quipus engineering selection; see audio-design.md
C234 | 1 | 1uF X7R 25V | Not yet qualified | 0805 | Factory reflow recommended | HOLD - electrical specification selected; qualify exact MPN | TI single-ended AC topology: INM connects to GND THROUGH coupling capacitor, not directly. | Quipus engineering selection; see audio-design.md
C235 | 1 | 100pF C0G 50V | Not yet qualified | 0805 | Factory reflow recommended | HOLD - electrical specification selected; qualify exact MPN | Initial RF bypass; characterize with cable and input source impedance. Does not replace input ESD qualification. | Quipus engineering selection; see audio-design.md
C236 | 1 | 100pF C0G 50V | Not yet qualified | 0805 | Factory reflow recommended | HOLD - electrical specification selected; qualify exact MPN | Matched RF bypass for input return branch. | Quipus engineering selection; see audio-design.md
D220 | 1 | TPD1E10B06DYAR | TPD1E10B06DYAR | TI DYA0002A SOD-523 | Factory reflow recommended | Selected design candidate; footprint and release review pending | Bidirectional5.5V standoff12pF TVS at socket. Physical pin1/2 interchangeable electrically. Does not hold ADC voltage under absolute max on its own: series resistance, board current path and pulse tests required. | https://www.ti.com/lit/ds/symlink/tpd1e10b06.pdf
J9 | 1 | SJ1-3533NG | SJ1-3533NG | Same Sky SJ1-3533NG, right-angle 3-pin through-hole TRS | Through-hole hand option after practice; factory also possible | Selected design candidate; footprint and release review pending | Manufacturer sheet2 pinmap verified:1 sleeve,2 tip,3 ring. Ring intentionally NC for own mono accessory. No insertion-detect switch. Create/verify exact footprint and1:1 paper fit before fabrication. This is MIC IN, not headphone output. | https://www.sameskydevices.com/product/resource/sj1-353xng.pdf
R235 | 1 | 2.2k ohm 1% 0.125W | Not yet qualified | 0805 | Factory reflow recommended | HOLD - electrical specification selected; qualify exact MPN | Separate bias resistor for this capsule, located on main board. No extra bias resistor in puck. | Quipus engineering selection; see audio-design.md
R236 | 1 | 100 ohm 1% 0.125W | Not yet qualified | 0805 | Factory reflow recommended | HOLD - electrical specification selected; qualify exact MPN | Series transient/RF limiting before AC coupling; ESD validation still required. | Quipus engineering selection; see audio-design.md
R237 | 1 | 100 ohm 1% 0.125W | Not yet qualified | 0805 | Factory reflow recommended | HOLD - electrical specification selected; qualify exact MPN | Matched resistance for AC-coupled negative input branch. | Quipus engineering selection; see audio-design.md
C238 | 1 | 1uF X7R 25V | Not yet qualified | 0805 | Factory reflow recommended | HOLD - electrical specification selected; qualify exact MPN | AC coupling; verify low voltage coefficient at common-mode bias. Film alternative needs new footprint. | Quipus engineering selection; see audio-design.md
C239 | 1 | 1uF X7R 25V | Not yet qualified | 0805 | Factory reflow recommended | HOLD - electrical specification selected; qualify exact MPN | TI single-ended AC topology: INM connects to GND THROUGH coupling capacitor, not directly. | Quipus engineering selection; see audio-design.md
C240 | 1 | 100pF C0G 50V | Not yet qualified | 0805 | Factory reflow recommended | HOLD - electrical specification selected; qualify exact MPN | Initial RF bypass; characterize with cable and input source impedance. Does not replace input ESD qualification. | Quipus engineering selection; see audio-design.md
C241 | 1 | 100pF C0G 50V | Not yet qualified | 0805 | Factory reflow recommended | HOLD - electrical specification selected; qualify exact MPN | Matched RF bypass for input return branch. | Quipus engineering selection; see audio-design.md
D221 | 1 | TPD1E10B06DYAR | TPD1E10B06DYAR | TI DYA0002A SOD-523 | Factory reflow recommended | Selected design candidate; footprint and release review pending | Bidirectional5.5V standoff12pF TVS at socket. Physical pin1/2 interchangeable electrically. Does not hold ADC voltage under absolute max on its own: series resistance, board current path and pulse tests required. | https://www.ti.com/lit/ds/symlink/tpd1e10b06.pdf
