NathanHor22/Quipus/hardware/quipus-pcb/rev-a/easyeda/native/page-order-ui.txt

- link:
  - /url: "#"
- generic "File":
  - generic: File (F)
- generic "Edit":
  - generic: Edit (E)
- generic "View":
  - generic: View (V)
- generic "Place":
  - generic: Place (P)
- generic "Route":
  - generic: Route (U)
- generic "More"
- generic: V3.2.149
- generic: Personal
- generic: EN
- generic "Notifications"
- generic "Homepage":
  - img "Avatar"
  - generic: nathanhor2001
- text: "Holiday Notice: EasyEDA team (Sep 25–27 & Oct 1–7) & JLCPCB factories (Sep 25, 27 & Oct 1–4) will be on holiday. Please order 3–5 days early!"
- link "View Details >":
  - /url: https://oshwlab.com/forum/post/17ff2809dd9541b7a600b026e47e58de
- generic: 
- generic "Open Project(Ctrl+O)"
- generic "Save(Ctrl+Shift+S)"
- generic "Save All(Ctrl+S)"
- generic "Undo(Ctrl+Z)"
- generic "Redo(Ctrl+Y)"
- generic "Common(Default)":
  - generic: Common(Default)
- generic "Arrays"
- generic "Find(Ctrl+F)"
- generic "2D Preview"
- generic "3D Preview"
- generic "Fit Area Selection View"
- generic "Unit":
  - generic: mil
- generic "Grid Style"
- generic "Via"
- generic "Pad(Alt+P)"
- generic "Line Pads"
- generic "Rectangle Pads"
- generic "Shaped Pad"
- generic "Fill Region"
- generic "Slot Region"
- generic "Prohibited Region"
- generic "Polyline(Alt+L)"
- generic "Text"
- generic "Length(Alt+N)"
- generic "More"
- 'generic "Auto Hide : Open"'
- generic "All Projects":
  - generic: A
  - generic: l
  - generic: l
  - generic: P
  - generic: r
  - generic: o
  - generic: j
  - generic: e
  - generic: c
  - generic: t
  - generic: s
- generic "Project Design":
  - generic: P
  - generic: r
  - generic: o
  - generic: j
  - generic: e
  - generic: c
  - generic: t
  - generic: D
  - generic: e
  - generic: s
  - generic: i
  - generic: g
  - generic: "n"
- generic "Lib Design":
  - generic: L
  - generic: i
  - generic: b
  - generic: D
  - generic: e
  - generic: s
  - generic: i
  - generic: g
  - generic: "n"
- generic "Common Library":
  - generic: C
  - generic: o
  - generic: m
  - generic: m
  - generic: o
  - generic: "n"
  - generic: L
  - generic: i
  - generic: b
  - generic: r
  - generic: a
  - generic: r
  - generic: "y"
- text: 
- generic "Page":
  - generic: Page
- generic "Search"
- generic "Filter"
- textbox
- list:
  - generic "Quipus A1 – Hardware Rev A":
    - generic "main"
    - generic: Quipus A1 – Hardware Rev A
  - 'generic "Board: Quipus-A1"':
    - generic: Quipus-A1
  - 'generic "Schematic: Quipus-A1"':
    - generic: Quipus-A1
  - 'generic "Page: 1. 01 USB-C and charger"':
    - generic: 1. 01 USB-C and charger
  - 'generic "Page: 2. 02 USB current and suspend"':
    - generic: 2. 02 USB current and suspend
  - 'generic "Page: 3. 03 Power switch and always-on"':
    - generic: 3. 03 Power switch and always-on
  - 'generic "Page: 4. 04 Main 3V3 regulator"':
    - generic: 4. 04 Main 3V3 regulator
  - 'generic "Page: 5. 05 Battery fuel gauge"':
    - generic: 5. 05 Battery fuel gauge
  - 'generic "Page: 6. 06 Processor display and SD"':
    - generic: 6. 06 Processor display and SD
  - 'generic "Page: 7. 07 Controller support"':
    - generic: 7. 07 Controller support
  - 'generic "Page: 8. 08 Buttons and service"':
    - generic: 8. 08 Buttons and service
  - 'generic "Page: 9. 09 Microphones and speaker"':
    - generic: 9. 09 Microphones and speaker
  - 'generic "PCB: Quipus-A1"':
    - generic: Quipus-A1
- text: ✔
- generic "Start Page":
  - generic: Start Page
- generic "Quipus-A1":
  - generic: Quipus-A1
  - text: 
- generic "01 USB-C and charger.Quipus-A1":
  - generic: 01 USB-C and charger.Quipus-A1
  - text: 
- generic "08 Buttons and service.Quipus-A1":
  - generic: 08 Buttons and service.Quipus-A1
  - text: 
- generic "09 Microphones and speaker.Quipus-A1":
  - generic: 09 Microphones and speaker.Quipus-A1
  - text: 
- generic "07 Controller support.Quipus-A1":
  - generic: 07 Controller support.Quipus-A1
  - text: 
- generic "06 Processor display and SD.Quipus-A1":
  - generic: 06 Processor display and SD.Quipus-A1
  - text: 
- generic "05 Battery fuel gauge.Quipus-A1":
  - generic: 05 Battery fuel gauge.Quipus-A1
  - text: 
- generic "04 Main 3V3 regulator.Quipus-A1":
  - generic: 04 Main 3V3 regulator.Quipus-A1
  - text: 
- generic "03 Power switch and always-on.Quipus-A1":
  - generic: 03 Power switch and always-on.Quipus-A1
  - text: 
- generic "02 USB current and suspend.Quipus-A1":
  - generic: 02 USB current and suspend.Quipus-A1
  - text: 
- generic "Quipus-A1":
  - generic: Quipus-A1
  - text: 
- generic "Quipus:Infineon_IM69D128SV01_PG-TLGA-5-2_2.65x3.50mm_NPTH0.60":
  - generic: Quipus:Infineon_IM69D128SV01_PG-TLGA-5-2_2.65x3.50mm_NPTH0.60
  - text: 
- iframe [id="frame_c5c3dbc7f1f36107@522f339b1e454ea3a6b4b8e11788511f"]
- generic: Top
- generic: In1.Cu
- generic: In2.Cu
- generic: Bottom
- generic: Top Silkscreen
- generic: Bottom Silkscreen
- generic: Top Solder Mask
- generic: Bottom Solder Mask
- generic: Top Paste Mask
- generic: Bottom Paste Mask
- generic: Top Assembly
- generic: Bottom Assembly
- generic: Board Outline
- generic: Multi
- generic: Document
- generic: Mechanical
- generic: Drill Drawing
- generic: Ratline
- generic: Dwgs.User
- generic: Cmts.User
- generic: Eco1.User
- generic: B.CrtYd
- generic: F.CrtYd
- generic: F.Adhes
- generic: "X:"
- generic: "-100"
- generic: "Y:"
- generic: "140"
- generic: "dX:"
- generic: "-100"
- generic: "dY:"
- generic: "140"
- 'generic "Scaling Ratio: 2970%"':
  - textbox: 2970%
- 'generic "Grid Size: 5.0mil"':
  - textbox: "5.0"
- generic "mil":
  - generic: mil
- generic "Grid Style"
- 'generic "Auto Hide : Close"'
- generic "Layer":
  - generic: L
  - generic: a
  - generic: "y"
  - generic: e
  - generic: r
- generic "Filter":
  - generic: F
  - generic: i
  - generic: l
  - generic: t
  - generic: e
  - generic: r
- generic "Property":
  - generic: P
  - generic: r
  - generic: o
  - generic: p
  - generic: e
  - generic: r
  - generic: t
  - generic: "y"
- text: ✔ ✔ ✔ ✔ ✔ ✔ ✔ ✔ ✔ ✔ ✔ ✔ ✔ ✔ ✔ ✔
- combobox:
  - option "Common(Default)" [selected]
  - option "Top Assembly View"
  - option "Bottom Assembly View"
  - option "Only Top Side"
  - option "Only Bottom Side"
  - option "Save As Config..."
  - option "Set as default config"
  - option "Rename Config..." [disabled]
  - option "Save Config" [disabled]
  - option "Delete Config" [disabled]
- generic: Reset
- list:
  - listitem: All
  - listitem: Copper
  - listitem: Non-Copper
- generic: All
- generic: Top Side
- generic: 1 Top Layer
- generic: 3 Top Silkscreen Layer
- generic: 5 Top Solder Mask Layer
- generic: 7 Top Paste Mask Layer
- generic: 9 Top Assembly Layer
- generic: Bottom Side
- generic: 2 Bottom Layer
- generic: 4 Bottom Silkscreen Layer
- generic: 6 Bottom Solder Mask Layer
- generic: 8 Bottom Paste Mask Layer
- generic: 10 Bottom Assembly Layer
- generic: Inner Side
- generic: 15 In1.Cu
- generic: 16 In2.Cu
- generic: Other
- generic: 11 Board Outline Layer
- generic: 12 Multi-Layer
- generic: 13 Document Layer
- generic: 14 Mechanical Layer
- generic: 56 Drill Drawing Layer
- generic: 57 Ratline Layer
- generic: 71 Dwgs.User
- generic: 72 Cmts.User
- generic: 73 Eco1.User
- generic: 75 B.CrtYd
- generic: 76 F.CrtYd
- generic: 86 F.Adhes
- generic: Component
- generic: 48 Component Shape Layer
- generic: 49 Component Marking Layer
- generic: 50 Pin Soldering Layer
- generic: 51 Pin Floating Layer
- text: ✔ ✔ ✔ ✔ ✔ ✔ ✔ ✔ ✔ ✔ ✔ ✔ ✔ ✔ ✔ ✔ ✔ ✔ ✔ ✔ ✔ ✔ ✔ ✔ ✔ ✔ ✔ ✔ ✔ ✔ ✔ ✔ ✔ ✔ ✔ ✔ ✔ ✔ ✔ ✔ ✔ ✔ ✔ ✔ ✔ ✔ ✔
- 'generic "Auto Hide : Close"'
- generic "Library":
  - generic: Library
- generic "Log":
  - generic: Log
- generic "Find Result":
  - generic: Find Result
- text:  
- text: 
- generic: Floating Tool
- generic "Collapse"
- generic "close"
- generic "VCC"
- generic "+5V"
- generic "GND"
- generic "PGND"
- generic "AGND"
- generic "IN"
- generic "OUT"
- generic "BI"
- generic "IN"
- generic "OUT"
- generic "BI"
- generic "Net Label"
- generic "Short Flag"
- generic "No Connect Flag"
- generic "Differential Pairs Flag"
- generic "Test Point"
- generic: Floating Tool
- generic "Collapse"
- generic "close"
- generic "Normal View"
- generic "Outline View"
- generic "Gerber View"
- generic "Top Side"
- generic "Bottom Side"
- generic "Left Side"
- generic "Right Side"
- generic "Front Side"
- generic "Back Side"
- generic "Explode"
- generic "Fit All in Window"
- generic "Import Changes"
- generic "Refresh"
- generic: Table Setting
- generic "close"
- generic "Add Row Above"
- generic "Add Row Below"
- generic "Add Column Left"
- generic "Add Column Right"
- generic "Delete Row"
- generic "Delete Column"
- generic "Merge Cell"
- generic "Split Cell"
- generic "Border"
- generic "Full Border"
- generic "Outer Border"
- generic "Inner Border"
- generic "No Border"
- generic "Left Border"
- generic "Right Border"
- generic "Top Border"
- generic "Bottom Border"
- generic "Border Color"
- textbox
- generic: "#A00000"
- generic "Restore Default"
- generic "Align Top"
- generic "Align Top"
- generic "Align Vertical Centers"
- generic "Align Bottom"
- generic "Align Left"
- generic "Align Left"
- generic "Align Horizontal Centers"
- generic "Align Right"
