NathanHor22/Quipus/public/landing/prototype-components.webp

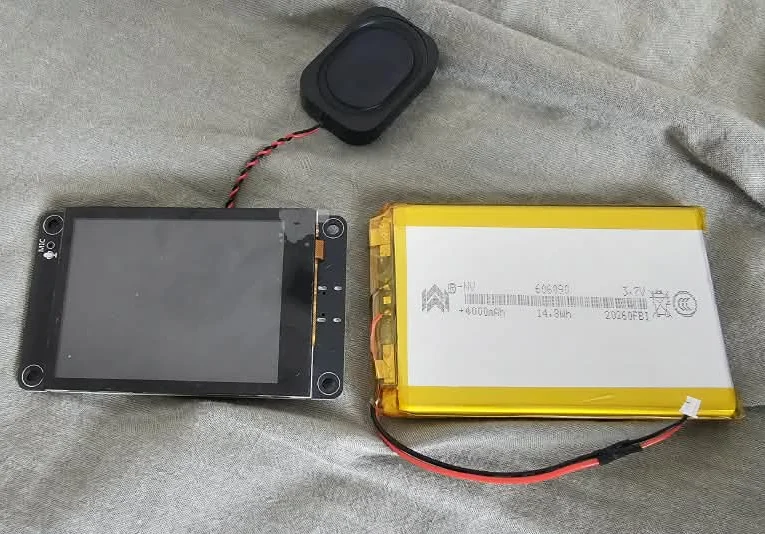
public/landing/prototype-components.webp
