NathanHor22/Quipus/output/pcb/Quipus-A1/model/Quipus-A1-placement-study.step

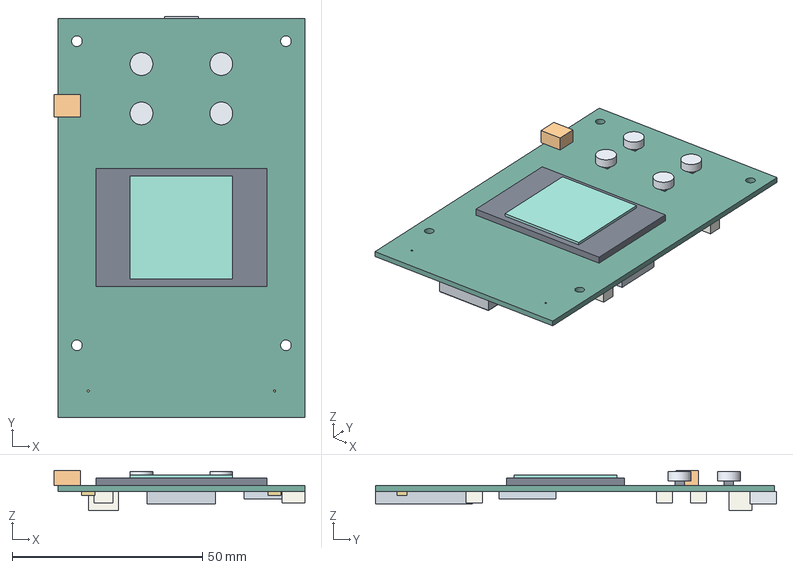
[picture p148: CAD file, 2026-10-06]
output/pcb/Quipus-A1/model/Quipus-A1-placement-study.step
66.0 x 105.5 x 10.6 mm
PCB_65x105x1p6
MIC_1_ENVELOPE
MIC_2_ENVELOPE
ESP32_MODULE_ENVELOPE
ANTENNA_REGION_INDICATOR
LCD_MODULE_ENVELOPE
DISPLAY_GLASS_INDICATOR
BUTTON_START_BODY
BUTTON_START_CAP
BUTTON_STOP_BODY
BUTTON_STOP_CAP
BUTTON_UP_BODY
BUTTON_UP_CAP
BUTTON_DOWN_BODY
BUTTON_DOWN_CAP
POWER_BUTTON_ENVELOPE
USB_C_ENVELOPE
MICRO_SD_ENVELOPE
MIC_EXPANSION_CONNECTOR_ENVELOPE
SPEAKER_CONNECTOR_ENVELOPE
BATTERY_CONNECTOR_ENVELOPE
NTC_3PIN_CONNECTOR_ENVELOPE
