NathanHor22/Quipus/output/pcb/Quipus-A1/model/board-outline-study.step

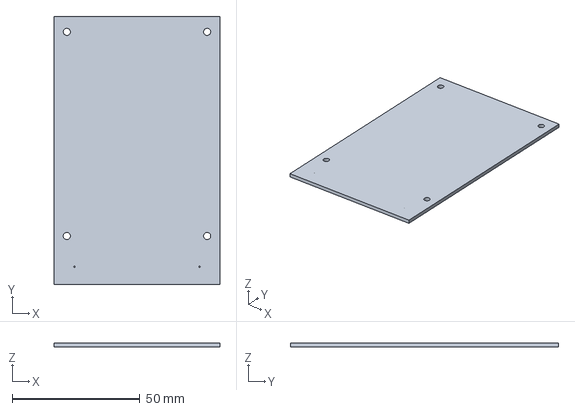
[picture p149: CAD file, 2026-10-06]
output/pcb/Quipus-A1/model/board-outline-study.step
65.0 x 105.0 x 1.60 mm
