NathanHor22/Quipus/hardware/lantern-firmware/main/setup-portal.html

QUIPUS DEVICE SETUP
192.168.4.1

A connection that stays with you.

# Connect your Quipus.

Wi-Fi gets you online.
Pairing makes it yours.

Wi-Fi

Checking...

Your account

Checking...

Wi-Fi settings

Wi-Fi name Wi-Fi passwordShow

Use a 2.4 GHz Wi-Fi network or phone hotspot. Leave both fields blank to keep saved Wi-Fi.

One-time pairing code

In your Quipus dashboard, open Devices and choose Create pairing code. Enter that code here to link your recordings.

Finishing the reset.

You can update Wi-Fi so Quipus can finish. Pairing stays locked until its private data is cleared.

Already paired to your account.

Changing Wi-Fi keeps your existing account and recordings. Use the dashboard to transfer the recorder to another person.

Save and connect

Settings stay on this recorder. It restarts after saving.

✓

## Settings saved.

Quipus is restarting. Keep it powered on.

Check the recorder screen for Wi-Fi and pairing confirmation.

Reconnect this phone or laptop to your normal internet. We’ll open your Quipus dashboard when it is reachable.

Return to Quipus

Your conversations. Connected.Local recorder setup
