NathanHor22/Quipus/docs/images/wifi-setup/desktop-connected-unpaired.png

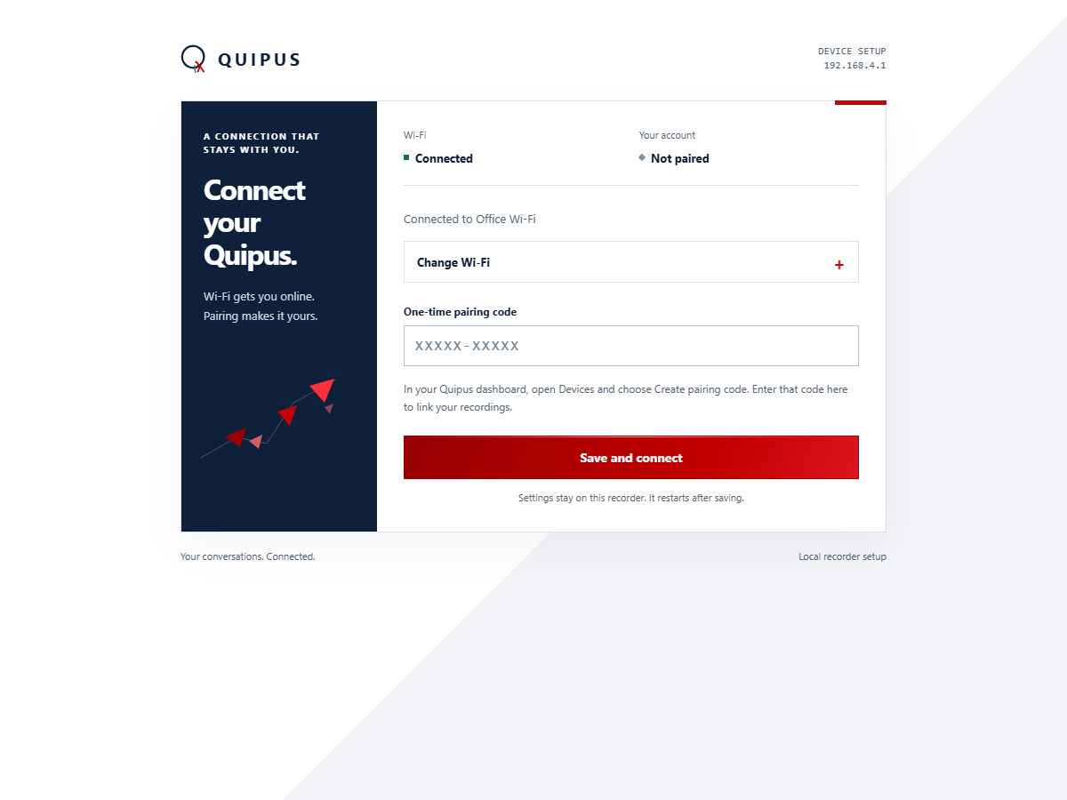
docs/images/wifi-setup/desktop-connected-unpaired.png
