NathanHor22/Quipus/docs/images/wifi-setup/small-mobile-connected-unpaired.png

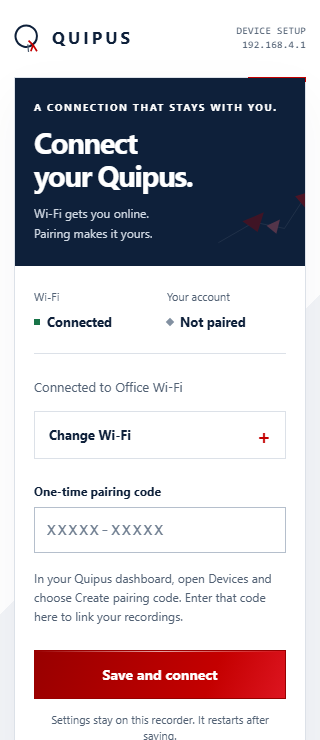
docs/images/wifi-setup/small-mobile-connected-unpaired.png
