NathanHor22/Quipus/output/ui-review/flow/final-glass-setup-device-desktop.png

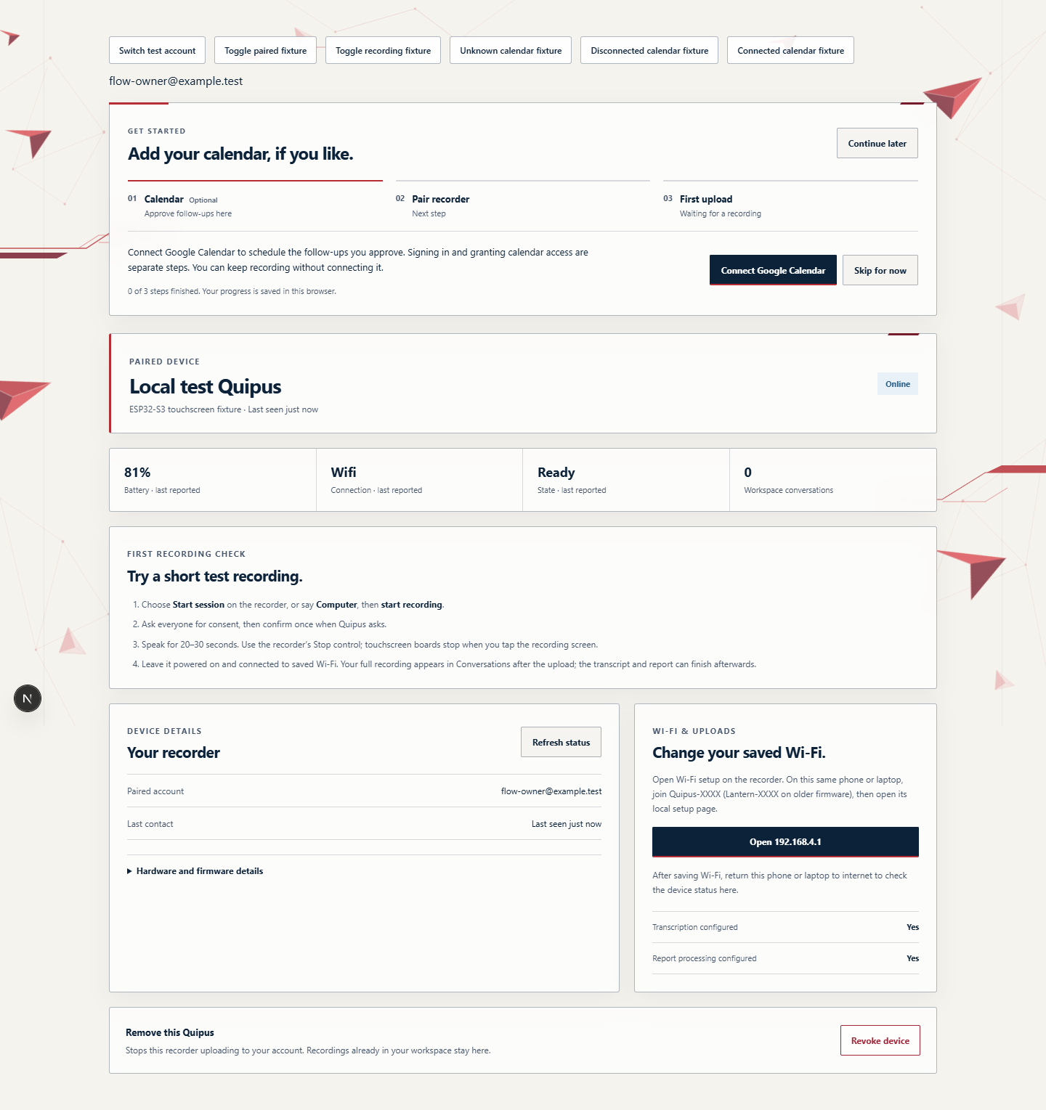
output/ui-review/flow/final-glass-setup-device-desktop.png
