NathanHor22/Quipus/output/ui-review/flow/final-glass-setup-device-mobile-320.png

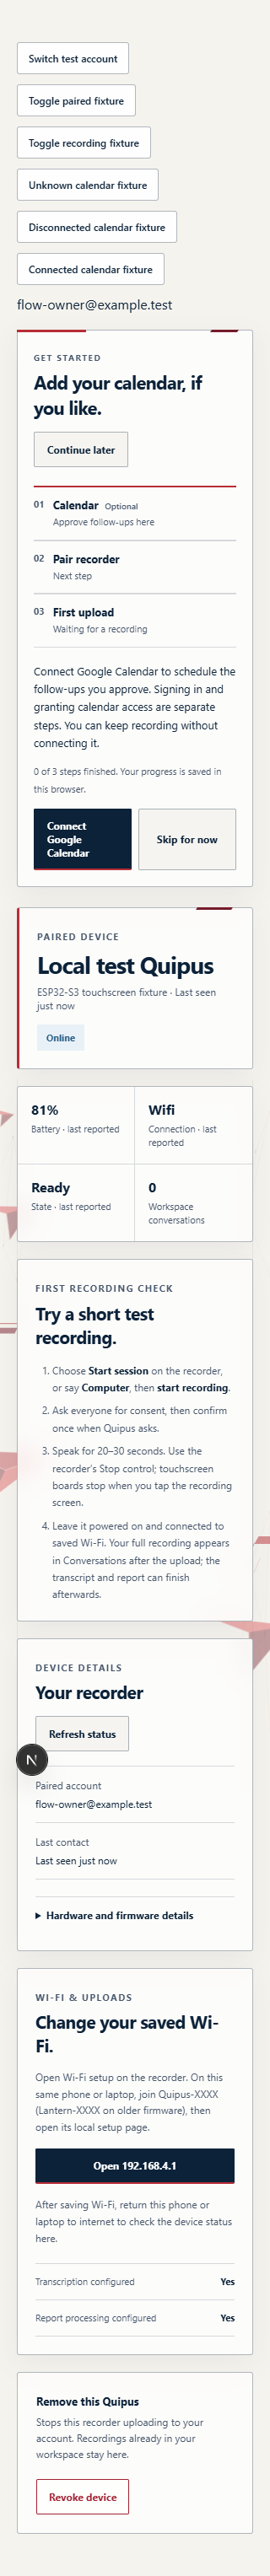
output/ui-review/flow/final-glass-setup-device-mobile-320.png
