NathanHor22/Quipus/output/ui-review/flow/final-glass-setup-device-mobile-390.png

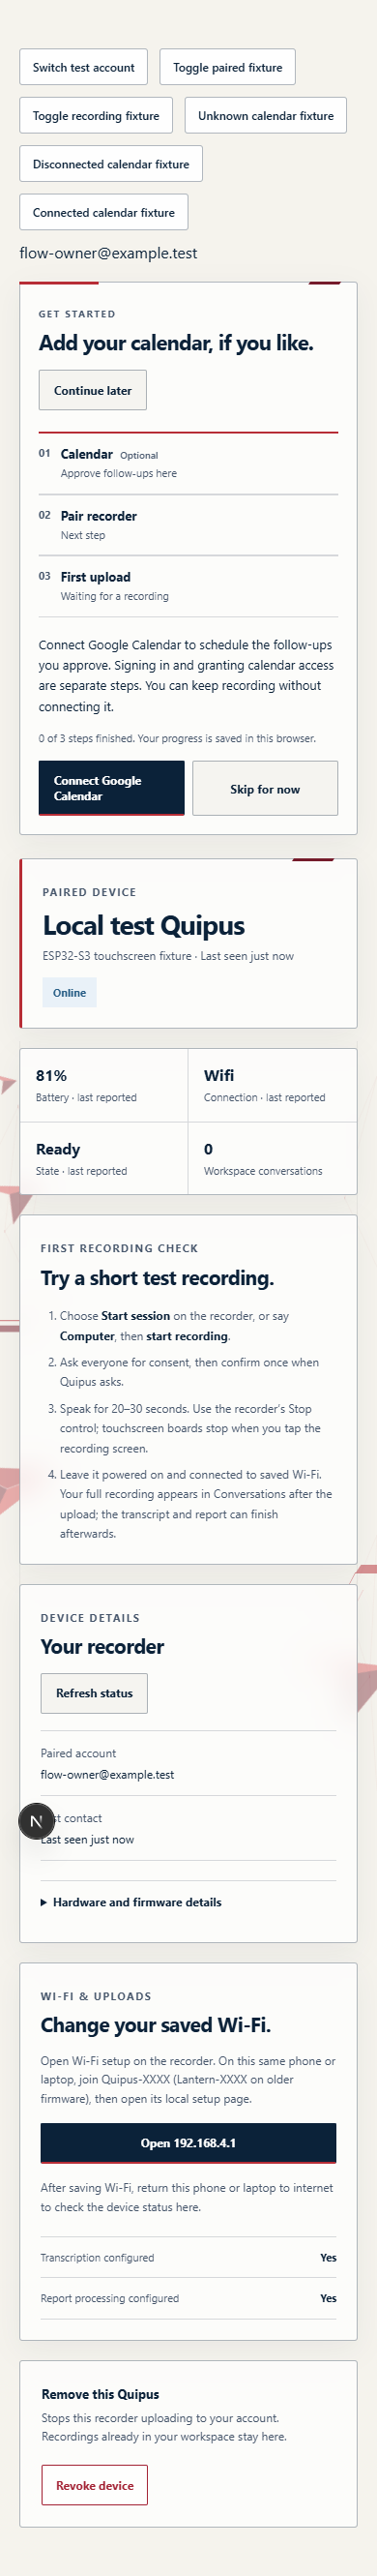
output/ui-review/flow/final-glass-setup-device-mobile-390.png
