NathanHor22/Quipus/output/ui-review/flow/glass-setup-pair-desktop.png

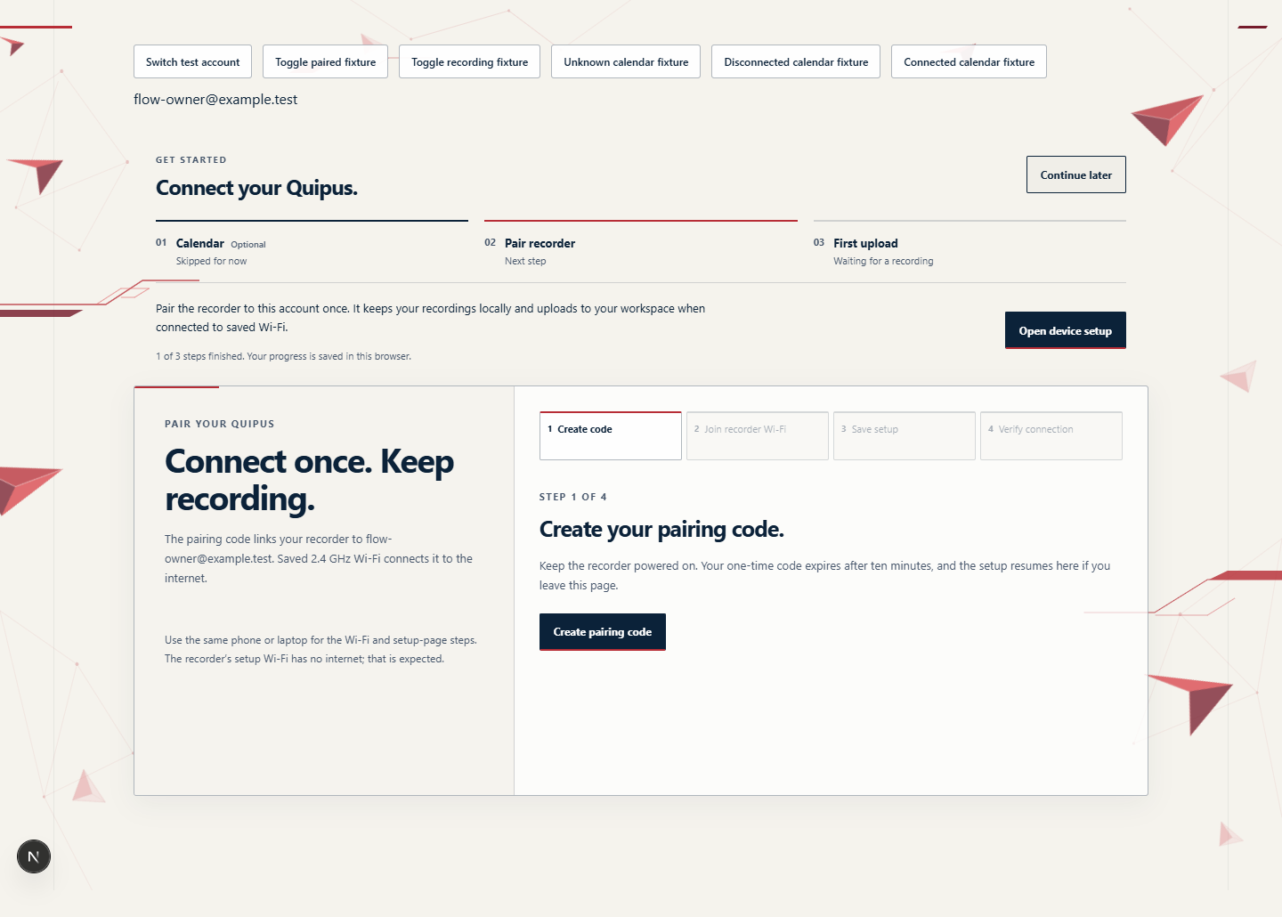
output/ui-review/flow/glass-setup-pair-desktop.png
