NathanHor22/Quipus/output/ui-review/flow/setup-pair-desktop.png

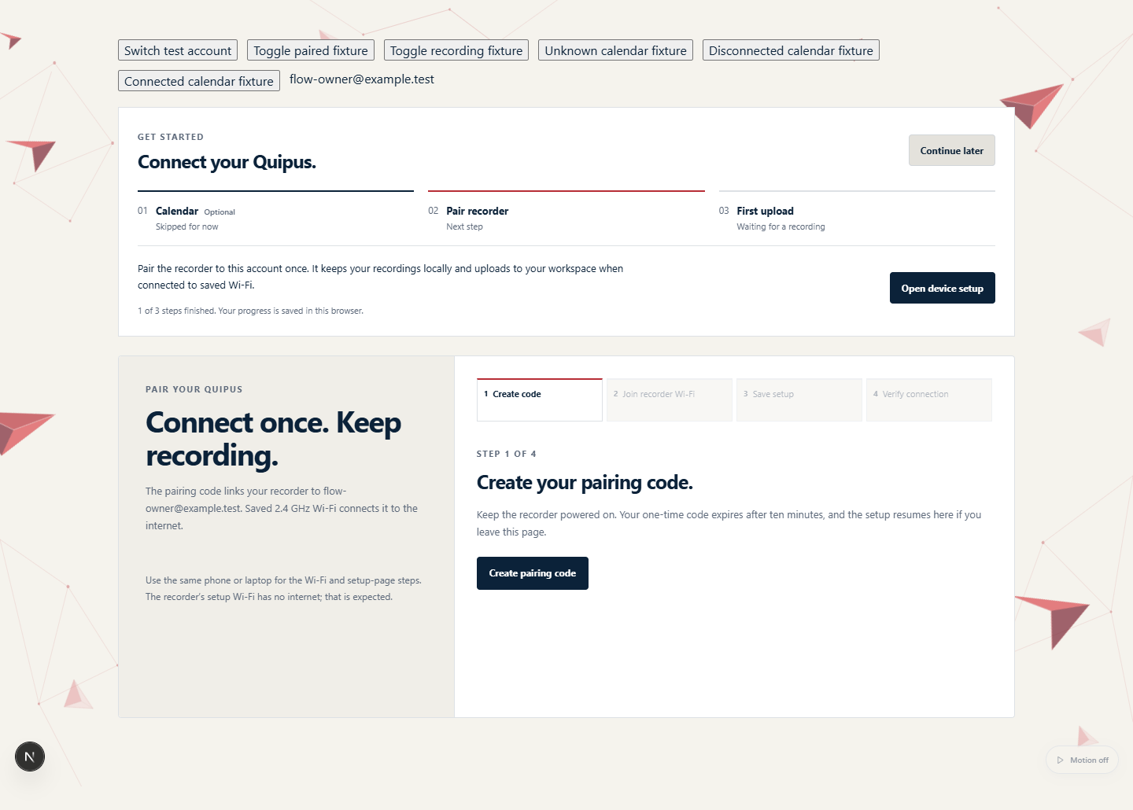
output/ui-review/flow/setup-pair-desktop.png
