NathanHor22/Quipus/output/wifi-setup/mobile-connected-unpaired.png

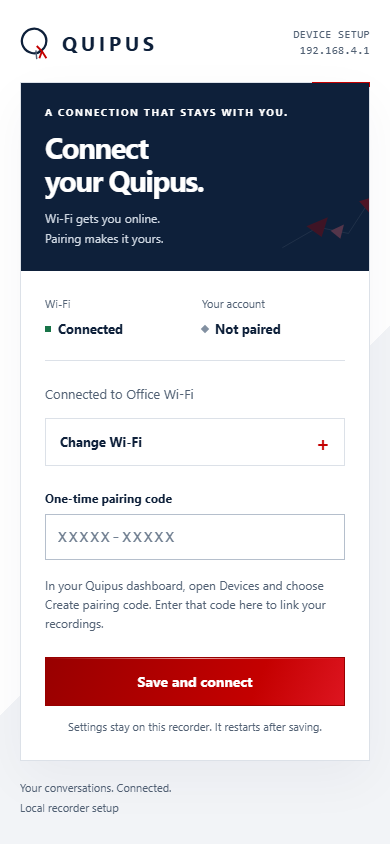
output/wifi-setup/mobile-connected-unpaired.png
