NathanHor22/Quipus/output/wifi-setup/mobile-new-device.png

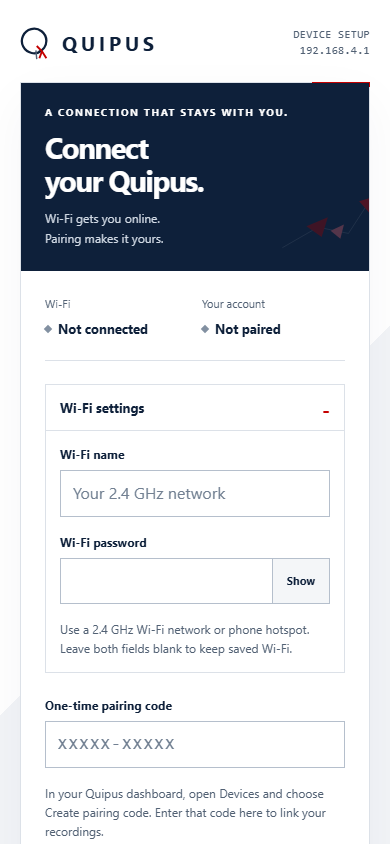
output/wifi-setup/mobile-new-device.png
