NathanHor22/Quipus/output/wifi-setup/mobile-saved.png

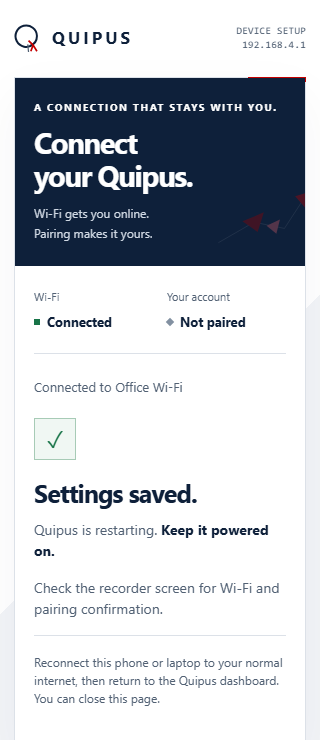
output/wifi-setup/mobile-saved.png
