NathanHor22/Quipus/output/ui-review/history-mobile-320.png

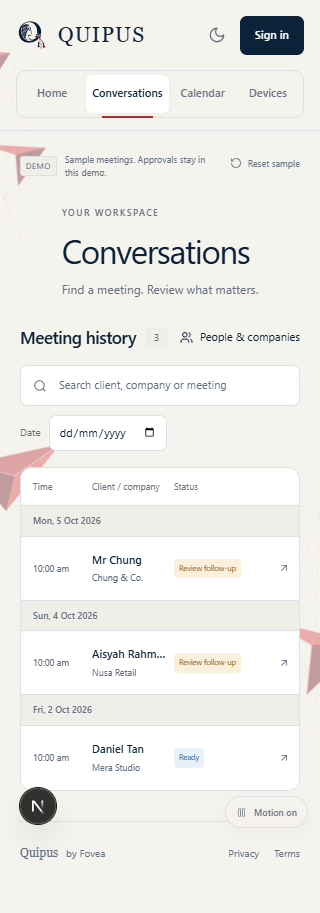
output/ui-review/history-mobile-320.png
