NathanHor22/Quipus/output/ui-review/history-mobile-390.png

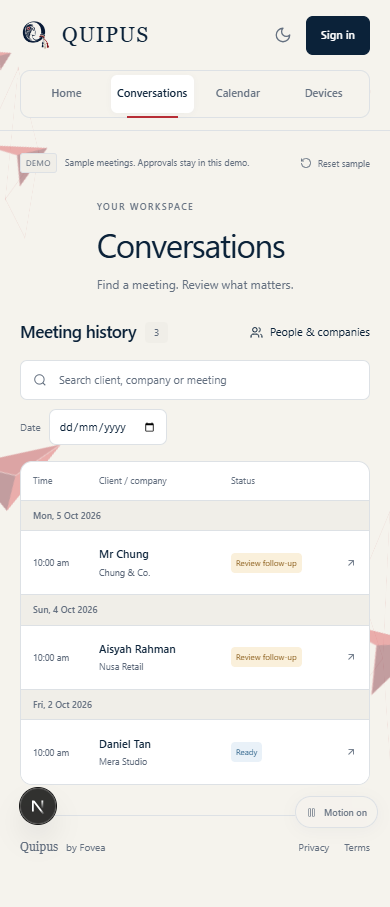
output/ui-review/history-mobile-390.png
