NathanHor22/Quipus/output/ui-review/production-history-mobile-320.png

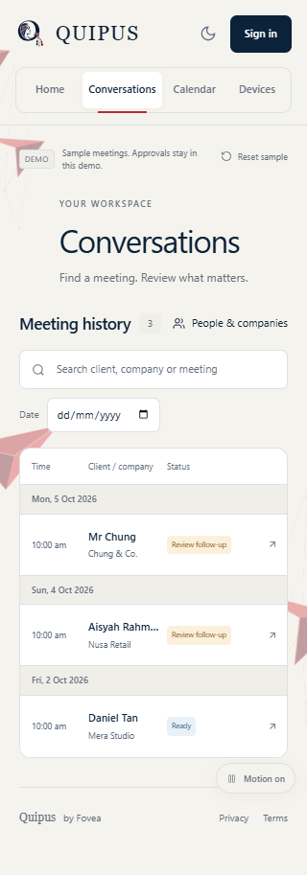
output/ui-review/production-history-mobile-320.png
