NathanHor22/Quipus/(list of files, drawings)

Other design files:
hardware/quipus-pcb/rev-a/easyeda/footprints-audio.json
hardware/quipus-pcb/rev-a/easyeda/footprints-controller.json
hardware/quipus-pcb/rev-a/easyeda/footprints-power.json
hardware/quipus-pcb/rev-a/easyeda/mic-annulus-repair-proposal.json
hardware/quipus-pcb/rev-a/easyeda/mic-placement-patch.json
hardware/quipus-pcb/rev-a/easyeda/native/pcb-position-audit.json
hardware/quipus-pcb/rev-a/easyeda/placement-proposal-validation.json
hardware/quipus-pcb/rev-a/easyeda/placement-validation.json
hardware/quipus-pcb/rev-a/easyeda/placement.json
hardware/quipus-pcb/rev-a/easyeda/power-placement-proposal.json
hardware/quipus-pcb/rev-b/easyeda/assignments.json
hardware/quipus-pcb/rev-b/easyeda/mic-geometry-check.json
hardware/quipus-pcb/rev-b/easyeda/native/pcb-mounting-holes-fixed.repair.json
hardware/quipus-pcb/rev-b/easyeda/placement-packing-audit.json
hardware/quipus-pcb/rev-b/easyeda/placement.json
hardware/quipus-pcb/rev-b/pcb-placement-plan.json
output/pcb/Quipus-A1-EasyEDA/import-validation.json
output/pcb/Quipus-A1-EasyEDA/manifest.json
output/pcb/Quipus-A1-EasyEDA/native-review/pcb-position-audit.json
output/pcb/Quipus-A1-EasyEDA/placement.json
output/pcb/Quipus-B1-EasyEDA/footprint-assignments.json
output/pcb/Quipus-B1-EasyEDA/import-validation.json
output/pcb/Quipus-B1-EasyEDA/manifest.json
output/pcb/Quipus-B1-EasyEDA/placement-packing-audit.json
output/pcb/Quipus-B1-EasyEDA/placement.json
