NathanHor22/Quipus/output/pcb/Quipus-A1-EasyEDA/Quipus-A1.kicad_pcb

## KiCad design output/pcb/Quipus-A1-EasyEDA/Quipus-A1.kicad_pcb (2026-10-06)

Schematic: Quipus-A1.kicad_sch

Parts:
C1: 4.7uF 16V X7R; C_0805_2012Metric
C2, C16: 10uF 10V X7R; C_0805_2012Metric
C3, C17, C18: 22uF 10V X7R; C_0805_2012Metric
C4, C7, C8, C9, C10, C11, C12, C19: 100nF 10V; C_0603_1608Metric
C5, C6, C14, C20: 1uF 10V X7R; C_0603_1608Metric
C13: 1uF 10V lowleakage X7R; C_0805_2012Metric
C15: 10nF 25V X7R; C_0603_1608Metric
C21: 470nF 6.3V X7R; C_0603_1608Metric
C200, C202: 1uF X7R 10V; C_0603_1608Metric
C201, C203, C205: 100nF X7R 10V; C_0603_1608Metric
C204: 4.7uF X7R 10V; C_0603_1608Metric
C206: 10uF X7R 10V; C_0805_2012Metric
C207: 47uF X7R 10V DNP; C_1210_3225Metric; not fitted
C300: 1uF; C_0603_1608Metric
C301, C305, C310: 10uF; C_0603_1608Metric
C302, C306, C311, C320, C321, C330, C340: 100nF; C_0603_1608Metric
C303, C304: DNP / C0G tuning footprint; C_0603_1608Metric; not fitted
C312, C331, C332, C333, C334: 10nF; C_0603_1608Metric
D1: TPD1E10B06DYAR; Quipus_TI_DYA0002A_TPD1E10B06
F1: Littelfuse 0467002.NRHF 2 A; Fuse_0603_1608Metric
J1: GCT USB4105-GF-A; Quipus_GCT_USB4105_GF_A_SHARED_CONTACTS
J2: JST S2B-PH-SM4-TB(LF)(SN) battery; JST_PH_S2B-PH-SM4-TB_1x02-1MP_P2.00mm_Horizontal
J3: 3-pin keyed NTC connector - JST SH family candida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; JST_SH_SM03B-SRSS-TB_1x03-1MP_P1.00mm_Horizontal
J4: SM04B-SRSS-TB; JST_SH_SM04B-SRSS-TB_1x04-1MP_P1.00mm_Horizontal
J5: SM02B-SRSS-TB; JST_SH_SM02B-SRSS-TB_1x02-1MP_P1.00mm_Horizontal
J6: DM3AT-SF-PEJM5; Quipus_Hirose_DM3AT-SF-PEJM5_AB
J7: B8B-PH-K-S(LF)(SN); JST_PH_B8B-PH-K_1x08_P2.00mm_Vertical
L1: 0.47uH Coilcraft XFL4015-471ME; Quipus_Coilcraft_XFL4015
R1: 1.24k 1%; R_0603_1608Metric
R2: 2.00k 1%; R_0603_1608Metric
R3: 68.0k 1%; R_0603_1608Metric
R4, R5, R8, R9, R10, R11, R12, R14, R18, R316: 100k; R_0603_1608Metric
R6: 887k 1%; R_0603_1608Metric
R7, R13, R20, R21, R22, R25, R300, R301, R304, R305, R310, R311, R312, R313, R314, R321: 10k; R_0603_1608Metric
R15: 100ohm; R_0603_1608Metric
R16: 511k 1%; R_0603_1608Metric
R17: 91.0k 1%; R_0603_1608Metric
R19: 0.010ohm 1% lowTCR 0.25W; R_0805_2012Metric
R23, R24, R26: 1M; R_0603_1608Metric
R201, R202: 100 ohm 1%; R_0603_1608Metric
R203, R205, R207, R210, R211: 33 ohm 1%; R_0603_1608Metric
R204: 0 ohm; R_0603_1608Metric
R206, R208, R209: 100k 1%; R_0603_1608Metric
R302, R303, R315: 22ohm; R_0603_1608Metric
R306, R307: 33ohm; R_0603_1608Metric
R320: 330ohm; R_0603_1608Metric
R330, R331, R332, R333: 47k; R_0603_1608Metric
R341, R342: 49.9ohm; R_0603_1608Metric
SW1: POWER momentary normally-open; SW_SPST_B3U-1000P
SW300, SW301, SW302, SW303, SW304, SW305: B3U-1000P; Quipus_Omron_B3U-1000P
U1: ESP32-S3-WROOM-1-N16R8; ESP32-S3-WROOM-1
U2: BQ24074RGTR; Quipus_TI_RGT0016C_BQ24074
U3: TUSB320LAIRWBR; Quipus_TI_RWB0012A_TUSB320LAI
U4: TLV75533PDBVR; SOT-23-5
U5: SN74LVC1G04DBVR; SOT-23-5
U6: SN74LVC1G08DBVR; SOT-23-5
U7, U8: SN74LVC1G32DBVR; SOT-23-5
U9: LTC2951ITS8-1#TRPBF; TSOT-23-8
U10: TPS22918DBVR; SOT-23-6
U11: TPS63802DLAR; Quipus_TI_DLA0010A_TPS63802
U12: BQ27441DRZR-G1A; Quipus_TI_DRZ0012A_BQ27441
U13, U35: TPD2EUSB30DRTR; Texas_DRT-3
U20, U21: IM69D128SV01XTMA1; Infineon_IM69D128SV01_PG-TLGA-5-2_2.65x3.50mm_NPTH0.60
U22: MAX98357AETE+; MAX98357AETE_T1633-4_3x3mm_P0.5_EP1.23_90-0031C
U30: RV-3028-C7-TA-QC; MicroCrystal_C7_SON-8_1.5x3.2mm_P0.9mm
U31: PCA9536DR; SOIC-8_3.9x4.9mm_P1.27mm
U34: TS3USB221ARSER; Texas_UQFN-10_1.5x2mm_P0.5mm

Connections:
3V3_AON: C4.1, C6.1, C7.1, C8.1, C9.1, C10.1, R7.2, U3.12 (VDD), U4.5 (OUT), U5.5 (VCC), U6.5 (VCC), U7.5 (VCC), U8.5 (VCC)
3V3_FB: R16.2, R17.1, U11.4 (FB)
3V3_PG: R18.1, U11.5 (PG)
3V3_SYS: C17.1, C18.1, C19.1, C301.1, C302.1, C305.1, C306.1, C310.1, C311.1, C320.1, C330.1, C340.1, J6.4 (VDD), J7.8 (VCC), R4.2, R5.2, R13.2, R14.2, R16.1, R18.2, R21.2, R22.2, R25.2, R204.1, R300.1, R301.1, R304.1, R305.1, R310.1, R311.1, R312.1, R313.1, R314.1, R316.1, R330.1, R331.1, R332.1, R333.1, U1.2 (3V3), U11.6 (VOUT), U30.7 (VDD), U31.8 (VCC), U34.10 (VCC)
AMP_ENABLE: R209.1, U1.10 (GPIO17), U22.4 (SD_MODE)
AMP_GAIN: R208.2, U22.2 (GAIN_SLOT)
BAT_NTC: J3.1 (NTC), U2.1 (TS)
BAT_P: C2.1, R19.2, R320.1, U2.2 (BAT), U2.3 (BAT), U12.7 (SRN)
BAT_PACK_P: C20.1, J2.1 (PACK+), R19.1, U12.6 (BAT), U12.8 (SRP)
BOOT_N: R301.2, SW300.1 (A), U1.27 (GPIO0)
BTN_DOWN_N: C334.1, R333.2, SW304.1 (A), U31.5 (P3)
BTN_START_N: C331.1, R330.2, SW301.1 (A), U1.7 (GPIO7)
BTN_STOP_N: C332.1, R331.2, SW302.1 (A), U31.2 (P1)
BTN_UP_N: C333.1, R332.2, SW303.1 (A), U31.3 (P2)
BUCK_L1: L1.1, U11.9 (L1)
BUCK_L2: L1.2, U11.7 (L2)
CC_DEFAULT_NHIGH: R7.1, U3.7 (OUT1), U5.2 (A), U6.2 (B)
CHARGING_N: R4.1, U1.24 (GPIO47), U2.9 (CHG_N)
CHG_EN1: R10.1, U2.6 (EN1), U7.4 (Y)
CHG_EN2: R11.1, U2.5 (EN2), U8.4 (Y)
CHG_ILIM: R1.1, U2.12 (ILIM)
CHG_ISET: R2.1, U2.16 (ISET)
CHG_TMR: R3.1, U2.14 (TMR)
ESP_EN: C300.1, R300.2, SW305.1 (A), U1.3 (EN)
ESP_USB_DM: C303.1, R302.2, U1.13 (GPIO19_USB_D-)
ESP_USB_DP: C304.1, R303.2, U1.14 (GPIO20_USB_D+)
GAUGE_1V8: C21.1, U12.5 (VDD)
GAUGE_BIN: R20.1, U12.10 (BIN)
GAUGE_INT_N: R25.1, R26.1, U12.12 (GPOUT)
GND: C1.2, C2.2, C3.2, C4.2, C5.2, C6.2, C7.2, C8.2, C9.2, C10.2, C11.2, C12.2, C13.2, C14.2, C15.2, C16.2, C17.2, C18.2, C19.2, C20.2, C21.2, C200.2, C201.2, C202.2, C203.2, C204.2, C205.2, C206.2, C207.2, C300.2, C301.2, C302.2, C303.2, C304.2, C305.2, C306.2, C310.2, C311.2, C312.2, C320.2, C321.2, C330.2, C331.2, C332.2, C333.2, C334.2, C340.2, D1.2 (RETURN), J1.A1_B12 (GND), J1.B1_A12 (GND), J1.SH1 (SHIELD), J1.SH2 (SHIELD), J1.SH3 (SHIELD), J1.SH4 (SHIELD), J2.2 (PACK-), J3.2 (NTC_RETURN), J4.2 (GND), J6.6 (VSS), J6.B (CARD_DETECT_B), J6.SH (SHIELD), J7.7 (GND), R1.2, R2.2, R3.2, R8.2, R9.2, R10.2, R11.2, R17.2, R20.2, R23.2, R24.2, R26.2, R206.2, R209.2, R321.2, R341.2, R342.2, SW1.2, SW300.2 (B), SW301.2 (B), SW302.2 (B), SW303.2 (B), SW304.2 (B), SW305.2 (B), U1.1 (GND), U1.40 (GND), U1.41 (GND_EP), U2.4 (CE_N), U2.8 (VSS), U2.17 (EP), U3.3 (PORT), U3.10 (GND), U3.11 (EN_N), U4.2 (GND), U5.3 (GND), U6.3 (GND), U7.3 (GND), U8.3 (GND), U9.4 (GND), U10.2 (GND), U11.2 (MODE), U11.3 (AGND), U11.8 (GND), U12.3 (VSS), U12.13 (EP), U13.3 (GND), U20.4 (LR), U20.5 (GND), U21.5 (GND), U22.3 (GND), U22.11 (GND), U22.15 (GND), U22.17 (EP), U30.5 (VSS), U31.4 (GND), U34.5 (GND), U34.6 (OE_N), U34.9 (S), U35.3 (GND)
I2C_SCL: R22.1, R24.1, U1.17 (GPIO9), U12.2 (SCL), U30.3 (SCL), U31.6 (SCL)
I2C_SDA: R21.1, R23.1, U1.12 (GPIO8), U12.1 (SDA), U30.4 (SDA), U31.7 (SDA)
I2S1_BCLK: R211.1, U1.22 (GPIO14)
I2S1_BCLK_IC: R211.2, U22.16 (BCLK)
I2S1_DOUT: R207.1, U1.9 (GPIO16)
I2S1_DOUT_IC: R207.2, U22.1 (DIN)
I2S1_WS: R210.1, U1.8 (GPIO15)
I2S1_WS_IC: R210.2, U22.14 (LRCLK)
LCD_BL: J7.1 (BL), U1.21 (GPIO13)
LCD_CS_N: J7.4 (CS), R304.2, U1.18 (GPIO10)
LCD_DC: J7.3 (DC), U1.37 (GPIO43_U0TXD)
LCD_MOSI: J7.6 (DIN), R307.2
LCD_MOSI_MCU: R307.1, U1.19 (GPIO11)
LCD_RST_N: J7.2 (RST), R305.2, U1.36 (GPIO44_U0RXD)
LCD_SCLK: J7.5 (CLK), R306.2
LCD_SCLK_MCU: R306.1, U1.20 (GPIO12)
MAIN_RAW: C16.1, C205.1, C206.1, C207.1, R15.2, R208.1, U10.6 (VOUT), U11.1 (EN), U11.10 (VIN), U22.7 (VDD), U22.8 (VDD)
MIC_3V3: C200.1, C201.1, C202.1, C203.1, C204.1, J4.1 (3V3), R204.2, U20.1 (VDD), U21.1 (VDD), U21.4 (LR)
PDM_CLK: R203.1, R205.1, U1.4 (GPIO4)
PDM_CLK_EXT: J4.3 (CLK), R205.2
PDM_CLK_LOCAL: R203.2, U20.2 (CLOCK), U21.2 (CLOCK)
PDM_DIN0: R201.2, R202.2, U1.5 (GPIO5)
PDM_DIN1: J4.4 (DATA), R206.1, U1.6 (GPIO6)
POWER_HOLD: R14.1, U1.23 (GPIO21), U9.8 (KILL)
PWR_BUTTON_N: SW1.1, U9.2 (PB_N)
PWR_INT_N: R13.1, U1.11 (GPIO18), U9.5 (INT_N)
PWR_KILLT: C13.1, U9.3 (KILLT)
PWR_OFFT: C12.1, U9.7 (OFFT)
RTC_EVI: R321.1, U30.8 (EVI)
RTC_VBACKUP: C321.1, R320.2, U30.6 (VBACKUP)
SD_CD_N: C312.1, J6.A (CARD_DETECT_A), R316.2, U1.34 (GPIO41)
SD_CLK: J6.5 (CLK), R315.2
SD_CLK_MCU: R315.1, U1.31 (GPIO38)
SD_CMD: J6.3 (CMD), R310.2, U1.32 (GPIO39)
SD_D0: J6.7 (DAT0), R311.2, U1.33 (GPIO40)
SD_D1_PU: J6.8 (DAT1), R312.2
SD_D2_PU: J6.1 (DAT2), R313.2
SD_D3_PU: J6.2 (CD_DAT3), R314.2
SPK_N: J5.2 (SPK-), U22.10 (OUTN)
SPK_P: J5.1 (SPK+), U22.9 (OUTP)
SYS_ENABLE: R12.1, U9.6 (EN), U10.3 (ON)
SYS_QOD: R15.1, U10.5 (QOD)
SYS_RAMP_CT: C15.1, U10.4 (CT)
SYS_RAW: C3.1, C5.1, C11.1, C14.1, R12.2, U2.10 (OUT), U2.11 (OUT), U4.1 (IN), U4.3 (EN), U9.1 (VIN), U10.1 (VIN)
U20_D: R201.1, U20.3 (DATA)
U21_D: R202.1, U21.3 (DATA)
USB_CC1: J1.A5 (CC1), U3.1 (CC1), U13.1 (IO1)
USB_CC2: J1.B5 (CC2), U3.2 (CC2), U13.2 (IO2)
USB_DEFAULT_500: U6.4 (Y), U7.2 (B)
USB_DM: J1.A7 (D-1), J1.B7 (D-2), U34.7 (D-), U35.2 (D-)
USB_DM_ISO: R302.1, U34.2 (1D-)
USB_DP: J1.A6 (D+1), J1.B6 (D+2), U34.8 (D+), U35.1 (D+)
USB_DP_ISO: R303.1, U34.1 (1D+)
USB_ENUM_500: R8.1, U1.39 (GPIO1), U6.1 (A)
USB_HIGH_CURRENT_OK: U5.4 (Y), U8.2 (B)
USB_PGOOD_N: R5.1, U1.25 (GPIO48), U2.7 (PGOOD_N)
USB_PROTECTED: C1.1, D1.1 (IO), F1.2, U2.13 (IN)
USB_SUSPEND: R9.1, U1.38 (GPIO2), U7.1 (A), U8.1 (A)
USB_UNUSED_DM: R342.1, U34.4 (2D-)
USB_UNUSED_DP: R341.1, U34.3 (2D+)
USB_VBUS_DET: R6.2, U3.4 (VBUS_DET)
VBUS_5V: F1.1, J1.A4_B9 (VBUS), J1.B4_A9 (VBUS), R6.1

Notes on the sheet:
MATCHING GLOBAL LABELS ARE ELECTRICALLY CONNECTED / PHYSICAL PIN NUMBERS SHOWN

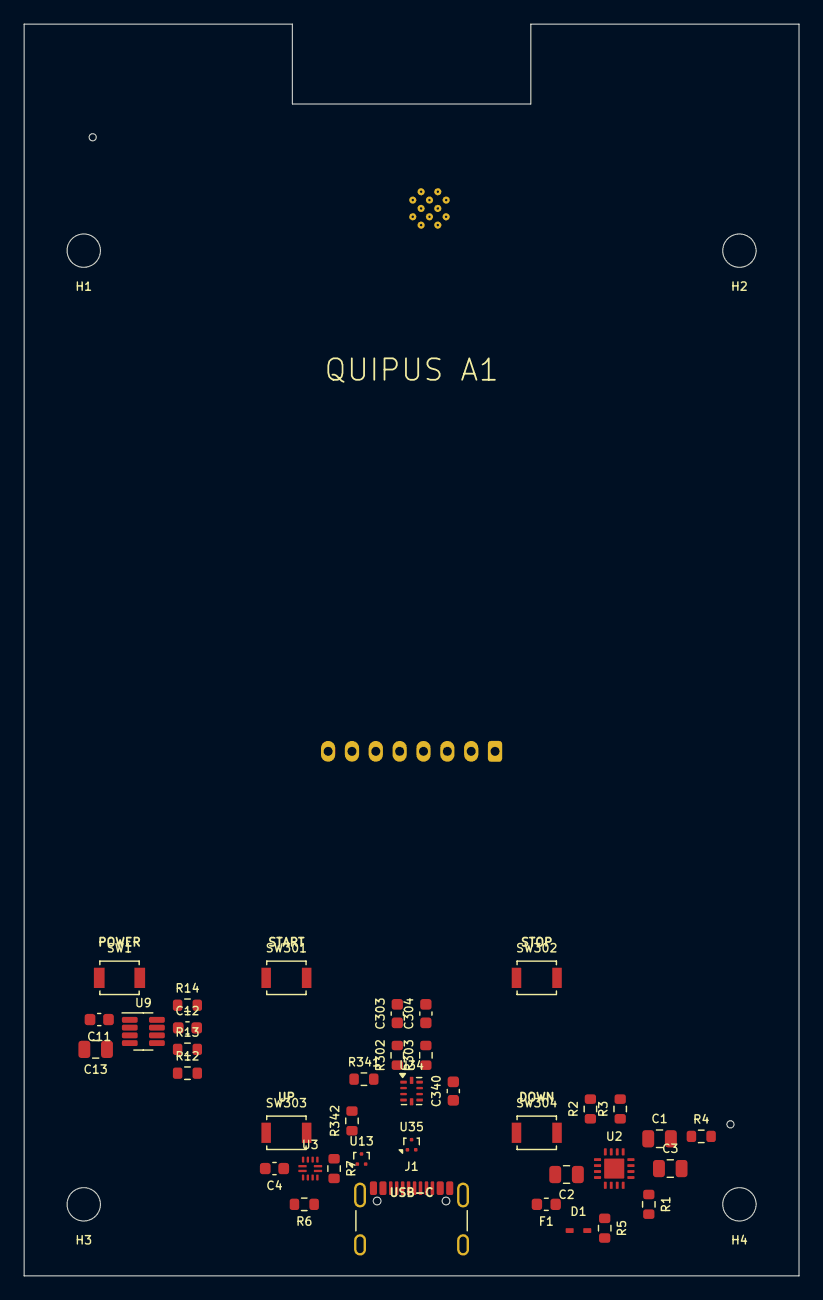
[picture p168: board Quipus-A1.kicad_pcb from above]

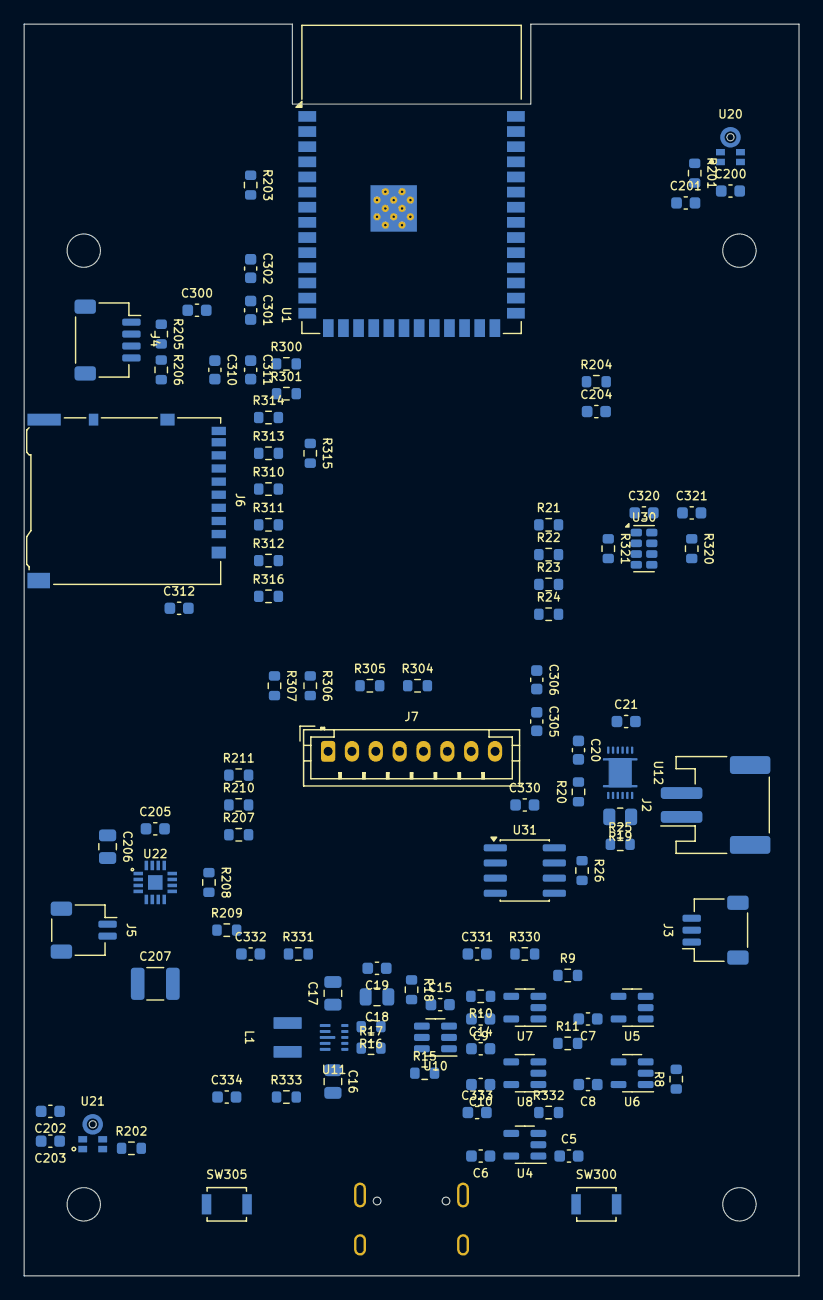
[picture p169: board Quipus-A1.kicad_pcb from below]

Board: 4 copper layers, 65.0 x 105.0 mm, 148 parts (106 on the bottom side), 92 nets, no tracks yet.

Other parts of the board:
H1, H2, H3, H4: MountingHole_2.8mm
