NathanHor22/Quipus/output/pcb/Quipus-A1/schematics/01_01_usb_charge_1.kicad_sch

## KiCad design output/pcb/Quipus-A1/schematics/01_01_usb_charge_1.kicad_sch (2026-10-06)

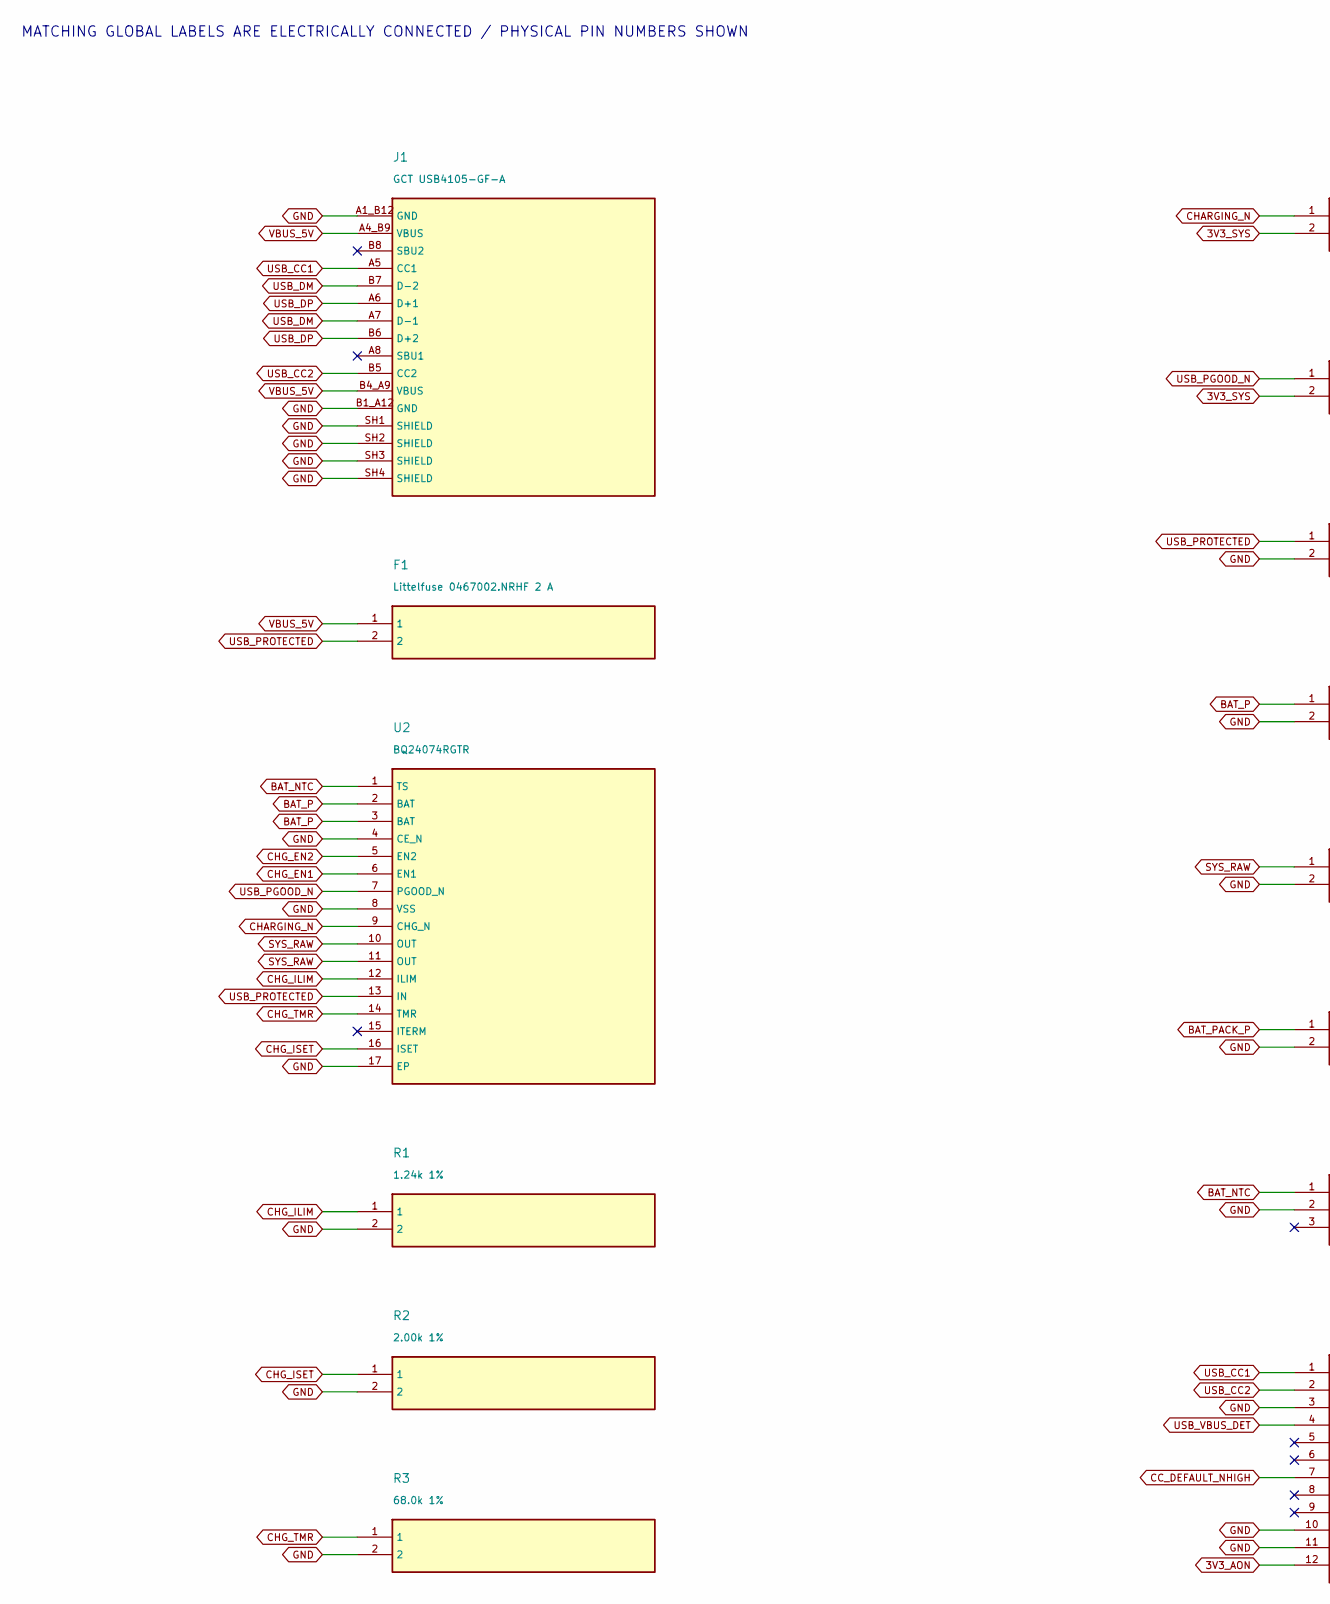
[picture p170: schematic 01_01_usb_charge_1.kicad_sch, part in row 1, column 1]

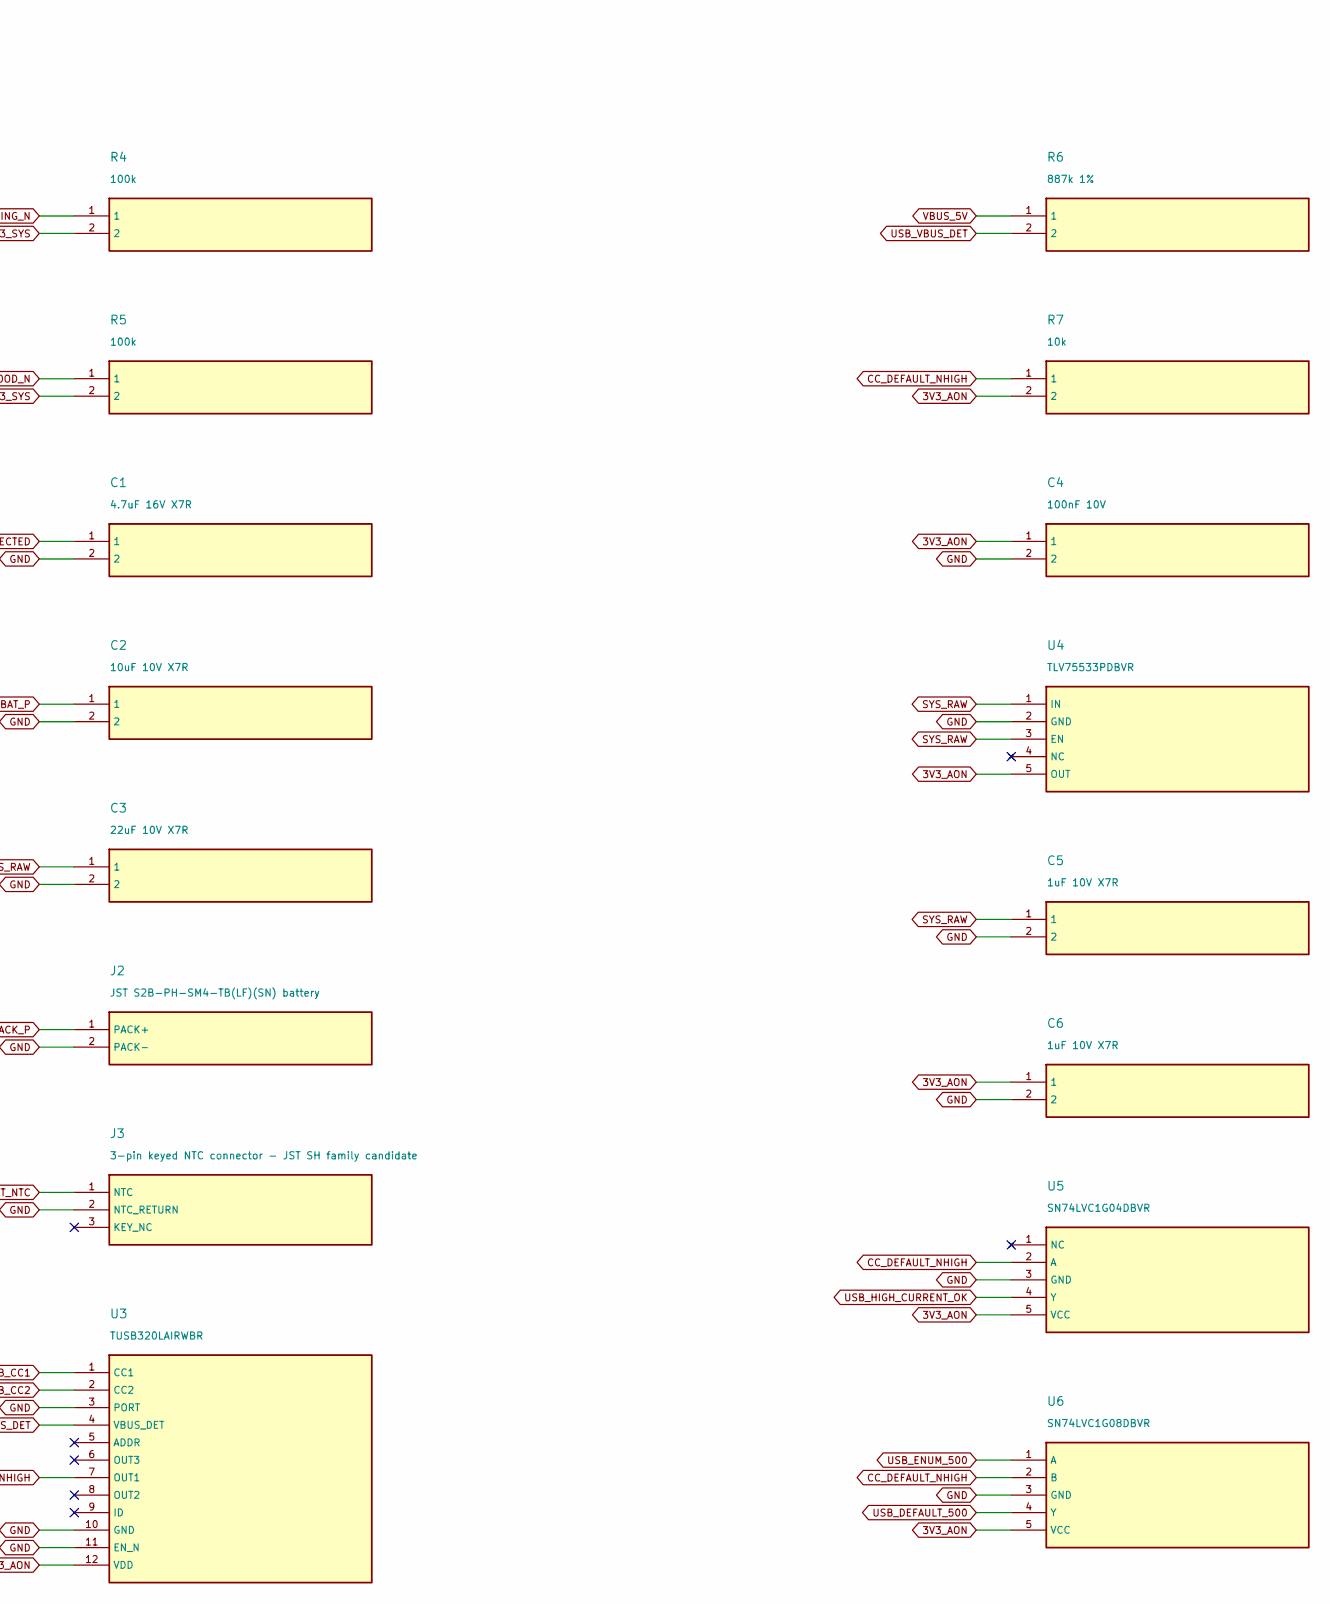
[picture p171: schematic 01_01_usb_charge_1.kicad_sch, part in row 1, column 2]

Parts:
C1: 4.7uF 16V X7R
C2: 10uF 10V X7R
C3: 22uF 10V X7R
C4: 100nF 10V
C5, C6: 1uF 10V X7R
F1: Littelfuse 0467002.NRHF 2 A
J1: GCT USB4105-GF-A
J2: JST S2B-PH-SM4-TB(LF)(SN) battery
J3: 3-pin keyed NTC connector - JST SH family candida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
R1: 1.24k 1%
R2: 2.00k 1%
R3: 68.0k 1%
R4, R5: 100k
R6: 887k 1%
R7: 10k
U2: BQ24074RGTR
U3: TUSB320LAIRWBR
U4: TLV75533PDBVR
U5: SN74LVC1G04DBVR
U6: SN74LVC1G08DBVR

Connections:
3V3_AON: C4.1, C6.1, R7.2, U3.12 (VDD), U4.5 (OUT), U5.5 (VCC), U6.5 (VCC)
3V3_SYS: R4.2, R5.2
BAT_NTC: J3.1 (NTC), U2.1 (TS)
BAT_P: C2.1, U2.2 (BAT), U2.3 (BAT)
BAT_PACK_P: J2.1 (PACK+)
CC_DEFAULT_NHIGH: R7.1, U3.7 (OUT1), U5.2 (A), U6.2 (B)
CHARGING_N: R4.1, U2.9 (CHG_N)
CHG_EN1: U2.6 (EN1)
CHG_EN2: U2.5 (EN2)
CHG_ILIM: R1.1, U2.12 (ILIM)
CHG_ISET: R2.1, U2.16 (ISET)
CHG_TMR: R3.1, U2.14 (TMR)
GND: C1.2, C2.2, C3.2, C4.2, C5.2, C6.2, J1.A1_B12 (GND), J1.B1_A12 (GND), J1.SH1 (SHIELD), J1.SH2 (SHIELD), J1.SH3 (SHIELD), J1.SH4 (SHIELD), J2.2 (PACK-), J3.2 (NTC_RETURN), R1.2, R2.2, R3.2, U2.4 (CE_N), U2.8 (VSS), U2.17 (EP), U3.3 (PORT), U3.10 (GND), U3.11 (EN_N), U4.2 (GND), U5.3 (GND), U6.3 (GND)
SYS_RAW: C3.1, C5.1, U2.10 (OUT), U2.11 (OUT), U4.1 (IN), U4.3 (EN)
USB_CC1: J1.A5 (CC1), U3.1 (CC1)
USB_CC2: J1.B5 (CC2), U3.2 (CC2)
USB_DEFAULT_500: U6.4 (Y)
USB_DM: J1.A7 (D-1), J1.B7 (D-2)
USB_DP: J1.A6 (D+1), J1.B6 (D+2)
USB_ENUM_500: U6.1 (A)
USB_HIGH_CURRENT_OK: U5.4 (Y)
USB_PGOOD_N: R5.1, U2.7 (PGOOD_N)
USB_PROTECTED: C1.1, F1.2, U2.13 (IN)
USB_VBUS_DET: R6.2, U3.4 (VBUS_DET)
VBUS_5V: F1.1, J1.A4_B9 (VBUS), J1.B4_A9 (VBUS), R6.1

Notes on the sheet:
MATCHING GLOBAL LABELS ARE ELECTRICALLY CONNECTED / PHYSICAL PIN NUMBERS SHOWN
