NathanHor22/Quipus/output/pcb/Quipus-A1/schematics/01_01_usb_charge_2.kicad_sch

## KiCad design output/pcb/Quipus-A1/schematics/01_01_usb_charge_2.kicad_sch (2026-10-06)

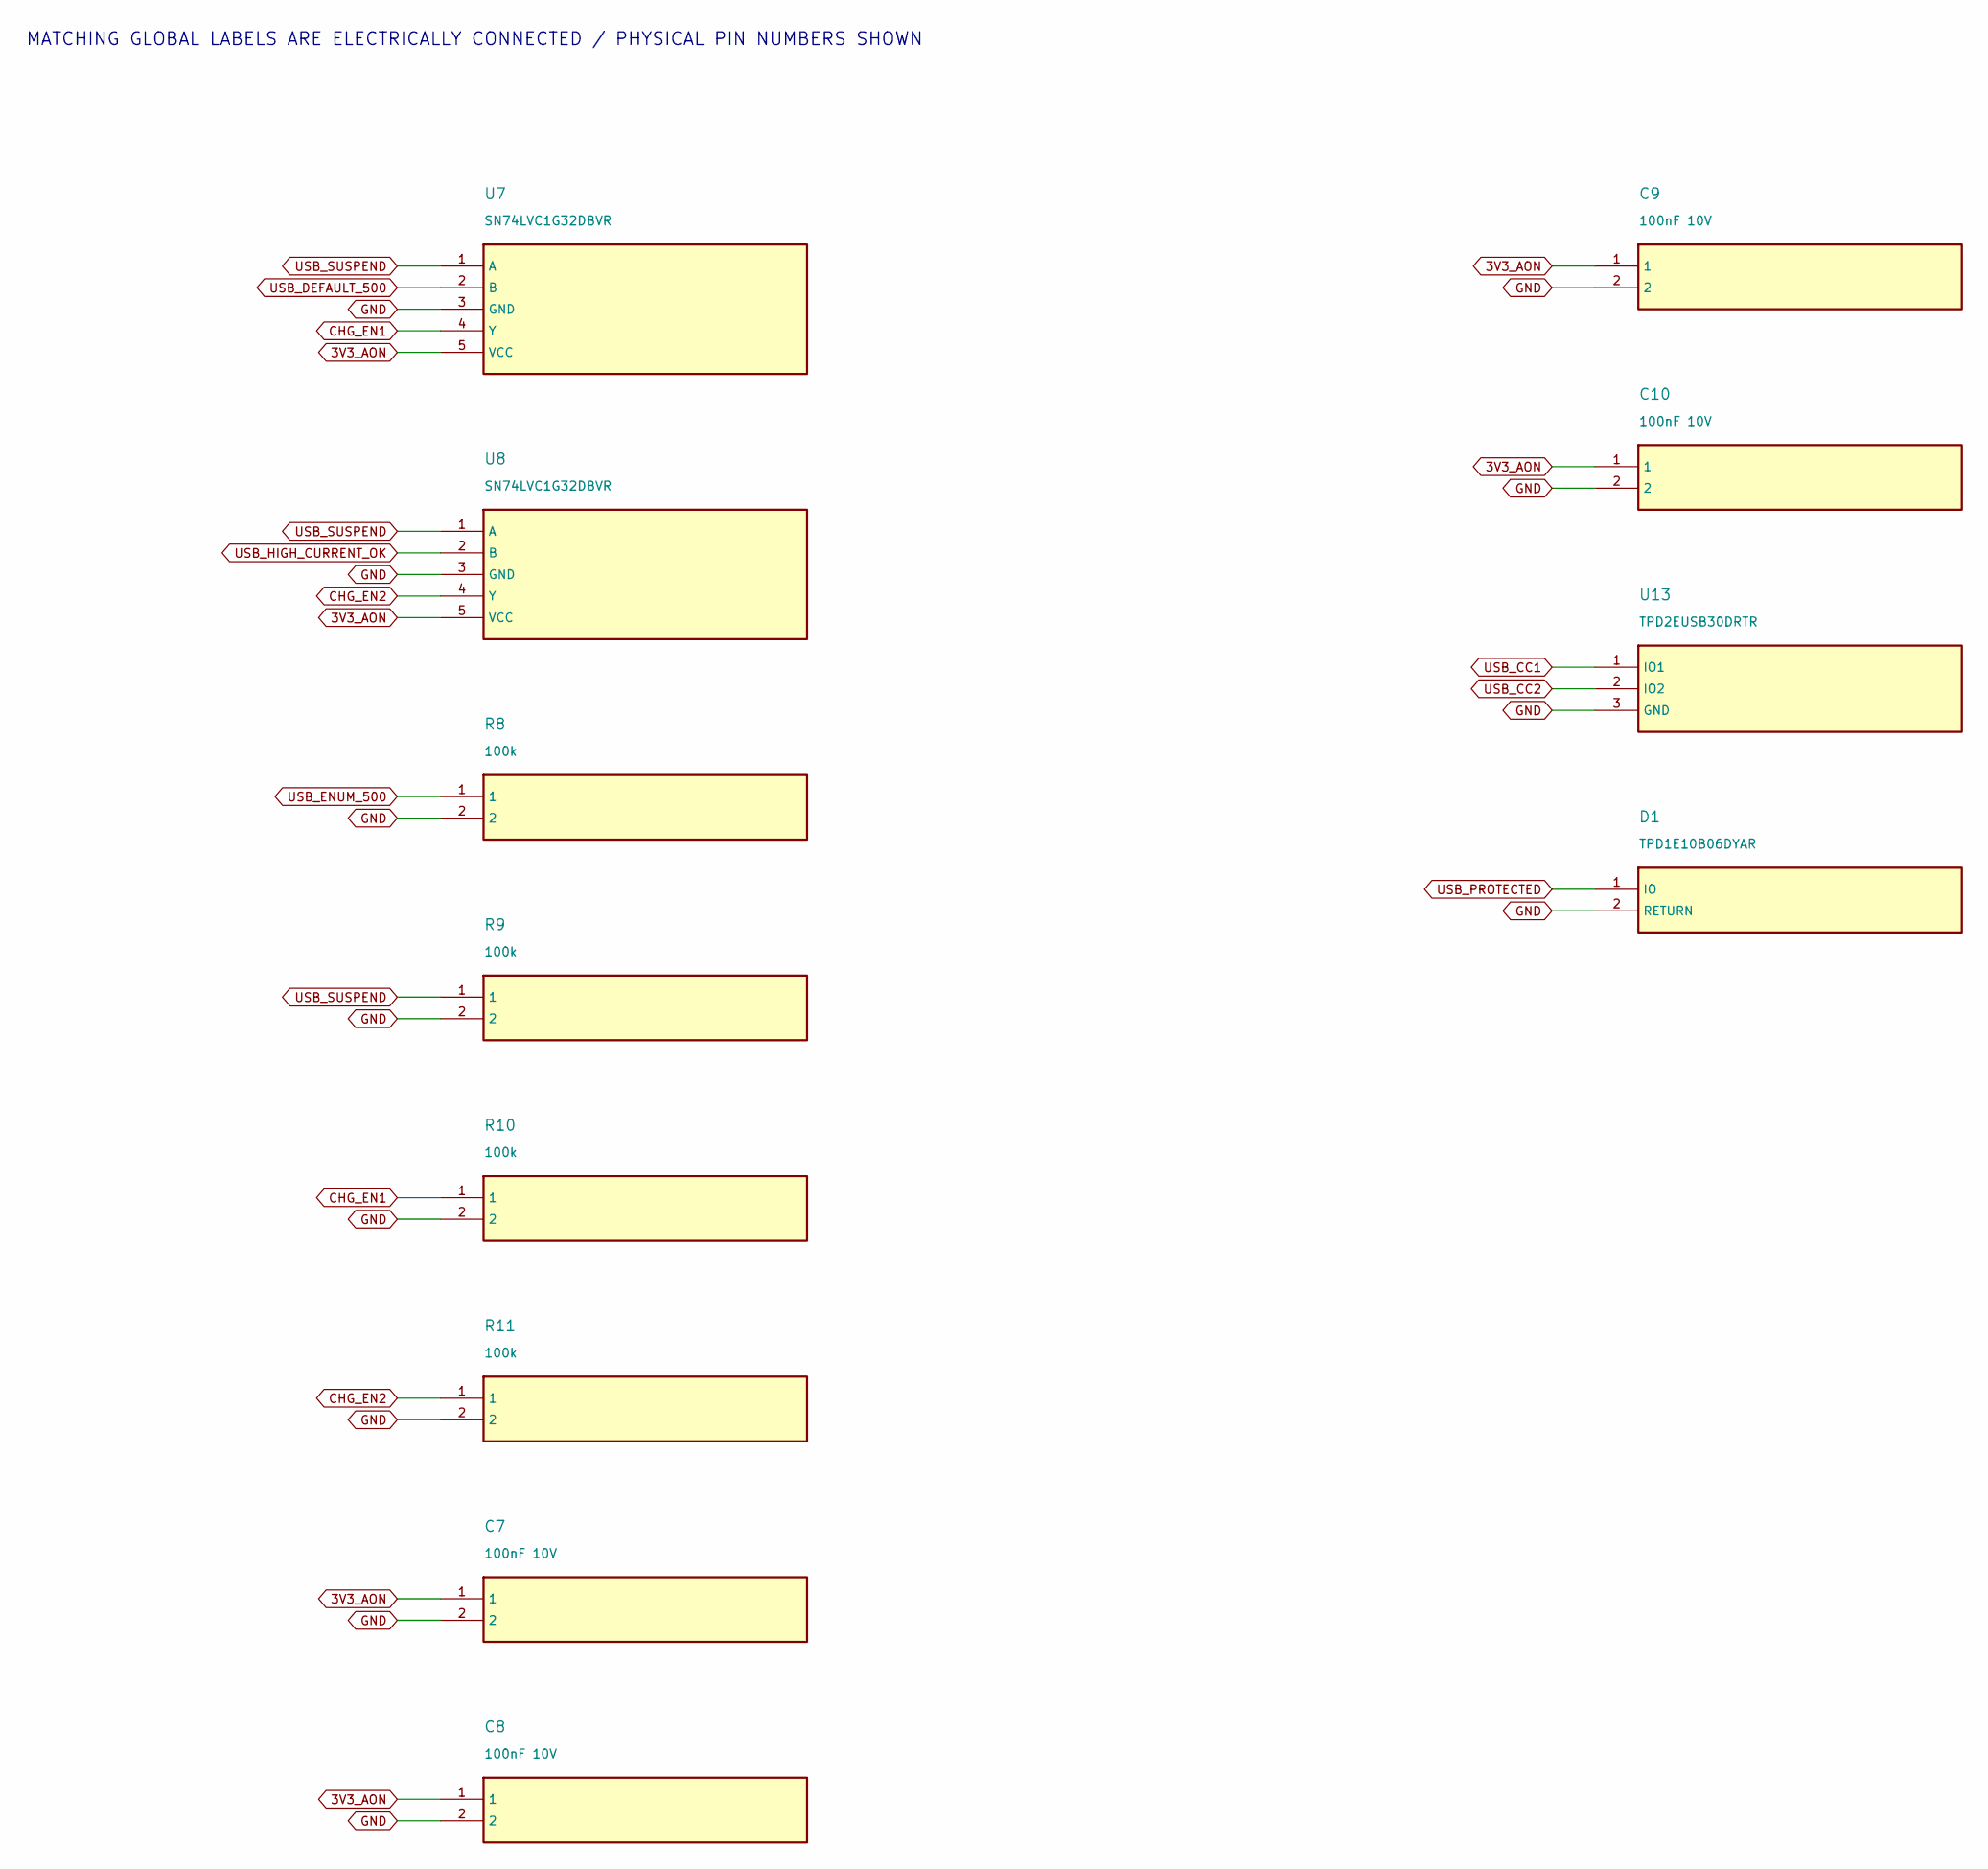
[picture p172: schematic 01_01_usb_charge_2.kicad_sch]

Parts:
C7, C8, C9, C10: 100nF 10V
D1: TPD1E10B06DYAR
R8, R9, R10, R11: 100k
U7, U8: SN74LVC1G32DBVR
U13: TPD2EUSB30DRTR

Connections:
3V3_AON: C7.1, C8.1, C9.1, C10.1, U7.5 (VCC), U8.5 (VCC)
CHG_EN1: R10.1, U7.4 (Y)
CHG_EN2: R11.1, U8.4 (Y)
GND: C7.2, C8.2, C9.2, C10.2, D1.2 (RETURN), R8.2, R9.2, R10.2, R11.2, U7.3 (GND), U8.3 (GND), U13.3 (GND)
USB_CC1: U13.1 (IO1)
USB_CC2: U13.2 (IO2)
USB_DEFAULT_500: U7.2 (B)
USB_ENUM_500: R8.1
USB_HIGH_CURRENT_OK: U8.2 (B)
USB_PROTECTED: D1.1 (IO)
USB_SUSPEND: R9.1, U7.1 (A), U8.1 (A)

Notes on the sheet:
MATCHING GLOBAL LABELS ARE ELECTRICALLY CONNECTED / PHYSICAL PIN NUMBERS SHOWN
