NathanHor22/Quipus/output/pcb/Quipus-A1/schematics/02_02_power_control_1.kicad_sch

## KiCad design output/pcb/Quipus-A1/schematics/02_02_power_control_1.kicad_sch (2026-10-06)

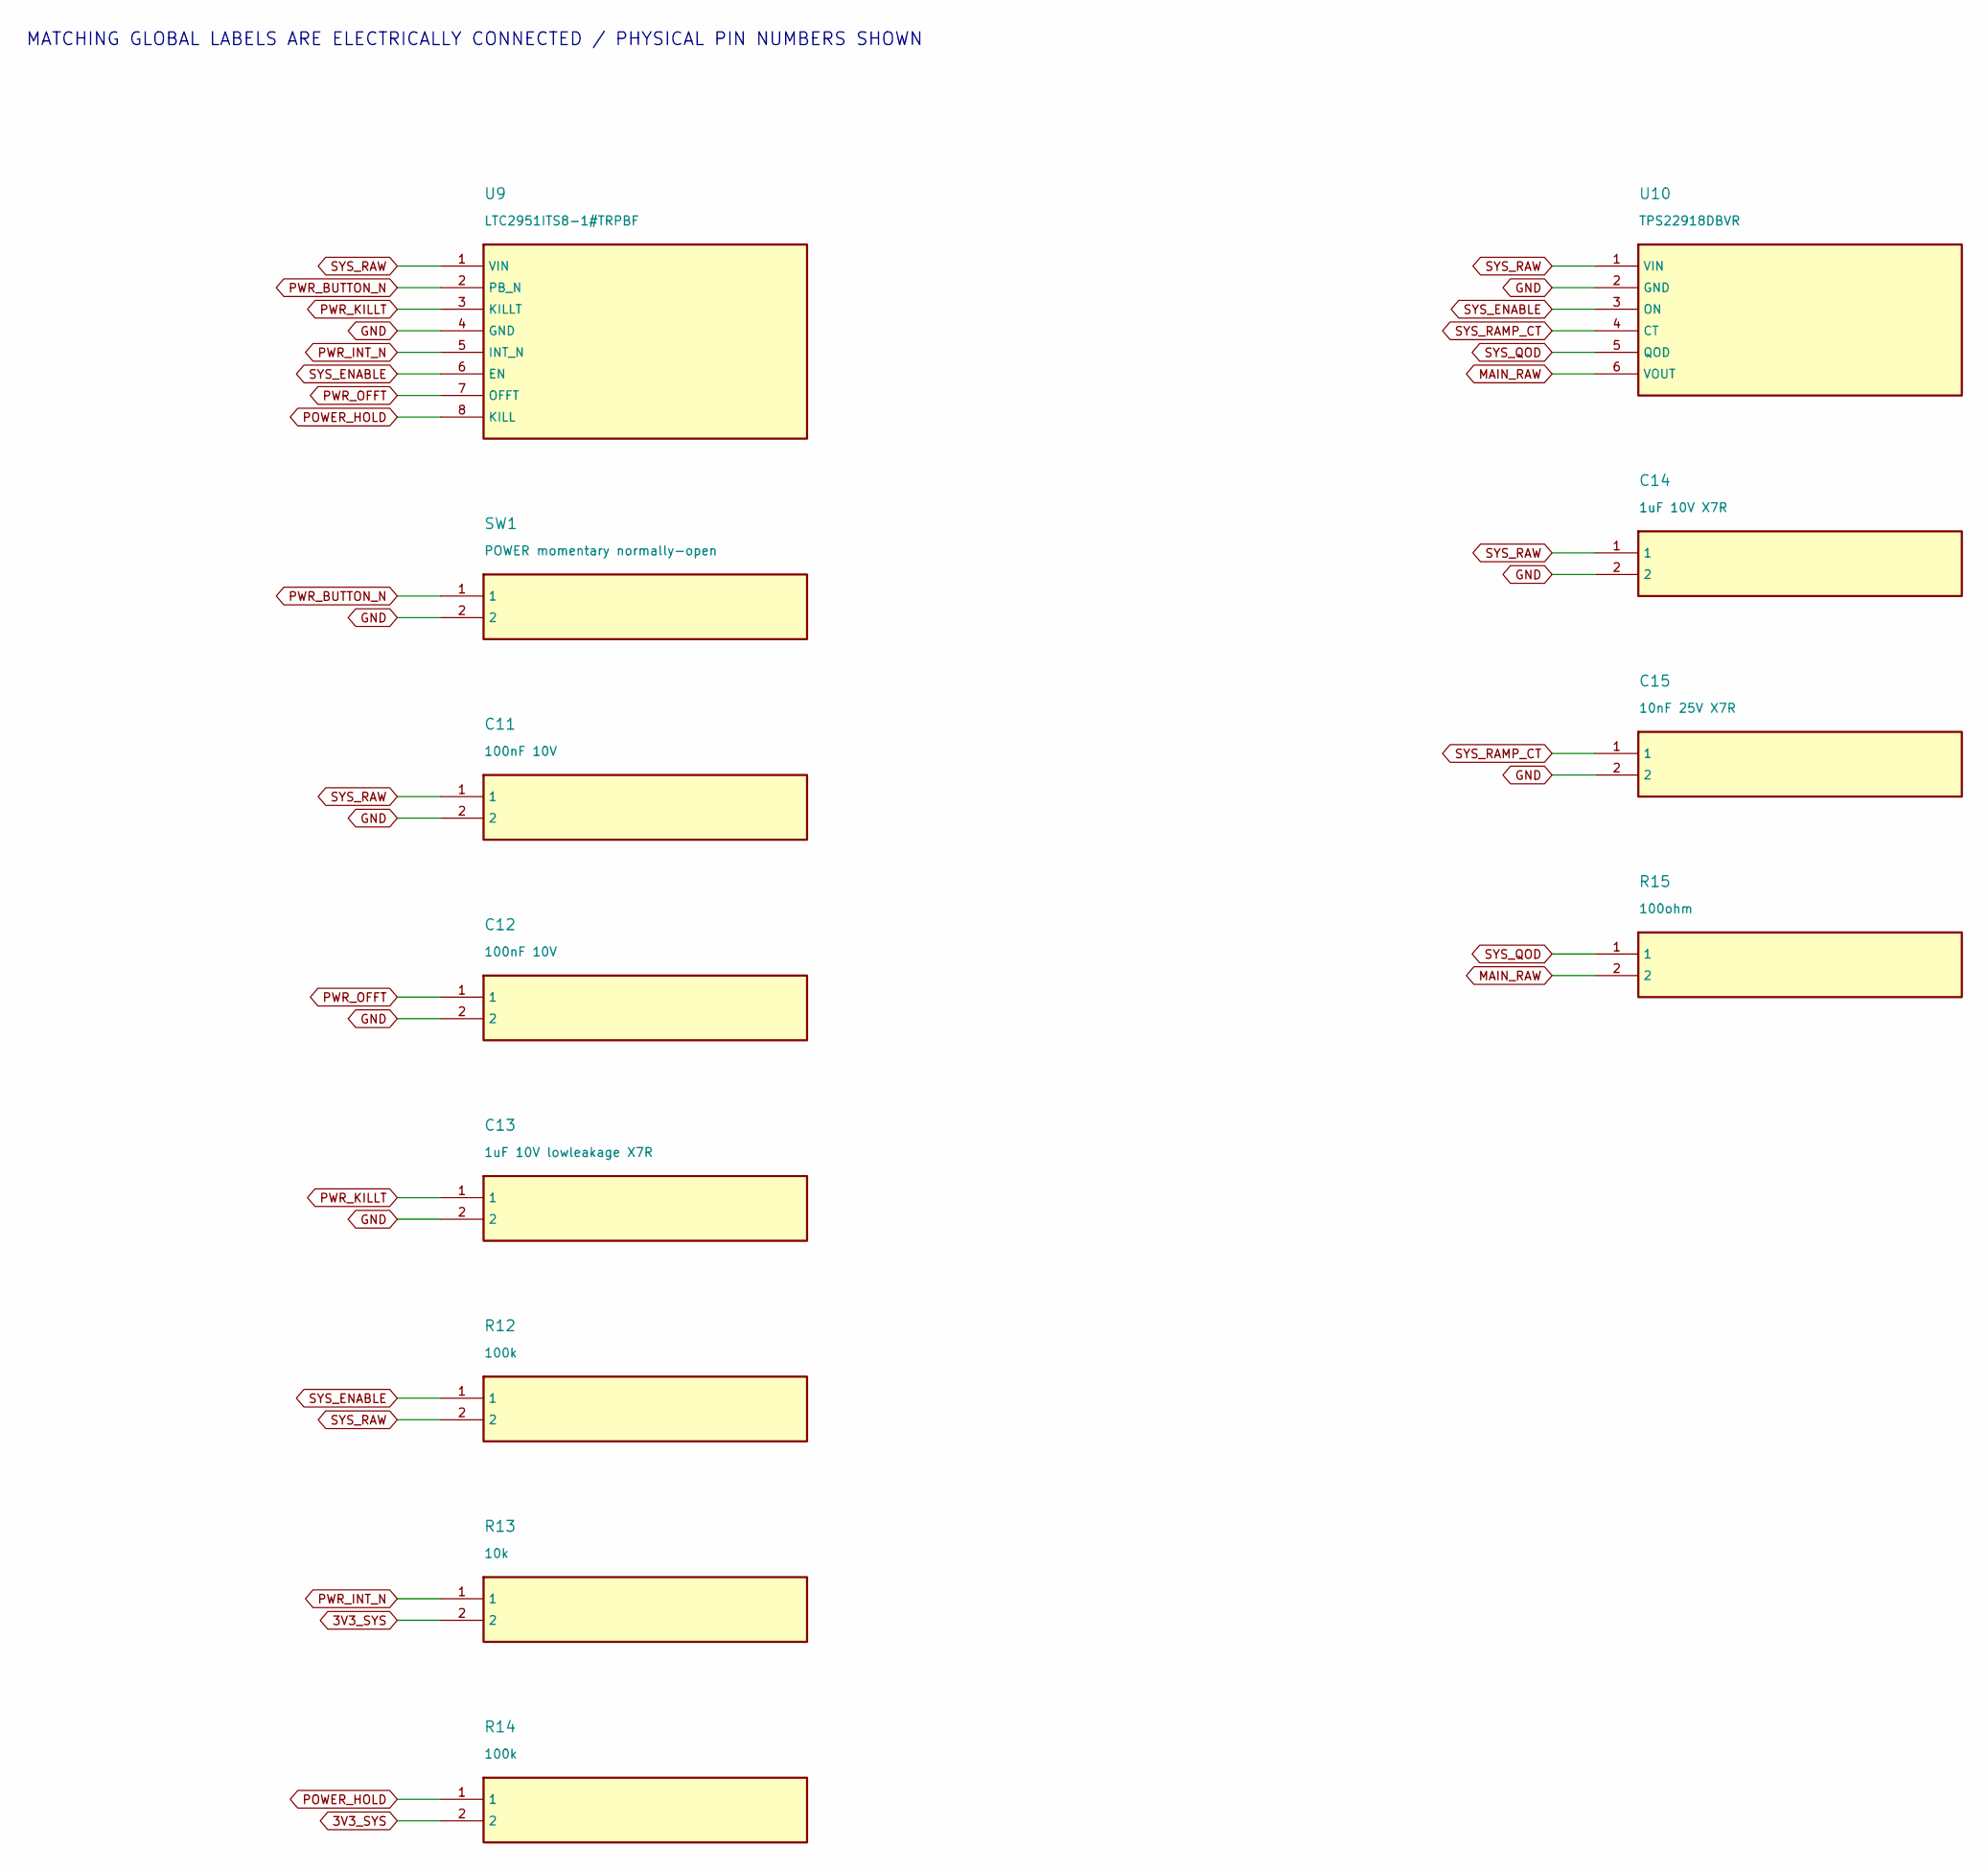
[picture p173: schematic 02_02_power_control_1.kicad_sch]

Parts:
C11, C12: 100nF 10V
C13: 1uF 10V lowleakage X7R
C14: 1uF 10V X7R
C15: 10nF 25V X7R
R12, R14: 100k
R13: 10k
R15: 100ohm
SW1: POWER momentary normally-open
U9: LTC2951ITS8-1#TRPBF
U10: TPS22918DBVR

Connections:
3V3_SYS: R13.2, R14.2
GND: C11.2, C12.2, C13.2, C14.2, C15.2, SW1.2, U9.4 (GND), U10.2 (GND)
MAIN_RAW: R15.2, U10.6 (VOUT)
POWER_HOLD: R14.1, U9.8 (KILL)
PWR_BUTTON_N: SW1.1, U9.2 (PB_N)
PWR_INT_N: R13.1, U9.5 (INT_N)
PWR_KILLT: C13.1, U9.3 (KILLT)
PWR_OFFT: C12.1, U9.7 (OFFT)
SYS_ENABLE: R12.1, U9.6 (EN), U10.3 (ON)
SYS_QOD: R15.1, U10.5 (QOD)
SYS_RAMP_CT: C15.1, U10.4 (CT)
SYS_RAW: C11.1, C14.1, R12.2, U9.1 (VIN), U10.1 (VIN)

Notes on the sheet:
MATCHING GLOBAL LABELS ARE ELECTRICALLY CONNECTED / PHYSICAL PIN NUMBERS SHOWN
