NathanHor22/Quipus/output/pcb/Quipus-A1/schematics/03_03_regulator_1.kicad_sch

## KiCad design output/pcb/Quipus-A1/schematics/03_03_regulator_1.kicad_sch (2026-10-06)

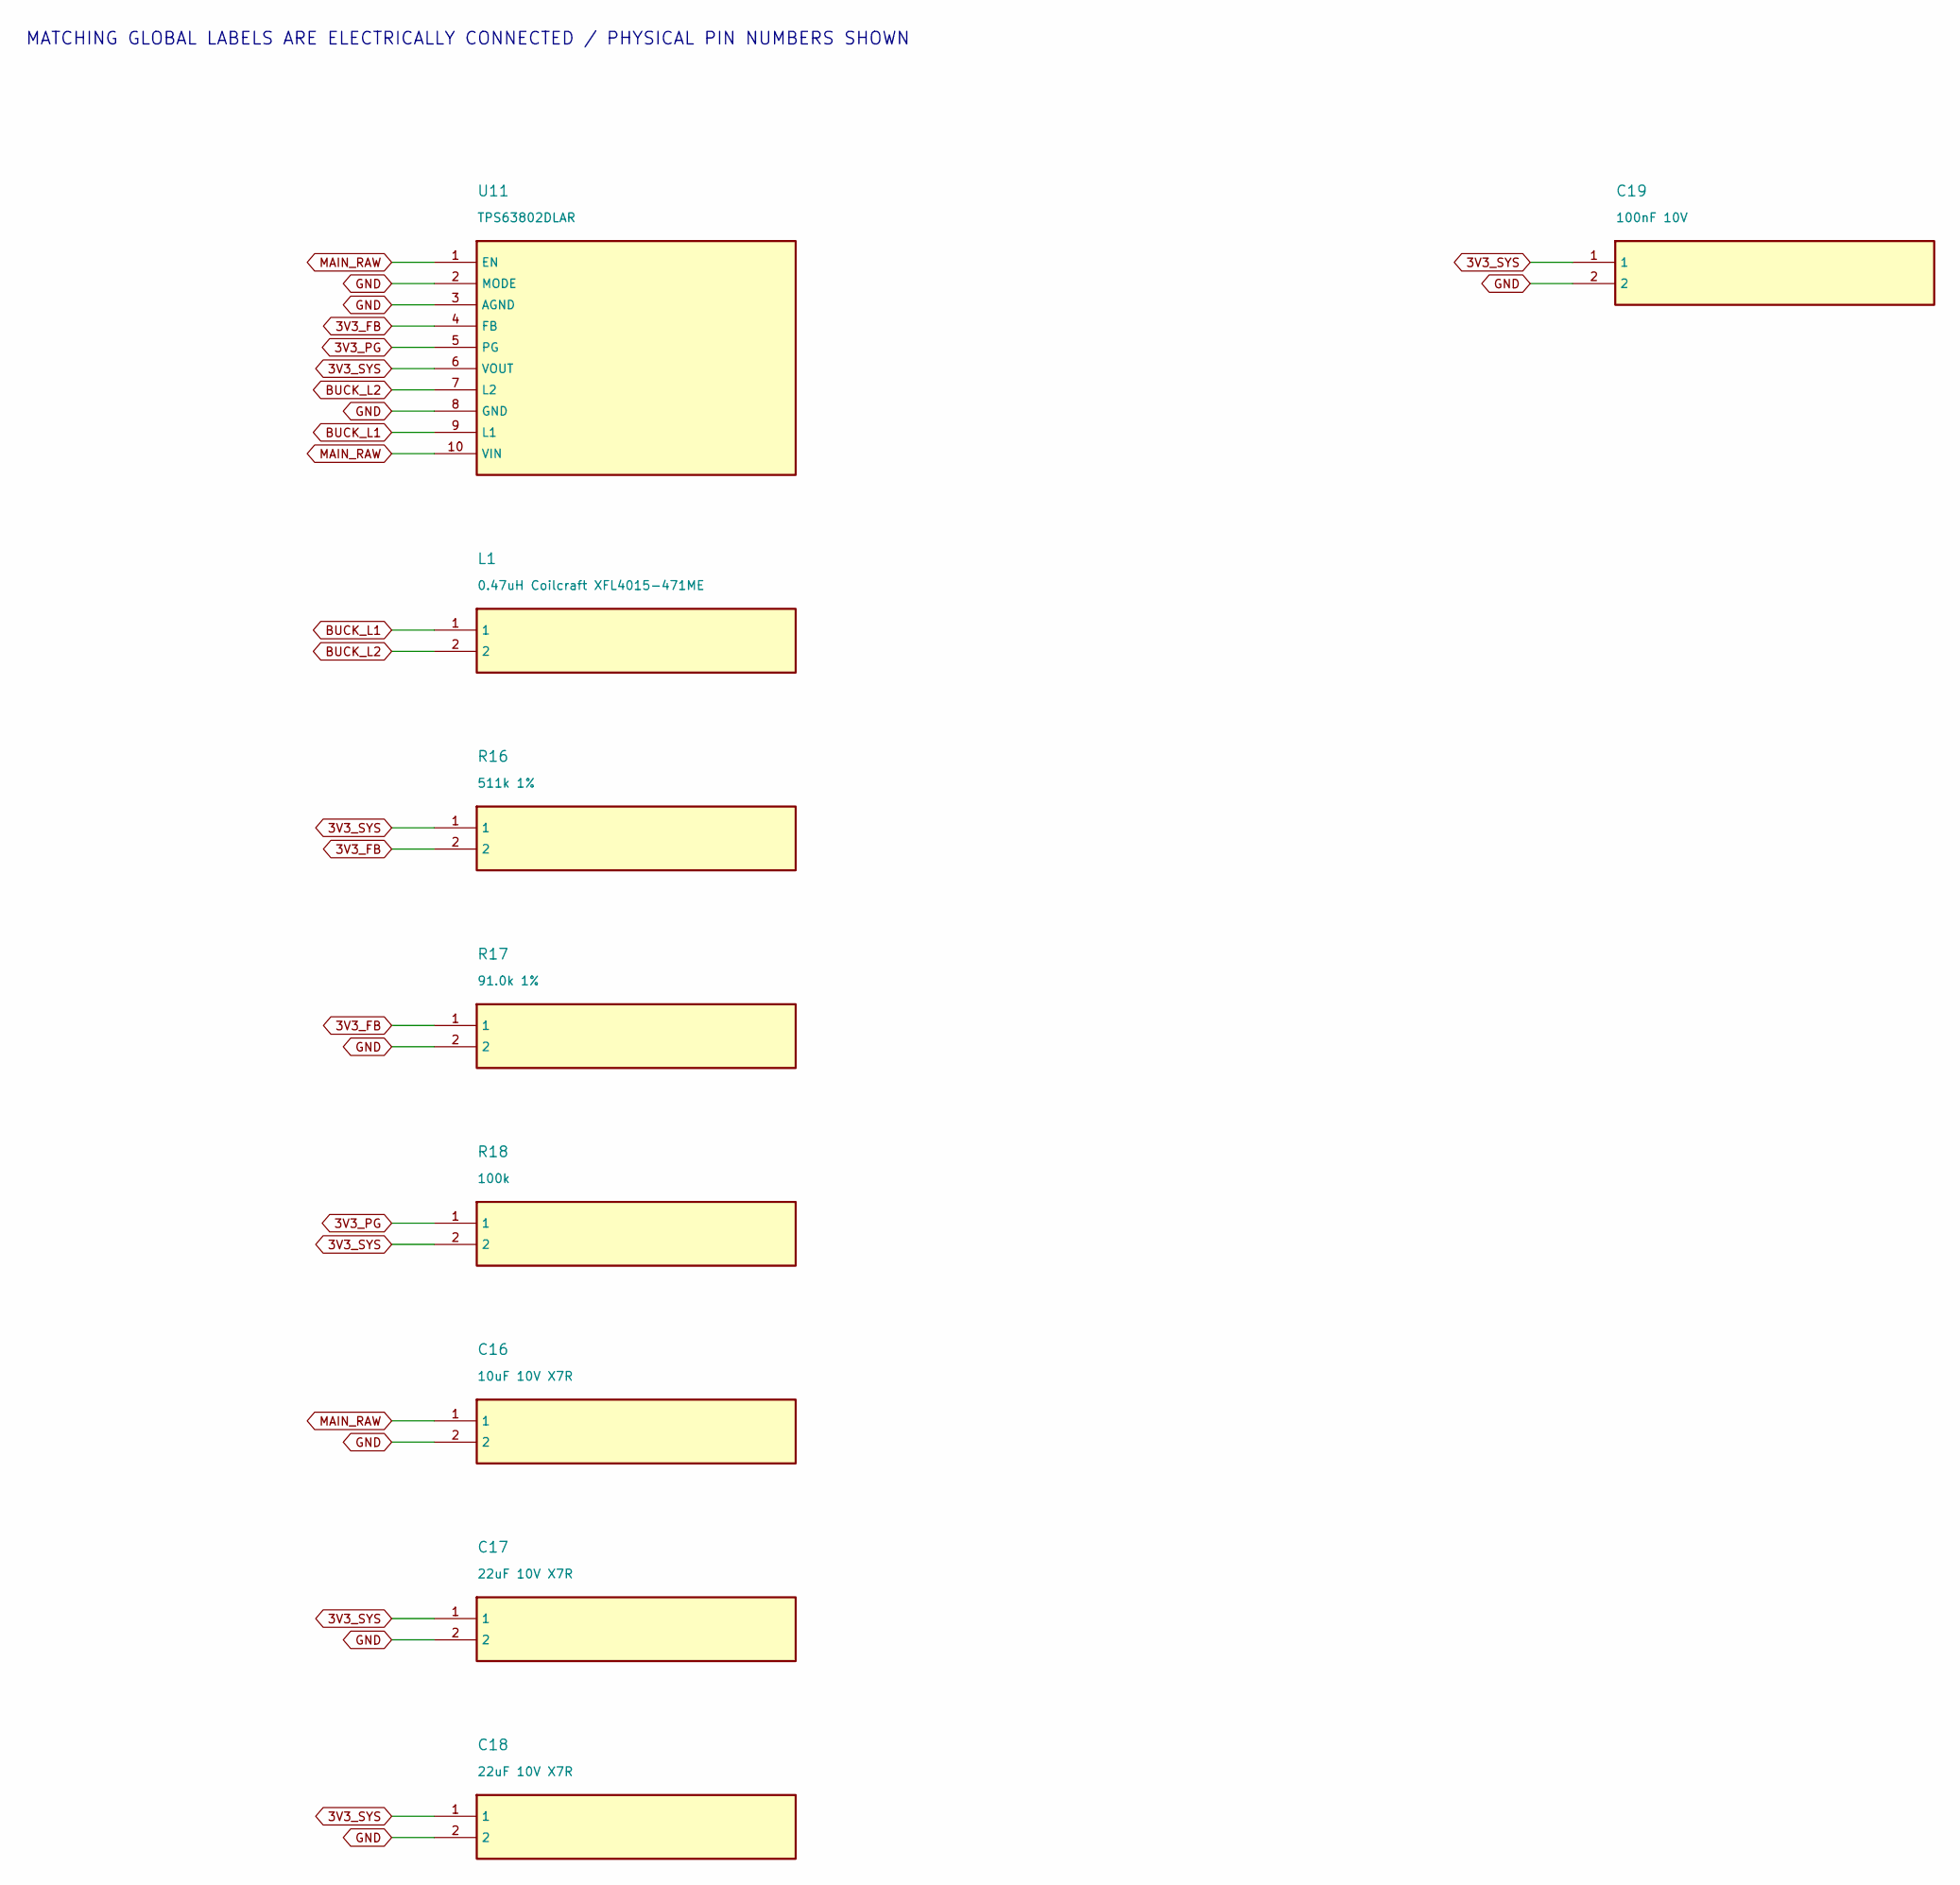
[picture p174: schematic 03_03_regulator_1.kicad_sch]

Parts:
C16: 10uF 10V X7R
C17, C18: 22uF 10V X7R
C19: 100nF 10V
L1: 0.47uH Coilcraft XFL4015-471ME
R16: 511k 1%
R17: 91.0k 1%
R18: 100k
U11: TPS63802DLAR

Connections:
3V3_FB: R16.2, R17.1, U11.4 (FB)
3V3_PG: R18.1, U11.5 (PG)
3V3_SYS: C17.1, C18.1, C19.1, R16.1, R18.2, U11.6 (VOUT)
BUCK_L1: L1.1, U11.9 (L1)
BUCK_L2: L1.2, U11.7 (L2)
GND: C16.2, C17.2, C18.2, C19.2, R17.2, U11.2 (MODE), U11.3 (AGND), U11.8 (GND)
MAIN_RAW: C16.1, U11.1 (EN), U11.10 (VIN)

Notes on the sheet:
MATCHING GLOBAL LABELS ARE ELECTRICALLY CONNECTED / PHYSICAL PIN NUMBERS SHOWN
