NathanHor22/Quipus/output/pcb/Quipus-A1/schematics/04_04_gauge_1.kicad_sch

## KiCad design output/pcb/Quipus-A1/schematics/04_04_gauge_1.kicad_sch (2026-10-06)

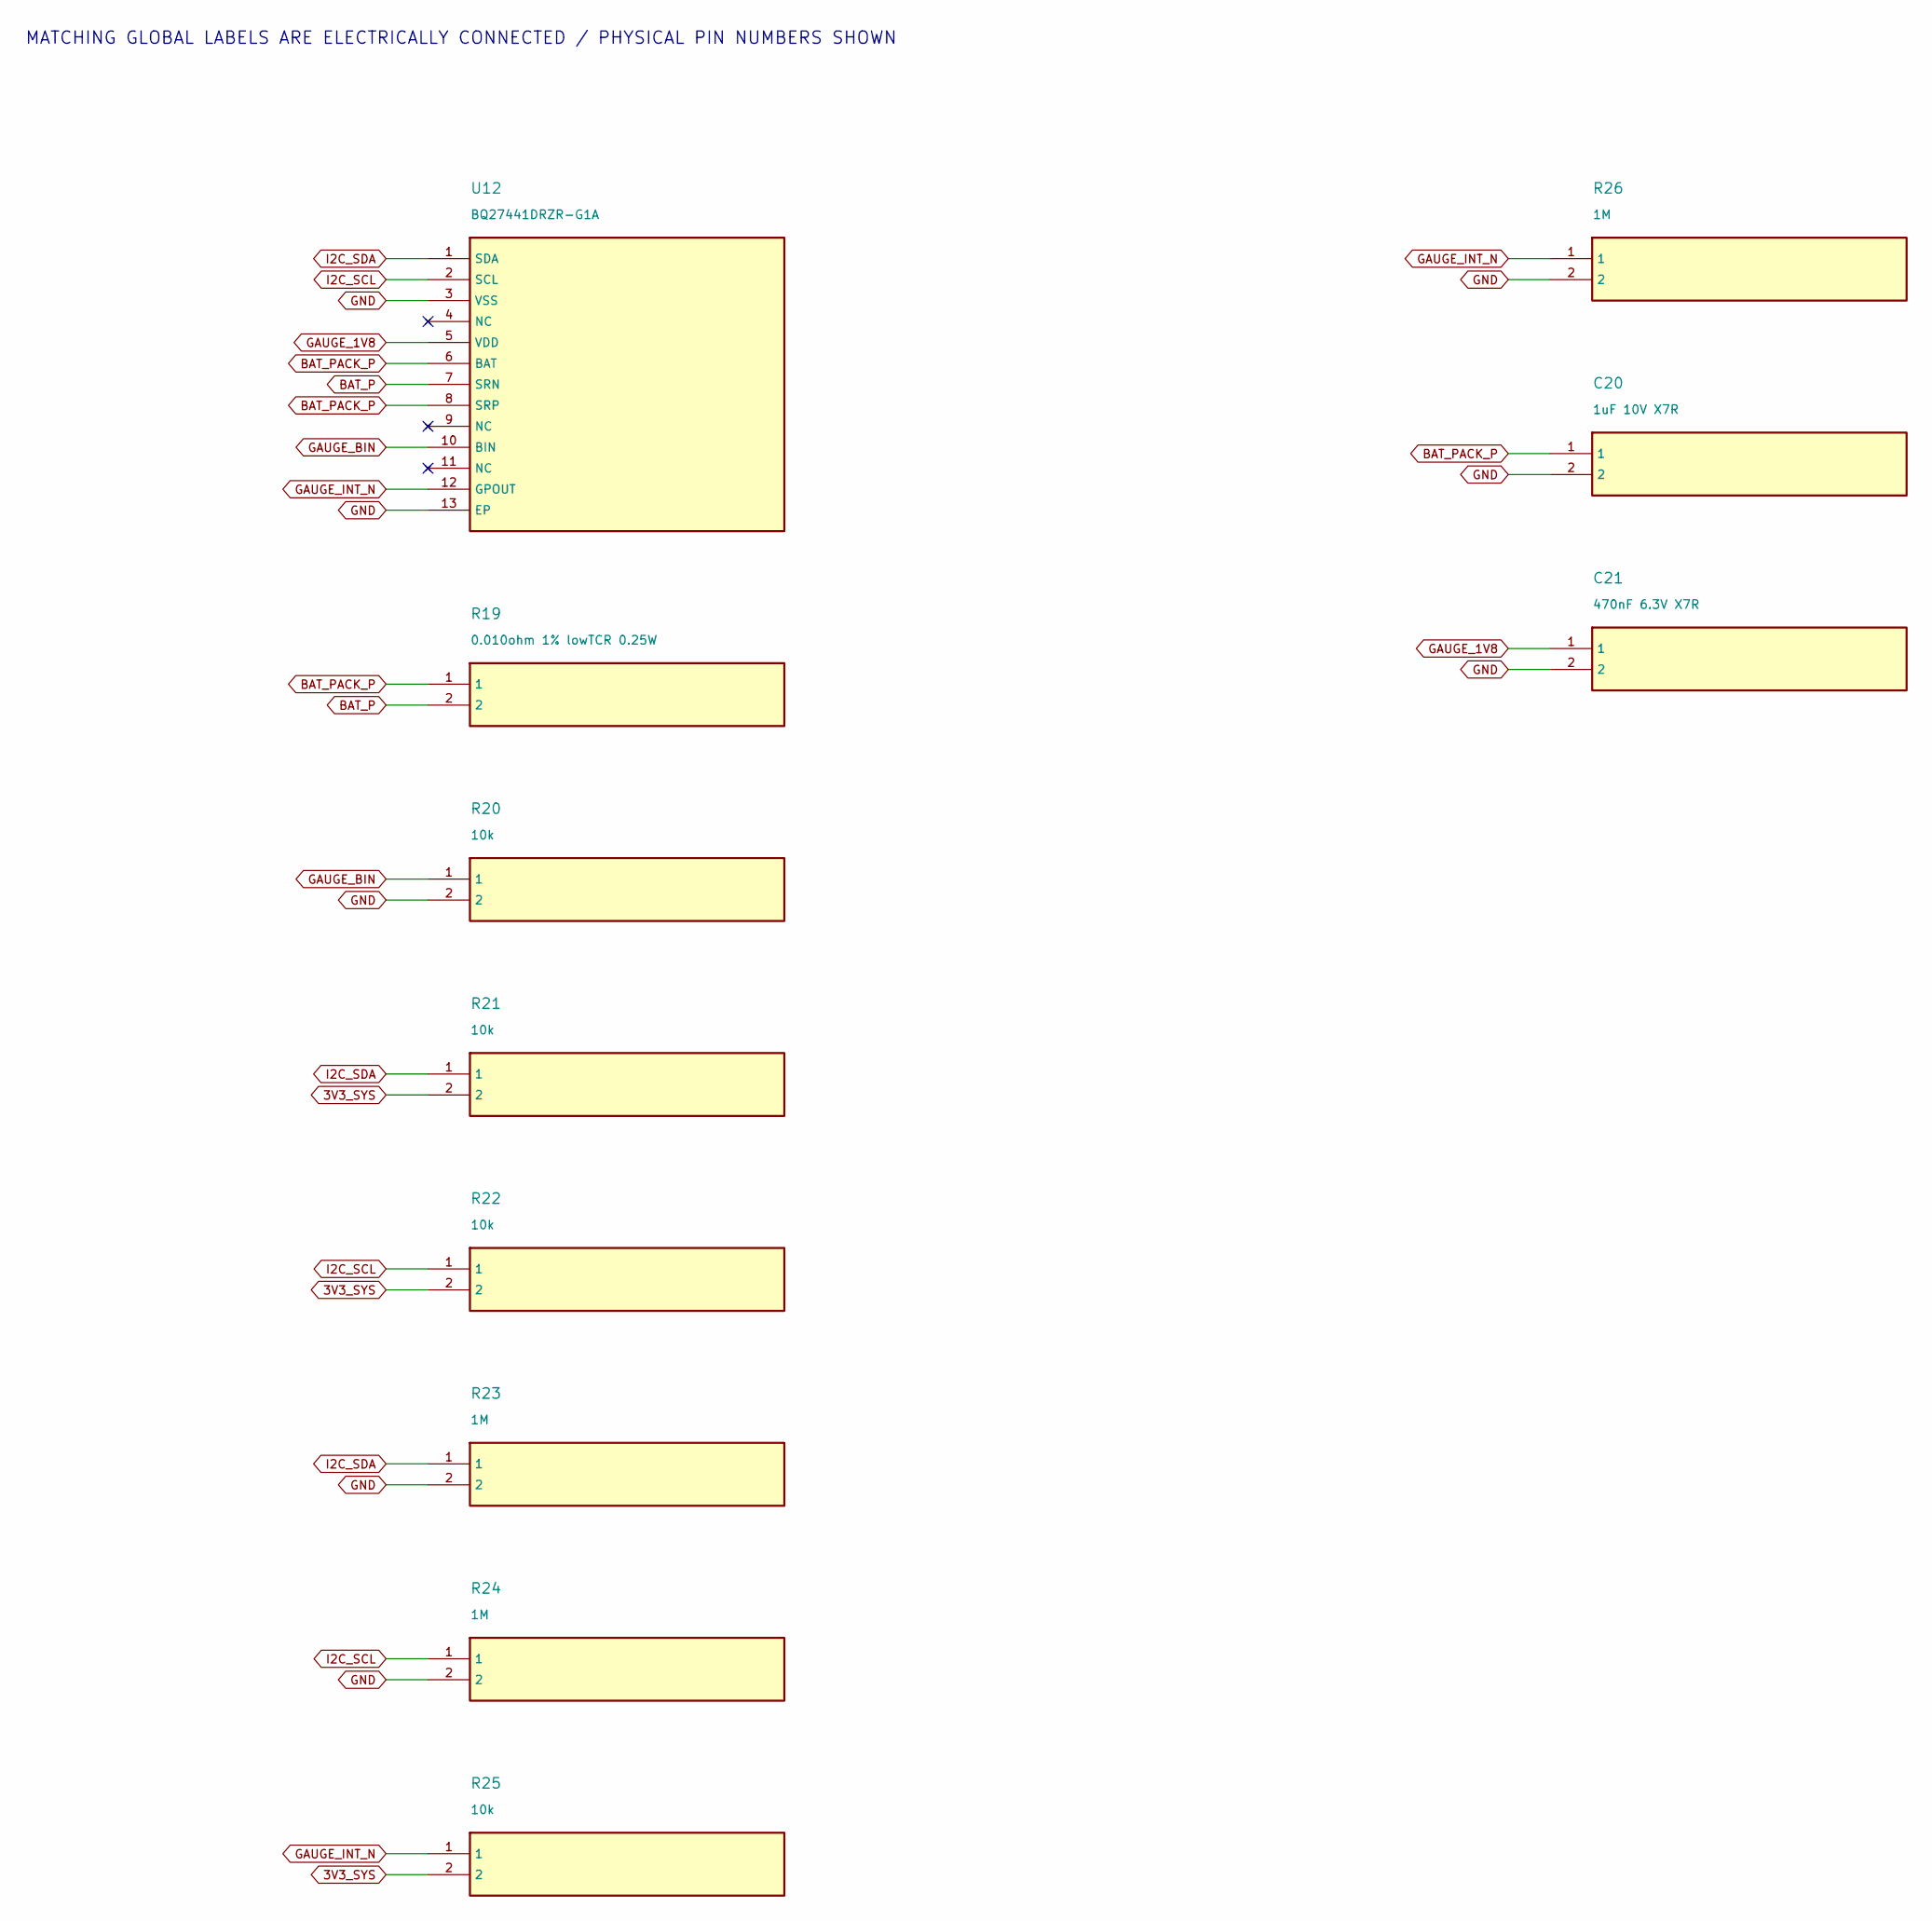
[picture p175: schematic 04_04_gauge_1.kicad_sch]

Parts:
C20: 1uF 10V X7R
C21: 470nF 6.3V X7R
R19: 0.010ohm 1% lowTCR 0.25W
R20, R21, R22, R25: 10k
R23, R24, R26: 1M
U12: BQ27441DRZR-G1A

Connections:
3V3_SYS: R21.2, R22.2, R25.2
BAT_P: R19.2, U12.7 (SRN)
BAT_PACK_P: C20.1, R19.1, U12.6 (BAT), U12.8 (SRP)
GAUGE_1V8: C21.1, U12.5 (VDD)
GAUGE_BIN: R20.1, U12.10 (BIN)
GAUGE_INT_N: R25.1, R26.1, U12.12 (GPOUT)
GND: C20.2, C21.2, R20.2, R23.2, R24.2, R26.2, U12.3 (VSS), U12.13 (EP)
I2C_SCL: R22.1, R24.1, U12.2 (SCL)
I2C_SDA: R21.1, R23.1, U12.1 (SDA)

Notes on the sheet:
MATCHING GLOBAL LABELS ARE ELECTRICALLY CONNECTED / PHYSICAL PIN NUMBERS SHOWN
