NathanHor22/Quipus/output/pcb/Quipus-A1/schematics/05_controller_1.kicad_sch

## KiCad design output/pcb/Quipus-A1/schematics/05_controller_1.kicad_sch (2026-10-06)

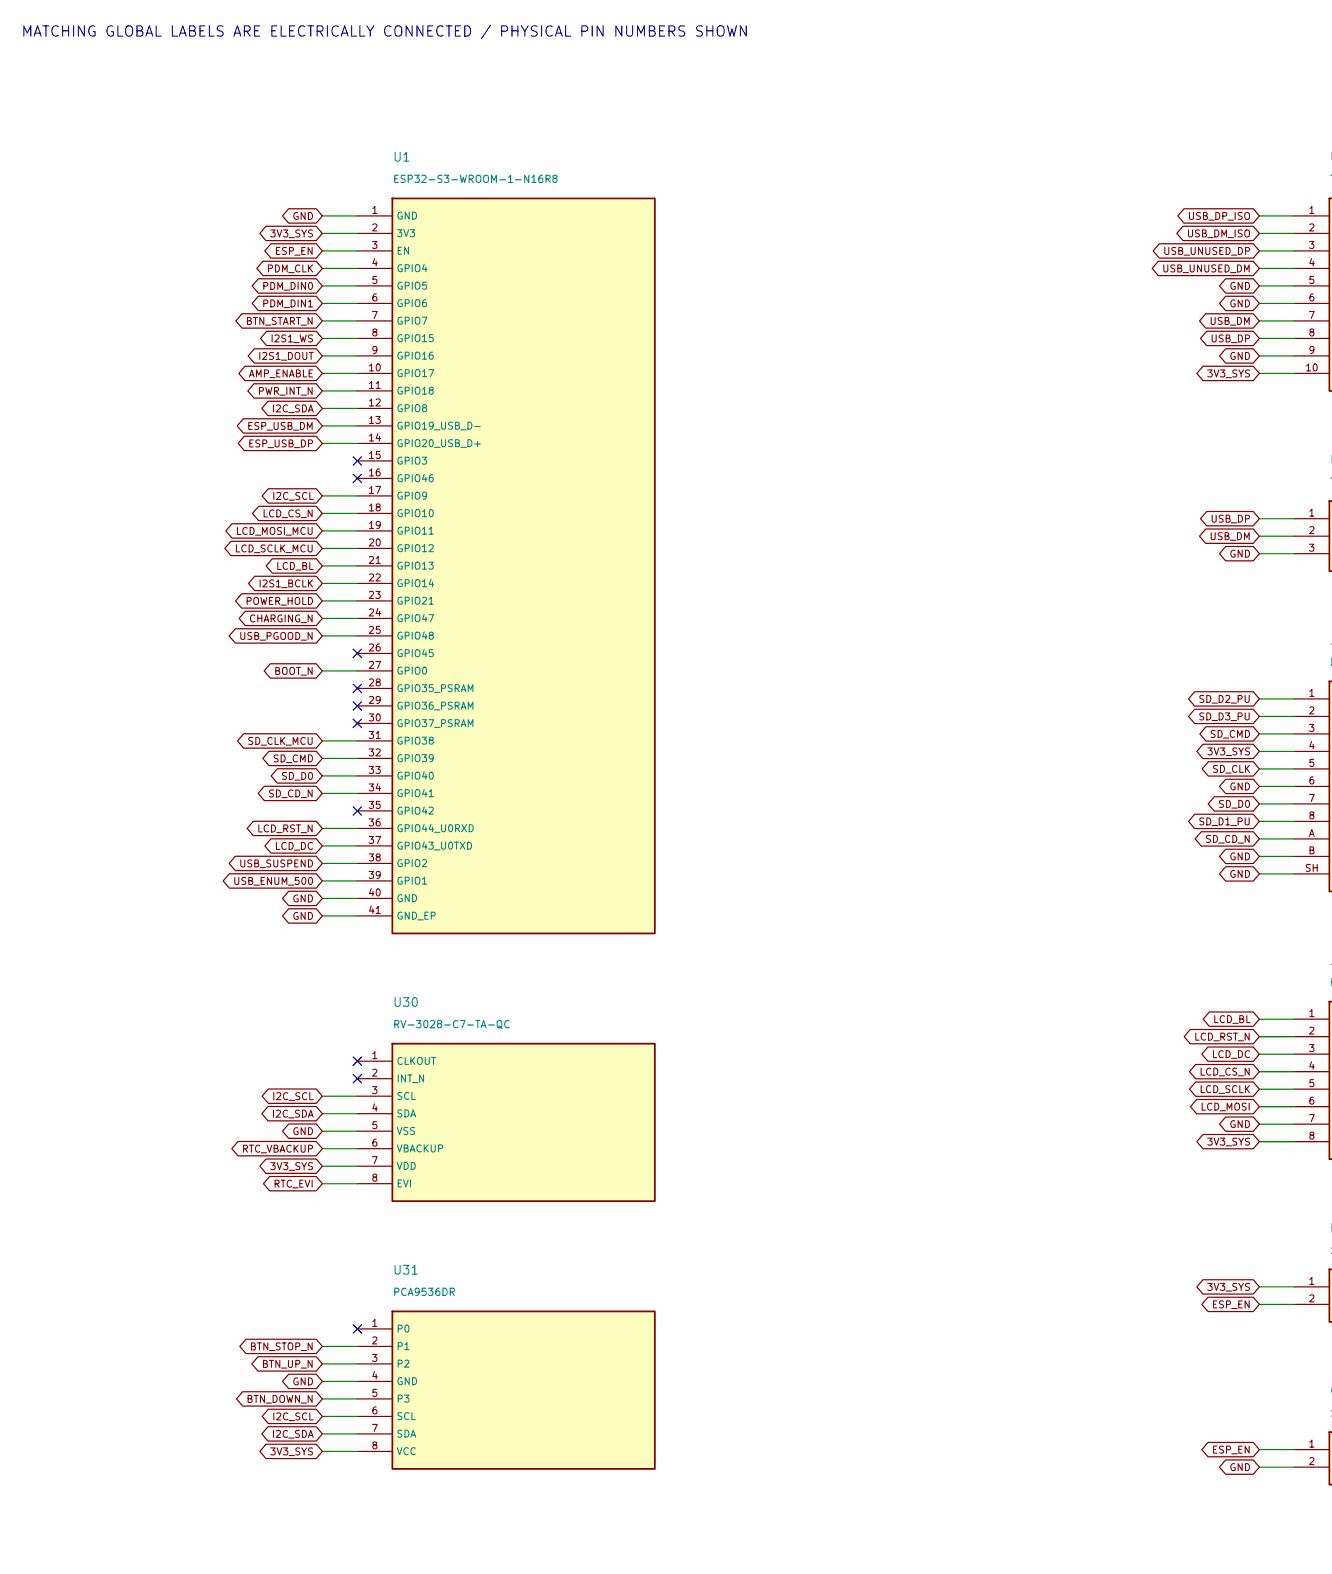
[picture p176: schematic 05_controller_1.kicad_sch, part in row 1, column 1]

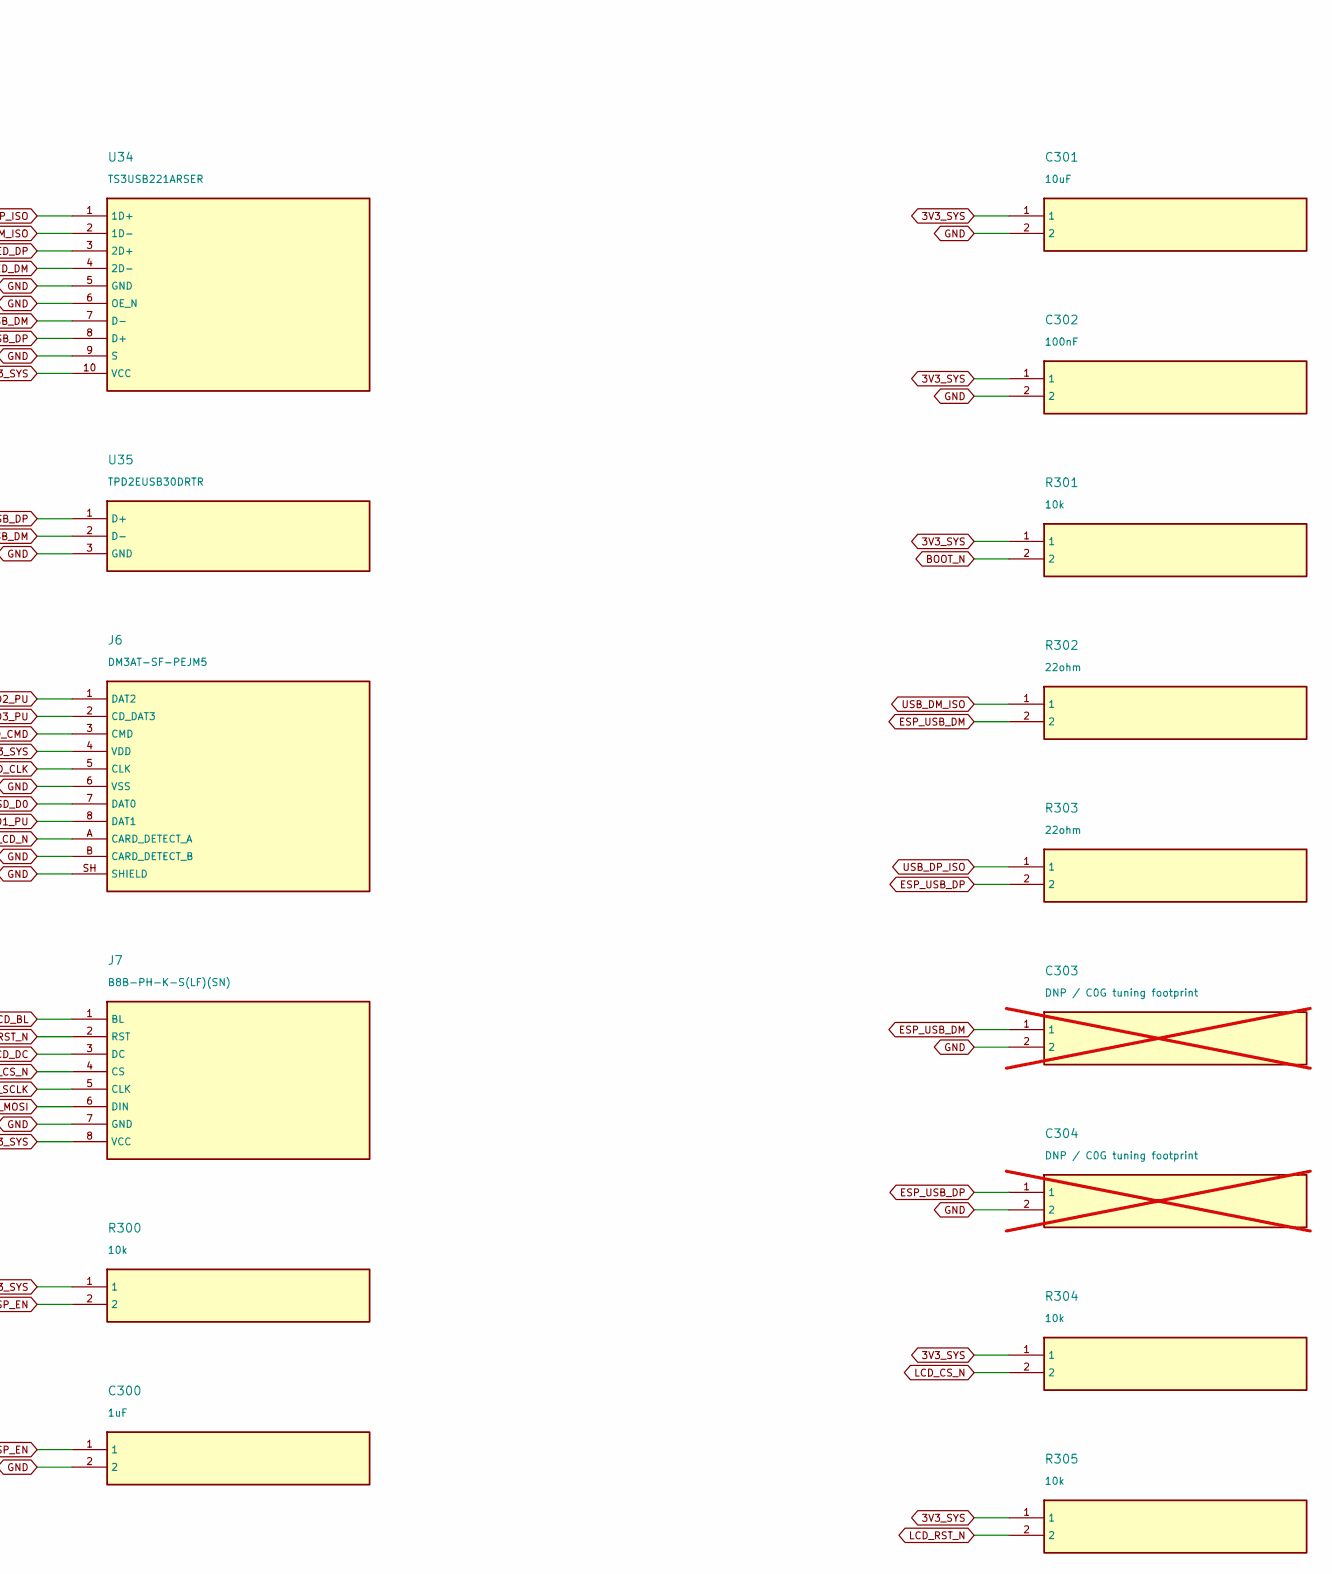
[picture p177: schematic 05_controller_1.kicad_sch, part in row 1, column 2]

Parts:
C300: 1uF
C301: 10uF
C302: 100nF
C303, C304: DNP / C0G tuning footprint; not fitted
J6: DM3AT-SF-PEJM5
J7: B8B-PH-K-S(LF)(SN)
R300, R301, R304, R305: 10k
R302, R303: 22ohm
U1: ESP32-S3-WROOM-1-N16R8
U30: RV-3028-C7-TA-QC
U31: PCA9536DR
U34: TS3USB221ARSER
U35: TPD2EUSB30DRTR

Connections:
3V3_SYS: C301.1, C302.1, J6.4 (VDD), J7.8 (VCC), R300.1, R301.1, R304.1, R305.1, U1.2 (3V3), U30.7 (VDD), U31.8 (VCC), U34.10 (VCC)
AMP_ENABLE: U1.10 (GPIO17)
BOOT_N: R301.2, U1.27 (GPIO0)
BTN_DOWN_N: U31.5 (P3)
BTN_START_N: U1.7 (GPIO7)
BTN_STOP_N: U31.2 (P1)
BTN_UP_N: U31.3 (P2)
CHARGING_N: U1.24 (GPIO47)
ESP_EN: C300.1, R300.2, U1.3 (EN)
ESP_USB_DM: C303.1, R302.2, U1.13 (GPIO19_USB_D-)
ESP_USB_DP: C304.1, R303.2, U1.14 (GPIO20_USB_D+)
GND: C300.2, C301.2, C302.2, C303.2, C304.2, J6.6 (VSS), J6.B (CARD_DETECT_B), J6.SH (SHIELD), J7.7 (GND), U1.1 (GND), U1.40 (GND), U1.41 (GND_EP), U30.5 (VSS), U31.4 (GND), U34.5 (GND), U34.6 (OE_N), U34.9 (S), U35.3 (GND)
I2C_SCL: U1.17 (GPIO9), U30.3 (SCL), U31.6 (SCL)
I2C_SDA: U1.12 (GPIO8), U30.4 (SDA), U31.7 (SDA)
I2S1_BCLK: U1.22 (GPIO14)
I2S1_DOUT: U1.9 (GPIO16)
I2S1_WS: U1.8 (GPIO15)
LCD_BL: J7.1 (BL), U1.21 (GPIO13)
LCD_CS_N: J7.4 (CS), R304.2, U1.18 (GPIO10)
LCD_DC: J7.3 (DC), U1.37 (GPIO43_U0TXD)
LCD_MOSI: J7.6 (DIN)
LCD_MOSI_MCU: U1.19 (GPIO11)
LCD_RST_N: J7.2 (RST), R305.2, U1.36 (GPIO44_U0RXD)
LCD_SCLK: J7.5 (CLK)
LCD_SCLK_MCU: U1.20 (GPIO12)
PDM_CLK: U1.4 (GPIO4)
PDM_DIN0: U1.5 (GPIO5)
PDM_DIN1: U1.6 (GPIO6)
POWER_HOLD: U1.23 (GPIO21)
PWR_INT_N: U1.11 (GPIO18)
RTC_EVI: U30.8 (EVI)
RTC_VBACKUP: U30.6 (VBACKUP)
SD_CD_N: J6.A (CARD_DETECT_A), U1.34 (GPIO41)
SD_CLK: J6.5 (CLK)
SD_CLK_MCU: U1.31 (GPIO38)
SD_CMD: J6.3 (CMD), U1.32 (GPIO39)
SD_D0: J6.7 (DAT0), U1.33 (GPIO40)
SD_D1_PU: J6.8 (DAT1)
SD_D2_PU: J6.1 (DAT2)
SD_D3_PU: J6.2 (CD_DAT3)
USB_DM: U34.7 (D-), U35.2 (D-)
USB_DM_ISO: R302.1, U34.2 (1D-)
USB_DP: U34.8 (D+), U35.1 (D+)
USB_DP_ISO: R303.1, U34.1 (1D+)
USB_ENUM_500: U1.39 (GPIO1)
USB_PGOOD_N: U1.25 (GPIO48)
USB_SUSPEND: U1.38 (GPIO2)
USB_UNUSED_DM: U34.4 (2D-)
USB_UNUSED_DP: U34.3 (2D+)

Notes on the sheet:
MATCHING GLOBAL LABELS ARE ELECTRICALLY CONNECTED / PHYSICAL PIN NUMBERS SHOWN
