NathanHor22/Quipus/output/pcb/Quipus-A1/schematics/05_controller_2.kicad_sch

## KiCad design output/pcb/Quipus-A1/schematics/05_controller_2.kicad_sch (2026-10-06)

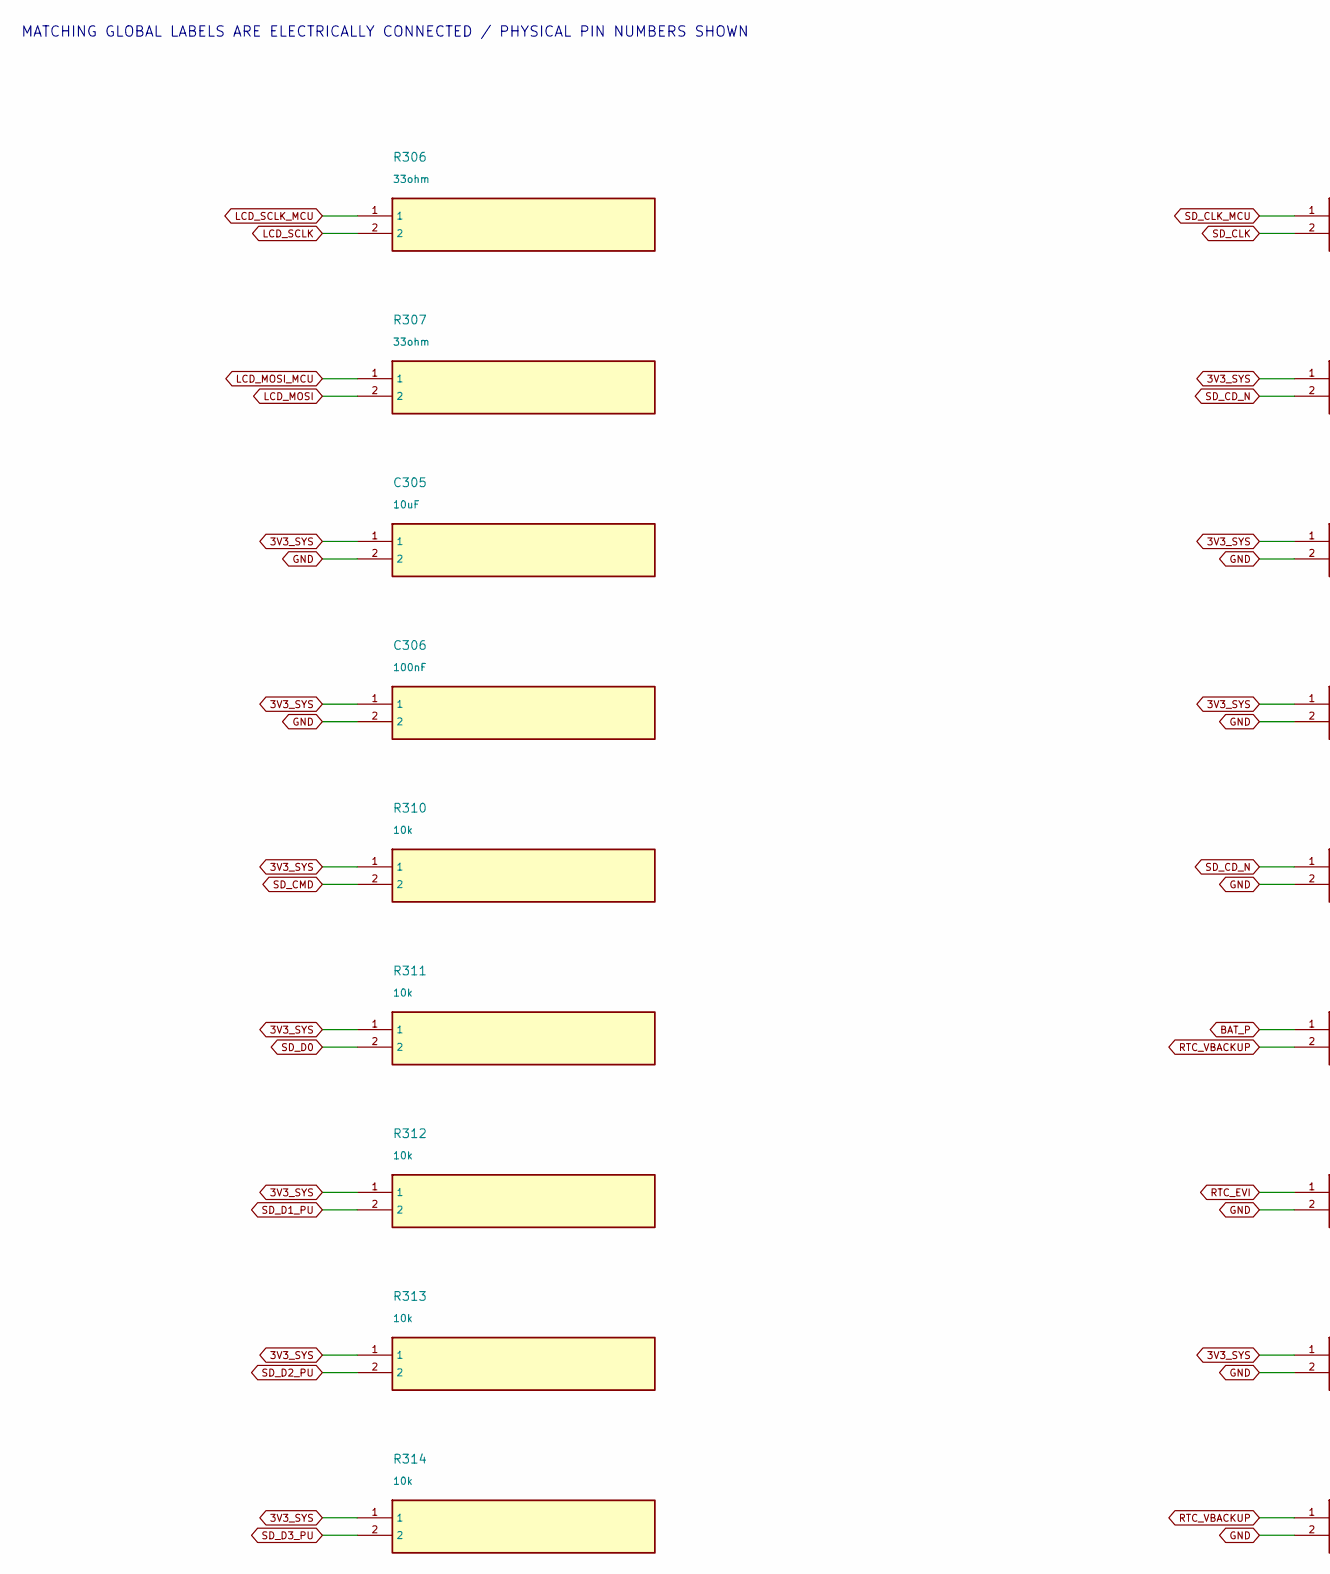
[picture p178: schematic 05_controller_2.kicad_sch, part in row 1, column 1]

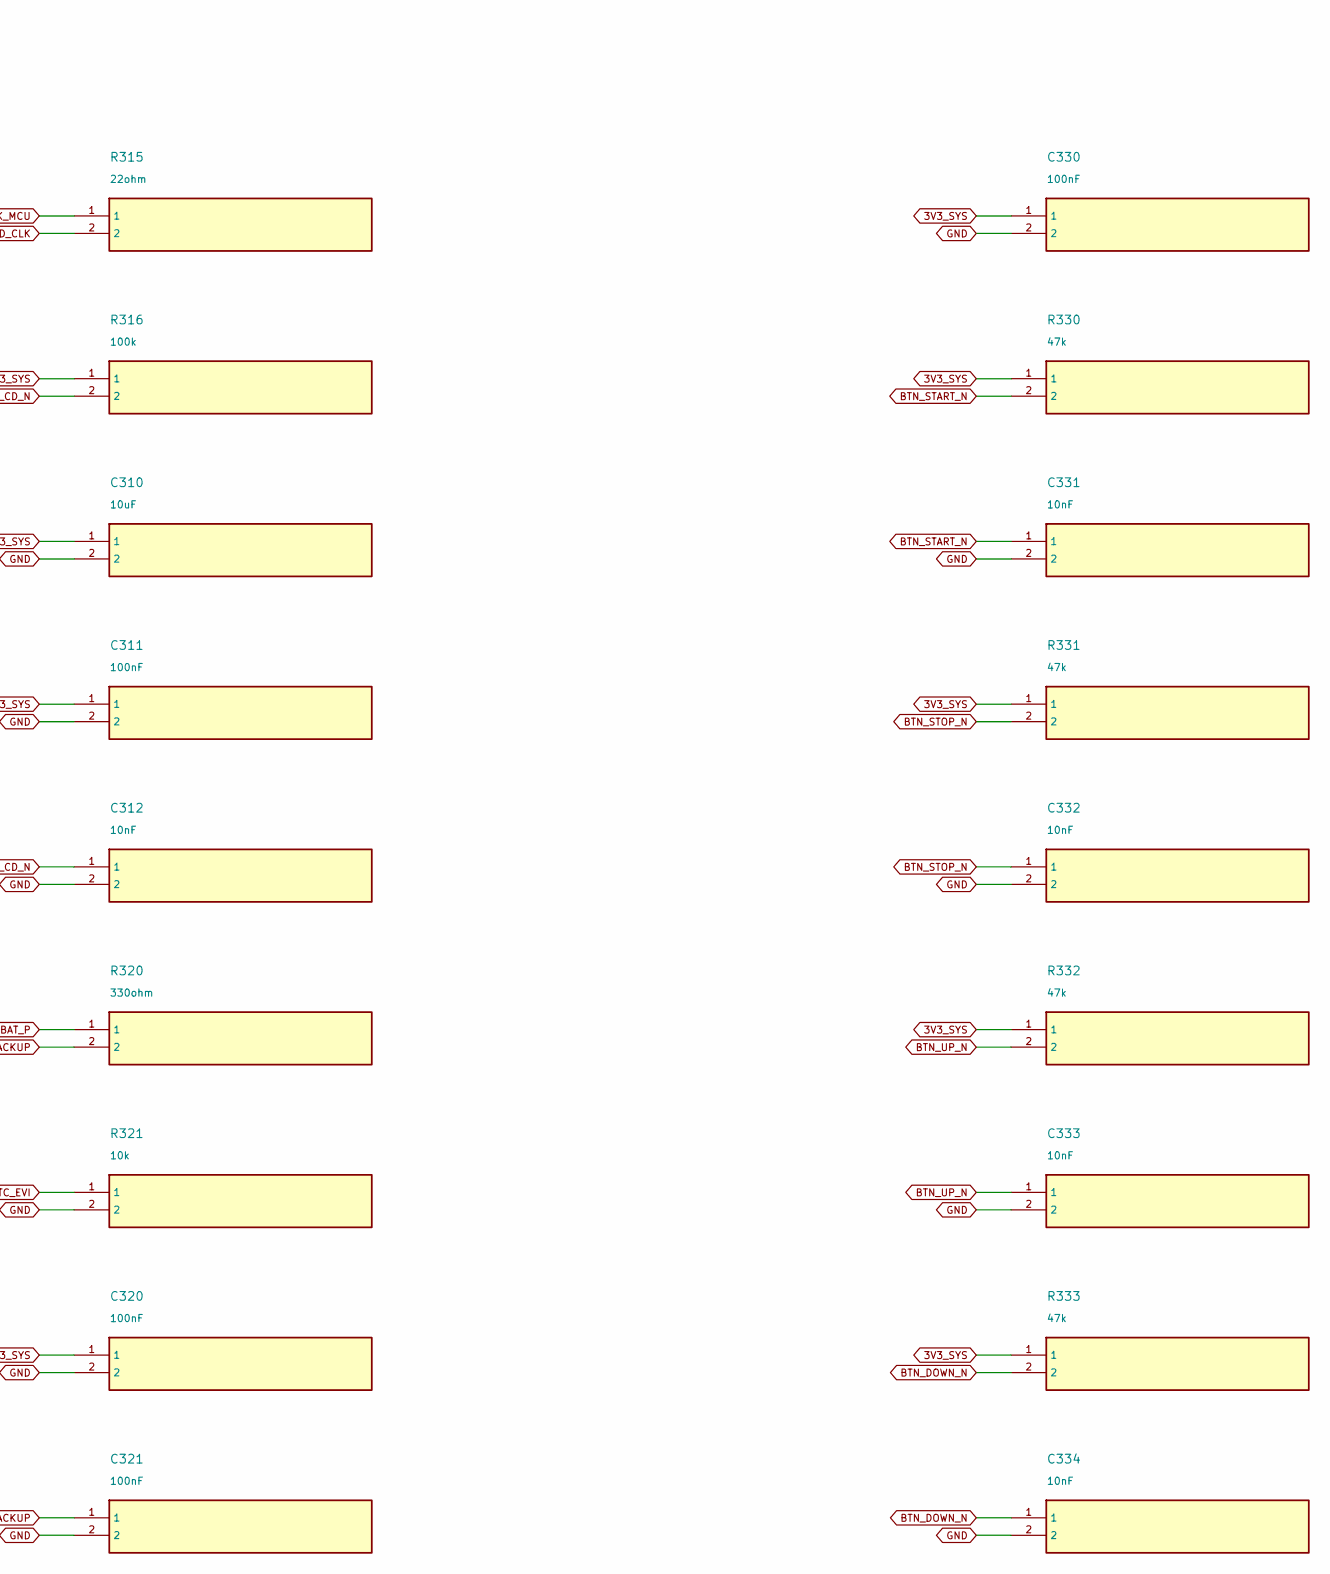
[picture p179: schematic 05_controller_2.kicad_sch, part in row 1, column 2]

Parts:
C305, C310: 10uF
C306, C311, C320, C321, C330: 100nF
C312, C331, C332, C333, C334: 10nF
R306, R307: 33ohm
R310, R311, R312, R313, R314, R321: 10k
R315: 22ohm
R316: 100k
R320: 330ohm
R330, R331, R332, R333: 47k

Connections:
3V3_SYS: C305.1, C306.1, C310.1, C311.1, C320.1, C330.1, R310.1, R311.1, R312.1, R313.1, R314.1, R316.1, R330.1, R331.1, R332.1, R333.1
BAT_P: R320.1
BTN_DOWN_N: C334.1, R333.2
BTN_START_N: C331.1, R330.2
BTN_STOP_N: C332.1, R331.2
BTN_UP_N: C333.1, R332.2
GND: C305.2, C306.2, C310.2, C311.2, C312.2, C320.2, C321.2, C330.2, C331.2, C332.2, C333.2, C334.2, R321.2
LCD_MOSI: R307.2
LCD_MOSI_MCU: R307.1
LCD_SCLK: R306.2
LCD_SCLK_MCU: R306.1
RTC_EVI: R321.1
RTC_VBACKUP: C321.1, R320.2
SD_CD_N: C312.1, R316.2
SD_CLK: R315.2
SD_CLK_MCU: R315.1
SD_CMD: R310.2
SD_D0: R311.2
SD_D1_PU: R312.2
SD_D2_PU: R313.2
SD_D3_PU: R314.2

Notes on the sheet:
MATCHING GLOBAL LABELS ARE ELECTRICALLY CONNECTED / PHYSICAL PIN NUMBERS SHOWN
