NathanHor22/Quipus/output/pcb/Quipus-A1/schematics/05_controller_3.kicad_sch

## KiCad design output/pcb/Quipus-A1/schematics/05_controller_3.kicad_sch (2026-10-06)

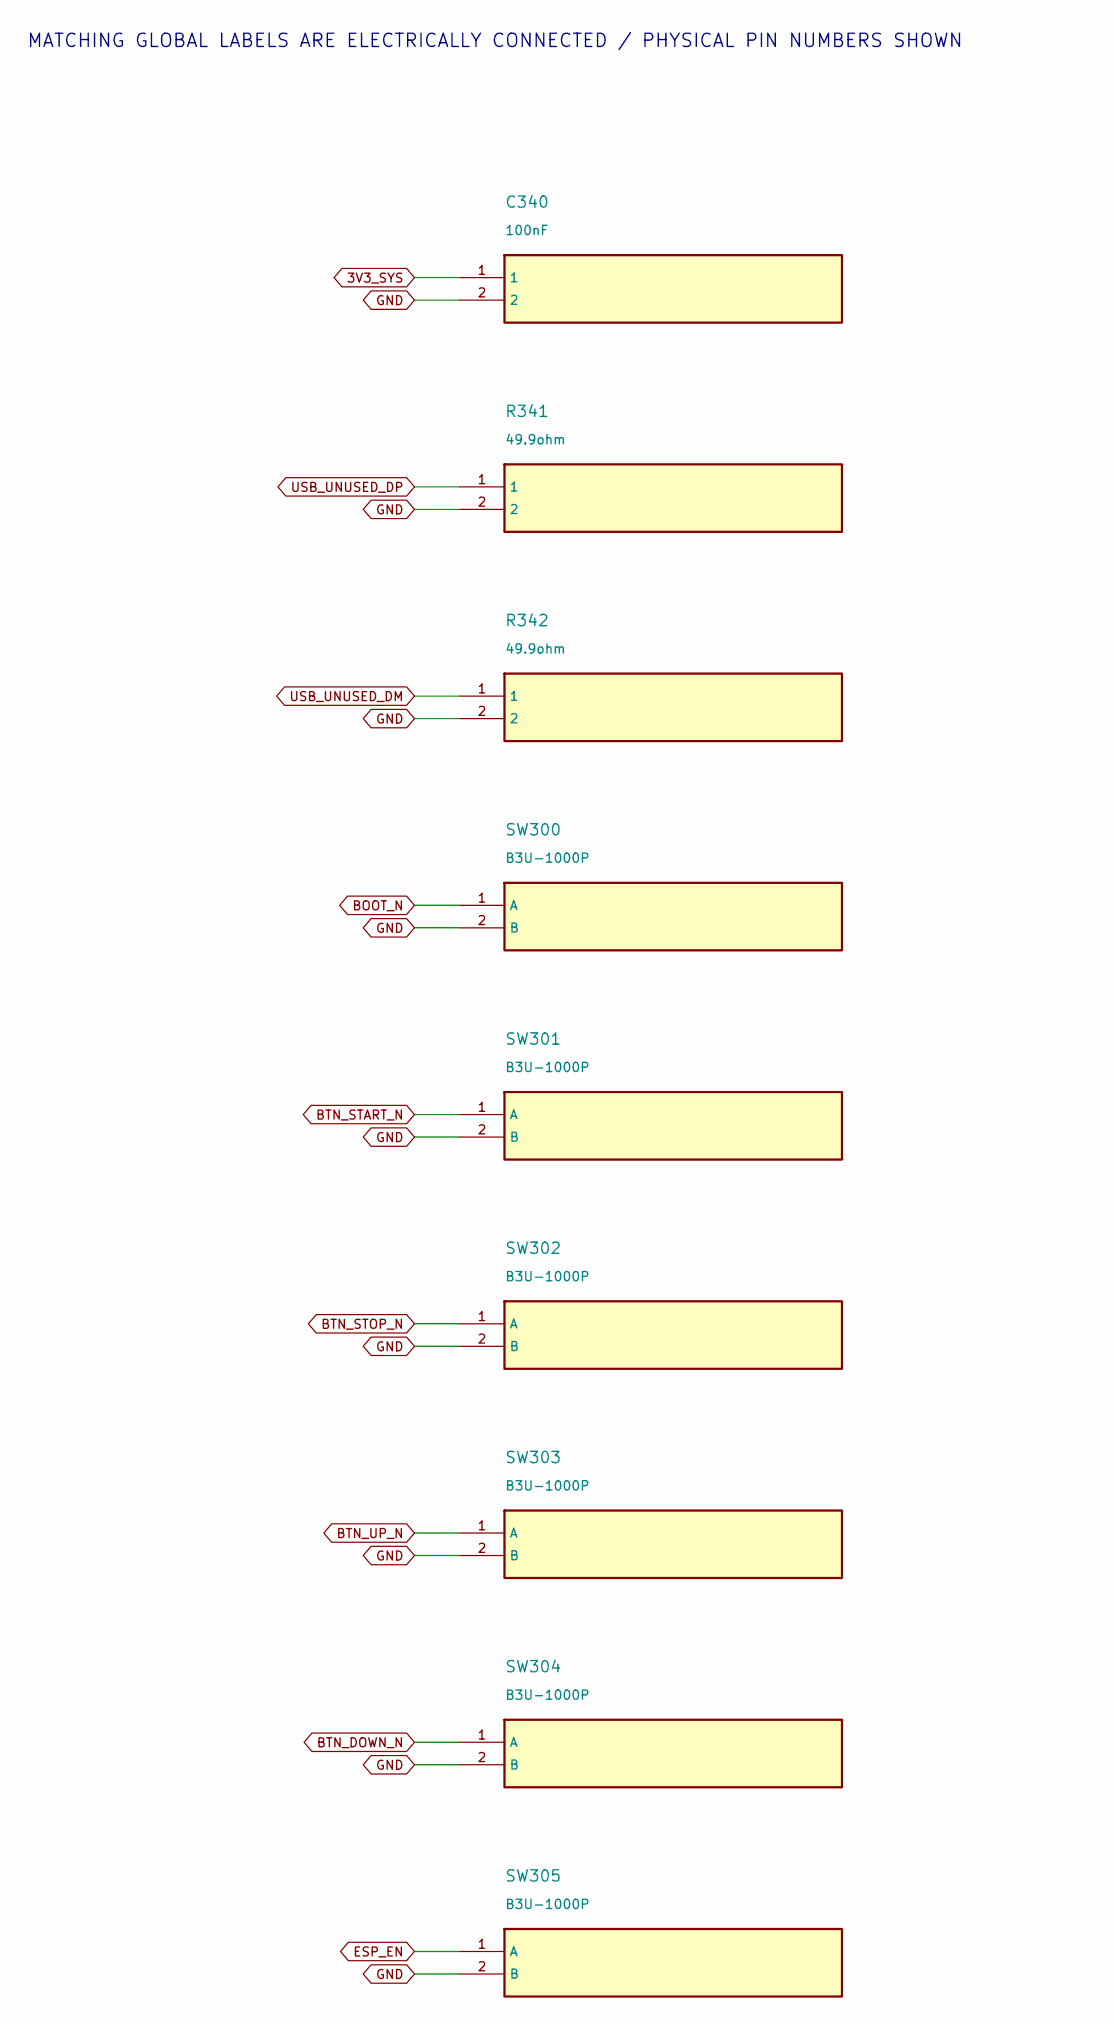
[picture p180: schematic 05_controller_3.kicad_sch]

Parts:
C340: 100nF
R341, R342: 49.9ohm
SW300, SW301, SW302, SW303, SW304, SW305: B3U-1000P

Connections:
3V3_SYS: C340.1
BOOT_N: SW300.1 (A)
BTN_DOWN_N: SW304.1 (A)
BTN_START_N: SW301.1 (A)
BTN_STOP_N: SW302.1 (A)
BTN_UP_N: SW303.1 (A)
ESP_EN: SW305.1 (A)
GND: C340.2, R341.2, R342.2, SW300.2 (B), SW301.2 (B), SW302.2 (B), SW303.2 (B), SW304.2 (B), SW305.2 (B)
USB_UNUSED_DM: R342.1
USB_UNUSED_DP: R341.1

Notes on the sheet:
MATCHING GLOBAL LABELS ARE ELECTRICALLY CONNECTED / PHYSICAL PIN NUMBERS SHOWN
