NathanHor22/Quipus/output/pcb/Quipus-A1/schematics/06_audio_1.kicad_sch

## KiCad design output/pcb/Quipus-A1/schematics/06_audio_1.kicad_sch (2026-10-06)

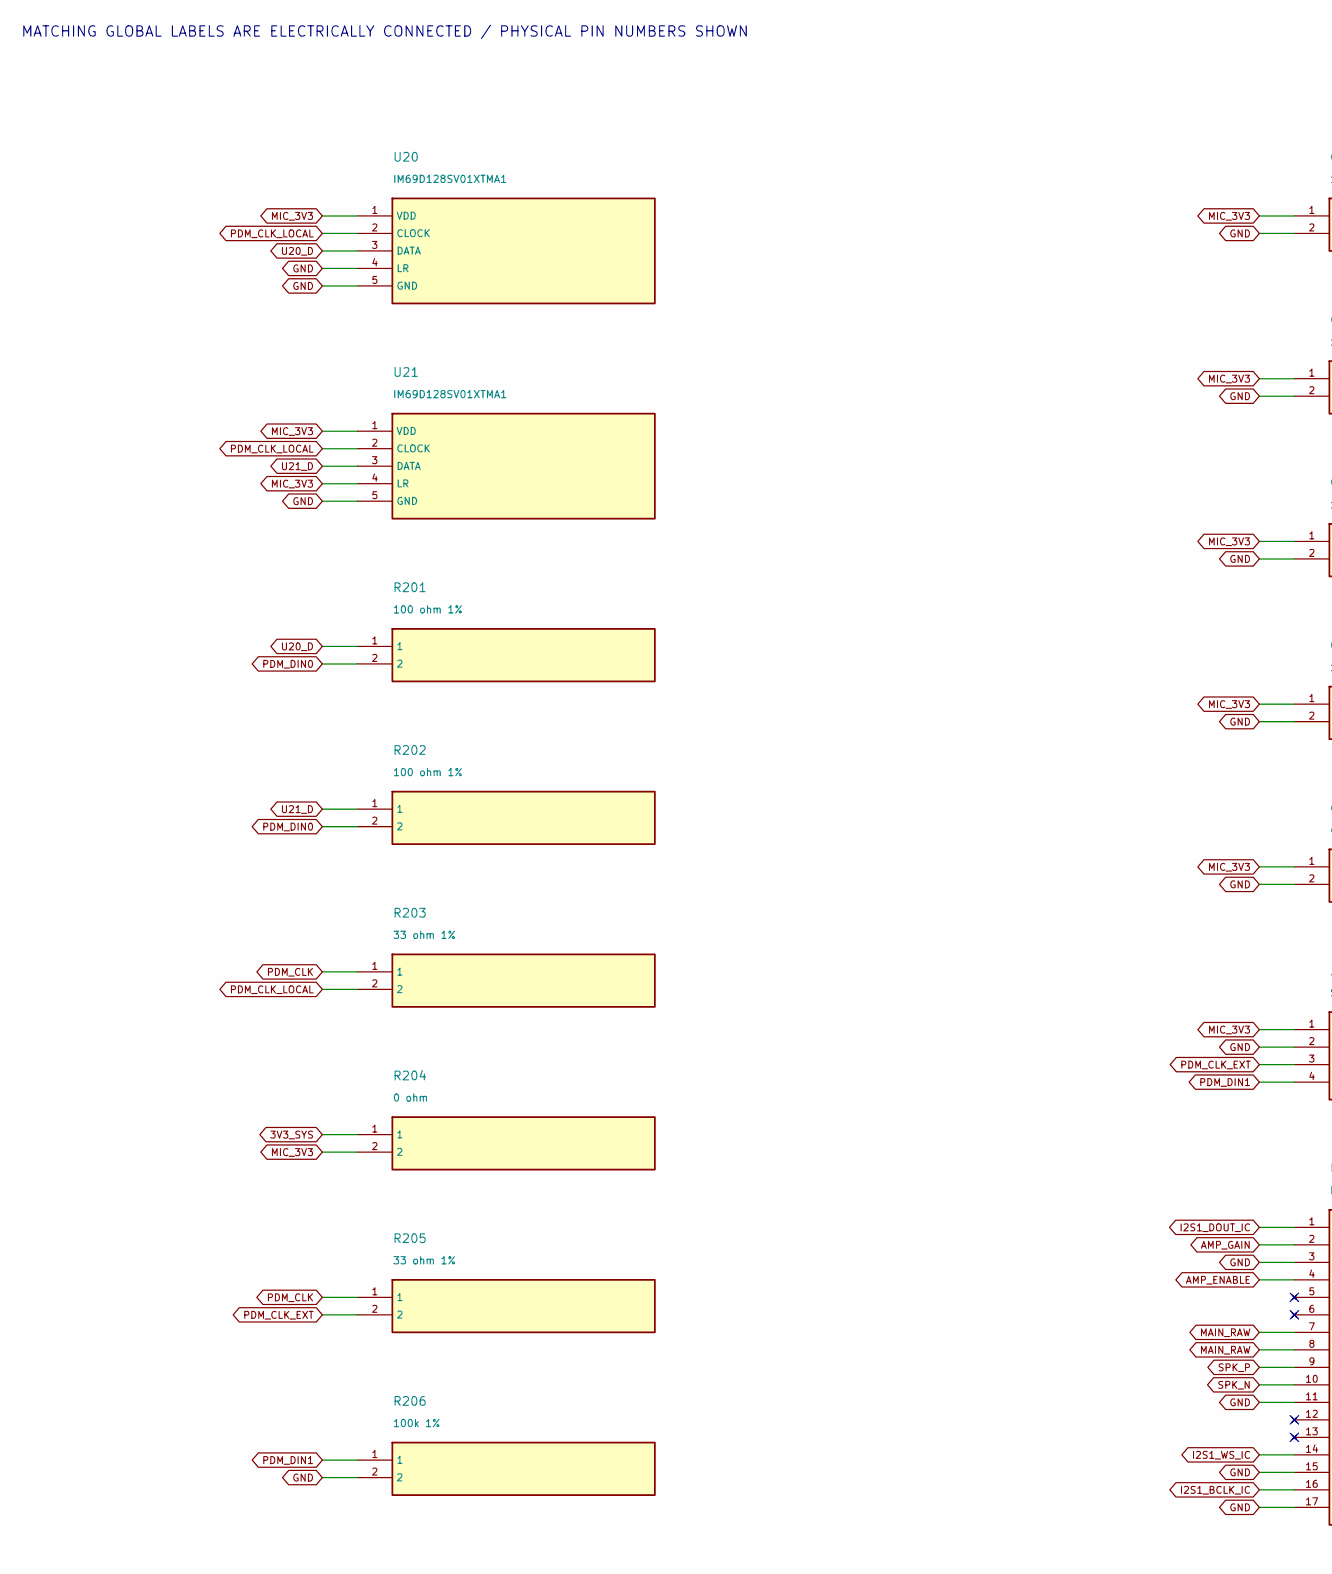
[picture p181: schematic 06_audio_1.kicad_sch, part in row 1, column 1]

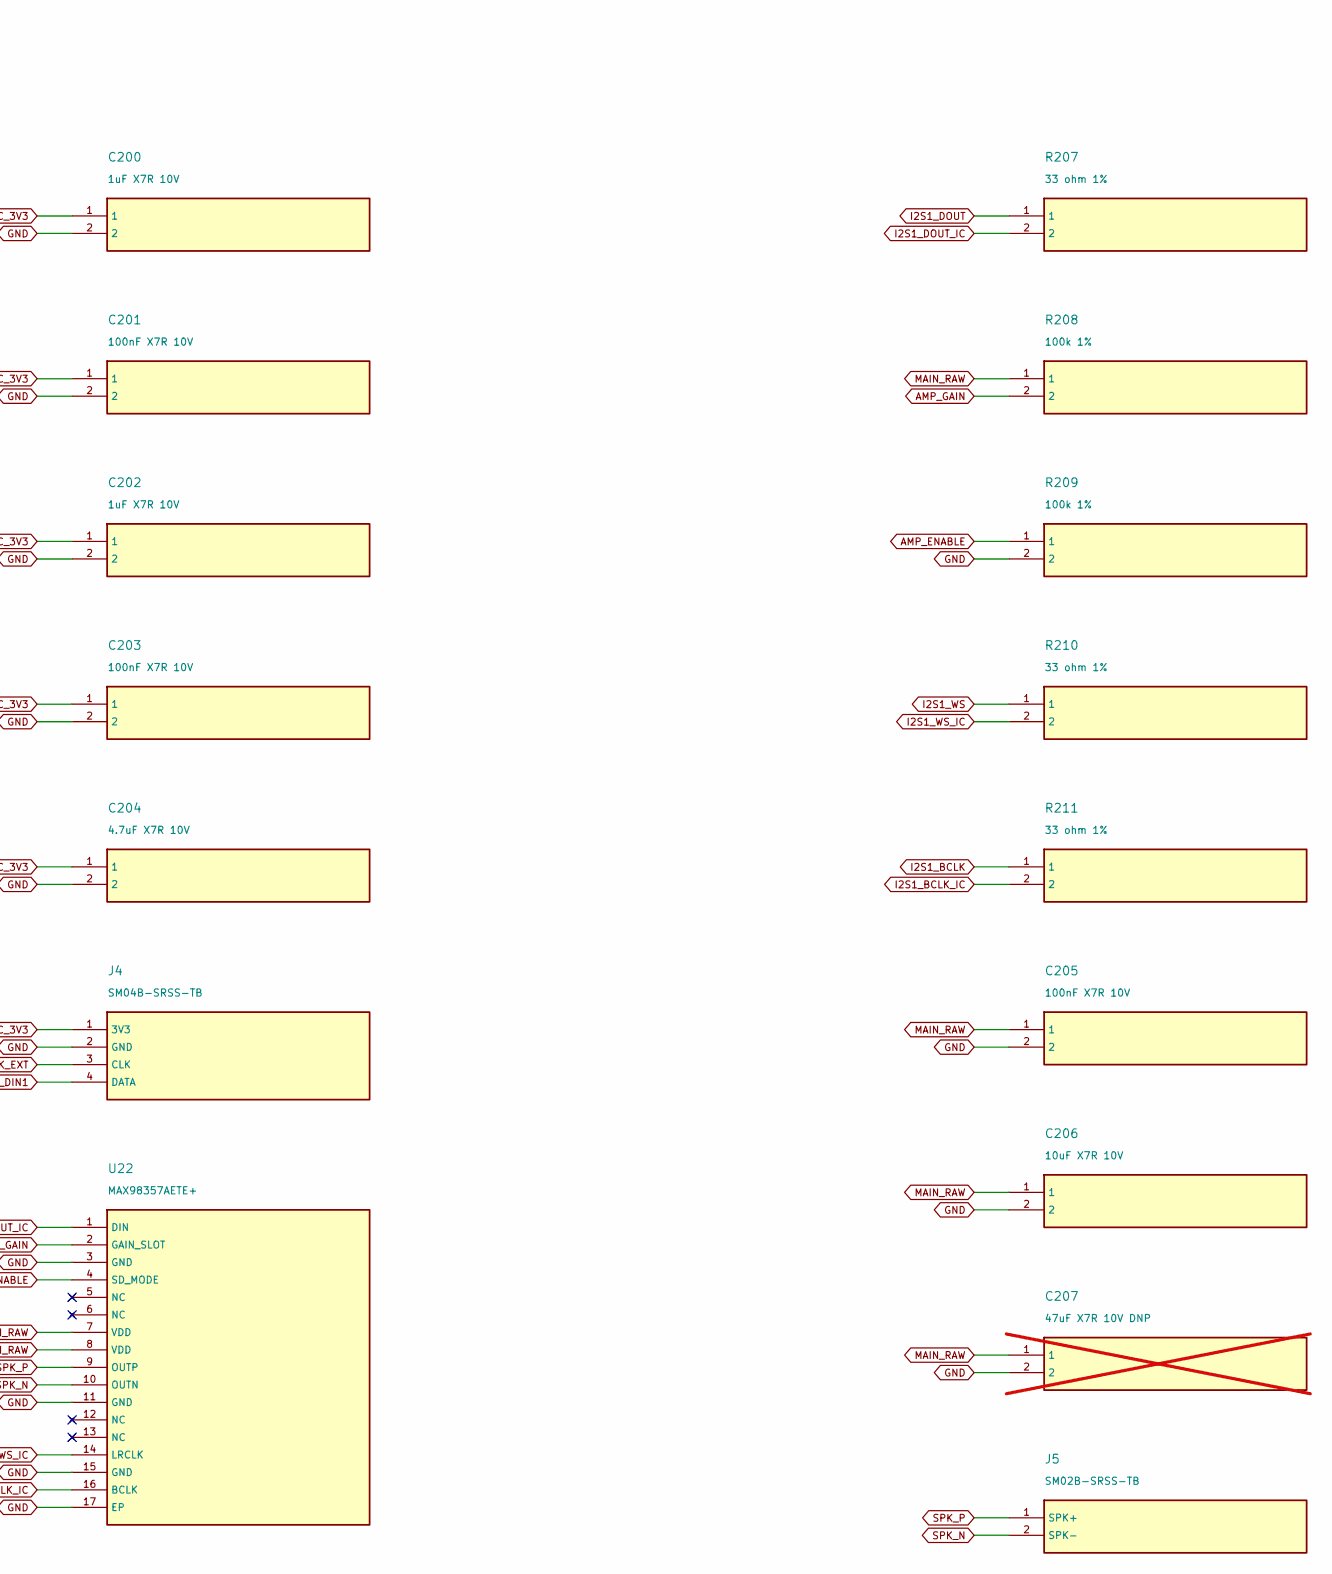
[picture p182: schematic 06_audio_1.kicad_sch, part in row 1, column 2]

Parts:
C200, C202: 1uF X7R 10V
C201, C203, C205: 100nF X7R 10V
C204: 4.7uF X7R 10V
C206: 10uF X7R 10V
C207: 47uF X7R 10V DNP; not fitted
J4: SM04B-SRSS-TB
J5: SM02B-SRSS-TB
R201, R202: 100 ohm 1%
R203, R205, R207, R210, R211: 33 ohm 1%
R204: 0 ohm
R206, R208, R209: 100k 1%
U20, U21: IM69D128SV01XTMA1
U22: MAX98357AETE+

Connections:
3V3_SYS: R204.1
AMP_ENABLE: R209.1, U22.4 (SD_MODE)
AMP_GAIN: R208.2, U22.2 (GAIN_SLOT)
GND: C200.2, C201.2, C202.2, C203.2, C204.2, C205.2, C206.2, C207.2, J4.2 (GND), R206.2, R209.2, U20.4 (LR), U20.5 (GND), U21.5 (GND), U22.3 (GND), U22.11 (GND), U22.15 (GND), U22.17 (EP)
I2S1_BCLK: R211.1
I2S1_BCLK_IC: R211.2, U22.16 (BCLK)
I2S1_DOUT: R207.1
I2S1_DOUT_IC: R207.2, U22.1 (DIN)
I2S1_WS: R210.1
I2S1_WS_IC: R210.2, U22.14 (LRCLK)
MAIN_RAW: C205.1, C206.1, C207.1, R208.1, U22.7 (VDD), U22.8 (VDD)
MIC_3V3: C200.1, C201.1, C202.1, C203.1, C204.1, J4.1 (3V3), R204.2, U20.1 (VDD), U21.1 (VDD), U21.4 (LR)
PDM_CLK: R203.1, R205.1
PDM_CLK_EXT: J4.3 (CLK), R205.2
PDM_CLK_LOCAL: R203.2, U20.2 (CLOCK), U21.2 (CLOCK)
PDM_DIN0: R201.2, R202.2
PDM_DIN1: J4.4 (DATA), R206.1
SPK_N: J5.2 (SPK-), U22.10 (OUTN)
SPK_P: J5.1 (SPK+), U22.9 (OUTP)
U20_D: R201.1, U20.3 (DATA)
U21_D: R202.1, U21.3 (DATA)

Notes on the sheet:
MATCHING GLOBAL LABELS ARE ELECTRICALLY CONNECTED / PHYSICAL PIN NUMBERS SHOWN
