NathanHor22/Quipus/output/pcb/Quipus-B1/schematics/06_internal_microphones_1.kicad_sch

## KiCad design output/pcb/Quipus-B1/schematics/06_internal_microphones_1.kicad_sch (2026-10-06)

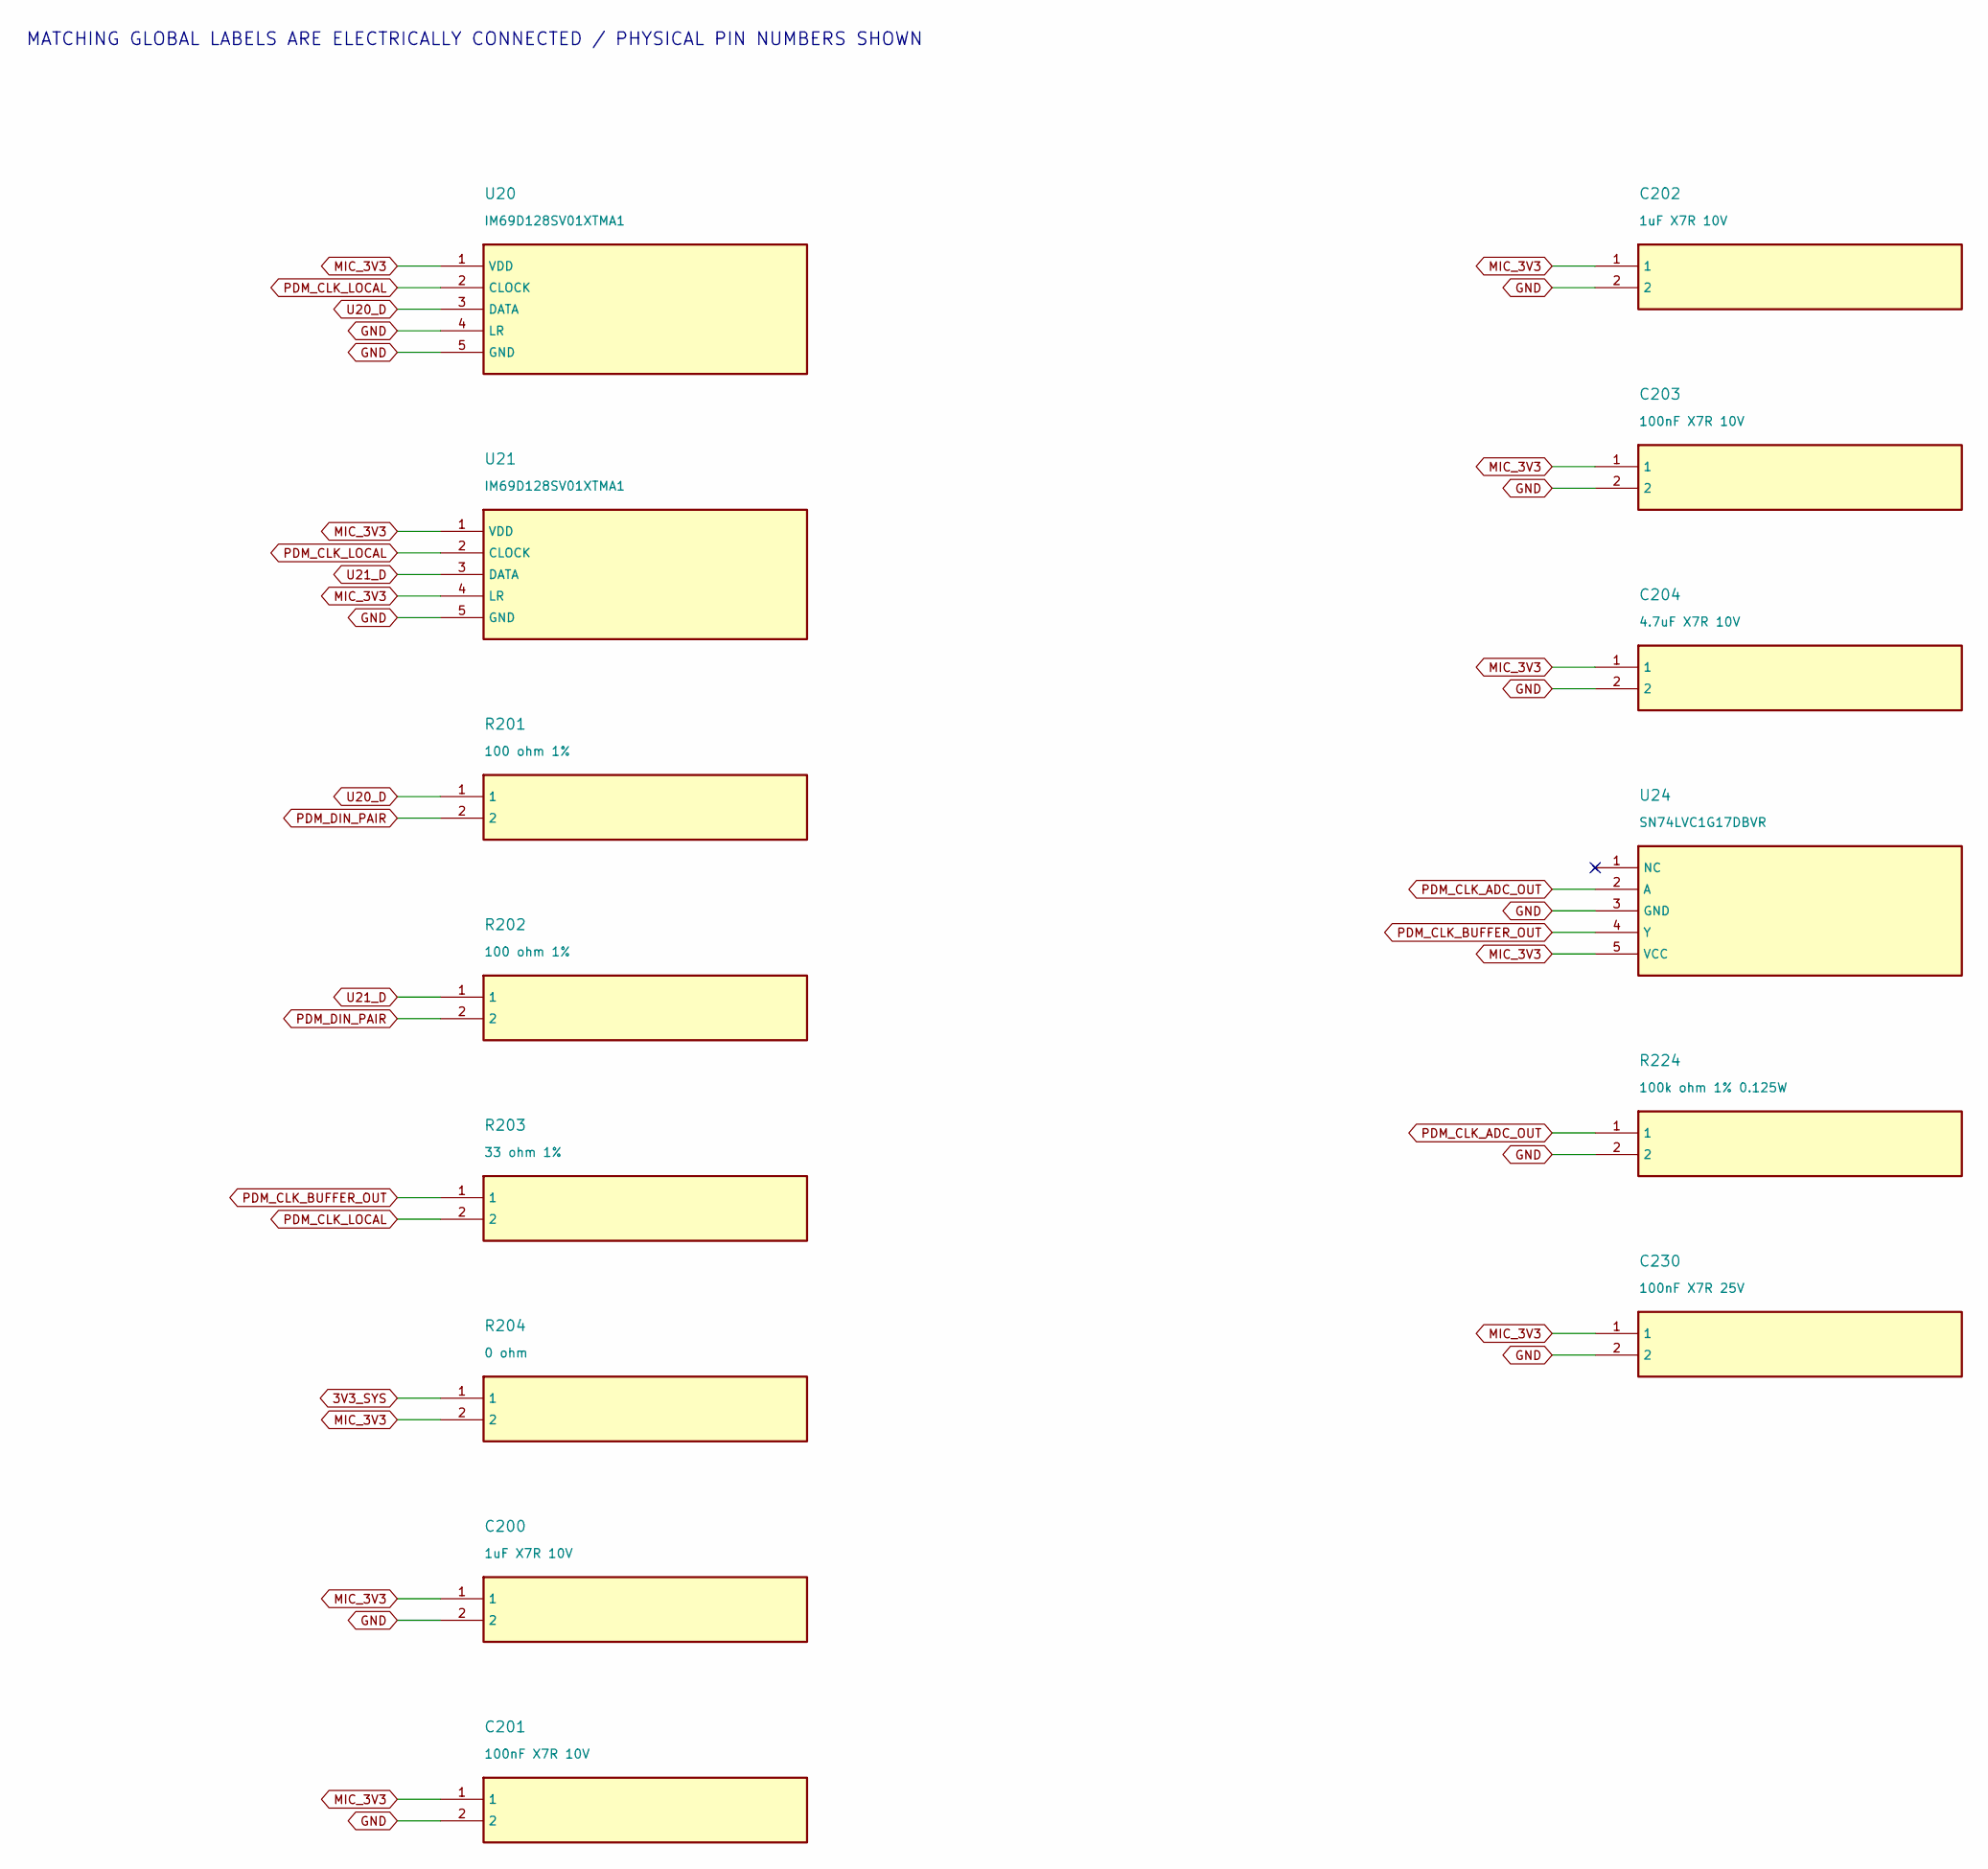
[picture p183: schematic 06_internal_microphones_1.kicad_sch]

Parts:
C200, C202: 1uF X7R 10V
C201, C203: 100nF X7R 10V
C204: 4.7uF X7R 10V
C230: 100nF X7R 25V
R201, R202: 100 ohm 1%
R203: 33 ohm 1%
R204: 0 ohm
R224: 100k ohm 1% 0.125W
U20, U21: IM69D128SV01XTMA1
U24: SN74LVC1G17DBVR

Connections:
3V3_SYS: R204.1
GND: C200.2, C201.2, C202.2, C203.2, C204.2, C230.2, R224.2, U20.4 (LR), U20.5 (GND), U21.5 (GND), U24.3 (GND)
MIC_3V3: C200.1, C201.1, C202.1, C203.1, C204.1, C230.1, R204.2, U20.1 (VDD), U21.1 (VDD), U21.4 (LR), U24.5 (VCC)
PDM_CLK_ADC_OUT: R224.1, U24.2 (A)
PDM_CLK_BUFFER_OUT: R203.1, U24.4 (Y)
PDM_CLK_LOCAL: R203.2, U20.2 (CLOCK), U21.2 (CLOCK)
PDM_DIN_PAIR: R201.2, R202.2
U20_D: R201.1, U20.3 (DATA)
U21_D: R202.1, U21.3 (DATA)

Notes on the sheet:
MATCHING GLOBAL LABELS ARE ELECTRICALLY CONNECTED / PHYSICAL PIN NUMBERS SHOWN
