NathanHor22/Quipus/output/pcb/Quipus-B1/schematics/07_speaker_amplifier_1.kicad_sch

## KiCad design output/pcb/Quipus-B1/schematics/07_speaker_amplifier_1.kicad_sch (2026-10-06)

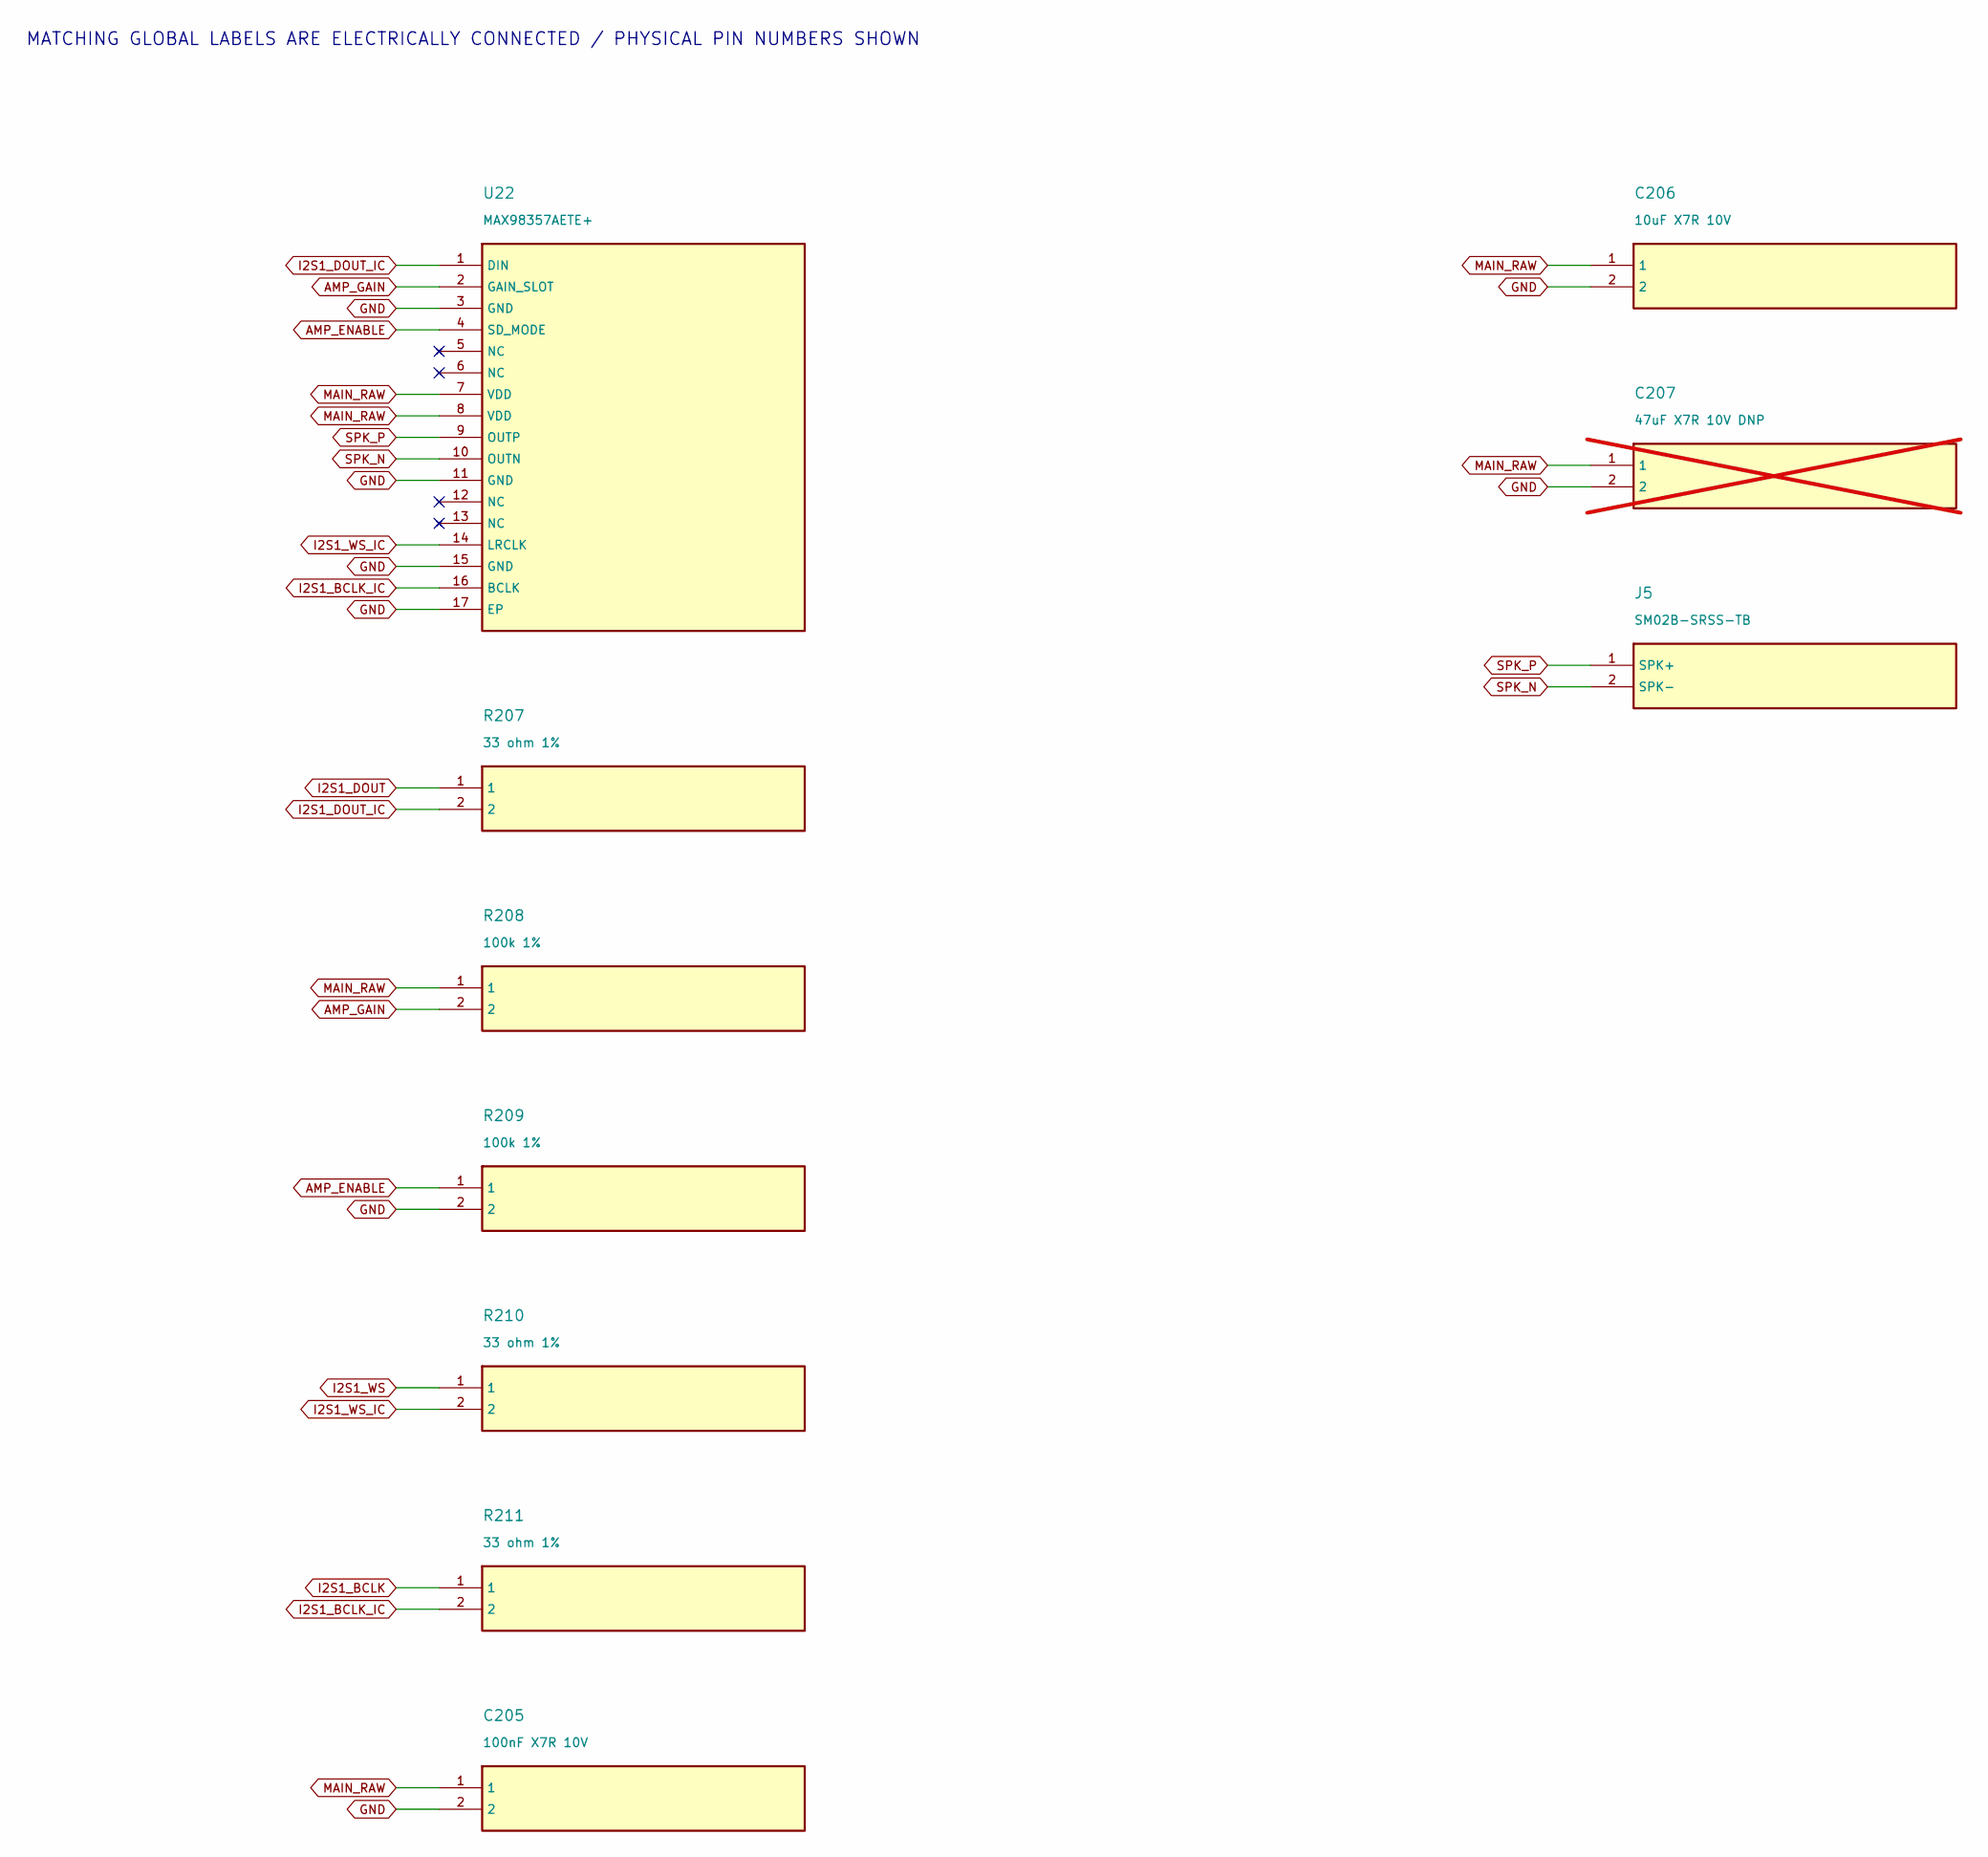
[picture p184: schematic 07_speaker_amplifier_1.kicad_sch]

Parts:
C205: 100nF X7R 10V
C206: 10uF X7R 10V
C207: 47uF X7R 10V DNP; not fitted
J5: SM02B-SRSS-TB
R207, R210, R211: 33 ohm 1%
R208, R209: 100k 1%
U22: MAX98357AETE+

Connections:
AMP_ENABLE: R209.1, U22.4 (SD_MODE)
AMP_GAIN: R208.2, U22.2 (GAIN_SLOT)
GND: C205.2, C206.2, C207.2, R209.2, U22.3 (GND), U22.11 (GND), U22.15 (GND), U22.17 (EP)
I2S1_BCLK: R211.1
I2S1_BCLK_IC: R211.2, U22.16 (BCLK)
I2S1_DOUT: R207.1
I2S1_DOUT_IC: R207.2, U22.1 (DIN)
I2S1_WS: R210.1
I2S1_WS_IC: R210.2, U22.14 (LRCLK)
MAIN_RAW: C205.1, C206.1, C207.1, R208.1, U22.7 (VDD), U22.8 (VDD)
SPK_N: J5.2 (SPK-), U22.10 (OUTN)
SPK_P: J5.1 (SPK+), U22.9 (OUTP)

Notes on the sheet:
MATCHING GLOBAL LABELS ARE ELECTRICALLY CONNECTED / PHYSICAL PIN NUMBERS SHOWN
