NathanHor22/Quipus/output/pcb/Quipus-B1/schematics/08_four_channel_audio_capture_1.kicad_sch

## KiCad design output/pcb/Quipus-B1/schematics/08_four_channel_audio_capture_1.kicad_sch (2026-10-06)

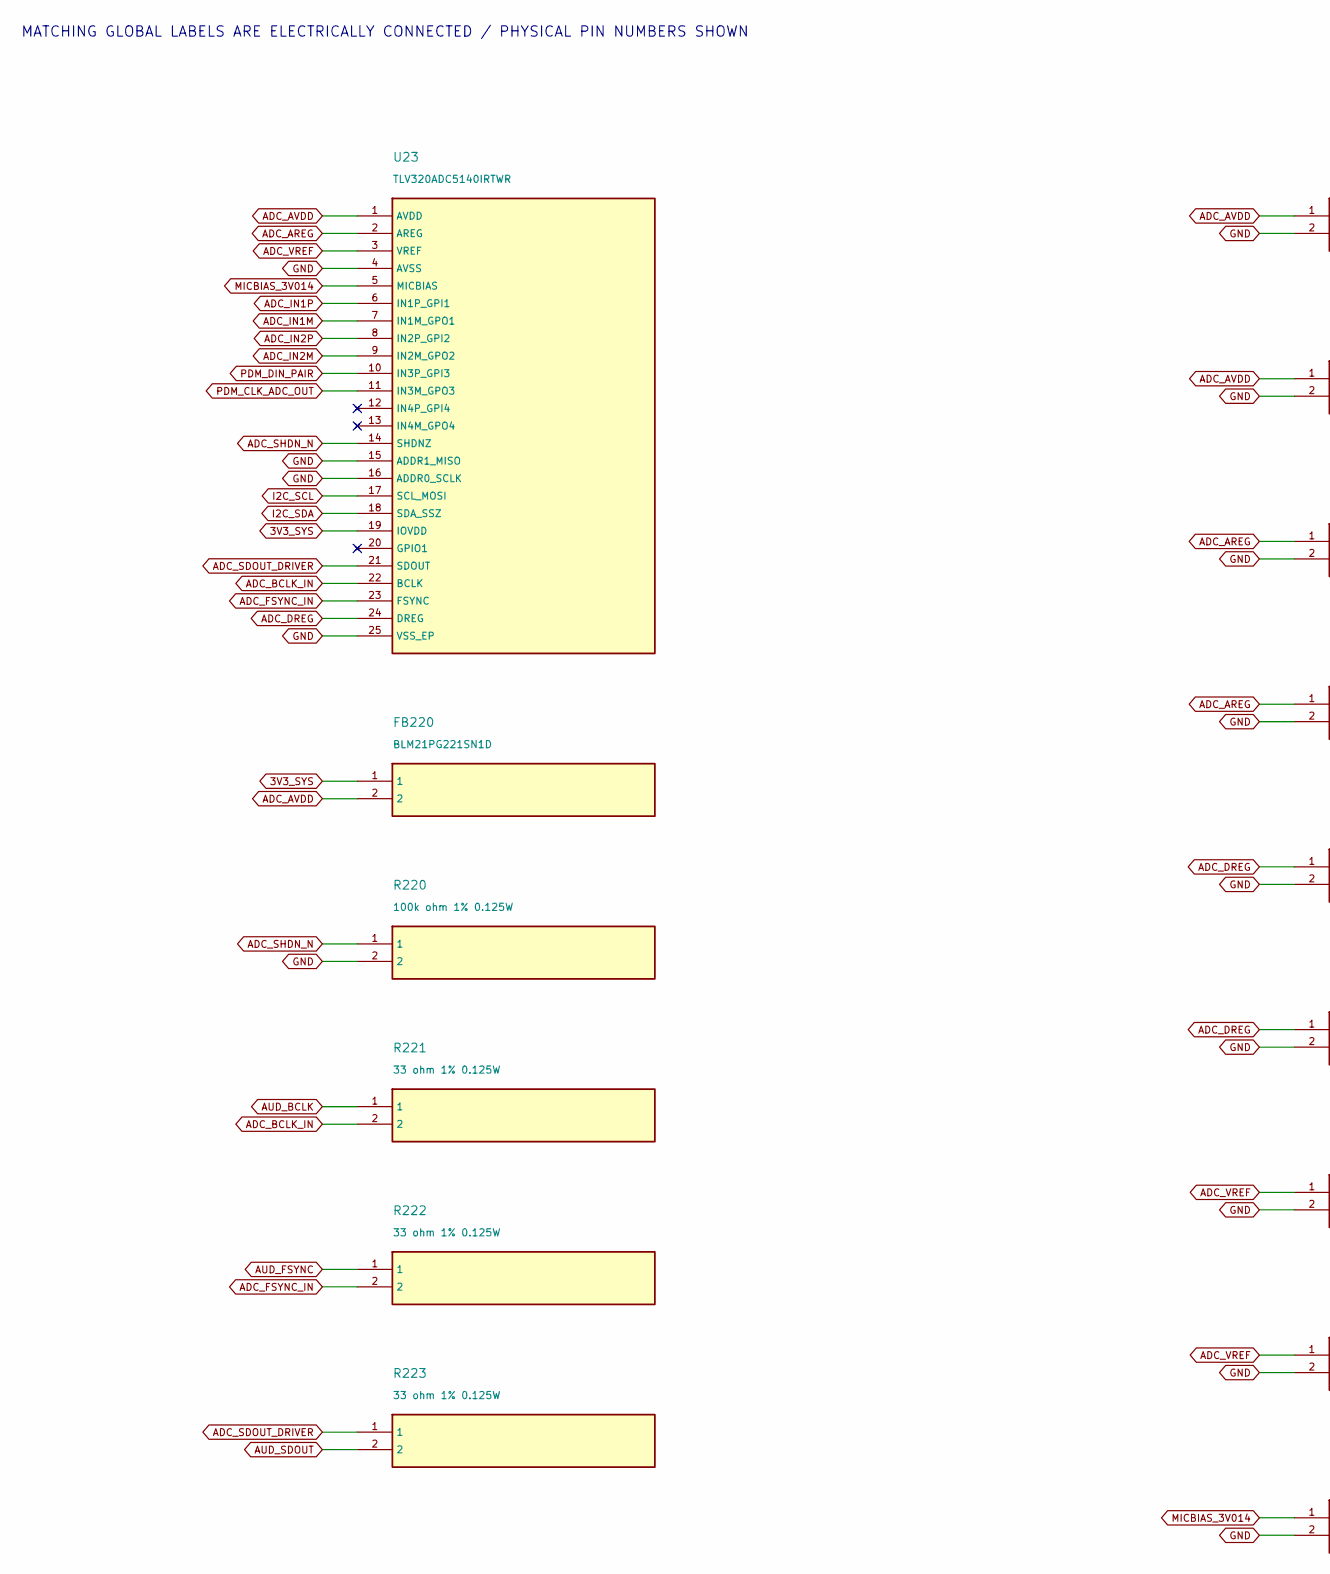
[picture p185: schematic 08_four_channel_audio_capture_1.kicad_sch, part in row 1, column 1]

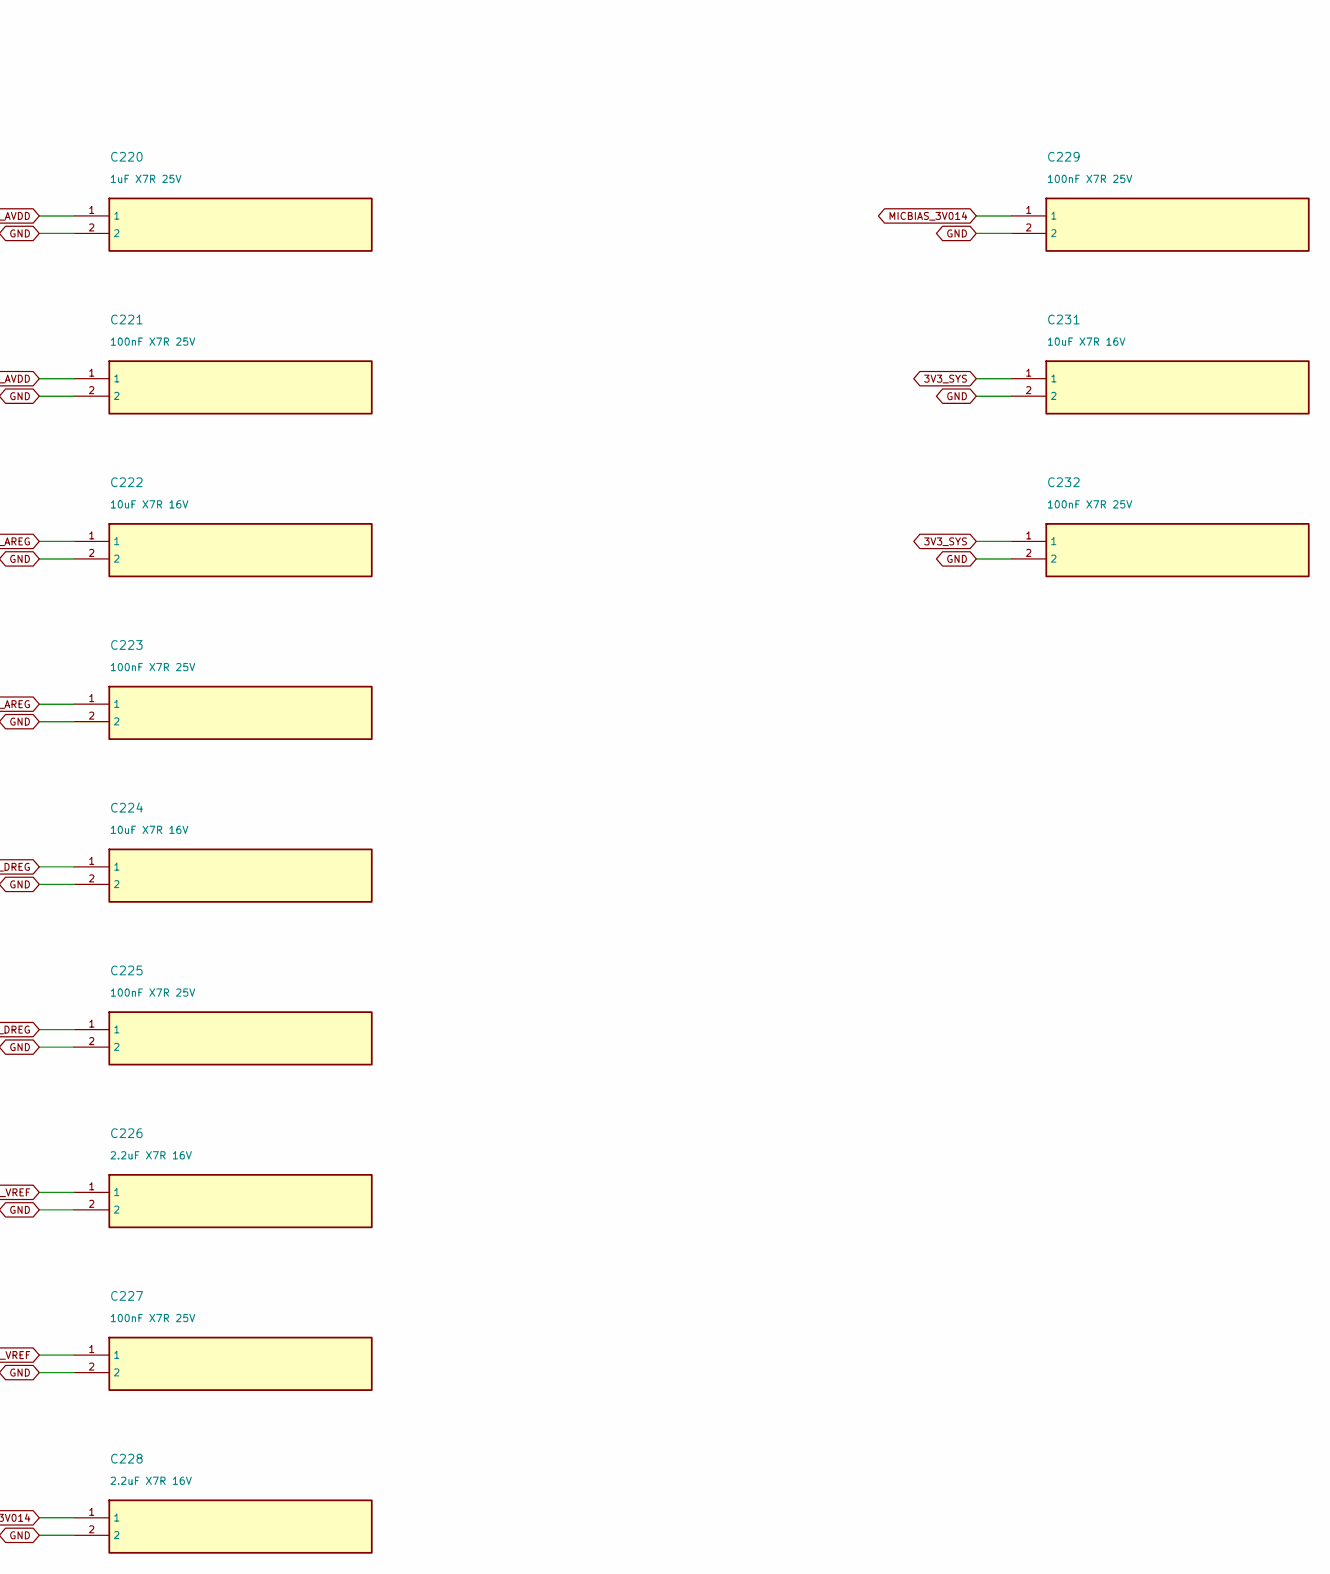
[picture p186: schematic 08_four_channel_audio_capture_1.kicad_sch, part in row 1, column 2]

Parts:
C220: 1uF X7R 25V
C221, C223, C225, C227, C229, C232: 100nF X7R 25V
C222, C224, C231: 10uF X7R 16V
C226, C228: 2.2uF X7R 16V
FB220: BLM21PG221SN1D
R220: 100k ohm 1% 0.125W
R221, R222, R223: 33 ohm 1% 0.125W
U23: TLV320ADC5140IRTWR

Connections:
3V3_SYS: C231.1, C232.1, FB220.1, U23.19 (IOVDD)
ADC_AREG: C222.1, C223.1, U23.2 (AREG)
ADC_AVDD: C220.1, C221.1, FB220.2, U23.1 (AVDD)
ADC_BCLK_IN: R221.2, U23.22 (BCLK)
ADC_DREG: C224.1, C225.1, U23.24 (DREG)
ADC_FSYNC_IN: R222.2, U23.23 (FSYNC)
ADC_IN1M: U23.7 (IN1M_GPO1)
ADC_IN1P: U23.6 (IN1P_GPI1)
ADC_IN2M: U23.9 (IN2M_GPO2)
ADC_IN2P: U23.8 (IN2P_GPI2)
ADC_SDOUT_DRIVER: R223.1, U23.21 (SDOUT)
ADC_SHDN_N: R220.1, U23.14 (SHDNZ)
ADC_VREF: C226.1, C227.1, U23.3 (VREF)
AUD_BCLK: R221.1
AUD_FSYNC: R222.1
AUD_SDOUT: R223.2
GND: C220.2, C221.2, C222.2, C223.2, C224.2, C225.2, C226.2, C227.2, C228.2, C229.2, C231.2, C232.2, R220.2, U23.4 (AVSS), U23.15 (ADDR1_MISO), U23.16 (ADDR0_SCLK), U23.25 (VSS_EP)
I2C_SCL: U23.17 (SCL_MOSI)
I2C_SDA: U23.18 (SDA_SSZ)
MICBIAS_3V014: C228.1, C229.1, U23.5 (MICBIAS)
PDM_CLK_ADC_OUT: U23.11 (IN3M_GPO3)
PDM_DIN_PAIR: U23.10 (IN3P_GPI3)

Notes on the sheet:
MATCHING GLOBAL LABELS ARE ELECTRICALLY CONNECTED / PHYSICAL PIN NUMBERS SHOWN
