NathanHor22/Quipus/output/pcb/Quipus-B1/schematics/09_external_microphone_a_1.kicad_sch

## KiCad design output/pcb/Quipus-B1/schematics/09_external_microphone_a_1.kicad_sch (2026-10-06)

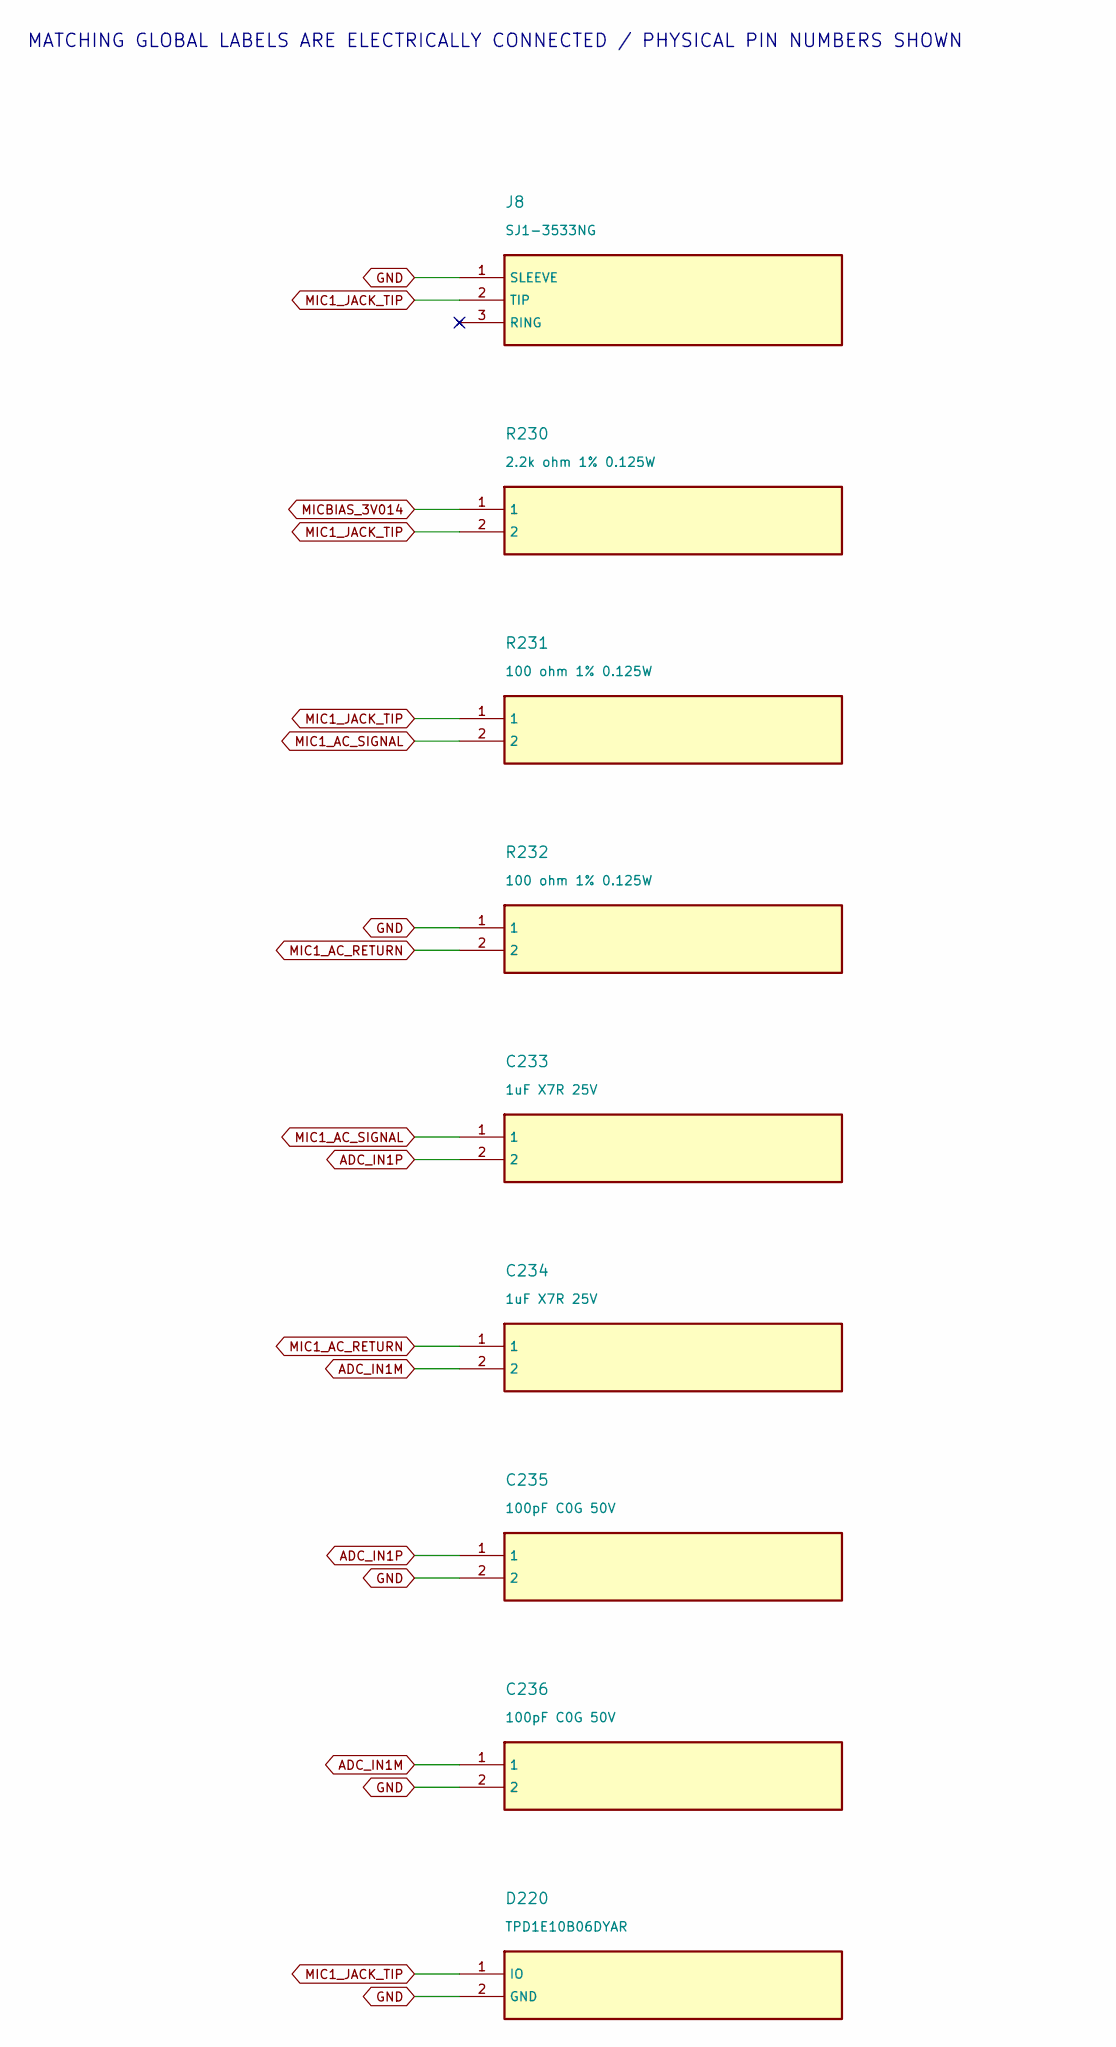
[picture p187: schematic 09_external_microphone_a_1.kicad_sch]

Parts:
C233, C234: 1uF X7R 25V
C235, C236: 100pF C0G 50V
D220: TPD1E10B06DYAR
J8: SJ1-3533NG
R230: 2.2k ohm 1% 0.125W
R231, R232: 100 ohm 1% 0.125W

Connections:
ADC_IN1M: C234.2, C236.1
ADC_IN1P: C233.2, C235.1
GND: C235.2, C236.2, D220.2 (GND), J8.1 (SLEEVE), R232.1
MIC1_AC_RETURN: C234.1, R232.2
MIC1_AC_SIGNAL: C233.1, R231.2
MIC1_JACK_TIP: D220.1 (IO), J8.2 (TIP), R230.2, R231.1
MICBIAS_3V014: R230.1

Notes on the sheet:
MATCHING GLOBAL LABELS ARE ELECTRICALLY CONNECTED / PHYSICAL PIN NUMBERS SHOWN
