NathanHor22/Quipus/output/pcb/Quipus-B1/schematics/10_external_microphone_b_1.kicad_sch

## KiCad design output/pcb/Quipus-B1/schematics/10_external_microphone_b_1.kicad_sch (2026-10-06)

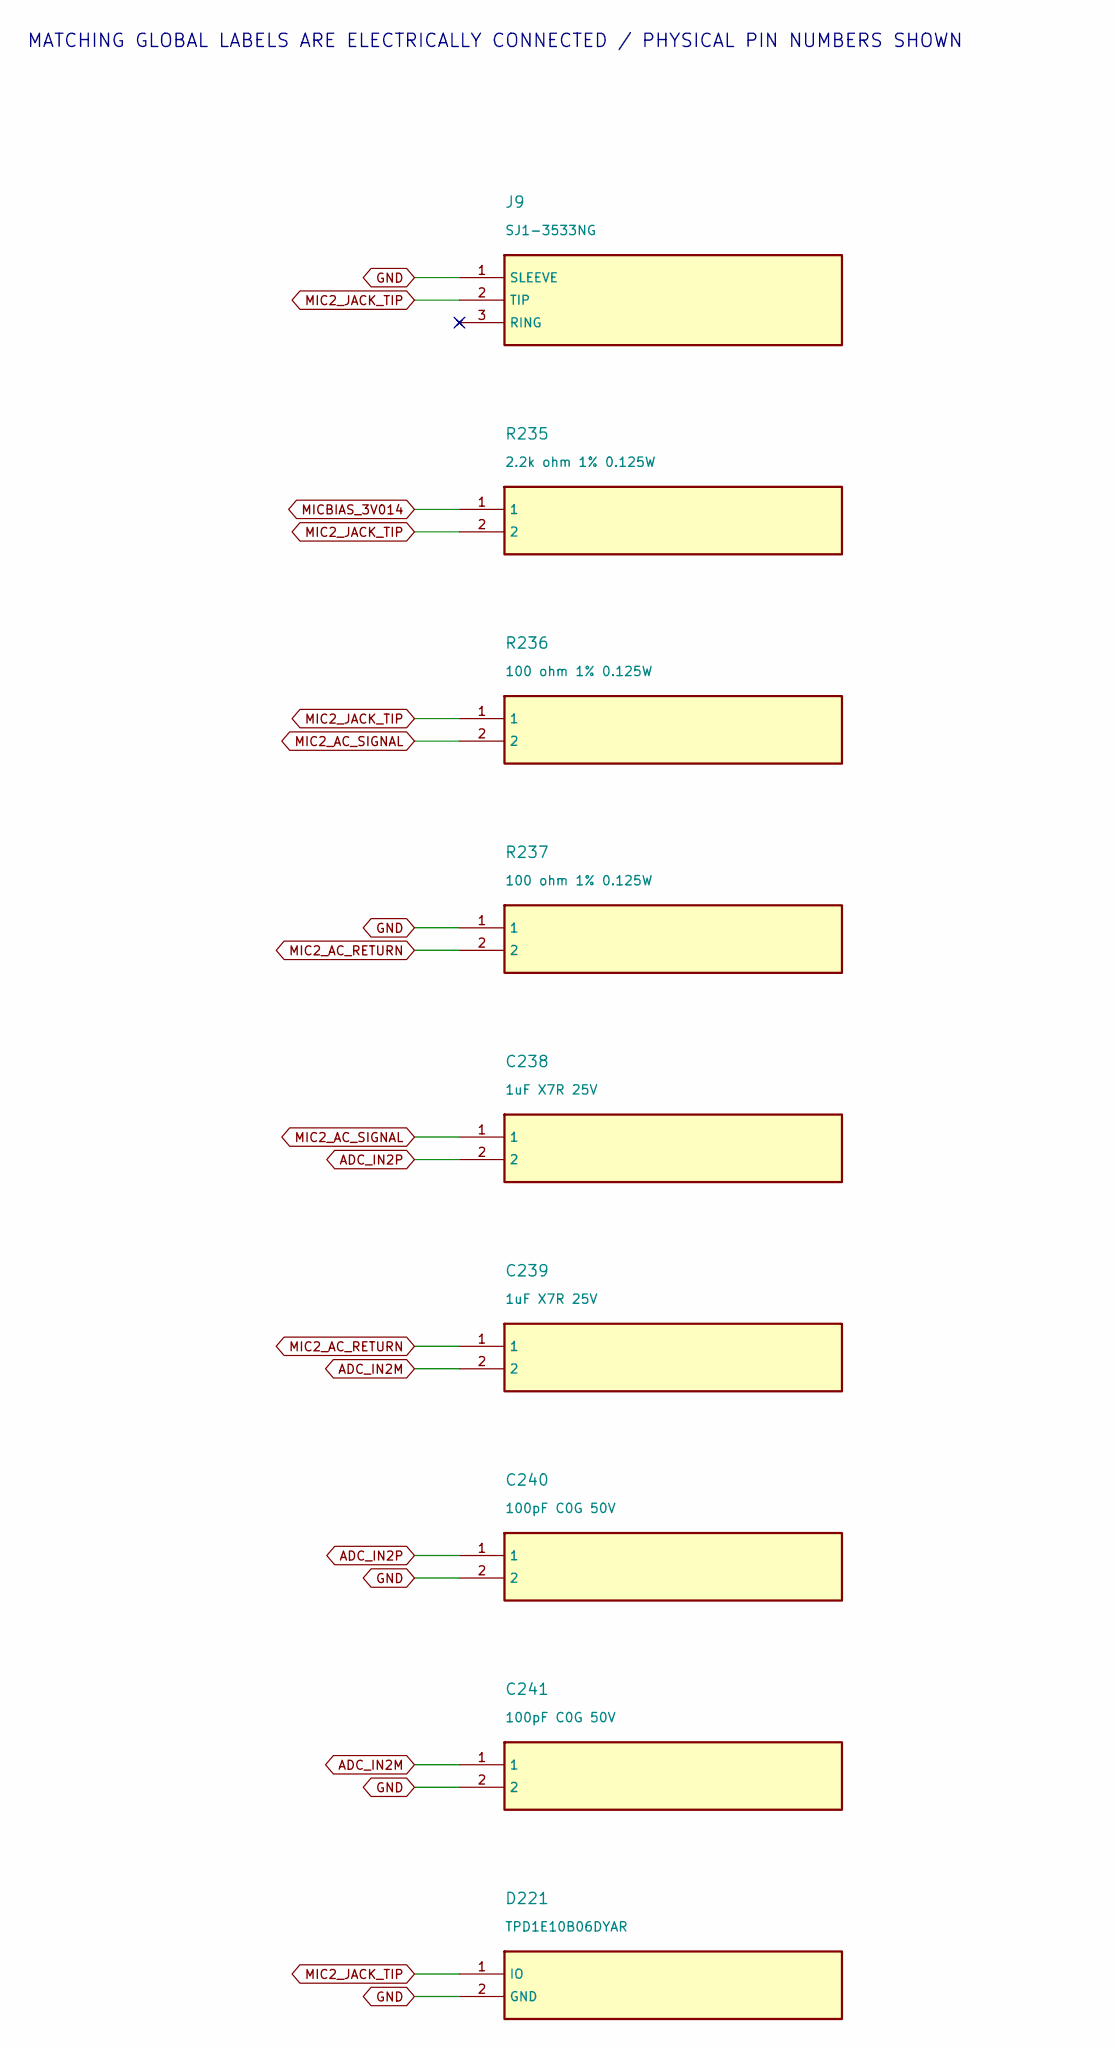
[picture p188: schematic 10_external_microphone_b_1.kicad_sch]

Parts:
C238, C239: 1uF X7R 25V
C240, C241: 100pF C0G 50V
D221: TPD1E10B06DYAR
J9: SJ1-3533NG
R235: 2.2k ohm 1% 0.125W
R236, R237: 100 ohm 1% 0.125W

Connections:
ADC_IN2M: C239.2, C241.1
ADC_IN2P: C238.2, C240.1
GND: C240.2, C241.2, D221.2 (GND), J9.1 (SLEEVE), R237.1
MIC2_AC_RETURN: C239.1, R237.2
MIC2_AC_SIGNAL: C238.1, R236.2
MIC2_JACK_TIP: D221.1 (IO), J9.2 (TIP), R235.2, R236.1
MICBIAS_3V014: R235.1

Notes on the sheet:
MATCHING GLOBAL LABELS ARE ELECTRICALLY CONNECTED / PHYSICAL PIN NUMBERS SHOWN
