NathanHor22/Quipus/(commit log)

2026-09-26 Fix Quipus charging state redraw
    [app_main.c, lantern_display.c, lantern_display.h]
2026-10-06 rewamped the website designed with the mirror's edge and the detroit become humans vibe and design
    [01_01_usb_charge_1.kicad_sch, 01_01_usb_charge_1.sch, 01_01_usb_charge_2.kicad_sch, 01_01_usb_charge_2.sch, 02_02_power_control_1.kicad_sch, 02_02_power_control_1.sch, 03_03_regulator_1.kicad_sch, 03_03_regulator_1.sch]
2026-10-14 revamped the whole website with a proper landing page and refined the dashboard alongside the demo sample page as well
2026-10-15 rewamped the 3D model buildings and refine the website landing page
2026-10-15 refine the landing page
2026-10-24 chore: stop tracking disposable review artifacts and rebuildable bundles
    - Untrack output/ui-review (UI review screenshots and reports) and a
    leftover Chromium automation profile; files remain on disk and ignored.
    - Move Wi-Fi setup evidence screenshots to docs/images/wifi-setup and
    update the setup doc reference.
    - Untrack PCB bundle zips and case v0.3 zips that packaging scripts rebuild
    from adjacent sources. Case v0.1/v0.2 archives stay tracked because they
    are the only record of those versions.
2026-10-24 fix(security): restrict WhatsApp send action to the relay owner
    /api/actions/whatsapp/send only required a signed-in session, while every
    other WhatsApp route requires WHATSAPP_OWNER_USER_ID. With multi-user
    workspaces any account could send through the owner's linked WhatsApp.
    Use requireWhatsAppOwner(), which runs before any workspace lookup.
    Adds tests/helpers/route-harness.ts (shared esbuild route loader with @/
    mocks that also cover relative imports) and a regression test that fails
    without the fix.
2026-10-24 chore: normalize line endings and mark binary assets in .gitattributes
    The previous rule covered only CSS. With core.autocrlf=true on Windows,
    git treated some PDFs, STEP files and the WAV test fixture as text and
    inserted CR bytes into working copies at checkout (repository contents
    are unaffected). Store/check out text as LF everywhere, keep CRLF for
    .bat/.cmd, and mark binary assets so they are never converted.
2026-10-24 test: share the route-bundling harness across route tests
    device-consent-route and offline-import-route each copied the same
    esbuild loader that tests/helpers/route-harness.ts now provides. Migrate
    both; per-file pass counts are unchanged (10 and 3). Relative-import
    mocking is opt-in so migrated tests keep their original module graph.
    The other route tests use different resolution rules (CSS fixtures,
    regex and relative mocks) and are left as they are.
2026-10-24 feat: label WhatsApp delivery as coming soon behind a release flag
    WhatsApp delivery is not ready for pilot users. Add
    NEXT_PUBLIC_WHATSAPP_ENABLED (off by default):
    - Settings shows the WhatsApp card with a "Coming soon" label and makes
    no API calls; the per-meeting share button is disabled and labelled.
    - Browser-facing WhatsApp routes (status, qr, pair, disconnect, send,
    delivery) refuse with "WhatsApp delivery is coming soon." while off.
    - Setting the flag to "true" and redeploying restores current behaviour.
    Tests cover the refused state and run the owner-gating tests with the
    flag on.
2026-10-25 feat(auth): accept Supabase bearer tokens from the mobile app on existing API routes
    Native clients send Authorization: Bearer <access token>. The proxy and the
    shared session helper verify it with Supabase Auth, never fall back to cookies
    when the header is present, and give RLS-scoped clients that token. Device and
    internal machine routes are unchanged. Adds GET /api/profile for the greeting.
2026-10-25 feat(google): connect Google Calendar and Gmail from the mobile app
    The website callback depends on the browser session cookie, which the app's
    system browser does not have. A dedicated mobile flow binds the result to the
    signed-in app with a verifier: a two-minute encrypted ticket starts OAuth, a
    separate mobile callback seals the credentials for quipus://, and only the
    same user presenting the verifier can save them. The website callback and its
    proxy protection are unchanged.
2026-10-25 feat: wireless firmware updates for Waveshare recorders
    Recorders on 0.13.0+ install signed firmware over Wi-Fi when idle and
    powered, keep it only after reaching Quipus, and roll back otherwise.
    - firmware: lantern_ota (download, size/SHA-256/prefix checks, signature
    verified by esp_ota_end, trial boot confirmed by an acknowledged
    heartbeat, rollback reporting), quipus_ota_policy with host tests,
    rollback bootloader and RSA-signed apps without eFuses, fault screen
    keeps checking in, version 0.13.0
    - scripts: sign-firmware.ps1 (key outside the repo), flash-waveshare.ps1
    writes the signed image and can require a MAC, versioned/bench builds,
    publish-firmware.mjs
    - backend: migrati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
2026-10-25 fix(firmware): offline consent in real rooms, battery level, playback stutter
    - Local consent: calibrate the background from the quiet after a prompt
    answer when there is no prefix, and treat only sustained (>=60 ms) or
    strong above-floor activity as possible hidden speech. Live logs showed
    five YES answers scoring 237-255 rejected for these two reasons. All
    NO vetoes, model thresholds and attribution checks are unchanged.
    - Battery: Waveshare recorders ship with a cell, so read it by default; a
    reading below 2.5 V means no cell and the bar shows USB.
    - Playback: prefill 400 ms (was 125 ms), rebuffer 125 ms after running dry,
    and log how often it starved.
    - Version 0.13.2.
2026-10-25 fix(firmware): attach unvoiced word endings to the spoken word
    A live offline "yes" (YES 255, no NO) was refused because VAD went silent through its /s/, splitting the word. Up to 200 ms of contiguous above-floor blocks after a VAD offset now belong to that word; post-answer calibration starts beyond them. Version 0.13.3.
2026-10-25 fix(firmware): weak NO from a silent tail no longer vetoes consent
    Board 2 live log: YES 255 over nine windows was refused by one context
    scoring NO 135 with only 40 ms of the explained word in it, plus 60-80 ms
    room-noise runs at 1.8x floor.
    - A possible (untrusted) NO vetoes only with >=100 ms voiced support;
    a trusted NO still wins with any voiced support.
    - Above-floor activity counts as possible hidden speech from 100 ms
    (was 60 ms); strong blips and DC drift still count at once.
    - Log the longest above-floor run.
    - Version 0.13.4.
2026-10-25 fix(firmware): check the SD card before asking for consent
    Board 2 had no card: YES was accepted, the session then failed, and
    "Computer" offline in that error state said "connect to Wi-Fi". Check
    (and mount a newly inserted) secured card before the consent question
    and say "Please check the SD card" instead; offline recovery for an SD
    fault names the card. No session or key request happens before YES.
    Version 0.13.5.
2026-10-25 feat(firmware): smooth 24 to 16 kHz playback resampling
    Prompts are 24 kHz and the Waveshare speaker runs at 16 kHz; playback dropped every third sample, spacing samples unevenly and folding 8-12 kHz into the audible band. A stateful [1 2 1]/4 low-pass plus linear interpolation at 1.5-sample steps keeps speech level (-0.2 dB at 1 kHz), cuts the folded band by 26 dB, and has no chunk seams. Version 0.13.7.
2026-10-25 feat(firmware): detect microSD removal and insertion while idle
    The Waveshare slot has no detect pin, so a swapped card was only seen after a restart. Every 2 s while idle (never with a recording or phone archive open) the recorder checks the mounted card's status, unmounting a removed card, or mounts a newly inserted one with the boot-time checks (never formatting). Empty-slot probes are silent. An unpaired recorder no longer blames the SD card before consent. Version 0.13.8.
2026-10-25 fix(firmware): start fresh when settings storage holds another firmware's data
    Factory demo firmware can leave NVS full or in another format, so Quipus crash-looped on ESP_ERR_NVS_NO_FREE_PAGES (board 4). On NO_FREE_PAGES or NEW_VERSION_FOUND the raw partition is scanned: with no Quipus namespace (roxanne, quipus_keys, quipus_ota) it is erased and re-initialized; with any, it is kept, since it may hold the only SD archive key, and a service screen replaces the restart loop. Version 0.13.9.
2026-10-25 feat(firmware): unique setup network name and password per device
    Reworked from #15 onto current main (0.14.0).
    Every recorder now advertises QUIPUS-XXXXXX (the three per-chip MAC bytes)
    instead of Quipus-XXXX, and protects it with its own 10-character password
    instead of the published `lanternsetup`. The password is created once from
    the hardware RNG (SAR ADC entropy enabled before Wi-Fi and the battery ADC),
    stored in a new `quipus_device` namespace that pairing, settings resets and
    transfers never erase, and shown on the setup screen. If it cannot be
    stored, setup falls back to `lanternsetup` and the screen shows that.
    Since #15: `quipus_device` counts as Quipus data, so foreign-setting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
2026-10-26 Refine mobile workspace, meeting titles and device settings
2026-10-27 refine revoke device flow
